kelu124/rp569/datasheet/README.md

# datasheet/

Each datasheet is kept as the original PDF plus a Markdown conversion (`markitdown <f>.pdf -o <f>.md`).
The Markdown is for grep/LLM reading. Tables can be garbled, so always confirm pin numbers in the PDF.

| File | Document | Source |
|---|---|---|
| `rp2350-datasheet` | RP2350 datasheet (RP-008373-DS-3) | datasheets.raspberrypi.com |
| `hardware-design-with-rp2350` | Hardware design with RP2350 (RP-008280-DS-2) | datasheets.raspberrypi.com |
| `CH569DS1` | CH569/CH565 datasheet V1.2 (pinout, HSPI, eMMC, USB3, registers) | copied from `project/phantomdrive/ref/` |
| `GSB343K33HR/` | Amphenol USB3 Micro-B receptacle (THT shell legs): drawing rev C, product spec PS-7428, STEP/IGES models (zipped) |
| `QingKeV3_Processor_Manual` | WCH QingKe V3 RISC-V core manual (CH569 core, debug) | copied from `project/phantomdrive/ref/` |
| `SD_Physical_Layer_Spec_v6.00` | SD Physical Layer Simplified Spec v6.00 | copied from `project/phantomdrive/ref/` |
