kelu124/rp569/firmware/rp2350/README.md

# RP2350B firmware

USB serial command line (also mirrored on the debug UART0, RP EXT header pins 2 TX / 3 RX, 115200 8N1).

```
rp569> version
rp569 RP2350B firmware 0.1.0 git 0727cb0 built Oct 24 2026 uid E6614103E7A1B22C
rp569> help
commands:
  help                     this list
  version                  firmware version, git hash and chip unique ID
  set <R|G|B> <0|1>        RGB LED colour on/off (also 'set rgb 101')
  led                      LED state
  btn                      user buttons
  adc                      VBUS3 and 3V3_CH voltages
  dfu                      reboot the RP2350 into its USB bootloader (BOOTSEL / UF2)
  reboot                   reboot the RP2350
  ch on                    CH569 power on (normal boot)
  ch off                   CH569 power off
  ch cycle                 CH569 power off, then normal boot
  ch boot                  power-cycle the CH569 into its USB bootloader (~10 s)
  ch reset                 pulse RST# (only with RESET_EN set in the CH569)
  ch status                CH569 power, fault flag, rails
  ch send <text>           send a line to the CH569 over the link UART (it echoes it back)
```

The commands are one table in `src/main.c` (`COMMANDS-BEGIN` / `COMMANDS-END`); `help` is generated from it. Every
entry needs a method in `python/rp569/rp2350.py` (pre-commit check, `tools/check_commands.py`).

**USB identity**: `2e8a:0009`, manufacturer "rp569", product "rp569 RP2350B", serial number = the chip unique ID
(the `uid` of `version`). The python library finds the port with these.

**Version**: `version.yaml` (major/minor by the user, patch bumped by the pre-commit hook), read by CMake into
`build/generated/fw_version.h` with the `git describe` hash.

Lines from the CH569 (link UART1, GPIO24 TX / GPIO25 RX, 115200) are printed as `CH> ...`.

## Build

```sh
./build.sh            # PICO_SDK_PATH defaults to ~/.pico-sdk/sdk/2.2.0 -> build/rp569_rp2350.uf2
```

Needs Pico SDK ≥ 2.0 (RP2350), `arm-none-eabi-gcc`, cmake, ninja. The board definition is
[`boards/rp569.h`](boards/rp569.h): RP2350B (`PICO_RP2350A 0`), 16 MB flash, UART0 on GPIO32/33, every rp569 pin
as `RP569_*`.

## CH569 control (specification.md D-004)

- The CH569 is **off** until GPIO29 (AP2171W EN, 100k pull-down) goes high; the firmware turns it on at start-up
  (`CH_POWER_ON_BOOT`).
- While it is off, the link UART pins and HSPI_D0 are inputs without pull-up (no back-powering).
- `ch boot`: GPIO8 (HSPI_D0 → CH569 PA5) driven low, power off, power on, released 200 ms later.
- Normal power-up: GPIO8 only gets the weak pull-up, so the CH BOOT jumper/button still force the bootloader.
- `ch reset` pulses GPIO28 (open-drain RST#); it only works once RESET_EN is set in the CH569 config bits.
- GPIO30 (FLG#) is polled: a power-switch fault is reported once.
