kelu124/rp569/docs/images/README.md

# Board images (v1.0)

Generated by `python3 hardware/gen/gen_renders.py` from `hardware/rp569-routed.kicad_pcb` (re-run after board changes).

| Top | Bottom |
|---|---|
| top | bottom |
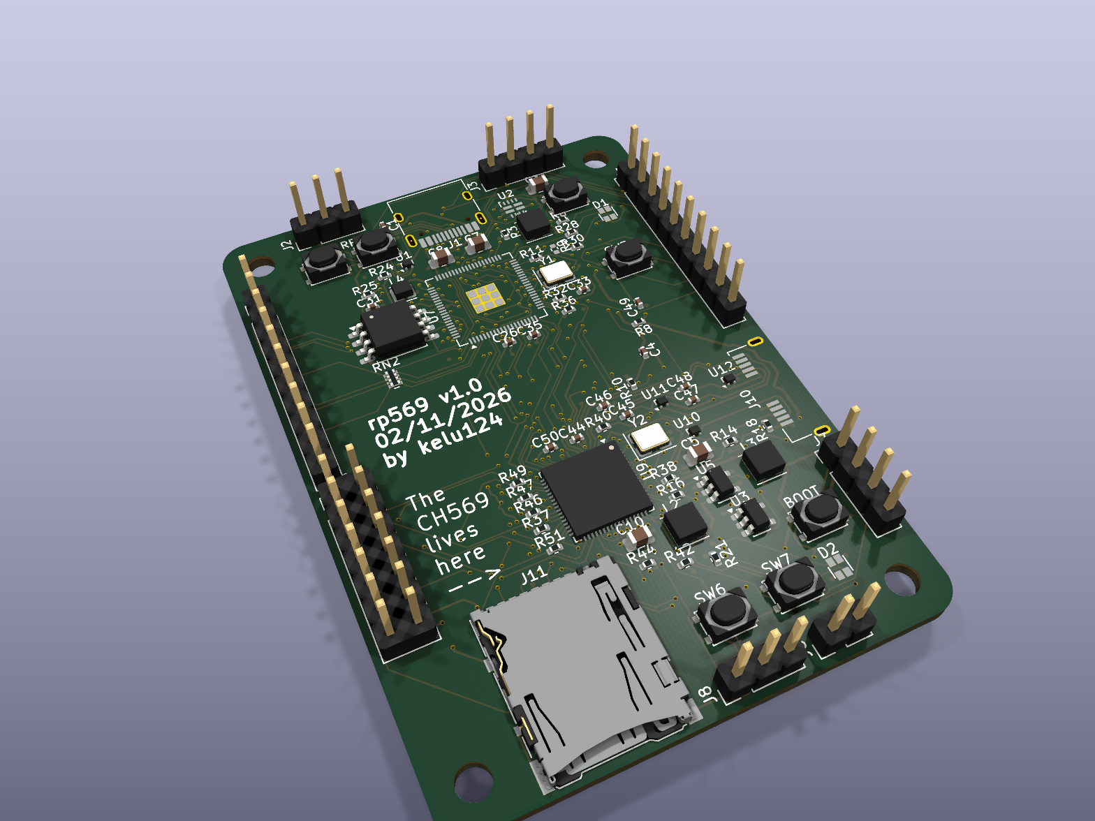
[picture p3: docs/images/rp569-v1.0-top-angled.png]
top angled
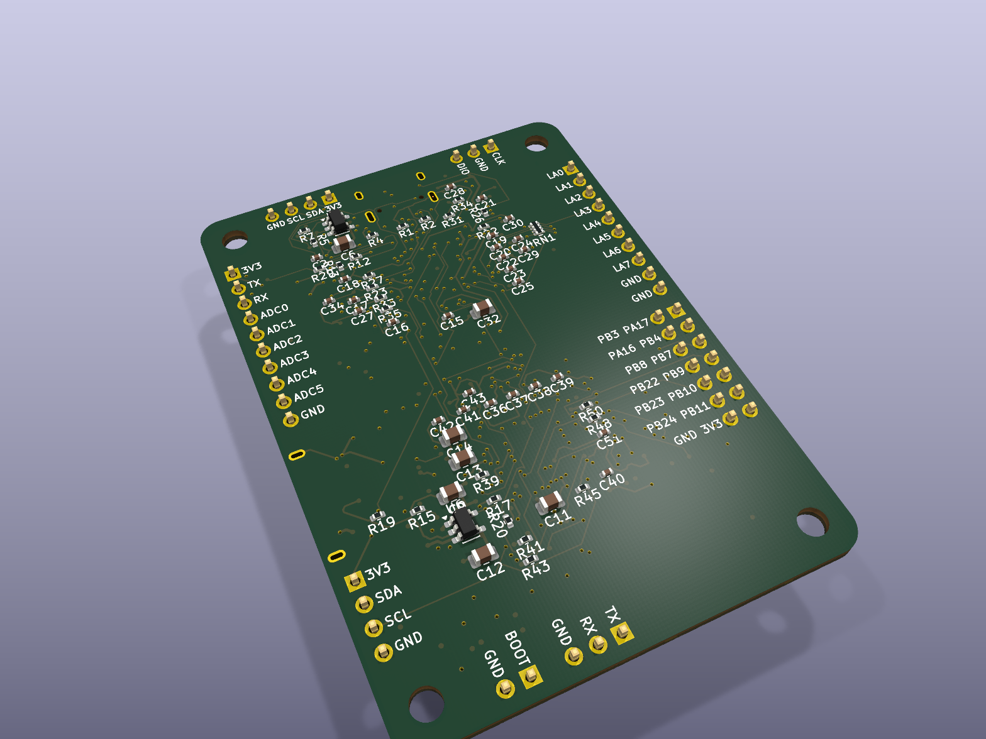
[picture p4: docs/images/rp569-v1.0-bottom-angled.png]
bottom angled
|  |  |

Layer plots (board area, bottom layers mirrored as seen from below), SVG + PNG:

| F.Cu | In1.Cu (GND plane) | In2.Cu | B.Cu |
|---|---|---|---|
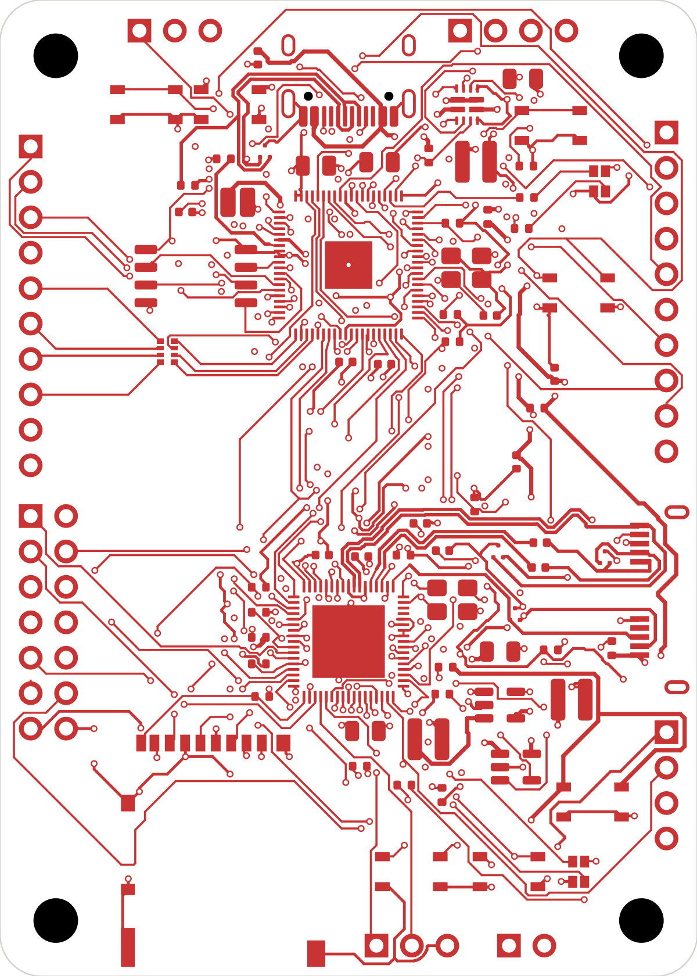
[picture p5: docs/images/rp569-v1.0-F_Cu.png]
F.Cu
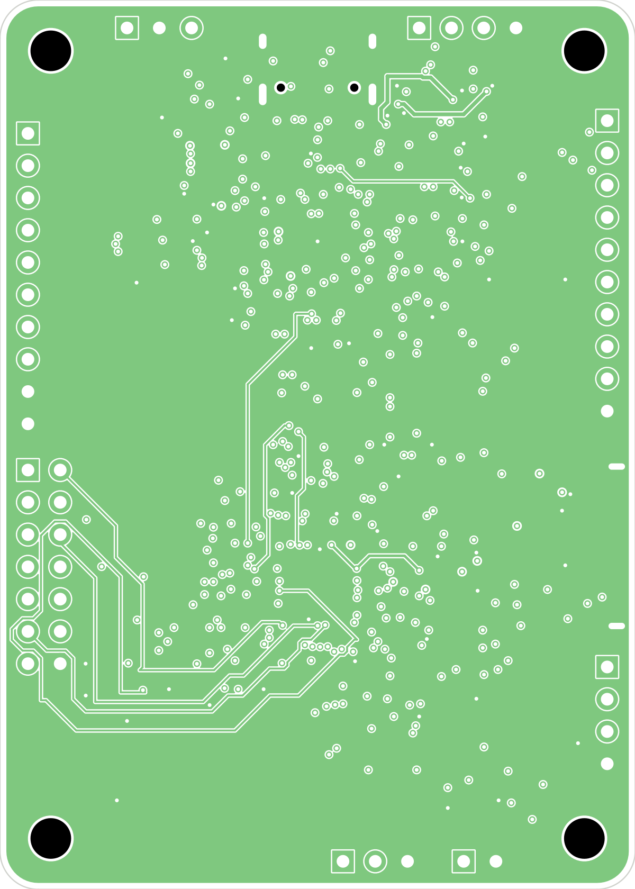
[picture p6: docs/images/rp569-v1.0-In1_Cu.png]
In1
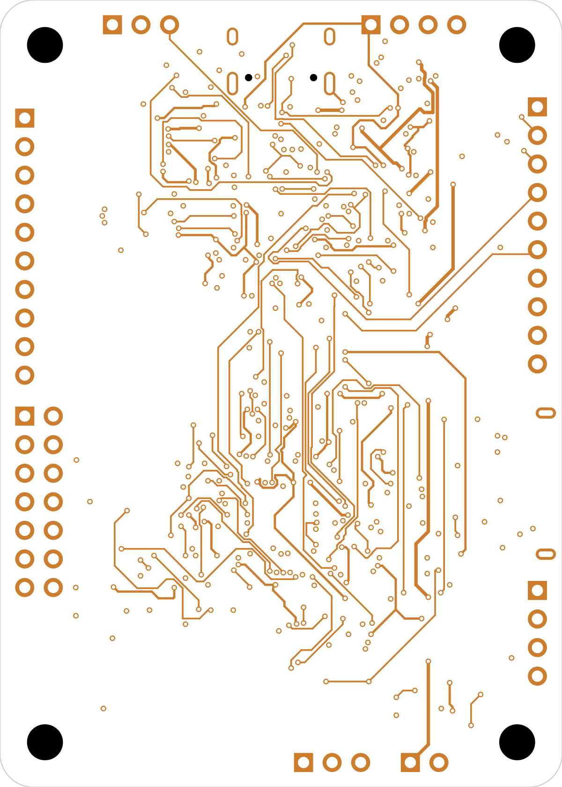
[picture p7: docs/images/rp569-v1.0-In2_Cu.png]
In2
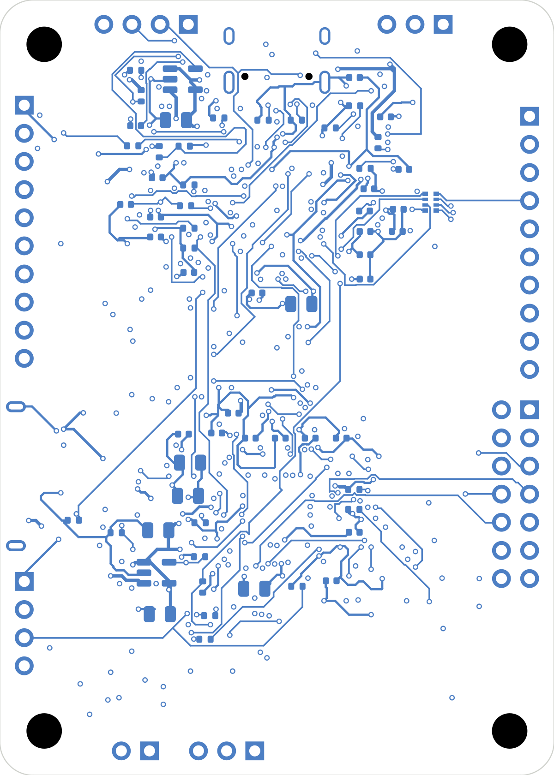
[picture p8: docs/images/rp569-v1.0-B_Cu.png]
B.Cu
|  |  |  |  |

Assembly views (silkscreen + fab): [top](rp569-v1.0-assembly-top.png), [bottom](rp569-v1.0-assembly-bottom.png).
