kelu124/rp569/datasheet/hardware-design-with-rp2350.md

Raspberry Pi

|  Hardware design with RP2350

Datasheet

Hardware design with
RP2350
Using RP2350 microcontrollers to
build boards and products

Raspberry Pi Ltd

Hardware design with RP2350

Colophon

©︎ 2022-2026 Raspberry Pi Ltd

This documentation is licensed under a Creative Commons Attribution-NoDerivatives 4.0 International (CC BY-ND).

Release

3

Build date

20/08/2026

Build version

06a7f75e58a1

Legal disclaimer notice

TECHNICAL AND RELIABILITY DATA FOR RASPBERRY PI PRODUCTS (INCLUDING DATASHEETS) AS MODIFIED FROM TIME TO

TIME (“RESOURCES”) ARE PROVIDED BY RASPBERRY PI LTD (“RPL”) “AS IS” AND ANY EXPRESS OR IMPLIED WARRANTIES,

INCLUDING,  BUT  NOT  LIMITED TO, THE  IMPLIED  WARRANTIES  OF  MERCHANTABILITY  AND  FITNESS  FOR  A  PARTICULAR

PURPOSE ARE DISCLAIMED. TO THE MAXIMUM EXTENT PERMITTED BY APPLICABLE LAW IN NO EVENT SHALL RPL BE LIABLE

FOR ANY DIRECT, INDIRECT, INCIDENTAL, SPECIAL, EXEMPLARY, OR CONSEQUENTIAL DAMAGES (INCLUDING, BUT NOT LIMITED

TO, PROCUREMENT OF SUBSTITUTE GOODS OR SERVICES; LOSS OF USE, DATA, OR PROFITS; OR BUSINESS INTERRUPTION)

HOWEVER CAUSED AND ON ANY THEORY OF LIABILITY, WHETHER IN CONTRACT, STRICT LIABILITY, OR TORT (INCLUDING

NEGLIGENCE OR OTHERWISE) ARISING IN ANY WAY OUT OF THE USE OF THE RESOURCES, EVEN IF ADVISED OF THE POSSIBILITY

OF SUCH DAMAGE.

RPL reserves the right to make any enhancements, improvements, corrections or any other modifications to the RESOURCES or

any products described in them at any time and without further notice.

The RESOURCES are intended for skilled users with suitable levels of design knowledge. Users are solely responsible for their

selection and use of the RESOURCES and any application of the products described in them. User agrees to indemnify and hold

RPL harmless against all liabilities, costs, damages or other losses arising out of their use of the RESOURCES.

RPL grants users permission to use the RESOURCES solely in conjunction with the Raspberry Pi products. All other use of the

RESOURCES is prohibited. No licence is granted to any other RPL or other third party intellectual property right.

HIGH RISK ACTIVITIES. Raspberry Pi products are not designed, manufactured or intended for use in hazardous environments

requiring fail safe performance, such as in the operation of nuclear facilities, aircraft navigation or communication systems, air

traffic control, weapons systems or safety-critical applications (including life support systems and other medical devices), in which

the failure of the products could lead directly to death, personal injury or severe physical or environmental damage (“High Risk

Activities”). RPL specifically disclaims any express or implied warranty of fitness for High Risk Activities and accepts no liability

for use or inclusions of Raspberry Pi products in High Risk Activities.

Raspberry Pi products are provided subject to RPL’s Standard Terms. RPL’s provision of the RESOURCES does not expand or

otherwise modify RPL’s Standard Terms including but not limited to the disclaimers and warranties expressed in them.

Colophon

1

Hardware design with RP2350

Table of Contents

1. Introduction . . . . . . . . . . . . . . . . . . . . . . . . . . . . . . . . . . . . . . . . . . . . . . . . . . . . . . . . . . . . . . . . . . . . . . . . . . . . . . . . . . . . . . . . . . . . . . . . . . . . . . . . . . . . . . . . . . . . . . 3

1.1. The Minimal Board . . . . . . . . . . . . . . . . . . . . . . . . . . . . . . . . . . . . . . . . . . . . . . . . . . . . . . . . . . . . . . . . . . . . . . . . . . . . . . . . . . . . . . . . . . . . . . . . . . . . . . . . 3

1.2. RP2040 vs RP235x series . . . . . . . . . . . . . . . . . . . . . . . . . . . . . . . . . . . . . . . . . . . . . . . . . . . . . . . . . . . . . . . . . . . . . . . . . . . . . . . . . . . . . . . . . . . . . . . . . 3

1.3. The Design . . . . . . . . . . . . . . . . . . . . . . . . . . . . . . . . . . . . . . . . . . . . . . . . . . . . . . . . . . . . . . . . . . . . . . . . . . . . . . . . . . . . . . . . . . . . . . . . . . . . . . . . . . . . . . . . 4

2. Power . . . . . . . . . . . . . . . . . . . . . . . . . . . . . . . . . . . . . . . . . . . . . . . . . . . . . . . . . . . . . . . . . . . . . . . . . . . . . . . . . . . . . . . . . . . . . . . . . . . . . . . . . . . . . . . . . . . . . . . . . . . . 5

2.1. New on-chip voltage regulator . . . . . . . . . . . . . . . . . . . . . . . . . . . . . . . . . . . . . . . . . . . . . . . . . . . . . . . . . . . . . . . . . . . . . . . . . . . . . . . . . . . . . . . . . . . . 5

2.2. Input supply . . . . . . . . . . . . . . . . . . . . . . . . . . . . . . . . . . . . . . . . . . . . . . . . . . . . . . . . . . . . . . . . . . . . . . . . . . . . . . . . . . . . . . . . . . . . . . . . . . . . . . . . . . . . . . . 7

2.2.1. Decoupling capacitors . . . . . . . . . . . . . . . . . . . . . . . . . . . . . . . . . . . . . . . . . . . . . . . . . . . . . . . . . . . . . . . . . . . . . . . . . . . . . . . . . . . . . . . . . . . . . 8

3. Flash Memory . . . . . . . . . . . . . . . . . . . . . . . . . . . . . . . . . . . . . . . . . . . . . . . . . . . . . . . . . . . . . . . . . . . . . . . . . . . . . . . . . . . . . . . . . . . . . . . . . . . . . . . . . . . . . . . . . . 10

3.1. Primary flash . . . . . . . . . . . . . . . . . . . . . . . . . . . . . . . . . . . . . . . . . . . . . . . . . . . . . . . . . . . . . . . . . . . . . . . . . . . . . . . . . . . . . . . . . . . . . . . . . . . . . . . . . . . . . 10

3.2. Secondary flash or PSRAM . . . . . . . . . . . . . . . . . . . . . . . . . . . . . . . . . . . . . . . . . . . . . . . . . . . . . . . . . . . . . . . . . . . . . . . . . . . . . . . . . . . . . . . . . . . . . . 11

3.3. Supported flash chips . . . . . . . . . . . . . . . . . . . . . . . . . . . . . . . . . . . . . . . . . . . . . . . . . . . . . . . . . . . . . . . . . . . . . . . . . . . . . . . . . . . . . . . . . . . . . . . . . . . . 11

4. Crystal Oscillator . . . . . . . . . . . . . . . . . . . . . . . . . . . . . . . . . . . . . . . . . . . . . . . . . . . . . . . . . . . . . . . . . . . . . . . . . . . . . . . . . . . . . . . . . . . . . . . . . . . . . . . . . . . . . . . 13

4.1. Recommended crystal . . . . . . . . . . . . . . . . . . . . . . . . . . . . . . . . . . . . . . . . . . . . . . . . . . . . . . . . . . . . . . . . . . . . . . . . . . . . . . . . . . . . . . . . . . . . . . . . . . . 14

5. IOs . . . . . . . . . . . . . . . . . . . . . . . . . . . . . . . . . . . . . . . . . . . . . . . . . . . . . . . . . . . . . . . . . . . . . . . . . . . . . . . . . . . . . . . . . . . . . . . . . . . . . . . . . . . . . . . . . . . . . . . . . . . . . . 15

5.1. USB . . . . . . . . . . . . . . . . . . . . . . . . . . . . . . . . . . . . . . . . . . . . . . . . . . . . . . . . . . . . . . . . . . . . . . . . . . . . . . . . . . . . . . . . . . . . . . . . . . . . . . . . . . . . . . . . . . . . . . 15

5.2. I/O headers . . . . . . . . . . . . . . . . . . . . . . . . . . . . . . . . . . . . . . . . . . . . . . . . . . . . . . . . . . . . . . . . . . . . . . . . . . . . . . . . . . . . . . . . . . . . . . . . . . . . . . . . . . . . . . 16

5.3. Debug connector . . . . . . . . . . . . . . . . . . . . . . . . . . . . . . . . . . . . . . . . . . . . . . . . . . . . . . . . . . . . . . . . . . . . . . . . . . . . . . . . . . . . . . . . . . . . . . . . . . . . . . . . . 17

5.4. Buttons . . . . . . . . . . . . . . . . . . . . . . . . . . . . . . . . . . . . . . . . . . . . . . . . . . . . . . . . . . . . . . . . . . . . . . . . . . . . . . . . . . . . . . . . . . . . . . . . . . . . . . . . . . . . . . . . . . . 18

Appendix A. Complete Schematic - RP2350A version . . . . . . . . . . . . . . . . . . . . . . . . . . . . . . . . . . . . . . . . . . . . . . . . . . . . . . . . . . . . . . . . . . . . . . . . . . . . 19

Appendix B. Complete Schematic - RP2350B version . . . . . . . . . . . . . . . . . . . . . . . . . . . . . . . . . . . . . . . . . . . . . . . . . . . . . . . . . . . . . . . . . . . . . . . . . . . . 21

Appendix C. Documentation Release History . . . . . . . . . . . . . . . . . . . . . . . . . . . . . . . . . . . . . . . . . . . . . . . . . . . . . . . . . . . . . . . . . . . . . . . . . . . . . . . . . . . . . 23

C.1. 24 August 2026 . . . . . . . . . . . . . . . . . . . . . . . . . . . . . . . . . . . . . . . . . . . . . . . . . . . . . . . . . . . . . . . . . . . . . . . . . . . . . . . . . . . . . . . . . . . . . . . . . . . . . . . . . . 23

C.2. 15 October 2024 . . . . . . . . . . . . . . . . . . . . . . . . . . . . . . . . . . . . . . . . . . . . . . . . . . . . . . . . . . . . . . . . . . . . . . . . . . . . . . . . . . . . . . . . . . . . . . . . . . . . . . . . . 23

C.3. 6 September 2024 . . . . . . . . . . . . . . . . . . . . . . . . . . . . . . . . . . . . . . . . . . . . . . . . . . . . . . . . . . . . . . . . . . . . . . . . . . . . . . . . . . . . . . . . . . . . . . . . . . . . . . . 23

C.4. 8 August 2024 . . . . . . . . . . . . . . . . . . . . . . . . . . . . . . . . . . . . . . . . . . . . . . . . . . . . . . . . . . . . . . . . . . . . . . . . . . . . . . . . . . . . . . . . . . . . . . . . . . . . . . . . . . . 23

Table of Contents

2

Hardware design with RP2350

1. Introduction

Figure 1.

KiCad 3D rendering of the RP2350A Minimal design example

When we first introduced the Raspberry Pi RP2040, we also released a ‘Minimal’ design example and accompanying guide Hardware

design with RP2040 which hopefully explained how the RP2040 could be used in a simple circuit board, and why the various

component choices were made. With the arrival of the RP235x series, it’s time to revisit the original RP2040 Minimal design, and

update it to account for the new features, and also for each of the package variants; the RP2350A with its QFN-60 package, and

the RP2350B which is a QFN-80. Again, these designs are in Kicad format, and are available to download ( RP2350A Minimal

KiCAD design (ZIP file) and RP2350B Minimal KiCAD design (ZIP file) ).

1.1. The Minimal Board

The original Minimal board was an attempt to provide a simple reference design, using the bare minimum of external components

required to run the RP2040 and still have all the IO exposed and accessible. This was essentially comprised of a power source (a

5 V to 3.3 V linear regulator), crystal oscillator, flash memory, and IO connections (a micro USB socket and GPIO headers).

The new RP235x series Minimal boards are largely the same, but with some changes necessary due to the new hardware. In

addition to this, and despite going somewhat against the minimal nature of the design, we added a couple of buttons for BOOTSEL

and run, together with a separate SWD header, which should mean a thoroughly less frustrating debug experience this time around.

Designs don’t strictly speaking need these buttons, the signals are still available on the headers, and they can be omitted if you

are particularly cost or space conscious.

1.2. RP2040 vs RP235x series

The most obvious change is in the packages.

Whereas the RP2040 is a 7x7 mm QFN-56, the RP235x series currently has four different members. There are two devices which

share the same QFN-60 package; the RP2350A which does not contain internal flash storage, and the RP2354A which does.

Similarly, the QFN-80 also comes in two flavours; the RP2354B with flash, and RP2350B without.

The QFN-60 devices and the original RP2040 share a common heritage. They each have 30 GPIOs, four of which are also connected

to the ADC, and are 7x7 mm in size. Despite this, the RP2350A is not a drop-in replacement for the RP2040, as the number of pins

on each is different.

By contrast, the QFN-80 chips now have 48 GPIOs, and eight of these are now ADC capable. Because of this, we now have two

Minimal boards; one for the 60 pin devices, and one for the 80.

Introduction

3

Hardware design with RP2350

These Minimal boards are primarily designed for the parts without internal flash (RP2350), however the designs can easily be

used with the internal flash devices (RP2354) by simply omitting the onboard flash memory, or even using it as a secondary flash

device (more on this later). There is little difference between the two boards, other than the fact the QFN-80 version has longer

rows of headers to accommodate the extra GPIO, and the board is therefore larger.

Aside from the package, the biggest board-level difference between the RP235x series and RP2040 are the power supplies. The

RP235x series has some new power pins, and a different internal regulator. The 100 mA linear regulator of the RP2040 has been

replaced with a 200mA switching regulator, and as such, it requires some very specific circuitry, and no little care taken with the

layout. It is highly recommended that you closely follow our layout and component selections; we’ve already gone through the

pain of having to make several iterations of the design, so hopefully you don’t have to.

Figure 2.

KiCad 3D rendering of the RP2350B Minimal design example

1.3. The Design

The intention of the Minimal design examples is to create a pair of simple boards using the RP235x series, which should be

cheaply and easily manufacturable, without using unnecessarily exotic PCB technologies.

The Minimal boards are therefore 2 layer designs, using components which should be commonly available, and all mounted on

the top side of the board.

While it would be nice to use large, easily hand-solderable components, the small pitch of the QFN chips (0.4 mm) means that

using some 0402 (1005 metric) passive components is unavoidable if all the GPIOs are to be used. While hand-soldering 0402

components isn’t too challenging with a decent soldering iron, it is very nearly impossible to solder the QFNs without specialist

equipment.

Over the next few sections, we explain what the additional circuitry is for, and hopefully how we came to make the choices we did.

We discuss two separate designs: one for each package size.

As far as is possible, all of the component references for the two boards are identical. References to U1, R1, and so on, are equally

relevant to both boards.

The obvious exception is when the component is only on one of the boards. In those cases, the component exists only be on the

QFN-80 design (for example, R13).

Introduction

4

Hardware design with RP2350

2. Power

The power supplies of the RP235x series and the RP2040 differ somewhat this time around, though in its simplest configuration,

it still requires two supplies, 3.3 V and 1.1 V.

The RP235x series are simultaneously more power hungry, as it’s higher performance, and also more frugal (when in a low power

state) than it’s predecessor, and so the linear regulator on the RP2040 has been upgraded with a switching regulator. This allows

us greater power efficiency at higher currents (up to 200 mA compared to the 100 mA previously).

2.1. New on-chip voltage regulator

Figure 3.

Schematic section showing the internal regulator circuit

The linear regulator of the RP2040 had two pins, a 3.3 V input, and a 1.1 V output to supply the DVDD on the chip. This time, the

regulator of the RP235x series has five pins, and requires some external componentry to make it work. While this seems a bit

of a backward step in terms of usability, the switching regulator has the advantage of being more power efficient at higher load

currents.

As the name suggests, the regulator rapidly switches on and off an internal transistor connecting the 3.3 V input voltage (VREG_VIN)

to the  VREG_LX pin, and with the help of an inductor (L1) and an output capacitor (C7), it can produce a DC output voltage which

has been stepped-down from the input. The VREG_FB pin monitors the output voltage, and adjusts the on/off ratio of the switching

cycle, to ensure that the required voltage is maintained. As large currents are switched from VREG_VIN to VREG_LX, a large capacitor

(C6) close to the input is required, so we don’t upset the 3.3 V supply too much. Speaking of these large switching currents, the

regulator also comes with its own ground return connection,  VREG_PGND. Similarly with  VREG_VIN and  VREG_LX, the layout of this

connection is critical, and while VREG_PGND must connect to the main GND, it must be done in such a way that all the large switching

currents return directly to the PGND pin, without disturbing the rest of the GND too much.

The last pin is VREG_AVDD, which supplies the analogue circuitry within the regulator, and this is very sensitive to noise.

Power

5

Hardware design with RP2350

Figure 4.

Schematic section showing the PCB layout of the regulator

The layout of the regulator on the minimal boards closely mirrors that of the Raspberry Pi Pico 2. A great deal of work has gone

into the design of this circuit, with many iterations of the PCB required in order to make it as good as we possibly can. You could

place these components in a variety of different ways and still get the regulator to ‘work’ (that is, produce an output voltage at

roughly the right level, well enough to execute code), but we’ve found that our regulator needs to be treated in exactly the right way

to keep it producing the correct output voltage under a range of load current conditions.

While performing our experiments on this, we were somewhat disappointed to be reminded that the inconvenient world of physics

cannot always be ignored. We, as engineers, largely try and do exactly this; simplifying components, ignoring (often) insignificant

physical properties, and instead focusing on the property that we’re interested in. For example, a simple resistor does not just

have a resistance, but also inductance, and so on.

In our case, we (re)discovered that inductors have a magnetic field associated with them, and importantly, radiates in a direction

depending on which way the coil is wound, and the direction of the flow of the current. We were also reminded that a ‘fully’ shielded

inductor doesn’t mean what you think it might. The magnetic field is attenuated to a large extent, but some does still escape. We

found that the regulator performance could be massively improved if the inductor is ‘the right way round’.

It turns out that the magnetic field emitting from a ‘wrong way round’ inductor interferes with the regulator output capacitor (C7),

which in turn upsets the control circuitry within RP2350. With the inductor in the proper orientation, and the precise layout and

component selections used here, then this problem goes away. There will undoubtedly be other layouts, components, and so on,

which could work with an inductor in any orientation, but they will most likely use a lot more PCB space in order to do so. We

Power

6

Hardware design with RP2350

have provided this recommended layout to save people the many engineering hours we have spent developing and refining this

compact and well-behaved solution. More to the point, we’re going so far as saying that if you choose not to use our example, then

you do so at your own risk. Much like we already do with RP2040 and the crystal circuit, where we insist (well, strongly suggest)

you use a particular part (we will do so again in the crystal section of this document).

The directionality of these small inductors is pretty much universally ignored, with the orientation of the coil winding impossible to

deduce, and also randomly distributed along a reel of components. Larger inductor case sizes can often be found to have polarity

markings on them, however we could find no suitable ones in the 0806 (2016 metric) case size we have chosen. To this end, we

have worked with Abracon to produce a 3.3 μH part with a dot to indicate polarity, and importantly, come on a reel with them

all aligned the same way. The AOTA-B201610S3R3-101-T are (or will very shortly) be made available to the general public from

distributors. As mentioned earlier, the VREG_AVDD supply is very sensitive to noise, and therefore needs to be filtered. We found that

as the  VREG_AVDD only draws around 200 μA, an RC filter of 33 Ω and 4.7 μF is adequate.

So, to recap, the components used will be:

• C6, C7, and C9 - 4.7μF (0402, 1005 metric)

• L1 - Abracon AOTA-B201610S3R3-101-T (0806, 2016 metric)

• R3 - 33Ω (0402, 1005 metric)

The  RP2350  datasheet  has  a  more  detailed  discussion  on  the  regulator  layout  recommendations,  please  see  the  External

Components and PCB layout requirements section in the RP2350 Datasheet .

2.2. Input supply

Figure 5.

Schematic section showing the power input

The input power connection for this design is via the 5 V VBUS pin of a Micro-USB connector (labelled J1 in Figure 5). This is a

common method of powering electronic devices, and it makes sense here, as RP2350 has USB functionality, which we will be

wiring to the data pins of this connector.

As we need only 3.3 V for this design (the 1.1 V supply comes from the internal), we need to lower the incoming 5 V USB supply,

in this case, using another, external voltage regulator, in this case a linear regulator (also known as the Low Drop Out regulator, or

LDO). Having previously extolled the virtues of using an efficient switching regulator, it could also be a wise choice to use one here

as well, but we opted for simplicity. Firstly, using an LDO is almost always easier. There’s no calculations required to figure out

what size inductor you should use, or how big are the output capacitors, and the layout is usually a lot more straightforward too.

Secondly, saving every last drop of power isn’t the aim here; if it was, we’d seriously consider using a switching regulator, and you

can find an example of doing so on the Raspberry Pi Pico 2. And thirdly, we can borrow the circuit previously used on the RP2040

version of the Minimal board. The NCP1117 (U2) chosen here has a fixed output of 3.3 V, is widely available, and can provide up

to 1 A of current, which will be plenty for most designs.

Power

7

Hardware design with RP2350

A look at the datasheet for the NCP1117 tells us that this device requires a 10 μF capacitor on the input, and another on the output

(C1 and C5).

2.2.1. Decoupling capacitors

Figure 6.

Schematic section showing the RP2350 power supply inputs, voltage regulator and decoupling capacitors

Another aspect of the power supply design are the decoupling capacitors required for RP2350. These provide two basic functions.

Firstly, they filter out power supply noise, and secondly, provide a local supply of charge that the circuits inside RP2350 can use at

short notice. This prevents the voltage level in the immediate vicinity from dropping too much when the current demand suddenly

increases.

Because, of this, it is important to place decoupling close to the power pins. Ordinarily, we recommend the use of a 100 nF

capacitor per power pin, however, we do deviate from this rule in a single instance.

Figure 7.

Section of layout showing RP2350 routing and decoupling

In order to be able to have enough space for all of the chip pins to be able to be routed out, away from the device, we have to

compromise with the amount of decoupling capacitors we can use. In this design, pins 53 and 54 of RP2350A (pins 68 and 69 of

RP2350B) share a single capacitor (C12 in Figure 7 and Figure 6), as there is not a lot of room on that side of the device, and the

components and layout of the regulator take precedence.

Power

8

Hardware design with RP2350

This lack of space could be somewhat overcome if we used more complex/expensive technology, such as smaller components, or

a four layer PCB with components on both the top and bottom sides. This is a design trade-off; we have decreased the complexity

and cost, at the expense of having less decoupling capacitance, and capacitors which are slightly further away from the chip than

is optimal (this increases the inductance). This could have the effect of limiting the maximum speed the design could operate at,

as the voltage supply could get too noisy and drop below the minimum allowed voltage; but for most applications, this trade-off

should be acceptable.

Power

9

Hardware design with RP2350

3. Flash Memory

3.1. Primary flash

Figure 8.

Schematic section showing the primary flash memory and USB_BOOT circuitry

In order to be able to store program code which RP2350 can boot and run from, we need to use a flash memory, specifically, a quad

SPI flash memory. The device chosen here is an W25Q128JVS device (U3 in the Figure 8), which is a 128 Mbit chip (16 MB). This

is the largest memory size that RP2350 can support. If your particular application doesn’t need as much storage, then a smaller,

cheaper memory could be used instead.

As this databus can be quite high frequency and is regularly in use, the QSPI pins of RP2350 should be wired directly to the flash,

using short connections to maintain the signal integrity, and to also reduce crosstalk in surrounding circuits. Crosstalk is where

signals on one circuit net can induce unwanted voltages on a neighbouring circuit, potentially causing errors to occur.

The  QSPI_SS signal is a special case. It is connected to the flash directly, but it also has two resistors (well, four, but I’ll come on

to that later) connected to it. The first (R1) is a pull-up to the 3.3 V supply. The flash memory requires the chip-select input to be

at the same voltage as its own 3.3 V supply pin as the device is powered up, otherwise, it might not function correctly. When the

RP2350 is powered up, its  QSPI_SS pin will automatically default to a pull-up, but there is a short period of time during switch-on

where the state of the  QSPI_SS pin cannot be guaranteed. The addition of a pull-up resistor ensures that this requirement will be

satisfied. R1 is marked as DNF (Do Not Fit) on the schematic, as we have found that with this particular flash device, the external

pull-up is unnecessary. However, if a different flash is used, it may become important to be able to insert a 10 kΩ resistor here,

so it has been included just in case. It is important to include resistor R6, as this allows the QSPI_SS pin to safely over-drive the

applied pull-down when the RP2350 starts booting.

The second resistor (R6) is a 1 kΩ resistor, connected to a push button (SW1) labelled ‘USB_BOOT’. This is because the  QSPI_SS

pin is used as a ‘boot strap’; RP2350 checks the value of this I/O during the boot sequence, and if it is found to be a logic 0, then

RP2350 reverts to the BOOTSEL mode, where RP2350 presents itself as a USB mass storage device, and code can be copied

Flash Memory

10

Hardware design with RP2350

directly to it. If we simply press the button, we pull QSPI_SS pin to ground, and if the device is then subsequently reset (for example,

by toggling the RUN pin), RP2350 will restart in BOOTSEL mode instead of attempting to run the contents of the flash. These

resistors, R1 and R6 (R9 and R10 also), should be placed close to the flash chip, so we avoid additional lengths of copper tracks

which could affect the signal.

All of the above specifically applies to the RP2350, which has no internal flash. Of course, the RP2354 devices have internal

2 MB flash memories, so the external U3 memory is not required, so U3 can safely be removed from the schematic, or simply left

unpopulated. In either of these cases, we would still want to keep the USB_BOOT switch connected to QSPI_SS, so that we can still

enter USB boot mode.

3.2. Secondary flash or PSRAM

The RP235x series now supports a second memory device using the same QSPI pins, with a GPIO providing the additional chip

select. So, if we are using an RP2354 (which has internal flash), then we could use U3 as a secondary flash, or even replace it with

a PSRAM device. In order to do this, we need to disconnect  QSPI_SS from U3, and instead connect it to a suitable GPIO instead.

The nearest GPIO capable of being a chip select (XIP_CS1n) is  GPIO0, so by removing the 0 Ω from R10, and fitting it to R9, we

can now access U3 in addition to the on-chip flash. In order to fully take advantage of this feature, where we have two external

memory devices so that the flash-less RP2350 parts can benefit, the larger of the two Minimal boards, for the RP2350B, includes

an optional footprint (U4) for an additional memory chip.

Figure 9.

Schematic section showing the optional secondary memory device

To be able to use this device, it will obviously have to be populated, as well as R11 (0 Ω), and R13 (10 KΩ). The addition of R11

connects  GPIO0 (the XIP_CS1n signal) to the chip select of the second memory. The pull-up on the chip select pin is definitely

needed this time, as the default state of  GPIO0 is to be pulled low at power-up, which would cause our flash device to fail. C22

would also be needed to provide local power supply decoupling for U4.

3.3. Supported flash chips

The initial flash probe sequence, used by the bootrom to extract the second stage from flash, uses an  03h serial read command,

with 24-bit addressing, and a serial clock of approximately 1 MHz. It repeatedly cycles through the four combinations of clock

polarity and clock phase, looking for a valid second stage CRC32 checksum.

As the second stage is then free to configure execute-in-place using the same  03h serial read command, RP2350 can perform

cached flash execute-in-place with any chip supporting  03h serial read with 24-bit addressing, which includes most 25-series

flash devices. The Pico SDK provides an example second stage for CPOL=0 CPHA=0, in https://github.com/raspberrypi/pico-sdk/

blob/master/src/rp2350/boot_stage2/boot2_generic_03h.S . To support flash programming using the routines in the bootrom,

the device must also respond to the following commands:

Flash Memory

11

Hardware design with RP2350

• 02h 256-byte page program

• 05h status register read

• 06h set write enable latch

• 20h 4 kB sector erase

RP2350 also supports a wide variety of dual-SPI and QSPI access modes. For example, https://github.com/raspberrypi/pico-sdk/

blob/master/src/rp2350/boot_stage2/boot2_w25q080.S configures a Winbond W25Q-series device for quad-IO continuous read

mode, where RP2350 sends quad-IO addresses (without a command prefix) and the flash responds with quad-IO data.

Some caution is needed with flash XIP modes where the flash device stops responding to standard serial commands, like the

Winbond continuous read mode mentioned above. This can cause issues when RP2350 is reset, but the flash device is not power-

cycled, because the flash will then not respond to the bootrom’s flash probe sequence. Before issuing the  03h serial read, the

bootrom always issues the following fixed sequence, which is a best-effort sequence for discontinuing XIP on a range of flash

devices:

• CSn=1,  IO[3:0]=4'b0000 (via pull downs to avoid contention), issue ×32 clocks

• CSn=0,  IO[3:0]=4'b1111 (via pull ups to avoid contention), issue ×32 clocks

• CSn=1

• CSn=0,  MOSI=1'b1 (driven low-Z, all other I/Os Hi-Z), issue ×16 clocks

If your chosen device does not respond to this sequence when in its continuous read mode, then it must be kept in a state where

each transfer is prefixed by a serial command, otherwise RP2350 will not be able to recover following an internal reset.

For more details on the QSPI , please see the QSPI Memory Interface (QMI) section in the RP2350 Datasheet .

Flash Memory

12

Hardware design with RP2350

4. Crystal Oscillator

Figure 10.

Schematic section showing the crystal oscillator and load capacitors

Strictly speaking, RP2350 does not actually require an external clock source, as it has its own internal oscillator. However, as

the frequency of this internal oscillator is not well defined or controlled, varying from chip to chip, as well as with different

supply voltages and temperatures, it is recommended to use a stable external frequency source. Applications which rely on exact

frequencies are not possible without an external frequency source, USB being a prime example.

Providing an external frequency source can be done in one of two ways: either by providing a clock source with a CMOS output

(square wave of IOVDD voltage) into the XIN pin, or by using a 12 MHz crystal connected between XIN and XOUT. Using a crystal

is the preferred option here, as they are both relatively cheap and very accurate.

The chosen crystal for this design is an ABM8-272-T3 (X1 in Figure 10). This is the same 12 MHz crystal used on the Raspberry Pi

Pico and Raspberry Pi Pico 2. We highly recommend using this crystal along with the accompanying circuitry to ensure that the

clock starts quickly under all conditions without damaging the crystal itself. The crystal has a 30 ppm frequency tolerance, which

should be good enough for most applications. Along with a frequency tolerance of +/-30 ppm, it has a maximum ESR of 50 Ω, and

a load capacitance of 10 pF, both of which had a bearing on the choice of accompanying components.

For a crystal to oscillate at the desired frequency, the manufacturer specifies the load capacitance that it needs for it to do so, and

in this case, it is 10 pF. This load capacitance is achieved by placing two capacitors of equal value, one on each side of the crystal

to ground (C3 and C4). From the crystal’s point of view, these capacitors are connected in series between its two terminals. Basic

circuit theory tells us that they combine to give a capacitance of (C3*C4)/(C3+C4), and as C3=C4, then it is simply C3/2. In this

example, we’ve used 15 pF capacitors, so the series combination is 7.5 pF. In addition to this intentional load capacitance, we

must also add a value for the unintentional extra capacitance, or parasitic capacitance, that we get from the PCB tracks and the

XIN and XOUT pins of RP2350. We’ll assume a value of 3 pF for this, and as this capacitance is in parallel to C3 and C4, we simply

add this to give us a total load capacitance of 10.5pF, which is close enough to the target of 10 pF. As you can see, the parasitic

capacitance of the PCB traces are a factor, and we therefore need to keep them small so we don’t upset the crystal and stop it

oscillating as intended. Try and keep the layout as short as possible.

The second consideration is the maximum ESR (equivalent series resistance) of the crystal. We’ve opted for a device with a

maximum of 50 Ω, as we’ve found that this, along with a 1 kΩ series resistor (R2), is a good value to prevent the crystal being over-

driven and being damaged when using an IOVDD level of 3.3 V. However, if IOVDD is less than 3.3 V, then the drive current of the

XIN/XOUT pins is reduced, and you will find that the amplitude of the crystal is lower, or may not even oscillate at all. In this case, a

smaller value of the series resistor will need to be used. Any deviation from the crystal circuit shown here, or with an IOVDD level

other than 3.3 V, will require extensive testing to ensure that the crystal oscillates under all conditions, and starts-up sufficiently

quickly as not to cause problems with your application.

Crystal Oscillator

13

Hardware design with RP2350

4.1. Recommended crystal

For original designs using RP2350 we recommend using the Abracon ABM8-272-T3. For example, in addition to the minimal design

example, see the Pico 2 board schematic in Appendix B of the Raspberry Pi Pico 2 Datasheet .

For the best performance and stability across typical operating temperature ranges, use the Abracon ABM8-272-T3. You can source

the ABM8-272-T3 directly from Abracon or from an authorised reseller. Pico 2 has been specifically tuned for the ABM8-272-T3,

which has the following specifications:

Even if you use a crystal with similar specifications, you will need to test the circuit over a range of temperatures to ensure stability.

The crystal oscillator is powered from the IOVDD voltage. As a result, the Abracon crystal and that particular damping resistor are

tuned for 3.3 V operation. If you use a different IO voltage, you will need to re-tune.

Any changes to crystal parameters risk instability across any components connected to the crystal circuit.

If you can’t source the recommended crystal directly from Abracon or a reseller, contact applications@raspberrypi.com.

Crystal Oscillator

14

Hardware design with RP2350

5. IOs

5.1. USB

Figure 11.

Schematic section showing the USB pins of RP2350 and series termination

The RP2350 provides two pins to be used for full speed (FS) or low speed (LS) USB, either as a host or device, depending on the

software used. As we’ve already discussed, RP2350 can also boot as a USB mass storage device, so wiring up these pins to the

USB connector (J1 in Figure 5) makes sense. The USB_DP and USB_DM pins on RP2350 do not require any additional pull-ups

or pull-downs (required to indicate speed, FS or LS, or whether it is a host or device), as these are built in to the I/Os. However,

these I/Os do require 27 Ω series termination resistors (R7 and R8 in Figure 11), placed close to the chip, in order to meet the

USB impedance specification.

Even though RP2350 is limited to full speed data rate (12 Mbps), we should try and makes sure that the characteristic impedance

of the transmission lines (the copper tracks connecting the chip to the connector) are close to the USB specification of 90 Ω

(measured differentially). On a 1 mm thick board such as this, if we use 0.8 mm wide tracks on USB_DP and USB_DM, with a gap

of 0.15 mm between them, we should get a differential characteristic impedance of around 90 Ω. This is to ensure that the signals

can travel along these transmission lines as cleanly as possible, minimising voltage reflections which can reduce the integrity of

the signal. In order for these transmission lines to work properly, we need to make sure that directly below these lines is a ground.

A solid, uninterrupted area of ground copper, stretching the entire length of the track. On this design, almost the entirety of the

bottom copper layer is devoted to ground, and particular care was taken to ensure that the USB tracks pass over nothing but

ground. If a PCB thicker than 1 mm is chosen for your build, then we have two options. We could re-engineer the USB transmission

lines to compensate for the greater distance between the track and ground underneath (which could be a physical impossibility),

or we could ignore it, and hope for the best. USB FS can be quite forgiving, but your mileage may vary. It is likely to work in many

applications, but it’s probably not going to be compliant to the USB standard.

IOs

15

Hardware design with RP2350

5.2. I/O headers

Figure 12.

Schematic section showing the 2.54 mm I/O headers of the QFN-60 version

In addition to the USB connector already mentioned, there are a pair of dual row 2.54 mm headers (J2 and J3 in Figure 12), one on

each side of the board, to which the rest of the I/O have been connected. There are 30 GPIO on the RP2350A, whereas there are

48 GPIO on the RP2350B, so the headers on this version of the Minimal board are larger to allow for the extra pins (see Figure 13).

As this is a general purpose design, with no particular application in mind, the I/O have been made available to be connected

as the user wishes. The inner row of pins on each header are the I/Os, and the outer row are all connected to ground. It is good

practice to include many grounds on I/O connectors. This helps to maintain a low impedance ground, and also to provide plenty

of potential return paths for currents travelling to and from the I/O connections. This is important to minimise electro-magnetic

interference which can be caused by the return currents of quickly switching signals taking long, looping paths to complete the

circuit.

Both headers are on the same 2.54 mm grid, which makes connecting this board to other things, such as breadboards, easier. You

might want to consider fitting only a single row header instead of the dual row header, dispensing with the outer row of ground

connections, to make it more convenient to fit to a breadboard.

IOs

16

Hardware design with RP2350

Figure 13.

Schematic section showing the 2.54 mm I/O headers of the QFN-80 version

5.3. Debug connector

Figure 14.

Schematic section showing the optional JST connector for SWD debug

For on-chip debugging, you may wish to connect to the SWD interface of the RP2350. The two pins,  SWD and  SWCLK, are available

on the 2.54 mm header, J3, to allow the debug probe of your choice to be easily connected. In addition to this, we included an

optional JST header (J4), which allows an easy connection to Raspberry Pi Debug Probe. You don’t need to use this, the 2.54 mm

IOs

17

Hardware design with RP2350

headers will suffice if you do intend to debug software, but we find it more convenient to do so. We chose a horizontal connector,

mostly because we like the look of it, even if it’s not on the edge of the board, but vertical ones are available, albeit with a slightly

different footprint.

5.4. Buttons

The RP2350 Minimal design contains two buttons; the RP2040 version had no buttons. One is for USB boot selection as we’ve

previously discussed, but the second is a ‘reset’ button, hooked up to the  RUN pin. Neither of these are strictly necessary (though

the BOOTSEL button would have to be replaced with a header or similar if USB boot mode was required), and can be removed if

space or cost is a concern, but they certainly make using the RP2350 a far more pleasant experience.

IOs

18

Hardware design with RP2350

Appendix A. Complete Schematic -

RP2350A version

Complete Schematic - RP2350A version

19

Hardware design with RP2350

Figure 15.

Full schematic of the Minimal Design for RP2350A

Complete Schematic - RP2350A version

20

1234567812345678ABCDEFABCDEF2026-07-03RP2350A QFN-60 Minimal Design ExampleTITLEDATEDRAWNREFSHEETwww.raspberrypi.com©︎ Raspberry Pi 2026Mike Stimson1/1REVA3S1SIZERPI-RP2350A-MINIMAL_R4L13.3u2.1AR61k63mW1%M1005C74.7uM10056.3VX5R20%GNDVCC1D-2D+3ID4GND5SH6SH7SH8SH9SH10SH11J110103594-0001LFRIGHT ANGLEP11P22P33SH14SH25J4SM03B-SRSS-TB(LF)(SN)C64.7uM10056.3VX5R20%+3V3GNDGND1OUT2IN3OUT4U2NCP1117ST33T3GGNDPCB/PWB REVISION:MANUFACTURER:MANUF. PN:CIRCUITS/PANEL:DESCRIPTION:<- PCB/PWB rev thisschematic is forR4XXXXXXXXXXXXR10063mW+50mRM1005GND+3V3C510uM201216VX5R10%VARIANTREF:DESCR:VARIANT1RPI-RP2350A-MINIMALRP2350A QFN-60 Minimal Design ExampleR41k63mW1%M1005R9063mW+50mRM1005+3V3GNDSCHEMATIC/BOM REVISION:BOM is autogenerated from schematic,therefore schematic rev. == BOM rev.Keep Titleblock rev. in sync with above.Reset to 1 when creating new R num.S1VBUSGND+1V1GNDC110uM201216VX5R10%GNDC11100nM100525VX7R10%C10100nM100525VX7R10%+3V3+3V3C2100nM100525VX7R10%GNDR110k63mW1%M1005R21k63mW1%M1005C8100nM100525VX7R10%1234SW2434133025816GND1234SW1434133025816+1V1+3V3+1V1~{CS}1DO_IO12~{WP}_IO23GND4DI_IO05CLK6~{HOLD}_IO37VCC8U3W25Q128JVSIQGNDC12100nM100525VX7R10%MH1NPTH FD2.75mm SM3.15mm KO6mm+3V3+3V3+1V1+3V3GNDC415pM100550VC0G5%GND1234X112MHzC315pM100550VC0G5%MH2NPTH FD2.75mm SM3.15mm KO6mmMH3NPTH FD2.75mm SM3.15mm KO6mmMH4NPTH FD2.75mm SM3.15mm KO6mmIOVDD1GPIO02GPIO13GPIO24GPIO35DVDD6GPIO47GPIO58GPIO69GPIO710IOVDD11GPIO812GPIO913GPIO1014GPIO1115GPIO1216GPIO1317GPIO1418GPIO1519IOVDD20XIN21XOUT22DVDD23SWCLK24SWDIO25RUN26GPIO1627GPIO1728GPIO1829IOVDD30GPIO1931GPIO2032GPIO2133GPIO2234GPIO2335GPIO2436GPIO2537IOVDD38DVDD39GPIO26_ADC040GPIO27_ADC141GPIO28_ADC242GPIO29_ADC343ADC_AVDD44IOVDD45VREG_AVDD46VREG_PGND47VREG_LX48VREG_VIN49VREG_FB50USB_DM51USB_DP52USB_OTP_VDD53QSPI_IOVDD54QSPI_SD355QSPI_SCLK56QSPI_SD057QSPI_SD258QSPI_SD159QSPI_~{SS}60GND61U1RP2350AGNDGNDC1910uM201216VX5R10%R82763mW1%M1005GND+3V3C94.7uM10056.3VX5R20%+3V3+3V3+1V1GND123456789101112131415161718192021222324252627282930313233343536J3TSW-118-07-L-DC16100nM100525VX7R10%C17100nM100525VX7R10%C18100nM100525VX7R10%GND+3V3GNDGNDGND123456789101112131415161718192021222324252627282930313233343536J2TSW-118-07-L-DC13100nM100525VX7R10%C15100nM100525VX7R10%C14100nM100525VX7R10%+3V3R33363mW1%M1005R72763mW1%M1005GPIO9GPIO11GPIO24GPIO12GPIO23GPIO13GPIO15VREG_AVDDXINGPIO14GPIO16GPIO12XOUTSWCLKSWDRUNGPIO18GPIO17XINGPIO3GPIO0USB_D+USB_D-FLASH_SSGPIO19VREG_LXGPIO7GPIO6QSPI_SD0QSPI_SCLKGPIO5GPIO8GPIO10GPIO9GPIO2GPIO1GPIO0GPIO4QSPI_SSQSPI_SD2QSPI_SD1GPIO0XOUTGPIO20GPIO26_ADC0GPIO3GPIO7GPIO6GPIO4GPIO13GPIO2GPIO14SWCLKSWDQSPI_SSGPIO27_ADC1GPIO17GPIO18GPIO16GPIO19GPIO1RUNSWCLKSWDQSPI_SD0QSPI_SD3QSPI_SCLKQSPI_SD1GPIO22GPIO23GPIO28_ADC2GPIO5GPIO29_ADC3GPIO21GPIO26_ADC0GPIO25GPIO24GPIO21GPIO20GPIO22QSPI_SD2GPIO25GPIO15~{USB_BOOT}GPIO29_ADC3GPIO28_ADC2QSPI_SD3GPIO11USB_D-GPIO8GPIO10USB_D+RUNGPIO27_ADC1PowerMake sure R7 and R8 are close to RP2350FlashBOOTSEL ButtonJST Debug ConnectorIf using RP2354 (internal flash), remove R10.R9 can be fit to use U3 as secondary memory.RUN ButtonIOs12MHz CrystalNote: S1 schematic revision indicates that this is the 1st revision of the schematic/BOM associated with the R4 PCB.R4-S1 therefore uniquely identifies the fully built PCB Assembly (PCBA).This is a change from the previous revision numbering to align with the internal Raspberry Pi product revisioning schemeGNDJ110103594-0001LFVCC1D-2D+3ID4GND5SH6SH7SH8SH9SH10SH11U2NCP1117ST33T3GGND1OUT2IN3OUT4GNDC110uM201216VX5R10%GNDR110k63mW1%M1005U3W25Q128JVSIQ~{CS}1DO_IO12~{WP}_IO23GND4DI_IO05CLK6~{HOLD}_IO37VCC8R61k63mW1%M1005R10063mW+50mRM1005C510uM201216VX5R10%C2100nM100525VX7R10%GNDGNDC415pM100550VC0G5%X112MHz1234C315pM100550VC0G5%GNDC1910uM201216VX5R10%GND+3V3C94.7uM10056.3VX5R20%+3V3+1V1GNDJ3TSW-118-07-L-D123456789101112131415161718192021222324252627282930313233343536GNDJ2TSW-118-07-L-D123456789101112131415161718192021222324252627282930313233343536
Hardware design with RP2350

Appendix B. Complete Schematic -

RP2350B version

Complete Schematic - RP2350B version

21

Hardware design with RP2350

Figure 16.

Full schematic of the Minimal Design for RP2350B

Complete Schematic - RP2350B version

22

1234567812345678ABCDEFABCDEF2026-07-03RP2350B QFN80 Minimal Design ExampleTITLEDATEDRAWNREFSHEETwww.raspberrypi.com©︎ Raspberry Pi 2026Mike Stimson1/1REVA3S1SIZERPI-2350B-MINIMAL_R4MH4NPTH FD2.75mm SM3.15mm KO6mmGND1OUT2IN3OUT4U2NCP1117ST33T3GGNDC110uM201216VX5R10%GND+3V3+3V3+3V3C510uM201216VX5R10%GND+1V1VCC1D-2D+3ID4GND5SH6SH7SH8SH9SH10SH11J110103594-0001LF+1V1C11100nM100525VX7R10%+1V1+3V3+3V3R110k63mW1%M1005C14100nM100525VX7R10%C74.7uM10056.3VX5R20%+3V3VBUSGND+3V3R1310k63mW1%M1005GND+3V3C17100nM100525VX7R10%C2100nM100525VX7R10%~{CS}1DO_IO12~{WP}_IO23GND4DI_IO05CLK6~{HOLD}_IO37VCC8U3W25Q128JVSIQGNDC21100nM100525VX7R10%C20100nM100525VX7R10%GND1234SW1434133025816C18100nM100525VX7R10%C10100nM100525VX7R10%C315pM100550VC0G5%+3V3GNDGNDC94.7uM10056.3VX5R20%1234X112MHzGNDL13.3u2.1AR11063mW+50mRM1005C22100nM100525VX7R10%GNDGND~{CS}1DO_IO12~{WP}_IO23GND4DI_IO05CLK6~{HOLD}_IO37VCC8U4W25Q128JVSIQR21k63mW1%M1005C415pM100550VC0G5%R72763mW1%M1005+3V3GNDGNDC8100nM100525VX7R10%C15100nM100525VX7R10%R82763mW1%M1005R9063mW+50mRM1005MH3NPTH FD2.75mm SM3.15mm KO6mmMH1NPTH FD2.75mm SM3.15mm KO6mmC16100nM100525VX7R10%R61k63mW1%M1005R10063mW+50mRM1005C1910uM201216VX5R10%+3V3GNDMH2NPTH FD2.75mm SM3.15mm KO6mmR33363mW1%M1005+3V3+1V1+3V3+3V3+3V3C12100nM100525VX7R10%C13100nM100525VX7R10%C64.7uM10056.3VX5R20%GNDGND+1V1+3V3GPIO41GPIO52GPIO63GPIO74IOVDD5GPIO86GPIO97GPIO108GPIO119DVDD10GPIO1211GPIO1312GPIO1413GPIO1514IOVDD15GPIO1616GPIO1717GPIO1818GPIO1919GPIO2020GPIO2121GPIO2222GPIO2323IOVDD24GPIO2425GPIO2526GPIO2627GPIO2728IOVDD29XIN30XOUT31DVDD32SWCLK33SWDIO34RUN35GPIO2836GPIO2937GPIO3038GPIO3139GPIO3240IOVDD41GPIO3342GPIO3443GPIO3544GPIO3645GPIO3746GPIO3847GPIO3948GPIO40_ADC049IOVDD50DVDD51GPIO41_ADC152GPIO42_ADC253GPIO43_ADC354GPIO44_ADC455GPIO45_ADC556GPIO46_ADC657GPIO47_ADC758ADC_AVDD59IOVDD60VREG_AVDD61VREG_PGND62VREG_LX63VREG_VIN64VREG_FB65USB_DM66USB_DP67USB_OTP_VDD68QSPI_IOVDD69QSPI_SD370QSPI_SCLK71QSPI_SD072QSPI_SD273QSPI_SD174QSPI_~{SS}75IOVDD76GPIO077GPIO178GPIO279GPIO380GND81U1RP2350B+3V312345678910111213141516171819202122232425262728293031323334353637383940414243444546474849505152J2TSW-126-07-L-DGNDSCHEMATIC/BOM REVISION:BOM is autogenerated from schematic,therefore schematic rev. == BOM rev.Keep Titleblock rev. in sync with above.Reset to 1 when creating new R num.S1R41k63mW1%M1005GND1234SW2434133025816VARIANTREF:DESCR:VARIANT1RPI-RP2350B-MINIMALRP2350B QFN-80 Minimal Design ExamplePCB/PWB REVISION:MANUFACTURER:MANUF. PN:CIRCUITS/PANEL:DESCRIPTION:<- PCB/PWB rev thisschematic is forR4XXXXXXXXXXXXGND12345678910111213141516171819202122232425262728293031323334353637383940414243444546474849505152J3TSW-126-07-L-DGNDRIGHT ANGLEP11P22P33SH14SH25J4SM03B-SRSS-TB(LF)(SN)GPIO7GPIO6GPIO4QSPI_SD1QSPI_SD3QSPI_SD2GPIO37QSPI_SD2GPIO0QSPI_SSUSB_D+USB_D-GPIO13GPIO16GPIO14GPIO15GPIO3GPIO2GPIO1QSPI_SD1QSPI_SD3XOUTQSPI_SD2GPIO0QSPI_SD1QSPI_SD0QSPI_SSXINQSPI_SCLKQSPI_SD3GPIO47_ADC7GPIO41_ADC1GPIO43_ADC3GPIO42_ADC2GPIO40_ADC0GPIO39GPIO33GPIO35GPIO34GPIO36GPIO38GPIO45_ADC5GPIO44_ADC4GPIO46_ADC6GPIO32GPIO31GPIO30XINGPIO47_ADC7GPIO27GPIO26RUNGPIO29GPIO28GPIO25GPIO24RUNGPIO8QSPI_SD0USB_D-USB_D+VREG_AVDDGPIO10GPIO9GPIO21GPIO23GPIO22SWCLKSWDXOUTGPIO11GPIO20FLASH2_SSGPIO8GPIO7GPIO6GPIO16GPIO23GPIO5QSPI_SCLKGPIO21GPIO20GPIO22GPIO3GPIO1GPIO0GPIO4GPIO2SWDRUNGPIO28GPIO37GPIO29GPIO30SWDGPIO0GPIO18GPIO17GPIO19VREG_LXGPIO12QSPI_SCLKQSPI_SD0GPIO33FLASH_SSGPIO39GPIO38GPIO40_ADC0GPIO44_ADC4GPIO43_ADC3GPIO46_ADC6GPIO45_ADC5GPIO42_ADC2GPIO41_ADC1GPIO35GPIO36GPIO34GPIO24SWCLK~{USB_BOOT}SWCLKGPIO25GPIO27GPIO26GPIO5GPIO11GPIO10GPIO9GPIO19GPIO18GPIO31GPIO32GPIO12GPIO13GPIO14GPIO15GPIO17BOOTSEL Button12MHz CrystalSecondary Flash/PSRAMPowerJST Debug ConnectorMake sure R7 and R8 are close to RP2350If using RP2354 (internal flash), remove R10.R9 can be fit to use U3 as secondary memory.IOsOptional Secondary flash or PSRAM (U4), using the second chip select (XIP_SS_N[1]) on GPIO0.N.B. Pull-up R13 will be required as GPIOs default to pull-downs at power-up.Primary FlashNote: S1 schematic revision indicates that this is the 1st revision of the schematic/BOM associated with the R4 PCB.R4-S1 therefore uniquely identifies the fully built PCB Assembly (PCBA).This is a change from the previous revision numbering to align with the internal Raspberry Pi product revisioning schemeRUN ButtonC1910uM201216VX5R10%+3V3GND+3V3+1V1GNDC94.7uM10056.3VX5R20%U2NCP1117ST33T3GGND1OUT2IN3OUT4C110uM201216VX5R10%C510uM201216VX5R10%GNDGNDC22100nM100525VX7R10%GNDGNDU4W25Q128JVSIQ~{CS}1DO_IO12~{WP}_IO23GND4DI_IO05CLK6~{HOLD}_IO37VCC8R61k63mW1%M1005R10063mW+50mRM1005U3W25Q128JVSIQ~{CS}1DO_IO12~{WP}_IO23GND4DI_IO05CLK6~{HOLD}_IO37VCC8GNDR110k63mW1%M1005R1310k63mW1%M1005GNDJ110103594-0001LFVCC1D-2D+3ID4GND5SH6SH7SH8SH9SH10SH11C2100nM100525VX7R10%GNDC415pM100550VC0G5%C315pM100550VC0G5%X112MHz1234J2TSW-126-07-L-D12345678910111213141516171819202122232425262728293031323334353637383940414243444546474849505152GNDJ3TSW-126-07-L-D12345678910111213141516171819202122232425262728293031323334353637383940414243444546474849505152GND
Hardware design with RP2350

Appendix C. Documentation Release

History

C.1. 24 August 2026

• Converted to the new PDF toolchain

• Updated diagrams to the R4-S1 versions of the minimal boards.

C.2. 15 October 2024

• General updates

• Added link to recommended inductor.

• Revised some language to better match the writing style guide.

• Fixed some minor typos.

C.3. 6 September 2024

• Updated the button discussion to refer to the correct number of buttons.

C.4. 8 August 2024

• Initial release.

Documentation Release History

23

Raspberry Pi

Raspberry Pi is a trademark of Raspberry Pi Ltd

Raspberry Pi Ltd
