kelu124/rp569/datasheet/GSB343K33HR/ps-7428.md

Amphenol®
| | | | Amphenol Taiwan Corporation | | | | | Sheet | 1 | of | 14  |
| --- | --- | --- | --- | --- | --- | --- | --- | --- | --- | --- | --- |
| | | | | | | | | PS-7428  | | Rev. E | |
PRODUCT  SPECIFICATION

| Title: | | USB3.0 Connector Product Specification | | | | | | | | | |
| --- | --- | --- | --- | --- | --- | --- | --- | --- | --- | --- | --- |
| Part Number:  | | GSB34 / GSB35 series | | | | | | | | | |

Micro Family, Receptacle, SMT, PCB mount
Description:

| | | | | Revisions Control | | | | | | | |
| ----- | --- | --- | --- | --- | --- | --- | --- | --- | --- | --- | --- |
| Rev.  | ECN Number  | | | Originator | | | Approval  | | | Issue Date | |
| A | | Initial Release  | | Sondra Sang | | | Hank Hsu  | | | 12. 02. 2009  | |
| B | | NE-10032 | | Sondra Sang | | | Hank Hsu  | | | 03. 08. 2010  | |
| C | | NE-10123 | | Sondra Sang | | | Hank Hsu  | | | 08. 06. 2010  | |
| D | | NE-11061 | | Sondra Sang | | | Hank Hsu  | | | 04. 22. 2011  | |
| E | | NE-11105 | | Sondra Sang | | | Hank Hsu  | | | 07. 25. 2011  | |
| | | | | | | | | | | | |

| | | Product Specification Origination | | | | | | | | | |
| --- | --- | --- | --- | --- | --- | --- | --- | --- | --- | --- | --- |

| Originator:  | | Date:  | Checked by:  | | | Date:  | | Approved by:  | | Date:  | |
| --- | --- | --- | --- | --- | --- | --- | --- | --- | --- | --- | --- |
| | | | | | | | | | | | |

This  document  is  the  property  of  Amphenol  Corporation  and  is  delivered  on  the  express  condition  that  it  is  not  to  be
disclosed,  reproduced  or  used,  in  whole  or  in  part,  for  manufacture  or  sale  by  anyone  other  than  Amphenol  Corporation
without  its  prior  consent,  and  that  no  right  is  granted  to  disclose  or  to  use  any  information  in  this  document.
©
 Amphenol Corporation 1992, 2011.  All international rights are reserved.
Amphenol®  is a trademark of Amphenol Corporation.

Amphenol®
| | | Amphenol Taiwan Corporation | | Sheet  | 2  of  | 14  |
| --- | --- | --- | --- | --- | --- | --- |
| | | | | PS-7428  | Rev. E | |
| PRODUCT  SPECIFICATION | | | | | | |

1.  Scope
  This document defines the detailed requirements for the Amphenol USB3.0 Series Micro
type connector to insure functionality and reliability.

| | | | | | | |
| --- | --- | --- | --- | --- | --- | --- |
2.  Applicable document
  2.1  EIA-364 Standard  Test methods for electrical connectors
  2.2  UL-STD-94  Tests for flammability of plastic materials for parts in devices
and appliances.
  2.3  USB3.0 Standard  Universal Serial Bus 3.0 Specification, Revision 1.0
| | | | | | | |
| --- | --- | --- | --- | --- | --- | --- |
3.  Requirement
| 3.1  | Design and construction  | | | | | |
| --- | --- | --- | --- | --- | --- | --- |
    Product shall be of the design, construction and physical dimensions specified
on the applicable product drawing.
| | | | | | | |
| --- | --- | --- | --- | --- | --- | --- |
| 3.2  | Material and finish  | | | | | |
| | 3.2.1 | Housing | | | | |
| | | •  High temperature thermoplastic, UL94V-0  | | | | |

| | | •  Color: Black | | | | |
| ----- | --- | --- | --- | --- | --- | --- |
| | 3.2.2  | Contact | | | | |
| | | •  Copper Alloy | | | | |
| ) | | •  Contact area: Selective Gold plating  | | | | |
| | | Solder area: Gold flash plating | | | | |
•

| | | •  Under-plating: Nickel overall  | | | | |
| --- | --- | --- | --- | --- | --- | --- |
| | 3.2.3  | Shell | | | | |
| | | •  Stainless steel | | | | |
      •  Solder area: Gold flash or Nickel under-plated overall
| | Rating  | | | | | |
| --- | --- | --- | --- | --- | --- | --- |
) 3.3
| | | •  Voltage rating: 30 VAC | | | | |
| ----- | --- | --- | --- | --- | --- | --- |
| ) | | Operating temperature: -40°C~ 85°C  | | | | |
•

| | | •  Storage temperature: -40°C~ 85°C | | | | |
| ----- | --- | --- | --- | --- | --- | --- |
| ) | | •  Ambient humidity: 85% R.H. maximum  | | | | |
| | | | | | | |

This  document  is  the  property  of  Amphenol  Corporation  and  is  delivered  on  the  express  condition  that  it  is  not  to  be  disclosed
reproduced  or  used,  in  whole  or  in  part,  for  manufacture  or  sale  by  anyone  other  than  Amphenol  Corporation  without  its  prior  consent,
and  that  no  right  is  granted  to  disclose  or  to  use  any  information  in  this  document.

Amphenol®
| | Amphenol Taiwan Corporation | | | | Sheet  3  | of | 14  |
| --- | --- | --- | --- | --- | --- | --- | --- |
| | | | | PS-7428 | | Rev. E | |
| PRODUCT  SPECIFICATION | | | | | | | |

4.  Performance and testing
| 4.1  Test requirements and procedures summary  | | | | | | | |
| --- | --- | --- | --- | --- | --- | --- | --- |
| Test | Test procedure  | | Condition of  | | Test criteria  | | |
test specimens
Visual &  EIA-364-18                                 Must meet the minimum
Dimensional  Visual, dimensional and  requirements specified
| inspection  | functional inspection.  | | | | by product drawing.  | | |
| --- | --- | --- | --- | --- | --- | --- | --- |
Electrical:
Low level contact  EIA-364-23b                               Mated   Initial:
resistance  Current: 100 mA maximum          30 Milliohm maximum  for
| | Voltage: 20 mV maximum  | | | | VBUS and GND  | | |
| --- | --- | --- | --- | --- | --- | --- | --- |
contacts(Pin 1 & Pin 5)
50 milliohms maximum
for all other contacts
After test: ∆R=10
milliohms maximum

Insulation  EIA-364-21                                   Mated   100 Megohm minimum
| resistance  | Apply a voltage between | | | | | | |
| --- | --- | --- | --- | --- | --- | --- | --- |
| | adjacent terminals. | | | | | | |
Voltage: 500 VDC
Dielectric  EIA-364-20                                   Mated   No breakdown
withstanding  Apply a voltage between  Current leakage < 0.5 mA
| voltage  | adjacent terminals. | | | | | | |
| --- | --- | --- | --- | --- | --- | --- | --- |
| | Voltage: 100 VAC | | | | | | |
Duration: 1 minute
| Contact | EIA-364-30 | | | | 2pF maximum per | | |
| --- | --- | --- | --- | --- | --- | --- | --- |
| capacitance  | Test between adjacent contact,  | | | | contact. | | |
| | unmated connector at 1KHz. | | | | D+/D- contacts only  | | |

| Propagation delay  | EIA-364-103 | | Mated  | | 200ps rise time. | | |
| --- | --- | --- | --- | --- | --- | --- | --- |
| | The purpose of the test is to | | | | D+/D- lines only.  | | |
| | verify the end-to-end | | | | | | |
| | propagation of the D+/D- lines  | | | | | | |
of the cable assembly
16ns maximum for cable
assembly attached with one or
two Micro connectors and 26ns
maximum for a cable assembly
attached with no Micro
connector.
Propagation delay  EIA-364-103  Mated  Test condition: 200ps rise
| intra-pair skew  | The test ensures that the signal  | | | | time. | | |
| --- | --- | --- | --- | --- | --- | --- | --- |
| | on both the D+ and D- lines of | | | | D+/D- lines:.100ps  | | |
| | cable assembly arrive at the | | | | maximum. | | |
receiver at the same time.

This  document  is  the  property  of  Amphenol  Corporation  and  is  delivered  on  the  express  condition  that  it  is  not  to  be  disclosed
reproduced  or  used,  in  whole  or  in  part,  for  manufacture  or  sale  by  anyone  other  than  Amphenol  Corporation  without  its  prior  consent,
and  that  no  right  is  granted  to  disclose  or  to  use  any  information  in  this  document.

Amphenol®
| | Amphenol Taiwan Corporation | | | Sheet | 4  of  | 14  |
| --- | --- | --- | --- | --- | --- | --- |
| | | | | PS-7428 | Rev. E | |
| PRODUCT  SPECIFICATION | | | | | | |

| D+/D- pair  | EIA-634-101  | | Mated  | -0.67dB max. @12 MHz  | | |
| --- | --- | --- | --- | --- | --- | --- |
attenuation  This test ensure the D+/D- pair  -0.95dB max. @24 MHz
| | of a cable assembly can | | | -1.35dB max. @48 MHz  | | |
| --- | --- | --- | --- | --- | --- | --- |
| | provide adequate signal | | | -1.90dB max. @96 MHz  | | |
| | strength to the receiver in order  | | | -3.20dB max. @200MHz  | | |
| | to maintain a low error rate. | | | -5.80dB max. @400MHz  | | |
Contact current  EIA-364-70                              Mated   ∆T=30℃ maximum
| rating  | Measure the temperature rise  | | | | | |
| --- | --- | --- | --- | --- | --- | --- |
at the rated current.
Ambient temperature: 25℃
1.8A for VBUS & GND(Pin 1 &
Pin 5)
0.25A for all other contacts
Super Speed Electrical Requirements:
Mated connection  It should be measured with a  Mated   90Ω±15Ω  (85Ω~~105Ω)
| impedance  | TDR in a differential mold  | | | | | |
| --- | --- | --- | --- | --- | --- | --- |
| | using a 50ps(20-80%)rise | | | | | |
time.
Differential  EIA-364-101  Mated  The differential insertion
insertion  The measured differential   loss, SDD12, measures
loss of SS pairs  insertion loss of a mated cable the differential signal
| | assembly must not exceed the | | | energy transmitted | | |
| --- | --- | --- | --- | --- | --- | --- |
| | differential insertion loss limit.  | | | through the mated cable  | | |
assembly Figure 5.1.1
show the differential
insertion loss limit. which
is normalized with
90-Ωdifferential
impedance and defined
by the following vertices:
(100MHz,-1.5dB),
(1.25GHz,-5.0dB),
(2.5GHz-7.5dB),and
(7.5GHz,-25dB).
| Differential  | EIA-364-90  | | Mated  | The differential crosstalk  | | |
| --- | --- | --- | --- | --- | --- | --- |
near-end crosstalk  The differential crosstalk  measure the unwanted
| between Super  | measures the unwanted  | | | coupling between | | |
| --- | --- | --- | --- | --- | --- | --- |
Speed Pairs  coupling between differential  differential pairs. Since
pairs. Since the Tx pair is right  the Tx pair is right next to
| | next to the Rx pair for super  | | | the Rx pair for Super  | | |
| --- | --- | --- | --- | --- | --- | --- |
| | speed. | | | Speed, only the | | |
differential near-end
crosstalk (DDNEXT) is
specified, as shown in
Figure 5.1.2
referencing to a 90-Ω
differential impedance,
The mated cable

This  document  is  the  property  of  Amphenol  Corporation  and  is  delivered  on  the  express  condition  that  it  is  not  to  be  disclosed
reproduced  or  used,  in  whole  or  in  part,  for  manufacture  or  sale  by  anyone  other  than  Amphenol  Corporation  without  its  prior  consent,
and  that  no  right  is  granted  to  disclose  or  to  use  any  information  in  this  document.

Amphenol®
Amphenol Taiwan Corporation
Sheet 5 of 14
PRODUCT SPECIFICATION
PS-7428 Rev. E
assembly meets the
DDNEXT requirement if
its DDENXT does not
exceed the limit
shown in Figure 5.1.2;
the vertices that defines
the DDNEXT limits are:
(100MHz,-32dB),
(2.5GHz,-32dB),
(3GHz;-23dB) and
(7.5GHz.-23dB)
Differential EIA-364-90 Mated The differential near-end
crosstalk between The differential near-end and far-end crosstalk
D+/D- (USB2.0) and far-end crosstalk between the USB2.0
and Super Speed between the D+/D- pairs pairs (D+/D-) and the
Pairs (USB3.0) and the SuperSpeed pairs. USB3.0 pairs (SSTX+/
SSTX-or SSRX+/ SSRX-)
shall be
managed not exceed the
limits shown in Figure
5.1.3; the vertices
that defines the DNETX
and DDFEXT limits are:
(100MHz,-12dB),(2.5GH
z,-21dB),(3.0GHz,-15dB)
and (7.5GHz,-15dB). The
reference differential
impedance shall de 90Ω
Differential-to- This is a differential mode to Mated Since the common mode
common-mode common mode conversion current is directly
conversion requirement for SS signal pairs responsible for EMI,
limiting the differential -to-
common- mode
conversion. SCD12. will
limit EMI generation within
the connector and cable
assembly. Figure 5.1.4
illustrates the SCD12
requirement; a mated
cable assembly passes
the
SCD12 requirement if its
SCD12 is less than or
equal to -20dB across the
frequency range shown in
Figure 5.1.4
-20dB max Up to 7.5GHz
Mechanical:
This document is the property of Amphenol Corporation and is delivered on the express condition that it is not to be disclosed
reproduced or used, in whole or in part, for manufacture or sale by anyone other than Amphenol Corporation without its prior consent,
and that no right is granted to disclose or to use any information in this document.

Amphenol®
| | Amphenol Taiwan Corporation | | | Sheet  6  | of  14 |
| --- | --- | --- | --- | --- | --- |
| | | | PS-7428 | | Rev. E |
| PRODUCT  SPECIFICATION | | | | | |

Insertion force  EIA-364-13                                       35 N maximum
| | Rate: 12.5 mm/minute  | | | | |
| --- | --- | --- | --- | --- | --- |

Extraction force  EIA-364-13                                       Initial: 10N min.~25N
| | Rate: 12.5 mm/minute  | | | max.  | |
| --- | --- | --- | --- | ----- | --- |
After test: 8N min.~ 25N
max.

Durability  EIA-364-09                                     No evidence of physical
(preconditioning)  (perform 5 unplug/plug cycles if  damage
the application requires up to
25 over the life of the connector
or socket; 20 cycles if the
application requires 26-200; or,
50 cycles if the application
requires 201 or greater)
Reseating  Manually unplug/plug the      No evidence of physical
| | connector or socket.  Perform 3  | | | damage | |
| --- | --- | --- | --- | --- | --- |
such cycles.
Durability  EIA-364-09                                       No evidence of physical
| | Cycle rate: 500 maximum per  | | | damage | |
| --- | --- | --- | --- | --- | --- |
| | hour | | | - Insertion force (35N  | |
| | Number of cycles: 10,000 | | | max.) | |
| | minimum | | | - Extraction force (8N  | |
min.)

Peel strength  Pulled up from the PCB in the  Mated  No visible physical
| | vertical direction.  | | | damage shall be noticed | |
| --- | --- | --- | --- | --- | --- |
| | load: 150 N minimum  | | | to a soldered receptacle. | |
4-Axes continuity  Plug shall be supplied in a  Mated  No discontinuities > 1
| test  | cable assembly with a | | | microsecond duration in  | |
| ----- | --- | --- | --- | --- | --- |
| | representative overmold. | | | any of the four | |
| | Receptacle shall be mounted | | | orientations | |
| | on a 2-layer PCB between 0.8 | | | | |
| | and 1.0 mm thickness, | | | | |
| | The PCB shall be clamped on | | | | |
| | either side of the receptacle no  | | | | |
further than 5 mm away from
the solder tails.
load: pull of 8 N perpendicular
to connection at 0, 90, 180 and
270 degrees
Duration: 10 seconds at each
axis

This  document  is  the  property  of  Amphenol  Corporation  and  is  delivered  on  the  express  condition  that  it  is  not  to  be  disclosed
reproduced  or  used,  in  whole  or  in  part,  for  manufacture  or  sale  by  anyone  other  than  Amphenol  Corporation  without  its  prior  consent,
and  that  no  right  is  granted  to  disclose  or  to  use  any  information  in  this  document.

Amphenol®
| | Amphenol Taiwan Corporation | | | Sheet  7  | of  14 |
| --- | --- | --- | --- | --- | --- |
| | | | PS-7428 | | Rev. E |
| PRODUCT  SPECIFICATION | | | | | |

Wrenching strength  The test shall be performed  Mated  No plug or receptacle
| | using virgin parts. | | | damage shall occur when  | |
| --- | --- | --- | --- | --- | --- |
| | Perpendicular forces are | | | a force of 0-25 N is | |
| | applied to a plug when inserted | | | applied. | |
| | at a distance of 15 mm from the | | | The plug may be | |
| | edge of the receptacle. These | | | damaged, but only in | |
| | forces shall be applied in all | | | suck a way that the | |
| | four directions (left, right, up,  | | | receptacle does not | |
| | down). | | | sustain damage when a | |
| | | | | force of 25-50 N is | |
applied.

Mechanical Shock  EIA-364-28, Test condition H       Mated   No evidence of physical
| | 3 shocks in each direction shall  | | | damage | |
| --- | --- | --- | --- | --- | --- |
| | be applied along the 3 mutually | | | No discontinuities > 1  | |
| | perpendicular axes of the test | | | microsecond | |
specimen(18 shocks).
Shock pulse: Half-sine
Peak acceleration: 294m/s2,
30g's
Normal duration: 11ms
Electrical load: 100 milliamp
maximum
Environmental:
Temperature life  EIA-364-17, Test condition 4,  Mated   No evidence of physical
| (preconditioning)  | Method A | | | damage | |
| --- | --- | --- | --- | --- | --- |
Temperature: 105℃
Duration: 72 hours
Temperature life  EIA-364-17, Test condition 4,  Mated   No evidence of physical
| | Method A | | | damage | |
| --- | --- | --- | --- | --- | --- |
| | Temperature: 105℃ | | | | |
| | Duration: 120 hours | | | | |
Vibration  EIA-364-28, Test condition VII,  Mated   No evidence of physical
| | Test  letter D | | | damage | |
| --- | --- | --- | --- | --- | --- |
| | 15 minutes in each of 3 | | | No discontinuities > 1  | |
| | mutually perpendicular | | | microsecond | |
| | directions. | | | | |
| | Overall rms: 5.35 g | | | | |
Electrical load: 100 milliamp
maximum
Cyclic temp and  EIA-364-31, Test condition A,  Mated   No evidence of physical
humidity  Method III                                   damage
| | Number of cycles: 24 cycles  | | | | |
| --- | --- | --- | --- | --- | --- |
| | Duration: 168 hours | | | | |

This  document  is  the  property  of  Amphenol  Corporation  and  is  delivered  on  the  express  condition  that  it  is  not  to  be  disclosed
reproduced  or  used,  in  whole  or  in  part,  for  manufacture  or  sale  by  anyone  other  than  Amphenol  Corporation  without  its  prior  consent,
and  that  no  right  is  granted  to  disclose  or  to  use  any  information  in  this  document.

Amphenol®
| | Amphenol Taiwan Corporation | | | Sheet  8  | of  14 |
| --- | --- | --- | --- | --- | --- |
| | | | PS-7428 | | Rev. E |
| PRODUCT  SPECIFICATION | | | | | |

Thermal shock  EIA-364-32, test condition I         Mated   No evidence of physical
| | Number of cycles: 10 | | | damage | |
| --- | --- | --- | --- | --- | --- |
| | <1 cycle> | | | | |

Step1: -55 +0/-3 ℃ 30 minutes
Step2: +25 +10/-5℃ 5 minutes
maximum
Step3: +85 +3/-0℃ 30 minutes
Step4: +25 +10/-5℃ 5 minutes
maximum
Thermal cycling  EIA-364-110                                 Mated   No evidence of physical
| | Cycle the connector or socket  | | | damage | |
| --- | --- | --- | --- | --- | --- |
between 15 °C ± 3°C. and 85
°C ± 3 °C, as measured on the
part. Ramps should be a
minimum of 2 °C per minute,
and dwell times should insure
that the contacts reach the
temperature extremes (a
minimum of 5 minutes).
Humidity is not controlled.
Number of cycles: 500 cycles
Thermal  EIA-364-32                                   Mated   No evidence of physical
| disturbance  | Cycle the connector or socket  | | | damage | |
| --- | --- | --- | --- | --- | --- |
between 15 °C ± 3 °C and 85
°C ± 3 °C, as measured on the
part. Ramps should be a
minimum of 2 °C per minute,
and dwell times should insure
that the contacts reach the
temperature extremes (a
minimum of 5 minutes).
Humidity is not controlled.
Number of cycles: 10 cycles
Mixed flowing gas  EIA-364-65, class IIA                       No evidence of physical
| (MFG)  | RH: 70±2% | | | damage | |
| --- | --- | --- | --- | --- | --- |
| | Temperature: 30±1℃ | | | | |

Cl 2  : 10±3 ppb
NO : 200±50 ppb
2
H S : 10±5 ppb
2
SO2 : 100±20 ppb
Duration: 7 days
Solderability  EIA-364-52                                   Unmated  95% of immersed area
| | The surfaces to be tested shall  | | | must show no volids or  | |
| --- | --- | --- | --- | --- | --- |
| | be immersed in the flux for a | | | pin holes. | |
| | minimum of 5 to 10 seconds. | | | | |
| | Any droplets of flux that may | | | | |
form shall be removed by

This  document  is  the  property  of  Amphenol  Corporation  and  is  delivered  on  the  express  condition  that  it  is  not  to  be  disclosed
reproduced  or  used,  in  whole  or  in  part,  for  manufacture  or  sale  by  anyone  other  than  Amphenol  Corporation  without  its  prior  consent,
and  that  no  right  is  granted  to  disclose  or  to  use  any  information  in  this  document.

Amphenol®
Amphenol Taiwan Corporation
Sheet 9 of 14
PRODUCT SPECIFICATION
PS-7428 Rev. E
blotting, taking care not to
remove the flux coating from
the surfaces to be tested. The
test samples being tested shall
be allowed to dry in ambient air
for 5 to 20 seconds prior to
solder immersion.
The test sample termination
shall be immersed to a depth
equal to a length from its tip to a
location normally not less than
0.5 mm below the connector
seating plane.
Temperature: 255±5℃
Duration: 5 seconds
Resistance to EIA-364-29 Unmated No evidence of physical
soldering heat Average ramp rate: 1~4℃ per damage
(Infrared reflow) second
Temperature(board surface):
250 +10℃/-0℃
Duration:30~35 seconds
This document is the property of Amphenol Corporation and is delivered on the express condition that it is not to be disclosed
reproduced or used, in whole or in part, for manufacture or sale by anyone other than Amphenol Corporation without its prior consent,
and that no right is granted to disclose or to use any information in this document.

Amphenol®
Amphenol Taiwan Corporation
Sheet 10 of 14
PRODUCT SPECIFICATION
PS-7428 Rev. E
4.2 Typical contact resistance measurement
This document is the property of Amphenol Corporation and is delivered on the express condition that it is not to be disclosed
reproduced or used, in whole or in part, for manufacture or sale by anyone other than Amphenol Corporation without its prior consent,
and that no right is granted to disclose or to use any information in this document.

Amphenol®
Amphenol Taiwan Corporation
Sheet 11 of 14
PRODUCT SPECIFICATION
PS-7428 Rev. E
4.3 4-Axes continuity test
This document is the property of Amphenol Corporation and is delivered on the express condition that it is not to be disclosed
reproduced or used, in whole or in part, for manufacture or sale by anyone other than Amphenol Corporation without its prior consent,
and that no right is granted to disclose or to use any information in this document.

Amphenol®
Amphenol Taiwan Corporation
Sheet 12 of 14
PRODUCT SPECIFICATION
PS-7428 Rev. E
4.4 Recommended IR reflow profile(Lead-free)
This document is the property of Amphenol Corporation and is delivered on the express condition that it is not to be disclosed
reproduced or used, in whole or in part, for manufacture or sale by anyone other than Amphenol Corporation without its prior consent,
and that no right is granted to disclose or to use any information in this document.

Amphenol®
| | | Amphenol Taiwan Corporation | | | | Sheet | 13  of  | 14  |
| --- | --- | --- | --- | --- | --- | --- | --- | --- |
| | | | | | | PS-7428 | Rev. E  | |
| PRODUCT  SPECIFICATION | | | | | | | | |

5.0  Test sequence

Test  or  Test groups
examination  A-1  A-2  A-3 A-4 A-5 A-7 B-1 B-2 B-3  B-4  B-5  B-6 B-7
Low level contact  1,4,6 1,4,6 1,4,7 1,4,6 1,4,6 2,8
| resistance | | ,8  | ,8,10 | ,8 | | | | |
| --- | --- | --- | ----- | ----- | --- | ---- | --- | --- |
| Insulation resistance | | | | | | 2 | | |
| Dielectric withstanding  | | | | 1,9 | | | | |
voltage
| Contact current rating  | | | | | | | | |
| --- | --- | --- | --- | --- | --- | ---- | ---- | --- |
| Contact Capacitance | | | | | | 1 | | |
| D+/D- pair attenuation  | | | | | | | 1 | |
| Propagation delay | | | | | | | 2 | |
| Propagation delay | | | | | | | 3 | |
intra-pair skew
| Mated connection  | | | | | | | 4 | |
| --- | --- | --- | --- | --- | --- | --- | ---- | --- |
impedance
| Differential insertion  | | | | | | | 5 | |
| --- | --- | --- | --- | --- | --- | --- | ---- | --- |
loss of SS pairs
| Differential-to-  | | | | | | | 6 | |
| --- | --- | --- | --- | --- | --- | --- | ---- | --- |
common-mode
conversion
| Differential near-end  | | | | | | | 7 | |
| --- | --- | --- | --- | --- | --- | --- | ---- | --- |
crosstalk
between Super Speed
Pairs
| Differential crosstalk  | | | | | | | 8 | |
| --- | --- | --- | --- | --- | --- | --- | ---- | --- |
between
D+/D- (USB2.0)
and Super Speed
Pairs (USB3.0)
| Insertion force | | | | 3,6 | | | | |
| --- | --- | --- | ----- | ----- | --- | --- | --- | --- |
| Extraction force  | | | | 4,7 | | | | |
| Durability | 2 | 2 | 2  2  | 2 | | | | |
(preconditioning)
| Reseating | 5 | 7 | 9  | 7 | | | | |
| --- | --- | --- | ---- | ---- | --- | --- | --- | ---- |
| Durability | | | | 5  | | | | |
| Peel strength | | | | | | | | 1  |
| 4-Axes continuity test  | | | | | 1 | | | |
| Wrenching strength | | | | | | | 1  | |
| Vibration | | | 5 | | | | | |
| Mechanical Shock | | | 6 | | | | | |

This  document  is  the  property  of  Amphenol  Corporation  and  is  delivered  on  the  express  condition  that  it  is  not  to  be  disclosed
reproduced  or  used,  in  whole  or  in  part,  for  manufacture  or  sale  by  anyone  other  than  Amphenol  Corporation  without  its  prior  consent,
and  that  no  right  is  granted  to  disclose  or  to  use  any  information  in  this  document.

Amphenol®
| | Amphenol Taiwan Corporation | | | | Sheet  14  | of | 14  |
| --- | --- | --- | --- | --- | --- | --- | --- |
| | | | | PS-7428 | | Rev. E | |
| PRODUCT  SPECIFICATION | | | | | | | |

| Test  or  | | | Test groups | | | | |
| --- | --- | --- | --- | --- | --- | --- | --- |
examination  A-1  A-2  A-3 A-4 A-5 A-7 B-1 B-2 B-3  B-4  B-5  B-6 B-7
| Temperature life  | | 3  3  | 3 | | | | |
| --- | --- | ----- | ---- | --- | --- | --- | --- |
(preconditioning)
| Temperature life  | 3 | | | | | | |
| --- | ---- | --- | --- | --- | --- | --- | --- |
| Cyclic temp and | 5  | | | | | | |
humidity
| Thermal shock | 3  | | | | | | |
| --- | ---- | ---- | ---- | --- | --- | --- | --- |
| Thermal cycling | | | 5 | | | | |
| Thermal disturbance  | | 7  | | | | | |
| Mixed flowing gas | | 5  | | | | | |
(MFG)
| Solderability | | | | | 1 | | |
| --- | --- | --- | --- | --- | ---- | --- | --- |
| Resistance to soldering  | | | | | | | |
heat   (Infrared reflow)
| General examination  | 7  9  | 8  11 | 9  10 | 2  3  | 2 | 2  | 2 |
| --- | ----- | ----- | ----- | ----- | ---- | ---- | --- |
| Critical dimensions  | | | | | | 1 | |
| Plating thickness | | | | | | 2 | |

Note:
1.  Test specimen:
  Test group A1~A7: 10 pcs/group
  All other groups: B-1: 5 pcs; B-2: 3 pcs; B-3: 5 pcs; B-4: 3 pcs; B-5: 3 pcs; B-6: 5 pcs.;
B-7: 3 pcs;
2.  Test specimen shall be sure to meet the drawing before the testing.

This  document  is  the  property  of  Amphenol  Corporation  and  is  delivered  on  the  express  condition  that  it  is  not  to  be  disclosed
reproduced  or  used,  in  whole  or  in  part,  for  manufacture  or  sale  by  anyone  other  than  Amphenol  Corporation  without  its  prior  consent,
and  that  no  right  is  granted  to  disclose  or  to  use  any  information  in  this  document.
