kelu124/rp569/datasheet/SD_Physical_Layer_Spec_v6.00.md

SD Specifications
Part 1
Physical Layer
Simplified Specification
Version 6.00
April 10, 2017
Technical Committee
SD Card Association

©Copyright 2001-2017 SD Card Association
Physical Layer Simplified Specification Version 6.00
Draft Only Page
Draft Revision History for Simplified Version 6.00
Date Draft Changes compared to previous issue
Version
March 21, 2017 Draft 0.50 Apply Ver.5.00 blank area to Ver.6.00
Modified Simplified DS Bus Timing (6.6.6)
Modified Simplified HS Bus Timing (6.6.7)
Blanked Chapter 8
Blanked Appendix A.1
Added mechanical drawings to Appendix H
April 3, 2017 Draft 1.00 Draft for TC Check
April 10, 2017 Draft 1.01 Fixed Figures 4-46, 4-55 to 4-63 of VSC (4.13)
Fxied Figures 4-53 location (4.13.2.8)
i

©Copyright 2001-2017 SD Card Association
Physical Layer Simplified Specification Version 6.00
Revision History
Date Version Changes compared to previous issue
Physical Layer Simplified Specification Version 1.10 initial release.
April 3, 2006 1.10
(Supplementary Notes Ver1.00 is applied.)
Physical Layer Simplified Specification Version 2.00
September 25, 2006 2.00
(1) High Capacity Memory Card (SDHC)
(2) Speed Class 2/4/6
May 18, 2010 3.01 Physical Layer Simplified Specification Version 3.01
(1) Extended Capacity Memory Card (SDXC)
(2) Ultra High Speed I (UHS-I)
(3) Speed Class 10
(4) UHS Speed Grade 1
(5) Current Limit
January 22, 2013 4.10 Physical Layer Simplified Specification Version 4.10
(1) UHS-II Interface
(2) UHS Speed Grade 3
(3) Power Limit
(4) Function Extension Specification
August 10, 2016 5.00 Physical Layer Simplified Specification Version 5.00
(1) Video Speed Class VSC4/6/10/30/60/90
April 10, 2017 6.00 Physical Layer Simplified Specification Version 6.00
(1) Discard and FULE to Erase
(2) Card Ownership Protection (COP) for Card Lock/Unlock
(3) Application Performance Class for A1/A2
(4) Cache
(5) Self-Maintenance
(6) Command Queuing
(7) Simplifed Mechanical Drawings
(8) Simplifed Bus Timings
To the extent this proposed specification, which is being submitted for review under the IP
Policy, implements, incorporates by reference or refers to any portion of versions 1.0 or 1.01 of
the SD Specifications (including Parts 1 through 4), adoption of the proposed specification shall
require Members utilizing the adopted specification to obtain the appropriate licenses from the
SD-3C, LLC, as required for the utilization of those portion(s) of versions 1.0 or 1.01 of the SD
Specifications.
For example, implementation of the SD Specifications in a host device under versions 1.0 or
1.01 and under the adopted specification requires the execution of a SD Host Ancillary License
Agreement with the SD-3C, LLC; and implementation of the SD Specifications under versions
1.0 or 1.01 and under the proposed specification in a SD Card containing any memory storage
capability (other than for storage of executable code for a controller or microprocessor within
the SD Card) requires the execution of a SD Memory Card License Agreement with the SD-3C,
LLC.
ii

©Copyright 2001-2017 SD Card Association
Physical Layer Simplified Specification Version 6.00
Release of SD Simplified Specification/Addendum
The following conditions apply to the release of the SD Simplified Specification/Addendum by the SD
Card Association. The Simplified Specification/Addendum is a subset of the complete version of SD
Specification/Addendum that is owned by the SD Card Association.
Conditions for publication
Publisher and Copyright Holder:
SD Card Association
2400 Camino Ramon, Suite 375
San Ramon, CA 94583 USA
Telephone: +1 (925) 275-6615,
Fax: +1 (925) 886-4870
E-mail: office@sdcard.org
Notes:
This Simplified Specification/Addendum is provided on a non-confidential basis subject to the disclaimers
below. Any implementation of the Simplified Specification/Addendum may require a license from the SD
Card Association or other third parties.
Disclaimers:
The information contained in the Simplified Specification/Addendum is presented only as a standard
Specification/Addendum for SD Cards and SD Host/Ancillary products and is provided "AS-IS" without
any representations or warranties of any kind. No responsibility is assumed by the SD Card Association
for any damages, any infringements of patents or other right of the SD Card Association or any third
parties, which may result from its use. No license is granted by implication, estoppel or otherwise under
any patent or other rights of the SD Card Association or any third party. Nothing herein shall be construed
as an obligation by the SD Card Association to disclose or distribute any technical information, know-how
or other confidential information to any third party.
iii

©Copyright 2001-2017 SD Card Association
Physical Layer Simplified Specification Version 6.00
Conventions Used in This Document
Naming Conventions
 Some terms are capitalized to distinguish their definition from their common English meaning. Words
not capitalized have their common English meaning.
Numbers and Number Bases
 Hexadecimal numbers are written with a lower case "h" suffix, e.g., FFFFh and 80h.
 Binary numbers are written with a lower case "b" suffix (e.g., 10b).
 Binary numbers larger than four digits are written with a space dividing each group of four digits, as in
1000 0101 0010b.
 All other numbers are decimal.
Key Words
 May: Indicates flexibility of choice with no implied recommendation or requirement.
 Shall: Indicates a mandatory requirement. Designers shall implement such mandatory requirements
to ensure interchangeability and to claim conformance with the specification.
 Should: Indicates a strong recommendation but not a mandatory requirement. Designers should give
strong consideration to such recommendations, but there is still a choice in implementation.
 Reserved: Indicates a bit, byte, field, and value that are set aside for future standardization or other
usage. A reserved bit, byte, or field shall be set to zero unless specified differently in this
specification, or in accordance with a future extension to this or other standards. Hosts and
Cards are not required to check reserved bits, bytes, or fields for zero values. Values that are
reserved for future standardization shall not be specified by hosts and cards.
Application Notes
Some sections of this document provide guidance to the host implementers as follows:
Application Note:
This is an example of an application note.
iv

©Copyright 2001-2017 SD Card Association
Physical Layer Simplified Specification Version 6.00
Table of Contents
1. General Description ............................................................................................................ 1
2. System Features ................................................................................................................. 3
3. SD Memory Card System Concept .................................................................................... 5
3.1 Read-Write Property ................................................................................................................... 5
3.2 Supply Voltage ............................................................................................................................ 5
3.3 Card Capacity ............................................................................................................................. 5
3.3.1 User Area and Protected Area .............................................................................................. 5
3.3.2 Card Capacity Classification ................................................................................................. 5
3.4 Speed Class ............................................................................................................................... 5
3.5 Bus Topology .............................................................................................................................. 6
3.6 Bus Protocol ............................................................................................................................... 7
3.6.1 SD Bus Protocol ................................................................................................................... 7
3.6.2 SPI Bus Protocol ................................................................................................................ 10
3.6.3 UHS-II Bus Protocol ........................................................................................................... 10
3.7 SD Memory Card–Pins and Registers ....................................................................................... 11
3.7.1 SD Bus Pin Assignment ....................................................................................................... 11
3.7.2 UHS-II Pin Assignment ....................................................................................................... 13
3.8 ROM Card ................................................................................................................................ 14
3.8.1 Register Setting Requirements ........................................................................................... 14
3.8.2 Unsupported Commands .................................................................................................... 14
3.8.3 Optional Commands ........................................................................................................... 14
3.8.4 WP Switch .......................................................................................................................... 14
3.9 Ultra High Speed Phase I (UHS-I) Card .................................................................................... 15
3.9.1 UHS-I Card Operation Modes ............................................................................................. 15
3.9.2 UHS-I Card Types .............................................................................................................. 15
3.9.3 UHS-I Host and Card Combination ..................................................................................... 16
3.9.4 UHS-I Bus Speed Modes Selection Sequence ................................................................... 17
3.9.5 UHS-I System Block Diagram ............................................................................................. 18
3.9.6 Summary of Bus Speed Mode for UHS-I Card ................................................................... 18
3.10 Ultra High Speed Phase II (UHS-II) Card ................................................................................ 19
3.10.1 UHS-II Card Operation Modes .......................................................................................... 19
3.10.2 UHS-II Card Type ............................................................................................................. 19
3.10.3 UHS-II Host and Card Combination .................................................................................. 20
3.10.4 UHS-II Interface Selection Sequence ............................................................................... 20
3.10.5 Summary of Bus Speed Mode for UHS-II Card ................................................................. 22
3.11 Application Performance Class ............................................................................................... 23
3.12 Cache ..................................................................................................................................... 24
3.13 Self Maintenance .................................................................................................................... 24
3.14 Command Queue ................................................................................................................... 24
3.15 LV Interface ............................................................................................................................ 25
3.16 Higher Bus Speed of UHS-II (UHS-III) .................................................................................... 25
4. SD Memory Card Functional Description ....................................................................... 26
4.1 General ....................................................................................................................... .............. 26
4.2 Card Identification Mode ........................................................................................................... 27
4.2.1 Card Reset ......................................................................................................................... 27
v

©Copyright 2001-2017 SD Card Association
Physical Layer Simplified Specification Version 6.00
4.2.2 Operating Condition Validation ........................................................................................... 27
4.2.3 Card Initialization and Identification Process ...................................................................... 29
4.2.3.1 Initialization Command (ACMD41) .......................................................................................... 31
4.2.4 Bus Signal Voltage Switch Sequence ................................................................................. 32
4.2.4.1 Initialization Sequence for UHS-I ............................................................................................ 32
4.2.4.2 Timing to Switch Signal Voltage .............................................................................................. 33
4.2.4.3 Timing of Voltage Switch Error Detection ............................................................................... 33
4.2.4.4 Voltage Switch Command ....................................................................................................... 33
4.2.4.5 Tuning Command .................................................................................................................... 33
4.2.4.6 An Example of UHS-I System Block Diagram ........................................................................ 34
4.3 Data Transfer Mode .................................................................................................................. 35
4.3.1 Wide Bus Selection/Deselection ......................................................................................... 37
4.3.2 2 GByte Card ..................................................................................................................... 37
4.3.3 Data Read .......................................................................................................................... 37
4.3.4 Data Write .......................................................................................................................... 38
4.3.5 Erase/Discard/FULE ........................................................................................................... 40
4.3.5.1 Erase ....................................................................................................................................... 40
4.3.5.2 Discard .................................................................................................................................... 40
4.3.5.3 Full User Area Logical Erase (FULE) ...................................................................................... 41
4.3.6 Write Protect Management ................................................................................................. 42
4.3.7 Card Lock/Unlock Operation............................................................................................... 44
4.3.7.1 General .................................................................................................................................... 44
4.3.7.2 Parameter and the Result of CMD42 ...................................................................................... 53
4.3.7.3 Forcing Erase .......................................................................................................................... 57
4.3.7.4 Relation Between ACMD6 and Lock/Unlock State ................................................................. 58
4.3.7.5 Commands Accepted for Locked Card ................................................................................... 59
4.3.7.6 Three Types of Lock/Unlock Card ........................................................................................... 59
4.3.8 Content Protection .............................................................................................................. 60
4.3.9 Application-Specific Commands ......................................................................................... 61
4.3.9.1 Application-Specific Command – APP_CMD (CMD55) .......................................................... 61
4.3.9.2 General Command - GEN_CMD (CMD56) ............................................................................. 61
4.3.10 Switch Function Command ............................................................................................... 62
4.3.10.1 General .................................................................................................................................. 62
4.3.10.2 Mode 0 Operation - Check Function ..................................................................................... 64
4.3.10.3 Mode 1 Operation - Set Function .......................................................................................... 64
4.3.10.4 Switch Function Status .......................................................................................................... 68
4.3.10.5 Relationship between CMD6 Data and Other Commands ................................................... 72
4.3.10.6 Switch Function Flow Example ............................................................................................. 72
4.3.10.7 Example of Checking ............................................................................................................ 72
4.3.10.8 Example of Switching ............................................................................................................ 72
4.3.11 High-Speed Mode (25 MB/sec interface speed) ................................................................ 73
4.3.12 Command System ............................................................................................................ 73
4.3.13 Send Interface Condition Command (CMD8) ................................................................... 74
4.3.14 Command Functional Difference in Card Capacity Types ................................................. 75
4.4 Clock Control ............................................................................................................................ 76
4.5 Cyclic Redundancy Code (CRC) ............................................................................................... 77
4.6 Error Conditions ........................................................................................................................ 79
4.6.1 CRC and Illegal Command ................................................................................................. 79
4.6.2 Read, Write and Erase Timeout Conditions ........................................................................ 79
4.6.2.1 Read ........................................................................................................................................ 79
4.6.2.2 Write ........................................................................................................................................ 79
4.6.2.3 Erase ....................................................................................................................................... 80
vi

©Copyright 2001-2017 SD Card Association
Physical Layer Simplified Specification Version 6.00
4.7 Commands ............................................................................................................................... 81
4.7.1 Command Types ................................................................................................................ 81
4.7.2 Command Format .............................................................................................................. 81
4.7.3 Command Classes ............................................................................................................. 81
4.7.4 Detailed Command Description .......................................................................................... 86
4.7.5 Difference of SD Commands Definition in UHS-II ............................................................... 95
4.8 Card State Transition Table ....................................................................................................... 96
4.9 Responses ............................................................................................................................... 98
4.9.1 R1 (normal response command): ....................................................................................... 98
4.9.2 R1b .................................................................................................................................... 98
4.9.3 R2 (CID, CSD register) ....................................................................................................... 98
4.9.4 R3 (OCR register) .............................................................................................................. 99
4.9.5 R6 (Published RCA response) ............................................................................................ 99
4.9.6 R7 (Card interface condition) ............................................................................................ 100
4.10 Three Status Information of SD Memory Card ...................................................................... 101
4.10.1 Card Status .................................................................................................................... 101
4.10.2 SD Status ....................................................................................................................... 105
4.10.2.1 SIZE_OF_PROTECTED_AREA ......................................................................................... 106
4.10.2.2 SPEED_CLASS .................................................................................................................. 106
4.10.2.3 PERFORMANCE_MOVE .................................................................................................... 107
4.10.2.4 AU_SIZE .............................................................................................................................. 107
4.10.2.5 ERASE_SIZE ...................................................................................................................... 108
4.10.2.6 ERASE_TIMEOUT .............................................................................................................. 108
4.10.2.7 ERASE_OFFSET ................................................................................................................ 108
4.10.2.8 UHS_SPEED_GRADE ........................................................................................................ 109
4.10.2.9 UHS_AU_SIZE .................................................................................................................... 109
4.10.2.10 VIDEO_SPEED_CLASS ................................................................................................... 109
4.10.2.11 VSC_AU_SIZE .................................................................................................................. 110
4.10.2.12 SUS_ADDR ........................................................................................................................ 111
4.10.2.13 APP_PERF_CLASS ........................................................................................................... 111
4.10.2.1 PERFORMANCE_ENHANCE ............................................................................................ 112
4.10.3 Task Status ...................................................................................................................... 112
4.11 Memory Array Partitioning ...................................................................................................... 113
4.12 Timings .................................................................................................................................. 113
4.13 peed Class Specification........................................................................................................ 114
4.13.1 Speed Class Specification for SDSC and SDHC ............................................................. 114
4.13.1.1 Allocation Unit (AU) ............................................................................................................. 114
4.13.1.2 Recording Unit (RU) ............................................................................................................ 115
4.13.1.3 Write Performance .............................................................................................................. 115
4.13.1.4 Read Performance .............................................................................................................. 116
4.13.1.5 Performance Curve Definition ............................................................................................. 117
4.13.1.6 Speed Class Definition ........................................................................................................ 117
4.13.1.7 Consideration for Inserting FAT Update during Recording ................................................. 118
4.13.1.8 Measurement Conditions and Requirements of the Speed Class ...................................... 119
4.13.1.9 CMD20 Support ................................................................................................................... 120
4.13.2 Speed Class Specification for SDXC .............................................................................. 121
4.13.2.1 Speed Class Parameters .................................................................................................... 121
4.13.2.2 Write Performance .............................................................................................................. 121
4.13.2.3 Read Performance .............................................................................................................. 122
4.13.2.4 FAT Update .......................................................................................................................... 122
4.13.2.5 CI (Continuous Information) Update ................................................................................... 122
4.13.2.6 Distinction of Data Type ...................................................................................................... 123
vii

©Copyright 2001-2017 SD Card Association
Physical Layer Simplified Specification Version 6.00
4.13.2.7 Measurement Conditions and Requirements of the Speed Class for SDXC ..................... 123
4.13.2.8 Speed Class Control Command (CMD20) .......................................................................... 124
4.13.2.9 Example of Speed Class Recording Sequence .................................................................. 125
4.13.3 Speed Grade Specification for UHS-I and UHS-II ........................................................... 127
4.13.3.1 Speed Grade Parameters ................................................................................................... 127
4.13.3.2 Support of Speed Class Control Command (CMD20) ........................................................ 127
4.13.3.3 Speed Grade Measurement Conditions ............................................................................. 128
4.13.3.4 Notes for Preparation Time of UHS-I and UHS-II Card ...................................................... 128
4.13.3.5 Host Operating Frequency .................................................................................................. 128
4.13.4 Video Speed Class Specification .................................................................................... 129
4.13.4.1 AU Use in Video Speed Class............................................................................................. 129
4.13.4.2 Video Speed Class Parameters .......................................................................................... 133
4.13.4.3 Video Speed Class Timing .................................................................................................. 134
4.13.4.4 SD Interface Mode Requirements for Video Speed Classes.............................................. 136
4.13.4.5 Requirements of SD File System for Video Speed Class ................................................... 137
4.13.4.6 FAT Updates in Video Speed Class .................................................................................... 137
4.13.4.7 CMD20 in Video Speed Class ............................................................................................. 139
4.13.4.8 Video Speed Class Measurement Conditions .................................................................... 145
4.13.4.9 Host Operating Frequency .................................................................................................. 146
4.14 Erase Timeout Calculation .................................................................................................... 147
4.14.1 Erase Unit ...................................................................................................................... 147
4.14.2 Case Analysis of Erase Time Characteristics .................................................................. 147
4.14.3 Method for Erase Large Areas ........................................................................................ 148
4.14.4 Calculation of Erase Timeout Value Using the Parameter Registers ............................... 148
4.15 Set Block Count Command ................................................................................................... 149
4.16 Application Performance Specification .................................................................................. 150
4.16.1 Application Performance Classes ................................................................................... 150
4.16.1.1 Application Performance Class 1 ........................................................................................ 150
4.16.1.2 Application Performance Class 2 ........................................................................................ 150
4.16.2 Application Performance Class Measurement Conditions ............................................... 150
4.16.2.1 Clock Condition ................................................................................................................... 150
4.16.2.2 Power Limit .......................................................................................................................... 151
4.16.2.3 Host Operating Frequency .................................................................................................. 151
4.16.2.4 Application Performance Measurement Conditions Overview ........................................... 151
4.16.2.5 Sustained Sequential Write Performance Measurement Conditions Overview ................. 152
4.16.3 Application Performance Class Parameters .................................................................... 152
4.16.3.1 Performance of Random Write, (PRw) ............................................................................... 152
4.16.3.2 Performance of Random Read, (PRr)................................................................................. 152
4.16.3.3 Performance of Sustained Sequential Write, (PSSw) ........................................................ 152
4.17 Cache ................................................................................................................................... 153
4.18 Self Maintenance .................................................................................................................. 153
4.18.1 Card Initiated Maintenance ............................................................................................. 153
4.18.2 Host Initiated Maintenance ............................................................................................. 154
4.19 Command Queue ................................................................................................................. 155
4.19.1 Command Queue Mode ................................................................................................. 155
4.19.1.1 Voluntary CQ Mode ............................................................................................................. 156
4.19.1.2 Sequential CQ Mode ........................................................................................................... 156
4.19.2 Command Support in CQ Mode ..................................................................................... 156
4.19.3 CURRENT_STATE for CQ mode .................................................................................... 157
4.19.4 Card State Machine in CQ mode .................................................................................... 157
4.19.5 Task Submission ............................................................................................................ 157
4.19.6 Queued Task Status Check ............................................................................................ 158
viii

©Copyright 2001-2017 SD Card Association
Physical Layer Simplified Specification Version 6.00
4.19.7 Execution of Task ........................................................................................................... 159
4.19.8 Task Management .......................................................................................................... 159
5. Card Registers ................................................................................................................ 160
5.1 OCR register........................................................................................................................... 160
5.2 CID register ............................................................................................................................ 162
5.3 CSD Register .......................................................................................................................... 163
5.3.1 CSD_STRUCTURE .......................................................................................................... 163
5.3.2 CSD Register (CSD Version 1.0) ...................................................................................... 164
5.3.3 CSD Register (CSD Version 2.0) ...................................................................................... 171
5.4 RCA register ........................................................................................................................... 174
5.5 DSR register (Optional) .......................................................................................................... 174
5.6 SCR register ........................................................................................................................... 174
5.7 Function Extension Specification ............................................................................................ 179
5.7.1 Extension Register Space ................................................................................................ 179
5.7.2 Extension Register Commands ........................................................................................ 180
5.7.2.1 Extension Register Read Command (Single Block) ............................................................. 180
5.7.2.2 Extension Register Write Command (Single Block) ............................................................. 182
5.7.2.3 Multiple Block Data Transfer ................................................................................................. 184
5.7.2.4 Extension Register Read Command (Multi-Block) ............................................................... 185
5.7.2.5 Extension Register Write Command (Multi-Block) ................................................................ 186
5.7.2.6 Error Status Indication ........................................................................................................... 187
5.7.3 General Information .......................................................................................................... 188
5.7.3.1 Common Header Fields ........................................................................................................ 189
5.7.3.2 Function Fields per Function ................................................................................................. 189
5.7.4 Revision Management ...................................................................................................... 191
5.7.5 Event Indication Method ................................................................................................... 191
5.7.5.1 FX_EVENT (Bit06 of Card Status) ........................................................................................ 191
5.7.5.2 Function Extension Event (FXE) Register Set ...................................................................... 191
5.7.5.3 Event Status Register ........................................................................................................... 192
5.7.5.4 FX_EVENT Enable ................................................................................................................ 192
5.8 Application Specification on Function Extension ..................................................................... 193
5.8.1 Power Management Function ........................................................................................... 193
5.8.1.1 Abstract of Power Management Function ............................................................................. 193
5.8.1.2 Extension Register Set for Power Management ................................................................... 193
5.8.1.3 Power Off Notification............................................................................................................ 195
5.8.1.4 Power Sustenance ................................................................................................................ 196
5.8.1.5 Power Down Mode ................................................................................................................ 197
5.8.1.6 General Information of Power Management Function .......................................................... 198
5.8.2 Performance Enhancement Function ............................................................................... 199
5.8.2.1 Abstract of Performance Enhancement Function ................................................................. 199
5.8.2.2 Extension Register Set for Performance Enhancement Function ........................................ 199
5.8.2.3 General Information of Performance Enhancement Function .............................................. 200
6. SD Memory Card Hardware Interface ............................................................................ 202
6.1 Hot Insertion and Removal ..................................................................................................... 202
6.2 Card Detection (Insertion/Removal) ........................................................................................ 202
6.3 Power Protection (Insertion/Removal)..................................................................................... 202
6.4 Power Scheme ....................................................................................................................... 203
6.4.1 Power Up Sequence for SD Bus Interface ........................................................................ 203
6.4.1.1 Power Up Time of Card ......................................................................................................... 203
6.4.1.2 Power Up Time of Host ......................................................................................................... 204
ix

©Copyright 2001-2017 SD Card Association
Physical Layer Simplified Specification Version 6.00
6.4.1.3 Power On or Power Cycle ..................................................................................................... 204
6.4.1.4 Power Supply Ramp Up ........................................................................................................ 204
6.4.1.5 Power Down and Power Cycle ............................................................................................. 204
6.4.2 Power Up Sequence for UHS-II Interface ......................................................................... 205
6.4.2.1 Power Up Sequence of UHS-II Card .................................................................................... 205
6.4.2.2 Power Up Sequence of UHS-II Host ..................................................................................... 205
6.5 Programmable Card Output Driver (3.3V Single End) (Optional) ............................................ 206
6.6 Bus Operating Conditions for 3.3V Signaling .......................................................................... 206
6.6.1 Threshold Level for High Voltage Range .......................................................................... 206
6.6.2 Peak Voltage and Leakage Current .................................................................................. 206
6.6.3 Power Consumption ......................................................................................................... 206
6.6.4 Bus signal line load .......................................................................................................... 206
6.6.5 Bus Signal Levels ............................................................................................................. 206
6.6.6 Bus Timing (Default) ......................................................................................................... 207
6.6.7 Bus Timing (High-Speed Mode) ........................................................................................ 208
6.7 Driver Strength and Bus Timing for 1.8V Signaling ................................................................. 208
6.8 Electrical Static Discharge (ESD) Requirement ...................................................................... 208
7. SPI Mode .......................................................................................................................... 209
7.1 Introduction ............................................................................................................................. 209
7.2 SPI Bus Protocol .................................................................................................................... 209
7.2.1 Mode Selection and Initialization ...................................................................................... 210
7.2.2 Bus Transfer Protection .................................................................................................... 212
7.2.3 Data Read ........................................................................................................................ 212
7.2.4 Data Write ........................................................................................................................ 213
7.2.5 Erase & Write Protect Management ................................................................................. 214
7.2.6 Read CID/CSD Registers ................................................................................................. 215
7.2.7 Reset Sequence ............................................................................................................... 215
7.2.8 Error Conditions ............................................................................................................... 215
7.2.9 Memory Array Partitioning ................................................................................................ 215
7.2.10 Card Lock/Unlock ........................................................................................................... 215
7.2.11 Application Specific Commands ...................................................................................... 215
7.2.12 Content Protection Command ........................................................................................ 216
7.2.13 Switch Function Command ............................................................................................. 216
7.2.14 High Speed Mode ........................................................................................................... 216
7.2.15 Speed Class Specification .............................................................................................. 216
7.3 SPI Mode Transaction Packets ............................................................................................... 217
7.3.1 Command Tokens ............................................................................................................ 217
7.3.1.1 Command Format ................................................................................................................. 217
7.3.1.2 Command Classes ................................................................................................................ 217
7.3.1.3 Detailed Command Description ............................................................................................ 219
7.3.1.4 Card Operation for CMD8 in SPI mode ................................................................................ 224
7.3.2 Responses ....................................................................................................................... 225
7.3.2.1 Format R1.............................................................................................................................. 225
7.3.2.2 Format R1b ........................................................................................................................... 225
7.3.2.3 Format R2.............................................................................................................................. 226
7.3.2.4 Format R3.............................................................................................................................. 227
7.3.2.5 Formats R4 & R5 ................................................................................................................... 227
7.3.2.6 Format R7.............................................................................................................................. 227
7.3.3 Control Tokens ..................................................................................................... ............ 228
7.3.3.1 Data Response Token ........................................................................................................... 228
7.3.3.2 Start Block Tokens and Stop Tran Token .............................................................................. 228
x

©Copyright 2001-2017 SD Card Association
Physical Layer Simplified Specification Version 6.00
7.3.3.3 Data Error Token ................................................................................................................... 229
7.3.4 Clearing Status Bits .......................................................................................................... 229
7.4 Card Registers ........................................................................................................................ 230
7.5 SPI Bus Timing Diagrams ....................................................................................................... 231
7.6 SPI Electrical Interface ........................................................................................................... 231
7.7 SPI Bus Operating Conditions ................................................................................................ 231
7.8 Bus Timing .............................................................................................................................. 231
8. Sections Effective to SD I/F Mode and UHS-II Mode .................................................... 232
Appendix A (Normative) : Reference ................................................................................. 233
A.1 Related Documentation .......................................................................................................... 233
Appendix B (Normative) : Special Terms .......................................................................... 234
B.1 Terminology ............................................................................................................................ 234
B.2 Abbreviations .......................................................................................................................... 235
Appendix C (Informative) : Examples for Fixed Delay UHS-I Host Design .................... 237
Appendix D : UHS-I Tuning Procedure .............................................................................. 238
Appendix E : Host Power Delivery Network (PDN) Design Guide .................................. 239
Appendix F : Application Notes of Extension Function ................................................. 240
F.1 Identification of Function Driver ............................................................................................... 240
F.2 Concept of Event Detection Method ........................................................................................ 241
F.2.1 Role of Driver Modules......................................................................................................... 241
F.2.2 Host Implementation to use Event Detection Method ........................................................... 242
Appendix G (Informative) : Application Notes for Hosts supporting Application
Performance Class ............................................................................................................. 243
G.1 Check for Application Performance Class support.................................................................. 243
Appendix H : Simplified Mechanical Drawings ................................................................ 244
H.1 Standard Size SD Card Simplified Dimensions ...................................................................... 244
H.2 microSD Card Simplified Dimensions ..................................................................................... 245
xi

©Copyright 2001-2017 SD Card Association
Physical Layer Simplified Specification Version 6.00
Table of Figures
Figure 1-1 : SD Specifications Documentation Structure ................................................................................ 1
Figure 3-1 : SD Memory Card System Bus Topology ...................................................................................... 6
Figure 3-2 : SD Memory Card System (SPI Mode) Bus Topology ................................................................... 6
Figure 3-3 : UHS-II Bus Topologies .................................................................................................................. 6
Figure 3-4 : "no response" and "no data" Operations ...................................................................................... 7
Figure 3-5 : (Multiple) Block Read Operation................................................................................................... 7
Figure 3-6 : (Multiple) Block Write Operation ................................................................................................... 8
Figure 3-7 : Command Token Format .............................................................................................................. 8
Figure 3-8 : Response Token Format............................................................................................................... 8
Figure 3-9 : Data Packet Format - Usual Data ................................................................................................ 9
Figure 3-10 : Data Packet Format - Wide Width Data ................................................................................... 10
Figure 3-11 : SD Memory Card Shape and Interface (Top View) .................................................................. 11
Figure 3-12 : SD Memory Card Architecture .................................................................................................. 12
Figure 3-13 : UHS-II Card Shape and Interface (Top View) .......................................................................... 13
Figure 3-14 : UHS-I Card Type Modes of Operation versus Frequency Range ............................................ 15
Figure 3-15 : UHS-I Card Type Modes of Operation versus Throughput ...................................................... 16
Figure 3-16 : Command Sequence to Use UHS-I ......................................................................................... 17
Figure 3-17 : Host and Card Block Diagram .................................................................................................. 18
Figure 3-18 : Interface Speed of UHS-II Card (UHS156 and UHS624) ........................................................ 19
Figure 3-19 : UHS-II Interface Detection ........................................................................................................ 20
Figure 3-20 : UHS-II Interface Initialization .................................................................................................... 21
Figure 3-21 : UHS-II Interface Deactivation ................................................................................................... 22
Figure 4-1 : SD Memory Card State Diagram (card identification mode) ...................................................... 28
Figure 4-2 : Card Initialization and Identification Flow (SD mode) ................................................................ 30
Figure 4-3 : Argument of ACMD41 ................................................................................................................. 31
Figure 4-4 : Response of ACMD41 ................................................................................................................ 31
Figure 4-5 : ACMD41 Timing Followed by Voltage Switch Sequence ........................................................... 32
Figure 4-6 : UHS-I Host Initialization Flow Chart ........................................................................................... 32
Figure 4-7 : Signal Voltage Switch Sequence ................................................................................................ 33
Figure 4-8 : Error Indication Timing ................................................................................................................ 33
Figure 4-9 : Voltage Switch Command .......................................................................................................... 33
Figure 4-10 : Send Tuning Block Command .................................................................................................. 34
Figure 4-11 : Tuning Block on DAT[3:0] ......................................................................................................... 34
Figure 4-12 : An Example of UHS-I System Block Diagram ......................................................................... 34
Figure 4-13 : SD Memory Card State Diagram (data transfer mode) ............................................................ 35
Figure 4.3.5-1 : Flowchart of Card Behavior for Erase Command Sequence ............................................... 42
Figure 4.3.7-1 : Simplified Non-COP Card State Diagram ............................................................................ 46
Figure 4.3.7-2 : Simplified COP Card State Diagram .................................................................................... 47
Figure 4.3.7-3 : COP Card Protection Setup (left) and FEP Force Erase (right) Sequences ....................... 52
Figure 4.3.7-4 : COP Card Unlock/Lock Sequence ....................................................................................... 53
Figure 4-14 : Use of Switch Command .......................................................................................................... 63
Figure 4-15 : Busy Status of 'Command System' .......................................................................................... 70
Figure 4-16 : CMD12 during CMD6; Case 1 .................................................................................................. 72
Figure 4-17 : CMD12 during CMD6; Case 2 .................................................................................................. 72
Figure 4-18 : Example of Switch Function flow .............................................................................................. 72
Figure 4-19 : Switching Function Flow ........................................................................................................... 72
Figure 4-20 : CRC7 Generator/Checker ........................................................................................................ 77
Figure 4-21 : CRC16 Generator/Checker ...................................................................................................... 78
Figure 4-22 : Write Protection Hierarchy ........................................................................................ .............. 113
Figure 4-23 : Identification Timing (Card Identification Mode) ..................................................................... 113
Figure 4-24 : SEND_RELATIVE_ADDR Timing ........................................................................................... 113
xii

©Copyright 2001-2017 SD Card Association
Physical Layer Simplified Specification Version 6.00
Figure 4-25 : Command Response Timing (Data Transfer Mode) .............................................................. 113
Figure 4-26 : Timing of Response End to Next CMD Start (Data Transfer Mode) ...................................... 113
Figure 4-27 : Timing of Command Sequences (All Modes) ......................................................................... 113
Figure 4-28 : Timing of Single Block Read Command ................................................................................. 113
Figure 4-29 : Timing of Multiple Block Read Command .............................................................................. 113
Figure 4-30 : Timing of Stop Command (CMD12, Data Transfer Mode) ..................................................... 113
Figure 4-31 : Timing of Single Block Write Command ................................................................................. 113
Figure 4-32 : Timing of Multiple Block Write Command ............................................................................... 113
Figure 4-33 : Stop Transmission Received during Data Transfer from the Host ......................................... 113
Figure 4-34 : Stop Transmission Received during CRC Status ................................................................... 113
Figure 4-35 : Stop Transmission Received during Busy of the Last Data Block ......................................... 113
Figure 4-36 : Stop Transmission Received while DAT is Tri-state ............................................................... 113
Figure 4-37 : Timing of Single Block Write Command ................................................................................. 113
Figure 4-38 : Clock Stop Timing at Block Gap in Read Operation .............................................................. 113
Figure 4-39 : Border Timing of CMD12 in Write Operation .......................................................................... 113
Figure 4-40 : Border Timing of CMD12 in Read Operation ......................................................................... 113
Figure 4-41 : Data Packet Format in DDR50 mode – Usual Data ............................................................... 113
Figure 4-42 : Data Packet Format in DDR50 mode – Wide Width Data ..................................................... 113
Figure 4-43 : CRC Status Token in DDR50 Mode ....................................................................................... 113
Figure 4-44 : CRC16 in DDR50 Mode ......................................................................................................... 113
Figure 4-45 : Timing of Single Block Read Command in DDR50 Mode ...................................................... 113
Figure 4-46 : Overview of Speed Class Specification.................................................................................. 114
Figure 4-47 : Definition of Allocation Unit (AU) ............................................................................................ 115
Figure 4-48 : Example of Writing Fragmented AU ....................................................................................... 115
Figure 4-49 : Card Performances between 16 RUs ..................................................................................... 117
Figure 4-50 : Three Performance Curves .................................................................................................... 118
Figure 4-51 : Typical Sequence of FAT Update ........................................................................................... 119
Figure 4-52 : Measurement of Pw (AU size is larger than 4MB) ................................................................. 122
Figure 4-53 : Definition of CMD20................................................................................................................ 124
Figure 4-54 : Example of Speed Class Recording Sequence ..................................................................... 126
Figure 4-55 : Example of Interleaved Multiple File Write in One AU ........................................................... 132
Figure 4-56 : Example of Concatenated File Write in One AU .................................................................... 132
Figure 4-57 : Access Rules for Multiple Files Recording ............................................................................. 133
Figure 4-58 : Time Components for Video Speed Class Performance Write Measurement ....................... 134
Figure 4-59 : Measurement of Pw ................................................................................................................ 135
Figure 4-60 : Read Performance Period for Pr and T (4KB) ..................................................................... 136
FR
Figure 4-61 : Example Sequence of FAT Cycle ........................................................................................... 138
Figure 4-62 : Definition of CMD20 (Video Speed Class) ............................................................................. 139
Figure 4-63 : Example of the Relationship between Assigned AUs and the Active AU ............................... 143
Figure 4-64 : Example Erase Characteristics (Case 1 TOFFSET=0) .......................................................... 147
Figure 4-65 : Example Erase Characteristics (Case 2 TOFFSET=2) .......................................................... 148
Figure 4-66 : Set Block Count Command .................................................................................................... 149
Figure 4-67 : Flowchart for Checking Cache ............................................................................................... 153
Figure 4-68 : Flowchart for Card Initiated Maintenance............................................................................... 154
Figure 4-69 : Flowchart for Checking Host Initiated Maintenance ............................................................... 155
Figure 4-70 : State Diagram in CQ Mode .................................................................................................... 157
Figure 4-71 : Illustration of Task Submission ............................................................................................... 158
Figure 4-72 : Illustration of Reading Task Ready Status .............................................................................. 158
Figure 4-73 : Illustration of Executing Read Task ........................................................................................ 159
Figure 4-74 : Illustration of Executing Write Task ......................................................................................... 159
Figure 5-1 : ERASE_BLK_EN = 0 Example ................................................................................................ 168
Figure 5-2 : ERASE_BLK_EN = 1 Example ................................................................................................ 168
Figure 5-3 : Extension Register Space ........................................................................................................ 179
xiii

©Copyright 2001-2017 SD Card Association
Physical Layer Simplified Specification Version 6.00
Figure 5-4 : Read Extension Register Single Block Command (CMD48) ................................................... 180
Figure 5-5 : Extension Register Read Operation by CMD48 ....................................................................... 181
Figure 5-6 : Data Port Read Operation by CMD48 ...................................................................................... 181
Figure 5-7 : Write Extension Register Single Block Command (CMD49) ................................................... 182
Figure 5-8 : Extension Register Write Operation by CMD49 ....................................................................... 183
Figure 5-9 : Data Port Write Operation by CMD49 ...................................................................................... 184
Figure 5-10 : Read Extension Register Multi-Block Command (CMD58) ................................................... 185
Figure 5-11 : Extension Register and Data Port Read Operation by CMD58 ............................................. 185
Figure 5-12 : Write Extension Register Multi-Block Command (CMD59) .................................................... 186
Figure 5-13 : Extension Register and Data Port Write Operation by CMD59 ............................................. 186
Figure 5-14 : General Information for Memory ............................................................................................ 188
Figure 5-15 : Data Structure of General Information ................................................................................... 189
Figure 5-16 : Power Management Revision Register .................................................................................. 194
Figure 5-17 : Power Management Status Register ...................................................................................... 194
Figure 5-18 : Power Management Setting Register ..................................................................................... 195
Figure 5-19 : Power Off Notification Flow .................................................................................................... 195
Figure 5-20 : Power Sustenance Enabling / Disabling Sequence Flow ...................................................... 196
Figure 5-21 : Power Down Mode Entering / Exiting Sequence Flow ........................................................... 198
Figure 6-1 : Bus Circuitry Diagram ............................................................................................................... 202
Figure 6-2 : Improper Power Supply ............................................................................................................ 202
Figure 6-3 : Short Circuit Protection ............................................................................................................. 202
Figure 6-4 : Power-up Diagram of Card ....................................................................................................... 203
Figure 6-5 : Power Up Diagram of Host ....................................................................................................... 204
Figure 6-6 : Power Up Sequence of UHS-II Device ..................................................................................... 205
Figure 6-7 : Power Up Sequence of UHS-II Host ........................................................................................ 205
Figure 6-8 : SD Memory Card Bus Driver .................................................................................................... 206
Figure 6-9 : Bus Signal Levels ..................................................................................................................... 206
Figure 6-10 : Card Input Timing (Default Speed Card) ................................................................................ 207
Figure 6-11 : Card Output Timing (Default Speed Mode) ............................................................................ 207
Figure 6-12 : Card Input Timing (High Speed Card) .................................................................................... 208
Figure 6-13 : Card Output Timing (High Speed Mode) ................................................................................ 208
Figure 7-1 : SD Memory Card State Diagram (SPI mode) .......................................................................... 210
Figure 7-2 : SPI Mode Initialization Flow ..................................................................................................... 211
Figure 7-3 : Single Block Read Operation ................................................................................................... 212
Figure 7-4 : Read Operation - Data Error .................................................................................................... 213
Figure 7-5 : Multiple Block Read Operation ................................................................................................. 213
Figure 7-6 : Single Block Write Operation .................................................................................................... 213
Figure 7-7 : Multiple Block Write Operation ................................................................................................. 214
Figure 7-8 : 'No data' Operations ................................................................................................................. 214
Figure 7-9 : R1 Response Format ................................................................................................................ 225
Figure 7-10 : R2 Response Format.............................................................................................................. 226
Figure 7-11 : R3 Response Format .............................................................................................................. 227
Figure 7-12 : R7 Response Format.............................................................................................................. 227
Figure 7-13 : Data Error Token ..................................................................................................................... 229
Figure F - 1 : Hardware and Driver Layer of Host and Card ....................................................................... 241
Figure H - 1 : Standard Size SD Card Simplified Dimensions .................................................................... 244
Figure H - 2 : microSD Card Simplified Dimensions ................................................................................... 245
xiv

©Copyright 2001-2017 SD Card Association
Physical Layer Simplified Specification Version 6.00
Table of Tables
Table 3-1 : SD Memory Card Pad Assignment .............................................................................................. 11
Table 3-2 : SD Memory Card Registers ......................................................................................................... 12
Table 3-3 : UHS-II Interface Pad Assignment ................................................................................................ 13
Table 3-4 : Register Setting Requirements for ROM Card ............................................................................ 14
Table 3-5 : UHS-I Host and Card Combinations ............................................................................................ 16
Table 3-6 : Bus Speed Modes of UHS-I Card ................................................................................................ 18
Table 3-7 : Bus Speed Mode Option / Mandatory .......................................................................................... 18
Table 3-8 : UHS-II Host and Card Combinations ........................................................................................... 20
Table 3-9 : Bus Speed Modes of UHS-II Card ............................................................................................... 22
Table 3-10 : Bus Speed Mode Option / Mandatory ........................................................................................ 23
Table 3-11 : LV Interface Bus Speed Mode Option / Mandatory .................................................................... 25
Table 4-1: Overview of Card States vs. Operation Modes ............................................................................. 26
Table 4-2 : S18R and S18A Combinations ..................................................................................................... 33
Table 4-3 : Tuning Block Pattern .................................................................................................................... 34
Table 4-4 : Read Command Blocklen ............................................................................................................ 38
Table 4-5 : Write Command Blocklen ............................................................................................................. 38
Table 4-6 : Lock Card Data Structure ............................................................................................................. 48
Table 4-7 : CMD42 Ver.1.0 Mode (Non-COP Card) Lock Unlock Function ................................................... 54
Table 4.3.7-1 : PWD Related Lock Unlock Function for COP Card ............................................................... 55
Table 4.3.7-2 : COP Specific Function for COP Card .................................................................................... 56
Table 4-8 : Force Erase Function to the Locked Card (Relation to the Write Protects) ................................ 58
Table 4-9 : Relation between ACMD6 and the Lock/Unlock State ................................................................ 58
Table 4-10 : Version Difference of Lock/Unlock Functions ............................................................................ 59
Table 4.3.7-3 : Type 3 Lock/Unlock Functions Difference .............................................................................. 60
Table 4-11 : Available Functions of CMD6 ..................................................................................................... 65
Table 4-12 : Power Limit and Current Limit of VDD1 and VDD2 ................................................................... 66
Table 4-13 : Status Data Structure ................................................................................................................. 70
Table 4-14 : Data Structure Version ............................................................................................................... 70
Table 4-15 : Status Code of Mode 0 to Supported Function Group .............................................................. 71
Table 4-16 : Status Code of Mode 1 to Supported Function Group .............................................................. 71
Table 4-17 : Status Code of Mode 0 and 1 to Unsupported Function Group ................................................ 71
Table 4-18 : Format of CMD8 ......................................................................................................................... 74
Table 4-19 : Card Operation for CMD8 in SD Mode ...................................................................................... 74
Table 4-20 : Command Format ...................................................................................................................... 81
Table 4-21 : Card Command Classes (CCCs) in SD Mode ........................................................................... 83
Table 4-22 : Command Support Requirements ............................................................................................. 85
Table 4-23 : Basic Commands (class 0) ........................................................................................................ 87
Table 4-24 : Block-Oriented Read Commands (class 2) ............................................................................... 88
Table 4-25 : Block-Oriented Write Commands (class 4) ................................................................................ 89
Table 4-26 : Block Oriented Write Protection Commands (class 6)............................................................... 89
Table 4-27 : Erase Commands (class 5) ........................................................................................................ 89
Table 4-28 : Lock Card (class 7) .................................................................................................................... 90
Table 4-29 : Application-Specific Commands (class 8).................................................................................. 90
Table 4-30 : I/O Mode Commands (class 9) .................................................................................................. 90
Table 4-31 : Application Specific Commands used/reserved by SD Memory Card ....................................... 92
Table 4-32 : Switch Function Commands (class 10) ...................................................................................... 93
Table 4-33 : Function Extension Commands (class 11) ................................................................................. 93
Table 4.7.4-1 : Command Queue Function Commands (class 1).................................................................. 94
Table 4-34 : Difference of SD Commands Definition in UHS-II ..................................................... ................ 95
Table 4-35 : Card State Transition Table ........................................................................................................ 97
Table 4-36 : Response R1 .............................................................................................................................. 98
xv

©Copyright 2001-2017 SD Card Association
Physical Layer Simplified Specification Version 6.00
Table 4-37 : Response R2 .............................................................................................................................. 98
Table 4-38 : Response R3 .............................................................................................................................. 99
Table 4-39 : Response R6 .............................................................................................................................. 99
Table 4-40 : Response R7 ............................................................................................................................ 100
Table 4-41 : Voltage Accepted in R7 ............................................................................................................ 100
Table 4-42 : Card Status............................................................................................................................... 103
Table 4-43 : Card Status Field/Command - Cross Reference ..................................................................... 104
Table 4-44 : SD Status ................................................................................................................................ 106
Table 4-45 : Speed Class Code Field .......................................................................................................... 106
Table 4-46 : Performance Move Field .......................................................................................................... 107
Table 4-47 : AU_SIZE Field .......................................................................................................................... 107
Table 4-48 : Maximum AU size ..................................................................................................................... 107
Table 4-49 : Erase Size Field ....................................................................................................................... 108
Table 4-50 : Erase Timeout Field ................................................................................................................. 108
Table 4-51 : Erase Offset Field ..................................................................................................................... 108
Table 4-52 : UHS_SPEED_GRADE Field .................................................................................................... 109
Table 4-53 : UHS_AU_SIZE Field ................................................................................................................ 109
Table 4-54 : VIDEO_SPEED_CLASS Field ................................................................................................. 109
Table 4-55 : VSC_AU_SIZE Field ................................................................................................................ 110
Table 4-56 : Valid AU Size and SU Size ........................................................................................................ 111
Table 4-57 : SUS_ADDR Field ...................................................................................................................... 111
Table 4.10.2-1 : APP_PERF_CLASS Field ................................................................................................... 111
Table 4.10.2-2 : PERFORMANCE_ENHANCE Field .................................................................................. 112
Table 4.10.2-3 : Command Queue Support Field ........................................................................................ 112
Table 4.10.3-1 : Task Status ......................................................................................................................... 112
Table 4-58 : Timing Diagram Symbols ......................................................................................................... 113
Table 4-59 : Timing Values (Except SDR50, DDR50 and SDR104) ............................................................ 113
Table 4-60 : Timing Values for SDR50, DDR50 and SDR104 Modes ......................................................... 113
Table 4-61 : Measurement Condition of Speed Class (SDSC and SDHC) ................................................. 119
Table 4-62 : Performance Requirements for Each Class (SDSC and SDHC) ............................................ 120
Table 4-63 : Measurement Conditions of Speed Class (SDXC) .................................................................. 123
Table 4-64 : Performance Requirements for Each Class (SDXC) ............................................................... 124
Table 4-65 : Speed Grade Measurement Conditions for UHS-I and UHS-II ............................................... 128
Table 4-66 : Video Speed Class Violating Conditions .................................................................................. 130
Table 4-67 : Busy Time for CMD20 Operations ........................................................................................... 136
Table 4-68 : SD Interface Mode Requirements for Video Speed Classes ................................................... 137
Table 4-69 : Video Speed Class Measurement Conditions ......................................................................... 145
Table 4-70 : Clock Condition for Video Speed Class ................................................................................... 145
Table 4-71 : Power Limit per Interface for Video Speed Class .................................................................... 145
Table 4-72: Clock Condition for Application Performance Class ................................................................. 150
Table 4-73: Power Limit per Interface for Application Performance Class ................................................. 151
Table 4-74 : Command Support list in CQ Mode ......................................................................................... 156
Table 4-75 : CURRENT_STATE for CQ Mode ............................................................................................. 157
Table 5-1 : OCR Register Definition ............................................................................................................. 161
Table 5-2 : The CID Fields ............................................................................................................................ 162
Table 5-3 : CSD Register Structure .............................................................................................................. 163
Table 5-4 : The CSD Register Fields (CSD Version 1.0) ............................................................................. 164
Table 5-5 : TAAC Access Time Definition ..................................................................................................... 165
Table 5-6 : Maximum Data Transfer Rate Definition .................................................................................... 165
Table 5-7 : Supported Card Command Classes .......................................................................................... 166
Table 5-8 : Data Block Length ...................................................................................................................... 166
Table 5-9 : DSR Implementation Code Table ............................................................................................... 167
Table 5-10 : VDD Min. Current Consumption............................................................................................... 167
xvi

©Copyright 2001-2017 SD Card Association
Physical Layer Simplified Specification Version 6.00
Table 5-11 : VDD Max. Current Consumption .............................................................................................. 167
Table 5-12 : Multiply Factor for the Device Size .......................................................................................... 168
Table 5-13 : R2W_FACTOR ......................................................................................................................... 169
Table 5-14 : Data Block Length .................................................................................................................... 169
Table 5-15 : File Formats.............................................................................................................................. 170
Table 5-16 : The CSD Register Fields (CSD Version 2.0) ........................................................................... 171
Table 5-17 : The SCR Fields ........................................................................................................................ 174
Table 5-18 : SCR Register Structure Version............................................................................................... 174
Table 5-19 : Physical Layer Specification Version ....................................................................................... 175
Table 5-20 : CPRM Security Version ............................................................................................................ 177
Table 5-21 : SD Memory Card Supported Bus Widths ................................................................................ 177
Table 5-22 : Extended Security .................................................................................................................... 178
Table 5-23 : Command Support Bits ............................................................................................................ 178
Table 5-24 : Field Definition of Extension Register Set Address ................................................................. 191
Table 5-25 : Function Extension Event Register .......................................................................................... 191
Table 5-26 : Setting Combination of FXE Register Set ................................................................................ 192
Table 5-27 : Standard Function Code Assignment Table ............................................................................. 193
Table 5-28 : Power Management Register Set ............................................................................................ 193
Table 5-29 : General Information of Power Management Function ............................................................. 198
Table 5-30 : Performance Enhancement Register Set ................................................................................ 200
Table 5-31 : General Information of Performance Enhancement Function ................................................. 201
Table 6-1: DSR Register Contents ............................................................................................................... 206
Table 6-2 : Threshold Level for High Voltage ............................................................................................... 206
Table 6-3 : Peak Voltage and Leakage Current ........................................................................................... 206
Table 6-4 : Bus Operating Conditions - Signal Line's Load ......................................................................... 206
Table 7-1 : Command Format ...................................................................................................................... 217
Table 7-2 : Command Classes in SPI Mode ................................................................................................ 218
Table 7-3 : Commands and Arguments ........................................................................................................ 222
Table 7-4 : Application Specific Commands used/reserved by SD Memory Card - SPI Mode ................... 223
Table 7-5 : Card Operation for CMD8 in SPI Mode ..................................................................................... 224
Table 7-6 : SPI Mode Status Bits ................................................................................................................. 230
Table F - 1 : Combination of Codes to Identify a Function Driver ................................................................ 240
xvii

©Copyright 2001-2017 SD Card Association
Physical Layer Simplified Specification Version 6.00
1. General Description
SD Memory Card is a memory card that is specifically designed to meet the security, capacity,
performance, and environment requirements inherent in newly emerging audio and video consumer
electronic devices. The SD Memory Card will include a content protection mechanism that complies with
the security of the SDMI standard and will be faster and capable of higher Memory capacity. The SD
Memory Card security system uses mutual authentication and a "new cipher algorithm" to protect against
illegal usage of the card content. A Non-secure access to the user's own content is also available.
SD memory cards may also support a second security system based on commonly used standards, such
as ISO-7816, which can be used to interface the SD memory card into public networks and other systems
supporting mobile e-commerce and digital signature applications.
In addition to the SD Memory Card, there is the SD I/O (SDIO) Card. The SDIO Card specification is
defined in a separate specification named: "SDIO Card Specification" that can be obtained from the SD
Association. The SDIO Specification defines an SD card that may contain interfaces between various I/O
units and an SD Host. The SDIO card may contain memory storage capability as well as its I/O
functionality. The Memory portion of SDIO card shall be fully compatible to the given Physical Layer
Specification. The SDIO card is based on and compatible with the SD Memory card. This compatibility
includes mechanical, electrical, power, signalling, and software. The intent of the SD I/O card is to provide
high-speed data I/O with low power consumption for mobile electronic devices. A primary goal is that an
I/O card inserted into a non-SDIO aware host will cause no physical damage or disruption of that device
or its software. In this case, the I/O card should simply be ignored. Once inserted into an SDIO aware
host, the detection of the card will be via the normal means described in the given Physical Layer
Specification with some extensions that are described in the SDIO Specification.
The SD Memory Card communication is based on an advanced 9-pin interface (Clock, Command, 4xData
and 3xPower lines) designed to operate in at maximum operating frequency of 208 MHz and low voltage
range. The communication protocol is defined as a part of this specification.
The SD Specifications are divided into several documents. The SD Specifications documentation
structure is given in Figure 1-1.
Application Specifications
Part 4 Audio Part 8 Video Other Applications
Part 2 File System
Part 1 Physical Layer Part A1 Part E1 SDIO
Part 3 Security
UHS-II Addendum Advanced
Mechanical Addenda Security SD
eSD Addendum (Embedded) Extension
Figure 1-1 : SD Specifications Documentation Structure
• Audio Specification:
This specification, along with other application specifications, describes the specification of a specific
application (in this case - Audio Application) and the requirements to implement it.
• File System Specification:
The specification describes the specification of the file format structure of the data saved in the SD
Memory Card (in User Area and Protected Area).
• Security Specification:
1

©Copyright 2001-2017 SD Card Association
Physical Layer Simplified Specification Version 6.00
The specification describes the content protection mechanism and the application-specific commands
that support it.
• Physical Layer Specification (this document):
The specification describes the physical interface and the command protocol used by the SD Memory
Card. The purpose of the Physical Layer specification is to define the SD Memory Card, its environment,
and handling.
The document is divided into several portions. Chapter 3 gives a general overview of the system
concepts. The common SD Memory Card characteristics are described in Chapter 4. As this description
defines an overall set of card properties, we recommend using the product documentation in parallel. The
card registers are described in Chapter 5.
Chapter 6 defines the electrical parameters of the SD Memory Card's hardware interface.
Mechanical Specification described in Chapter 8 in Version 2.00 is moved to the Standard Size
Mechanical Addendum.
There are three mechanical addenda depend on form factors.
(1) Standard Size Mechanical Addendum
(2) miniSD Mechanical Addendum
(3) microSD Mechanical Addendum
UHS-II Interface Specification is defined by the UHS-II Addendum.
Un-removable memory device for embedded application is defined by the eSD Addendum.
As used in this document, "shall" or "will" denote a mandatory provision of the standard. "Should" denotes
a provision that is recommended but is not mandatory. "May" denotes a feature, which may or may not
be present–at the option of the implementer–and whose presence does not preclude compliance.
• Mc-EX Interface Specification: (This section was added in version 1.10)
Part A1 of the SD memory card specification (Refer to Figure 1-1) serves as an extension to the SD card
Physical Layer Specification and provides all of the definitions required to transfer the Mobile Commerce
Extension (Mc-EX) command packets from the Mc-EX host to the Mc-EX enabled SD memory card, and
vice versa.
• SDIO Specification
SDIO card and embedded SDIO are specified based on the Physical Layer Specification and
modifications and extensions are described in the Part E1 SDIO Specification.
2

©Copyright 2001-2017 SD Card Association
Physical Layer Simplified Specification Version 6.00
2. System Features
 Targeted for portable and stationary applications
 Capacity of Memory
(1) Standard Capacity SD Memory Card (SDSC): Up to and including 2 GB
(2) High Capacity SD Memory Card (SDHC): More than 2GB and up to and including 32GB
(3) Extended Capacity SD Memory Card (SDXC): More than 32GB and up to and including 2TB
 Voltage range:
High Voltage SD Memory Card – Operating voltage range: 2.7-3.6 V
UHS-II SD Memory Card – Operating voltage range VDD1: 2.7-3.6 V, VDD2: 1.70-1.95V
 Designed for read-only and read/write cards.
 Bus Speed Mode (using 4 parallel data lines)
(1) Default Speed mode: 3.3V signaling, Frequency up to 25 MHz, up to 12.5 MB/sec
(2) High Speed mode: 3.3V signaling, Frequency up to 50 MHz, up to 25 MB/sec
(3) SDR12: UHS-I 1.8V signaling, Frequency up to 25 MHz, up to 12.5MB/sec
(4) SDR25: UHS-I 1.8V signaling, Frequency up to 50 MHz, up to 25MB/sec
(5) SDR50: UHS-I 1.8V signaling, Frequency up to 100 MHz, up to 50MB/sec
(6) SDR104: UHS-I 1.8V signaling, Frequency up to 208 MHz, up to 104MB/sec
(7) DDR50: UHS-I 1.8V signaling, Frequency up to 50 MHz, sampled on both clock edges, up to
50MB/sec
(8) UHS156: UHS-II RCLK Frequency Range 26MHz - 52MHz, up to 1.56Gbps per lane.
(9) UHS624: UHS-II RCLK Frequency Range 26MHz- 52MHz, up to 6.24Gbps per lane.
 Switch function command supports Bus Speed Mode, Command System, Drive Strength, and future
functions
 Correction of memory field errors
 Card removal during read operation will never harm the content
 Content Protection Mechanism - Complies with highest security of SDMI standard.
 Password Protection of cards (CMD42 - LOCK_UNLOCK)
 Write Protect feature using mechanical switch
 Built-in write protection features (permanent and temporary)
 Card Detection (Insertion/Removal)
 Application specific commands
 Comfortable erase mechanism
3

©Copyright 2001-2017 SD Card Association
Physical Layer Simplified Specification Version 6.00
 Protocol attributes of the communication channel:
SD Memory Card Communication Channel
Six-wire communication channel
(clock, command, 4 data lines)
Error-protected data transfer
Single or Multiple block oriented data transfer
 SD Memory Card Form-factor
There are three Part 1 mechanical addenda as follows:
Standard Size SD Memory Card: Specified in "Part 1 Standard Size SD Card Addendum"
miniSD Memory Card: Specified in "Part 1 miniSD Card Addendum"
microSD Memory Card: Specified in "Part 1 microSD Card Addendum"
 Standard Size SD Memory Card thickness is defined as both 2.1 mm (normal) and 1.4 mm (Thin
SD Memory Card).
4

©Copyright 2001-2017 SD Card Association
Physical Layer Simplified Specification Version 6.00
3. SD Memory Card System Concept
Description here is a blank in the Simplified Specification.
3.1 Read-Write Property
In terms of read-write property, two types of SD Memory Cards are defined:
 Read/Write (RW) cards (Flash, One Time Programmable - OTP, Multiple Time Programmable - MTP).
These cards are typically sold as blank (empty) media and are used for mass data storage, end user
video, audio or digital image recording
 Read Only Memory (ROM) cards. These cards are manufactured with fixed data content. They are
typically used as a distribution media for software, audio, video etc.
3.2 Supply Voltage
In terms of operating supply voltage, two types of SD Memory Cards are defined:
 High Voltage SD Memory Cards that can operate the voltage range of 2.7-3.6 V.
 UHS-II SD Memory Card that can operate the voltage ranges VDD1: 2.7-3.6 V, VDD2: 1.70-1.95V
 Low Voltage Signaling (LVS) Cards that can operate the supply voltage range of 2.7-3.6V, but signaling
voltage range is 1.70-1.95V.
3.3 Card Capacity
3.3.1 User Area and Protected Area
SD Memory Card has two accessible independent areas: User Area and Protected Area. User Area is
main memory area and Protected Area can be accessed by the authentication defined by the Part 3
Security Specification. Card Capacity means the sum of User Area Capacity and Protected Area Capacity.
3.3.2 Card Capacity Classification
In terms of card capacity, three types of SD Memory Cards are defined:
 Standard Capacity SD Memory Card (SDSC) supports capacity up to and including 2 G bytes (231
bytes). All versions of the Physical Layer Specifications define the Standard Capacity SD Memory Card.
 High Capacity SD Memory Card (SDHC) supports capacity more than 2 G bytes (231 bytes) up to 32
G bytes and is defined from the Physical Layer Specification Version 2.00.
 Extended Capacity SD Memory Card (SDXC) supports more than 32 G bytes (235 bytes) up to 2TB.
Note:
1. The Part 1 Physical Layer Specification Version 3.00 or later and Part 2 File System Specification
Version 3.00 or later allow Standard Capacity SD Memory Cards to have capacity up to and including 2
GB, High Capacity SD Memory Cards to have capacity up to and including 32 GB and Extended
Capacity SD Memory Card to have capacity up to 2 TB.
2. Hosts that can access (read and/or write) SD Memory Cards with a capacity greater than 2 GB and up
to and including 32 GB, shall also be able to access SD Memory Cards with a capacity of 2 GB or less.
3. Hosts that can access (read and/or write) SD Memory Cards with a capacity greater than 32 GB and up
to 2 TB, shall also be able to access SD Memory Cards with a capacity of 32 GB or less.
3.4 Speed Class
Five Speed Classes are defined and indicate minimum performance of the cards
 Class 0 - These class cards do not specify performance. It includes all the legacy card s prior to the
Physical Layer Specification Version 2.00, regardless of its performance
 Class 2 is more than or equal to 2 MB/sec performance (Default Speed Mode)
5

©Copyright 2001-2017 SD Card Association
Physical Layer Simplified Specification Version 6.00
 Class 4 is more than or equal to 4 MB/sec performance (Default Speed Mode)
 Class 6 is more than or equal to 6 MB/sec performance (Default Speed Mode)
 Class 10 is more than or equal to 10 MB/sec performance (High Speed Mode)
Note that the unit of performance [MB/sec] indicates 1000x1000 [Byte/sec] while the unit of data size
[MB] indicates 1024x1024 [Byte]. This is because the maximum SD Bus speed is specified by the
maximum SD clock frequency (25 [MB/sec] = 25000000 [Byte/sec] at 50 MHz) and data size is based on
memory boundary (power of 2).
3.5 Bus Topology
This section is a blank in the Simplified Specification
Figure 3-1 : SD Memory Card System Bus Topology
Figure 3-2 : SD Memory Card System (SPI Mode) Bus Topology
Figure 3-3 : UHS-II Bus Topologies
6

©Copyright 2001-2017 SD Card Association
  Physical Layer Simplified Specification Version 6.00
3.6 Bus Protocol

3.6.1 SD Bus Protocol
Communication over the SD bus is based on command and data bit streams that are initiated by a start
bit and terminated by a stop bit.
  Command: a command is a token that starts an operation. A command is sent from the host either
to a single card (addressed command) or to all connected cards (broadcast command). A command
is transferred serially on the CMD line.
  Response: a response is a token that is sent from an addressed card, or (synchronously) from all
connected cards, to the host as an answer to a previously received command. A response is
transferred serially on the CMD line.
  Data: data can be transferred from the card to the host or vice versa. Data is transferred via the data
lines.
| | from  | | from  | | from  | | |
| --- | ----- | --- | ----- | --- | ----- | --- | --- |
host
| | | | host | | card | | |
| --- | --- | --- | --- | --- | --- | --- | --- |
| | to card(s) | | to card | | to host | | |
| CMD | command | | command | response | | | |
DAT
| | operation (no response) | | operation (no data) | | | | |
| --- | --- | --- | --- | --- | --- | --- | --- |

Figure 3-4 : "no response" and "no data" Operations

Card addressing is implemented using a session address, assigned to the card during the initialization
phase. The structure of commands, responses and data blocks is described in Chapter 4. The basic
transaction on the SD bus is the command/response transaction (refer to Figure 3-4). This type of bus
transaction transfers their information directly within the command or response structure. In addition,
some operations have a data token.
Data transfers to/from the SD Memory Card are done in blocks. Data blocks are always succeeded by
CRC bits. Single and multiple block operations are defined. Note that the Multiple Block operation mode
is better for faster write operation. A multiple block transmission is terminated when a stop command
follows on the CMD line. Data transfer can be configured by the host to use single or multiple data lines.
| | from  | from  | data from card  | | | stop command  | |
| --- | ----- | ----- | --- | --- | --- | --- | --- |
stops data transfer
| | host | card |  to host | | | | |
| --- | --- | --- | --- | --- | --- | --- | --- |
| | to card | to host | | | | | |
| CMD | | | | | command | | response |
| | command response | | | | | | |
| DAT | | data block | crc data block | crc | data block | crc | |
block read operation  data stop operation
multiple block read operation

Figure 3-5 : (Multiple) Block Read Operation

The block write operation uses a simple busy signaling of the write operation duration on the DAT0 data
line (see Figure 3-6) regardless of the number of data lines used for transferring the data.

7

©Copyright 2001-2017 SD Card Association
  Physical Layer Simplified Specification Version 6.00
crc ok
response
| from | | from | | data from  | and busy  | | | stop command  |
| --- | --- | --- | --- | --- | --- | --- | --- | --- |
| | | | | | from | | stops data trans- | |
| host | | card | | host | | | | |
| to card | | to host | |  to card | card | | | fer |
 to host
| | | | | | | | command | response |
| --- | --- | --- | --- | --- | --- | --- | --- | --- |
| CMD command | response | | | | | | | |
| | | | data block | crc busy | data block | | crc | busy |
DAT
| block write operation  | | | | | | | data stop operation | |
| --- | --- | --- | --- | --- | --- | --- | --- | --- |
multiple block write operation

Figure 3-6 : (Multiple) Block Write Operation

Command tokens have the following coding scheme:
transmitter bit:
'1'= host command
Command content: command and address information
or parameter, protected by 7 bit CRC checksum
| start bit: | | | | | | | | end bit: |
| --- | --- | --- | --- | --- | --- | --- | --- | --- |
always '1'
always'0'
| | 0 | 1 | CONTENT | | CRC | | 1 | |
| --- | --- | --- | --- | --- | --- | --- | --- | --- |
total length=48 bits

Figure 3-7 : Command Token Format

Each command token is preceded by a start bit (0) and succeeded by an end bit (1). The total length is
48 bits. Each token is protected by CRC bits so that transmission errors can be detected and the operation
may be repeated.
Response tokens have one of four coding schemes, depending on their content. The token length is
either 48 or 136 bits. The detailed commands and response definition is given in Section 4.7. The CRC
protection algorithm for block data is a 16-bit CCITT polynomial. All allowed CRC types are described in
Section 4.5.
transmitter bit:
| '0'=card response | | | Response content: mirrored command and status infor- | | | | | |
| --- | --- | --- | --- | --- | --- | --- | --- | --- |
mation (R1 response), OCR register (R3 response) or
RCA (R6), protected by a 7bit CRC checksum
end bit:
start bit: always '1'
always'0'
| | 0 | 0 | | CONTENT | | 1 | | |
| --- | --- | --- | --- | --- | --- | --- | --- | --- |
R1, R3,R6
| | | | total length=48 bits | | | | | end bit: |
| --- | --- | --- | --- | --- | --- | --- | --- | --- |
always '1'
R2
| | 0 | 0 | CONTENT=CID or CSD | | | | CRC | 1 |
| --- | --- | --- | --- | --- | --- | --- | --- | --- |
total length=136 bits

Figure 3-8 : Response Token Format

In the CMD line the Most Significant Bit (MSB) is transmitted first, the Least Significant Bit (LSB) is the
last.
When the wide bus option is used, the data is transferred 4 bits at a time (refer to Figure 3-10). Start and
end bits, as well as the CRC bits, are transmitted for every one of the DAT lines. CRC bits are calculated
and checked for every DAT line individually. The CRC status response and Busy indication will be sent
by the card to the host on DAT0 only (DAT1-DAT3 during that period are don't care).

| | | | | | | | | |
| --- | --- | --- | --- | --- | --- | --- | --- | --- |

8

©Copyright 2001-2017 SD Card Association
  Physical Layer Simplified Specification Version 6.00
There are two types of Data packet format for the SD card.
(1) Usual data (8-bit width): The usual data (8-bit width) are sent in LSB (Least Significant Byte) first,
MSB (Most Significant Byte) last sequence. But in the individual byte, it is MSB (Most Significant Bit)
first, LSB (Least Significant Bit) last.
(2) Wide width data (SD Memory Register): The wide width data is shifted from the MSB bit.

1. Data Packet Format for Usual Data (8-bit width)
| b7 b0 | | | | | | | | End  |
| ----- | --- | --- | --- | --- | --- | --- | --- | ---- |
Start bit
bit
1st Byte
2nd Byte
| | | 00  | 1s t  B y te | 2n d  B | yte 3r d  B | yte ... | n t h  B yte CRC | 11  |
| --- | ---- | --- | --- | --- | --- | --- | --- | --- |
| 3rd  Byte | DAT0 | | | | | | | |
| . | | | D a t a | D a | ta D a | ta | D a ta | |
.
| | | b7  | b6 b5 | b4 b3 b2 | b1 b0 | b7 b6 b5 | b4 b3 b2 b1 | b0  |
| --- | --- | --- | ----- | --- | ----- | --- | --- | --- |
.
n th Byte Data Packet Format for Standard Bus (only DAT0 used)
8bit width Data
| | | | 1st Byte | | 3rd Byte | n th Byte | End  | |
| --- | --- | --- | --- | --- | --- | --- | ---- | --- |
| | Start bit | | | 2nd Byte | | | | |
| | | | Data | Data | Data | Data | bit  | |
Ex
.
| [SDIO] | | | | | ... | | | |
| --- | ---- | --- | ----- | ----- | ----- | --- | --- | --- |
| CMD53  | DAT3 | 00  | b7 b3 | b7 b3 | b7 b3 | b7 b3 CRC | 11  | |
[SD memory]
| CMD17, CMD18,  | | | | | ... | | | |
| --- | ---- | --- | ----- | ----- | ----- | --- | --- | --- |
| CMD24, CMD25,  | DAT2 | 00  | b6 b2 | b6 b2 | b6 b2 | b6 b2 CRC | 11  | |
ACMD18, ACMD25,
...
etc
| | DAT1 | 00  | b5 b1 | b5 b1 | b5 b1 | b5 b1 CRC | 11  | |
| --- | ---- | --- | ----- | ----- | ----- | --- | --- | --- |
...
| | DAT0 | 00  | b4 b0 | b4 b0 | b4 b0 | b4 b0 CRC | 11  | |
| --- | ---- | --- | ----- | ----- | ----- | --- | --- | --- |
Data Packet Format for Wide Bus (all four lines used)

Figure 3-9 : Data Packet Format - Usual Data

9

©Copyright 2001-2017 SD Card Association
Physical Layer Simplified Specification Version 6.00
2. Data Packet Format for Wide Width Data (Ex. ACMD13)
b511 b0
Ex. SD Status
Start bit End bit
Wide Width
Data ...
DAT0 0 b511 b510 b509 b508 b1 b0 CRC 1
Ex.
[SD memory]
Data Packet Format for Standard Bus (only DAT0 used)
ACMD13(SD Status),
ACMD51(SCR),
etc
End bit
Start bit
...
DAT3 0 b511 b507 b503 b499 b7 b3 CRC 1
...
DAT2 0 b510 b506 b502 b498 b6 b2 CRC 1
...
DAT1 0 b509 b505 b501 b497 b5 b1 CRC 1
...
DAT0 0 b508 b504 b500 b496 b4 b0 CRC 1
Data Packet Format for Wide Bus (all four lines used)
Figure 3-10 : Data Packet Format - Wide Width Data
3.6.2 SPI Bus Protocol
Details of the SPI Bus protocol are described in Chapter 7.
3.6.3 UHS-II Bus Protocol
UHS-II Bus protocol is defined in the UHS-II Addendum.
10

©Copyright 2001-2017 SD Card Association
Physical Layer Simplified Specification Version 6.00
3.7 SD Memory Card–Pins and Registers
3.7.1 SD Bus Pin Assignment
The SD Memory Card has the form factor 24 mm x 32 mm x 2.1 mm or 24 mm x 32 mm x 1.4 mm.
12345678
9
wp
SD Memory
Card
Figure 3-11 : SD Memory Card Shape and Interface (Top View)
Figure 3-11 shows the general shape of Standard Size and interface contacts of the SD Memory Card.
The detailed physical dimensions and mechanical description are given in Part 1 Mechanical Addenda.
Table 3-1 defines the card contacts:
Pin # SD Mode SPI Mode
Name Type1 Description Name Type1 Description
1 CD/DAT32 I/O/PP3 Card Detect/ CS I3 Chip Select (neg true)
Data Line [Bit 3]
2 CMD I/O/PP Command/Response DI I Data In
3 VSS1 S Supply voltage ground VSS S Supply voltage ground
4 VDD S Supply voltage VDD S Supply voltage
5 CLK I Clock SCLK I Clock
6 VSS2 S Supply voltage ground VSS2 S Supply voltage ground
7 DAT0 I/O/PP Data Line [Bit 0] DO O/PP Data Out
8 DAT14 I/O/PP Data Line [Bit 1] RSV
9 DAT25 I/O/PP Data Line [Bit 2] RSV
1) S: power supply; I: input; O: output using push-pull drivers; PP: I/O using push-pull drivers;
2) The extended DAT lines (DAT1-DAT3) are input on power up. They start to operate as DAT lines after SET_BUS_WIDTH
command. The Host shall keep its own DAT1-DAT3 lines in input mode, as well, while they are not used.
3) At power up this line has a 50KOhm pull up enabled in the card. This resistor serves two functions Card detection and
Mode Selection. For Mode Selection, the host can drive the line high or let it be pulled high to select SD mode. If the host
wants to select SPI mode it should drive the line low. For Card detection, the host detects that the line is pulled high. This
pull-up should be disconnected by the user, during regular data transfer, with SET_CLR_CARD_DETECT (ACMD42)
command
4) DAT1 line may be used as Interrupt Output (from the Card) in SDIO mode during all the times that it is not in use for
data transfer operations (refer to "SDIO Card Specification" for further details).
5) DAT2 line may be used as Read Wait signal in SDIO mode (refer to "SDIO Card Specification" for further details).
Table 3-1 : SD Memory Card Pad Assignment
11

©Copyright 2001-2017 SD Card Association
Physical Layer Simplified Specification Version 6.00
Each card has a set of information registers (see also Chapter 5 in the Physical Layer Specification):
Name Width Description
CID 128 Card identification number; card individual number for identification (See 5.2).
Mandatory.
RCA1 16 Relative card address; local system address of a card, dynamically suggested by the
card and approved by the host during initialization (See 5.4). Mandatory.
DSR 16 Driver Stage Register; to configure the card's output drivers (See 5.5). Optional.
CSD 128 Card Specific Data; information about the card operation conditions (See 5.3).
Mandatory
SCR 64 SD Configuration Register; information about the SD Memory Card's Special Fea-
tures capabilities (See 5.6). Mandatory
OCR 32 Operation conditions register (See 5.1). Mandatory.
SSR 512 SD Status; information about the card proprietary features (See 4.10.2).
Mandatory
CSR 32 Card Status; information about the card status (See 4.10.1). Mandatory
(1) RCA register is not used (available) in SPI mode
Table 3-2 : SD Memory Card Registers
The host may reset the cards by switching the power supply off and on again. Each card shall have its
own power-on detection circuitry that puts the card into a defined state after the power-on. No explicit
reset signal is necessary. The cards can also be reset by sending the GO_IDLE (CMD0) command.
CMD CLK DAT0
CID[127:0]
RCA[15:0] Card
interface
DSR[15:0] controller
CSD[127:0]
Memory core interface
Memory core
12
noitceted
no
rewoP
V
DD
DAT2
CD/DAT3 Interface driver DAT1
OCR[31:0]
reset
SCR[63:0]
SSR[511:0]
CSR[31:0]
reset
Figure 3-12 : SD Memory Card Architecture

©Copyright 2001-2017 SD Card Association
Physical Layer Simplified Specification Version 6.00
3.7.2 UHS-II Pin Assignment
UHS-II Card shape is the same as SD Cards and UHS-II Interface is assigned to pads on the second
row.
11 22 33 44 55 66 77 88
99
1100 11111122 1133 1144 11551166 1177
SSDD MMeemmoorryy CCaarrdd
Figure 3-13 : UHS-II Card Shape and Interface (Top View)
Figure 3-13 shows the shape of Standard Size and interface contacts of the UHS-II SD Memory Card.
The detailed physical dimensions and mechanical description are given in Part 1 Mechanical Addenda.
Table 3-3 defines the contacts for UHS-II. SD bus contacts 7 and 8 Pins are used for RCLK. The first row
contacts in non UHS-II mode are equivalent to Table 3-1. Regarding PHY I/O Type, refer to the UHS-II
Addendum for more details.
Pin # Name Type Description
4 VDD1 Supply voltage 2.7V to 3.6V
7 RCLK+ Differential Signaling: Input Clock Input
8 RCLK- Differential Signaling: Input Clock Input
10 VSS3 Ground
11 D0+ Differential Signaling: Input (FD) / Bidirectional (HD) Input in default
12 D0- Differential Signaling: Input (FD) / Bidirectional (HD) Input in default
13 VSS4 Ground
14 VDD2 Supply Voltage 2 1.70V to 1.95V
15 D1- Differential Signaling: Output (FD) / Bidirectional (HD) Output in default
16 D1+ Differential Signaling: Output (FD) / Bidirectional (HD) Output in default
17 VSS5 Ground
Table 3-3 : UHS-II Interface Pad Assignment
UHS-II Card shall not drive unused lines of SD I/F in UHS-II mode. (CLK, CMD and DAT[3:2]. DAT[2]
may be used as interrupt line in case of UHS-II SDIO Card. In this case, card controls DAT[2] level.)
Host shall not leave these unused lines floating, but keep them at a defined high or low level. How to
keep line level is dependent on host implementation. For example, use pull-up resistor or host drives the
lines to low level without providing pull-up voltage. As DAT[1:0] are used for providing RCLK, individual
line control is required to use pull-up method for CMD and DAT[3:2]. CLK (without pull-up resistor) should
be driven to low.
In case of entering hibernate mode, unused lines shall be set to low before turning off VDD1.
13

©Copyright 2001-2017 SD Card Association
Physical Layer Simplified Specification Version 6.00
3.8 ROM Card
ROM Card is defined as read only memory which meets following requirements. A permanent or
temporary write protected writable SD memory card does not belong to this category.
3.8.1 Register Setting Requirements
Table 3-4 shows register setting requirements for ROM Card.
Register Field Value Comment
SD Status SD_CARD_TYPE 0001h SD ROM Card
CCC bit 4 0 Class4 block write
CSD CCC bit 5 0 Class5 erase
CCC bit 6 0 Class6 write protection
CCC bit 7 0 or 1 Class7 lock card
PERM_WRITE_PROT 1 Permanent Write Protect
SCR SD_SECURITY 0 or 2 or 3 or 4 Security is optional.
Table 3-4 : Register Setting Requirements for ROM Card
3.8.2 Unsupported Commands
The ROM Card shall treat following commands as unsupported and illegal command.
CMD24, CMD25, CMD27, CMD28, CMD29, CMD30, CMD32, CMD33, CMD38
3.8.3 Optional Commands
The ROM Card can support following commands as optional command.
CMD42, security commands
 If CMD42 is not supported, bit 7 of CCC shall be set to 0. CMD42 is treated as illegal command.
 When ROM card supports CMD42, "Unlocking the card" and "Locking the card" functions shall be
supported by presetting the password. LOCK_UNLOCK_FAILED is indicated when receiving the
other unsupported functions of CMD42.
 If security is not supported, SD_SECURITY shall be set to 0. The security commands are treated as
illegal command.
 ROM card does not support write and erase to the protected area. Refer to the Part 3 Security
Specification about security command support of ROM card.
3.8.4 WP Switch
A full-size ROM card does not have WP Switch.
14

©Copyright 2001-2017 SD Card Association
Physical Layer Simplified Specification Version 6.00
3.9 Ultra High Speed Phase I (UHS-I) Card
UHS-I provides up to 104MB/sec performance on 4-bit SD bus with the single end driver interface. Card
form factor is the same and existing connector can be used.
3.9.1 UHS-I Card Operation Modes
 DS - Default Speed up to 25MHz 3.3V signaling
 HS - High Speed up to 50MHz 3.3V signaling
 SDR12 - SDR up to 25MHz 1.8V signaling
 SDR25 - SDR up to 50MHz 1.8V signaling
 SDR50 - SDR up to 100MHz 1.8V signaling
 SDR104 - SDR up to 208MHz 1.8V signaling
 DDR50 - DDR up to 50MHz 1.8V signaling
Note: 1.8V signal timings are different from those of 3.3V.
3.9.2 UHS-I Card Types
UHS-I supports two card Types:
 UHS50
 UHS104
UHS-I is not applied to SDSC card but can be applied to SDHC and SDXC card.
Figure 3-14 and Figure 3-15 show UHS-I supported modes.
DDR50 is mandatory for microSD form factor and optional for Standard size SD form factor
DS DS: Default Speed Mode
HS HS: High Speed Mode
UHS50Card SDR12
SDR25 Signal Voltage
SDR50 3.3V 1.8V
DDR50
DS
HS
SDR12
UHS104 Card SDR25
SDR50
SDR104
DDR50
Frequency
25MHz 50MHz 100MHz 208MHz
Figure 3-14 : UHS-I Card Type Modes of Operation versus Frequency Range
15

©Copyright 2001-2017 SD Card Association
  Physical Layer Simplified Specification Version 6.00

| | DS  | | DS: Default Speed Mode | | |
| --- | --- | --- | --- | --- | --- |

HS: High Speed Mode
HS

| UHS50Card | SDR12 | | | | |
| --- | ----- | --- | --- | --- | --- |

| | SDR25 | | | Signal Voltage | |
| --- | ----- | --- | --- | --- | --- |

| | | SDR50 | | 3.3V | 1.8V |
| --- | --- | ----- | --- | ---- | ---- |
| | | DDR50 | | | |

| | DS | | | | |
| --- | ----- | --- | --- | --- | --- |
| | HS | | | | |
| | SDR12 | | | | |
  UHS104 Card
SDR25
| | | SDR50 | | | |
| --- | --- | ----- | --- | --- | --- |

SDR104
| | | DDR50 | | | |
| --- | --- | ----- | --- | --- | --- |

  Throughput
| | 12MB/s | 25MB/s | 50MB/s | | 104MB/s |
| --- | --- | --- | --- | --- | --- |

Figure 3-15 : UHS-I Card Type Modes of Operation versus Throughput

3.9.3 UHS-I Host and Card Combination
Host may use SDR50, DDR50 and SDR104 modes with either UHS50 Card or UHS104 Card.
Table 3-5 shows usable UHS performance depends on the combination of host and card. UHS-I for
removable card is presumed that one card is connected to a SD bus. Maximum performance of up to
104MB/s is possible only if host supports SDR104 mode and card is UHS104 Card (supports SDR104
mode). If card is a UHS50 Card or if host doesn't support SDR104 mode, performance is limited to 50MB/s
(SDR104 mode cannot be used).
Host may use DDR50 mode with UHS50 Card and UHS104 Card in microSD form factors.

Host types:
SDR-FD – SDR signaling, fixed-delay (can't use tuning)
SDR-VD – SDR signaling, variable-delay (can use tuning)
DDR – DDR signaling

Host type
| | HOST-SDR-FD  | | HOST-SDR-VD  | | HOST-DDR  |
| --- | --- | --- | --- | --- | --- |

| | (SDR, fixed-delay)  | | (SDR, variable-delay)  | | (DDR)  |
| --- | --- | --- | --- | --- | --- |
Card type
UHS50 card
| | SDR50 ≤ 100MHz  | | SDR50 ≤ 100MHz + tuning  | | DDR50 ≤ 50MHz  |
| --- | --- | --- | --- | --- | --- |
microSD
UHS104 card  SDR104 ≤ 208MHz +
| | SDR50 ≤ 100MHz  | | | | DDR50 ≤ 50MHz  |
| --- | --- | --- | --- | --- | --- |
microSD  tuning
UHS50 card
| | SDR50 ≤ 100MHz  | | SDR50 ≤ 100MHz + tuning  | | Optional  |
| --- | --- | --- | --- | --- | --- |
Full-size SD
UHS104 card  SDR104 ≤ 208MHz +
| | SDR50 ≤ 100MHz  | | | | Optional  |
| --- | --- | --- | --- | --- | --- |
Full-size SD  tuning
Table 3-5 : UHS-I Host and Card Combinations

16

©Copyright 2001-2017 SD Card Association
Physical Layer Simplified Specification Version 6.00
3.9.4 UHS-I Bus Speed Modes Selection Sequence
Power on
Once signal voltage is switched to 1.8V, the card continues 1.8V signaling
regardless of CMD0. Power cycle resets the signal voltage to 3.3V.
CMD0 After Switching 1.8V singling, the card cannot be changed to SPI mode.
CMD8
Host requests card to change 1.8V signal voltage by ACMD41.
A status is indicated in the response whether voltage switch is accepted.
ACMD41
If voltage switch is accepted by ACMD41, CMD11 invokes voltage switching
sequence. If it is completed, the card enters SDR12 (default).
CMD11
CMD2
CMD3
CMD7
If the CARD_IS_LOCKED status is set to 1 in the response of CMD7,
CMD42 is required before ACMD6 to unlock the card.
CMD42
UHS-I supports only 4-bit mode. Host shall select 4-bit mode by ACMD6.
ACMD6
Driver Strength is selected by CMD6 Function Group 3.
Bus Speed Mode is selected by CMD6 Function Group 1.
CMD6 Current Limit is selected by CMD6 Function Group 4.
CMD19 sends a tuning block to the host to determine sampling point.
CMD19 UHS50 and UHS104 cards support CMD19 in 1.8V signaling. Sampling clock
tuning is required for UHS104 host and optional for UHS50 host.
Figure 3-16 : Command Sequence to Use UHS-I
Figure 3-16 shows command sequence to use a UHS-I. After power cycle, card is in 3.3V signaling mode.
The first CMD0 selects the bus mode; SD mode or SPI mode. 1.8V signaling mode can be entered only
in SD mode. Once the card enters 1.8V signaling mode, the card cannot be switched to SPI mode or
3.3V signaling without power cycle. If the card receives CMD0, card returns to Idle state but still work with
SDR12 timing. UHS-I is provided in SD mode but not in SPI mode.
As higher bus speed requires low level signaling, UHS-I adopts 1.8V signaling level for SDR50, DDR50
and SDR104 modes. Still card is supplied with 3.3V by the host and 1.8V signaling level for SDCLK, CMD
and DAT[3:0] lines is converted from 3.3V power line. To avoid voltage mismatch between host and card,
signaling level is changed by voltage switch sequence at the initialization. The host and card
communicate using ACMD41 whether host and card support 1.8V signaling mode. Support of 1.8V
signaling both host and card means UHS-I can be used. CMD11 invokes the voltage switch sequence.
The card enters UHS-I mode and card input and output timings are changed (SDR12 in default) when
the voltage switch sequence is completed successfully. (Refer to Section 4.2.4 for more detail.)
Only 4-bit bus mode is supported in UHS-I except CMD42. If the card is locked, host needs to unlock the
card by CMD42 in 1-bit mode and then needs to issue ACMD6 to change 4-bit bus mode. Operating in
1-bit mode is not assured.
Host can choose suitable output driver strength by CMD6 Function Group 3.
Host can choose one of UHS-I modes by CMD6 Function Group 1. Each UHS-I mode is specified by the
maximum frequency, sampling edges (rising-only or both) and maximum Power consumption for
compatibility with existing cards. Host can choose one of UHS-I mode depending on capability of
generating SDCLK frequency and capacity of power supply host supported.
CMD19 can be executed in transfer state of 1.8V signaling mode while the card is unlocked. The other
case, CMD19 is treated as illegal command.
17

©Copyright 2001-2017 SD Card Association
  Physical Layer Simplified Specification Version 6.00
3.9.5 UHS-I System Block Diagram
This section is a blank in the Simplified Specification.
Figure 3-17 : Host and Card Block Diagram
3.9.6 Summary of Bus Speed Mode for UHS-I Card
Table 3-6 shows the card requirements regarding Bus Speed modes selected by CMD6 function group
1. The maximum frequency and the maximum power are determined by CMD6.
| | Bus Speed  | Max. Bus  | | Max. Clock  | Signal | | Max. Power*2  | | |
| --- | --- | --- | --- | --- | --- | --- | --- | ---- | --- |
| | Mode*1 | Speed | | Frequency | Voltage  | | | [W]  | |
| | | [MB/s] | | [MHz] | [V] | SDSC*3  | SDHC*4 | | SDXC*5 |
| | SDR104 | 104 | | 208 | 1.8 | - | 2.88*6 | | 2.88*6 |
| | SDR50 | 50 | | 100 | 1.8 | - | 1.44 | | 1.44 |
| | DDR50 | 50 | | 50 | 1.8 | - | 1.44 | | 1.44 |
| | SDR25 | 25 | | 50 | 1.8 | - | 0.72 | | 0.72 |
| | SDR12 | 12.5 | | 25 | 1.8 | - | 0.36 | | 0.36/0.54*7  |
High Speed
| | | 25  | | 50  | 3.3  | 0.72  | 0.72  | | 0.72  |
| --- | --- | --- | --- | --- | ---- | ----- | ----- | --- | ----- |
Default Speed
| | | 12.5  | | 25  | 3.3  | 0.36  | 0.36  | | 0.36/0.54*7  |
| --- | --- | ----- | --- | --- | ---- | ----- | ----- | --- | --- |
*1:  The card supports a UHS-I mode shall support all lower UHS-I modes.
*2:  Host may control power by the Power Limit function in CMD6 (Refer to Section 4.3.10.3).
*3:  SDSC stands for SD Standard Capacity Memory Card and
*4:  SDHC stands for SD High Capacity Memory Card.
*5:  SDXC stands for SD Extended Capacity Memory Card.
*6: The actual maximum current may vary from the limit described in this table. It is limited by the Mechanical
Addenda in the sections that define the thermal profile of the device and the connector profile.
*7:  Host  may  select  either  maximum  power  by  XPC  in  ACMD41  (Refer  to  Section  4.2.3.1).
In SPI mode, XPC is not supported and the power shall be up to 0.36W (100mA at 3.6V on VDD1).
Table 3-6 : Bus Speed Modes of UHS-I Card

DS  - Default Speed up to 25MHz 3.3V signaling
HS  - High Speed up to 50MHz 3.3V signaling
SDR12  - SDR up to 25MHz 1.8V signaling
SDR25  - SDR up to 50MHz 1.8V signaling
SDR50  - SDR up to 100MHz 1.8V signaling
SDR104  - SDR up to 208MHz 1.8V signaling
DDR50  - DDR up to 50MHz 1.8V signaling

Table 3-7 clarifies option / mandatory of bus speed mode for each card capacity type.
| | Card Classification  | | | DS  HS  | SDR50  | SDR104  | | DDR50 | |
| --- | --- | --- | --- | --- | --- | --- | --- | --- | ---- |
| | SDSC | | | M  O | N/A | N/A | | | N/A  |
| | | Non UHS-I  | | M  O | N/A | N/A | | | N/A  |
| | | UHS50 | | M  M | M | N/A | O (Standard SD)  | | |
| | SDHC | | | | | | | M (microSD)  | |
| | | UHS104 | | M  M | M | M | O (Standard SD)  | | |

M (microSD)
| | | Non UHS-I  | | M  O  | N/A  | N/A  | | | N/A  |
| --- | ----- | --- | --- | ----- | ---- | ---- | --- | --- | ---- |
| | | UHS50 | | M  M  | M | N/A  | O (Standard SD)  | | |
| | SDXC  | | | | | | | M (microSD)  | |
| | | UHS104 | | M  M  | M | M | O (Standard SD)  | | |

M (microSD)
| | M: Mandatory, | | O: Optional, | | N/A: Not Available  | | | | |
| --- | --- | --- | --- | --- | --- | --- | --- | --- | --- |
Table 3-7 : Bus Speed Mode Option / Mandatory

18

©Copyright 2001-2017 SD Card Association
Physical Layer Simplified Specification Version 6.00
3.10 Ultra High Speed Phase II (UHS-II) Card
3.10.1 UHS-II Card Operation Modes
SD Bus Interface Modes
 DS - Default Speed up to 25MHz 3.3V signaling
 HS - High Speed up to 50MHz 3.3V signaling
 SDR12 - SDR up to 25MHz 1.8V signaling
 SDR25 - SDR up to 50MHz 1.8V signaling
 SDR50 - SDR up to 100MHz 1.8V signaling
 SDR104 - SDR up to 208MHz 1.8V signaling (Optional)
 DDR50 - DDR up to 50MHz 1.8V signaling (Optional for Standard Size Card)
UHS-II Interface Modes
 FD156 - Full Duplex mode up to 156MB/s at 52MHz in Range B
 HD312 - Half Duplex with 2 Lanes mode up to 312MB/s at 52MHz in Range B (Optional)
 FD312 - Full Duplex mode up to 312MB/s at 52MHz in Range C
 FD624 - Full Duplex mode up to 624MB/s at 52MHz in Range D
3.10.2 UHS-II Card Type
UHS-II supports two card Type
The performance of UHS-II card is indicated based on in Full Duplex mode because HD312 is optional.
 UHS156: UHS-II Card with data rate up to 1.56Gbps in FD156 mode and up to 312Gbps in HD312
mode (Optional).
 UHS624: UHS-II Card with data rate up to 6.24Gbps in FD624 mode
Figure 3-18 : Interface Speed of UHS-II Card (UHS156 and UHS624)
19

©Copyright 2001-2017 SD Card Association
  Physical Layer Simplified Specification Version 6.00
3.10.3 UHS-II Host and Card Combination

Host type  UHS-II
| | | UHS-II | UHS-II | UHS-II |
| --- | --- | --- | --- | --- |
  HD312 and FD624
| | | FD156 only  | HD312 supported  | FD624 only  |
| --- | --- | --- | --- | --- |
Card type  supported
UHS156
up to 1.56Gbps  up to 1.56Gbps  up to 1.56Gbps  up to 1.56Gbps
(HD312 not supported)
UHS156
up to 1.56Gbps  up to 3.12Gbps  up to 1.56Gbps  up to 3.12Gbps
(HD312 supported)
UHS624
up to 1.56Gbps  up to 1.56Gbps  up to 6.24Gbps  up to 6.24Gbps
(HD312 not supported)
UHS624
up to 1.56Gbps  up to 3.12Gbps  up to 6.24Gbps  up to 6.24Gbps
(HD312 supported)
Note: HD312 cannot be used in Ring Topology
Table 3-8 : UHS-II Host and Card Combinations

3.10.4 UHS-II Interface Selection Sequence
UHS-II supported host shall support Legacy SD Bus Interface (I/F) and UHS-II I/F. Removable UHS-II
card slot shall be connected to both I/Fs. Then UHS-II card may be initialized not only in UHS-II mode
but also in SD Bus I/F mode.
Figure 3-19 shows how to select UHS-II mode. After power up, SD bus I/F and UHS-II I/F of UHS-II card
are enabled. UHS-II supported host provides RCLK and STB.L to D0 lane. Host waits D1 lane to change
EIDL to STB.L. If STB.L is detected on D1 lane, host starts UHS-II initialization. If D1 lane is not changed
to STB.L by 200us timeout, host should initialize the card in SD Bus I/F mode. As 200us for STB.L
detection is defined as per card, host needs to determine total timeout value that depends on UHS-II bus
topology of a system.

V
| | UHS-II  | DD1  | UHS-II | |
| --- | --- | ---- | --- | --- |
| | Host | | C a r d | |
| | | V | | P o w e r U p |
| | | DD2  | (D e v ic e) | Supp ly  V D D 1,  VDD2 |
| | | RCLK | | |

| | | D0 = STB.L | | Host supplies RCLK and |
| --- | --- | --- | --- | --- |

set STB.L on D0
D1

200us Timeout
| | EIDL to STB.L | | | Host waits D1=STB.L |
| --- | --- | --- | --- | --- |

D1=STB.L

| | | SD I/F Initialization | | UHS-II Initialization |
| --- | --- | --- | --- | --- |

  Legacy SD Card SSDD  II//FF  iiss  sseelleecctteedd UUHHSS--IIII  II//FF  iiss  sseelleecctteedd

| | | SD | UUUHHHSSS---IIIIII SSSDDD | UUUHHHSSS---IIIIII SSSDDD |
| --- | --- | --- | --- | --- |
| | | I/F | III///FFF III///FFF | III///FFF III///FFF |
| | | | SSSEEELLL | SSSEEELLL |
| | | | | BBBEEE |
| | | BE | BBBEEE | |
| | | Card Controller | CCCaaarrrddd CCCooonnntttrrrooolllllleeerrr | CCCaaarrrddd CCCooonnntttrrrooolllllleeerrr |

Figure 3-19 : UHS-II Interface Detection

Figure 3-20 shows abstract of UHS-II Initialization sequence. The first step is PHY initializ ation. PLL is
activated and synchronized. Before completing PHY Initialization period, SD Bus I/F is disabled. The second
step is Device Initialization. Backend functions of devices are initialized. The third step is Enumeration. 4-bit

20

©Copyright 2001-2017 SD Card Association
Physical Layer Simplified Specification Version 6.00
unique Device ID is assigned to each device to be able to select one of devices by a Device ID. The fourth
step is Configuration. UHS-II register is set to be able to use UHS-II devices in optimized bus sequence. The
fifth step is SD-TRAN Initialization. UHS-II emulates SD Commands by the SD-TRAN. SD-TRAN Initialization
is equivalent to SD Bus Initialization but host issues SD Commands in UHS-II packets. UHS-II card accepts
most SD commands except some specific commands. Refer to Section 4.7.5 about the difference of SD
command definition in UHS-II. If CMD0 is received, the UHS-II card re-starts from SD-TRAN initialization.
Figure 3-21 shows SD Bus I/F Initialization sequence for UHS-II Card. UHS-II card shall disable UHS-II
Interface before execution of ACMD41 is completed. If VDD2 is provided during SD Interface initialization of
UHS-II Card, host shall continue to provide VDD2. VDD2 may be off by power cycle with VDD1 before starting
SD Interface initialization. On detecting non UHS-II card, host may turn off VDD2 anytime.
UHS-II Initialization
UUHHSS--IIII II//FF iiss sseelleecctteedd
PHY Initialization
CM-TRAN
•PLL Activation Initialization
UUUHHHSSS---IIIIII SSSDDD •PLL Synchronization
III///FFF III///FFF •Disabling SD I/F
SSSEEELLL
BBBEEE Device Initialization
CCCaaarrrddd CCCooonnntttrrrooolllllleeerrr
Enumeration
•Set Device ID
Configuration
•Set Parameters
CMD0
(SD-TRAN)
Initialization for SD-TRAN SD-TRAN
card identification mode
CMD8
ACMD41
CMD2
CMD3
SD-TRAN data transfer mode
Figure 3-20 : UHS-II Interface Initialization
21

©Copyright 2001-2017 SD Card Association
Physical Layer Simplified Specification Version 6.00
SD I/F Initialization
SSDD II//FF iiss sseelleecctteedd Stop supplying RCLK
Start supplying SDCLK
UUUHHHSSS---IIIIII SSSDDD CMD0 UHS-II is disabled
III///FFF III///FFF before ACMD41 is
CMD0
SSSEEELLL completed.
CMD8
BBBEEE
CCCaaarrrddd CCCooonnntttrrrooolllllleeerrr
ACMD41
UHS-II I/F Deactivation
Disabling UHS-II I/F
CMD2
CMD3
Figure 3-21 : UHS-II Interface Deactivation
3.10.5 Summary of Bus Speed Mode for UHS-II Card
*1: The card supports a UHS-I mode shall support all lower UHS-I modes.
*2: Host may control card power by the Power Limit Function of CMD6
*3: SDSC stands for SD Standard Capacity Memory Card.
*4: SDHC stands for SD High Capacity Memory Card.
*5: SDXC stands for SD Extended Capacity Memory Card.
*6: The max. power of removable card is 1.80W and that of embedded device is 2.88W
*7: Host may select either card power by XPC in ACMD41.
In SPI mode, XPC is not supported and the power shall be up to 0.36W (3.6V 100mA).
*8: Minimum power requirement of host in UHS-II mode is 0.72W and it is applied from PHY
Initialization.
Table 3-9 : Bus Speed Modes of UHS-II Card
22

©Copyright 2001-2017 SD Card Association
  Physical Layer Simplified Specification Version 6.00
Table 3-10 shows Card Types and Supported Bus Speed Modes.
It is recommended that UHS-II hosts implement the UHS-I mode (at least SDR50) to provide backward
compatibility with UHS-I cards.

Bus Modes
| | | | Non UHS  | UHS-I  | | UHS-II  | |
| --- | --- | --- | --- | --- | --- | --- | --- |
Range B  Range C Range D
Card Types
| | | | DS  HS  | SDR50 SDR104  | DDR50 FD156  | HD312  FD312  | FD624  |
| ----- | --- | --- | --- | --- | --- | --- | --- |
| SDSC  | | | M  O | N/A  N/A | N/A  N/A | N/A  N/A | N/A |
| | Non UHS  | | M  O | N/A  N/A | N/A  N/A | N/A  N/A | N/A |
| | | UHS50  | M  M | M  N/A | (1)  N/A | N/A  N/A | N/A |
UHS-I
| SDHC  | | UHS104  | M  M  | M  M  | (1)  N/A  | N/A  N/A  | N/A  |
| ----- | --- | --- | ----- | ----- | --- | --- | ---- |
| | | UHS156  | M  M  | M  O  | (1)  M | O  N/A | N/A  |
UHS-II
| | UHS-III  | UHS624  | M  M  | M  O | (1)  M | O  M | M |
| --- | --- | --- | ----- | --- | --- | --- | ---- |
| | Non UHS  | | M  O  | N/A  N/A  | N/A  N/A  | N/A  N/A  | N/A  |
| | | UHS50 | M  M  | M  N/A | (1)  N/A  | N/A  N/A  | N/A  |
UHS-I
| SDXC  | | UHS104  | M  M  | M  M  | (1)  N/A  | N/A  N/A  | N/A  |
| ----- | --- | --- | ----- | ----- | --- | --- | ---- |
| | UHS-II | UHS156  | M  M  | M  O  | (1)  M | O  N/A | N/A  |
| | UHS-III  | UHS624  | M  M  | M  O  | (1)  M | O  M | M |
Note: Abbreviation: M: Mandatory, Optional, N/A: Not available, (1): O (Standard SD) and M (microSD)
Table 3-10 : Bus Speed Mode Option / Mandatory

3.11 Application Performance Class
The  specification  defines Application Performance  Class  that  indicates  the  minimum  random  and
sequential performance of the card under specified pre-conditions (refer to section 4.16).

  Application Performance Class 1 means:
o  Minimum Card Random performance is Write : 500 IOPS and Read : 1500 IOPS
o  Minimum sustained sequential write performance is 10MB/s
  Application Performance Class 2 means:
o  Minimum Card Random performance is Write : 2000 IOPS and Read : 4000 IOPS using
Command Queue and Cache Feature
o  Minimum sustained sequential write performance is 10MB/s using Command Queue and
Cache Feature

Note that unit of random performance [IOPS] indicate number of 4KB sized I/O Operations completed in
one second, wherein each transaction was targeted to a random address generated for 256MB address
range.

23

©Copyright 2001-2017 SD Card Association
Physical Layer Simplified Specification Version 6.00
3.12 Cache
Cache feature enables card to improve performance by directing host data into faster memory that may
be volatile, which is up to card implementation. Hosts that enable Cache shall be aware that data loss
may occur, if the contents in the Cache are not flushed before power off. Refer to section 4.17 for details
of Cache.
3.13 Self Maintenance
Self Maintenance scheme allows the card to performance internal background data management, while
the host is aware those operations may be performed by the card and supports them accordingly. Self
Maintenance may improve card performance, if enabled. Refer to section 4.18 for details of Self
Maintenance.
3.14 Command Queue
Command Queue (CQ) scheme allows the host to submit commands [tasks] even during data transfer.
Voluntary CQ Mode allows card to re-order the tasks and execution of ready task is triggered by host
based on the task ready status provided by the card. In Sequential CQ Mode, tasks are executed in order.
Refer to section 4.19 for details of Command Queue scheme.
24

©Copyright 2001-2017 SD Card Association
Physical Layer Simplified Specification Version 6.00
3.15 LV Interface
Low voltage Interface is to enable card initialization in 1.8V IO mode rather than legacy 3.3V IO mode.
Refer to Low Voltage Interface Addendum for additional details. Table 3-11 shows the Card Types and
Supported Bus Speed Modes for LV interface.
Table 3-11 : LV Interface Bus Speed Mode Option / Mandatory
3.16 Higher Bus Speed of UHS-II (UHS-III)
From the Physical Specification Version 6.00, enhanced bus speed mode of UHS-II, i.e. FD624 is newly
introduced. Maximum bus speed of FD624 is 624MB/s. Refer to UHS-II Addendum Version 2.00 for more
details. "UHS-II" and "UHS-III" denotes card types which are specified by required functions in the UHS-II
Addendum. UHS-II Card supports Range A and Range B. UHS-III Card supports Range A to Range D.
For simplicity, use of the term "UHS-II" in common to define extend functions of all card types by the UHS-
II Addendum and Versions.
25

©Copyright 2001-2017 SD Card Association
Physical Layer Simplified Specification Version 6.00
4. SD Memory Card Functional Description
4.1 General
All communication between host and cards is controlled by the host (master). The host sends commands
of two types: broadcast and addressed (point-to-point) commands.
 Broadcast commands
Broadcast commands are intended for all cards. Some of these commands require a response.
 Addressed (point-to-point) commands
The addressed commands are sent to the addressed card and cause a response from this card.
A general overview of the command flow is shown in Figure 4-1 for card identification mode and in
Figure 4-13 for data transfer mode. The commands are listed in the command tables (Table 4-23 to
Table 4-33). The dependencies between current state, received command, and following state are
listed in Table 4-35. In the following sections, the various card operation modes will be described
first. Afterwards, the restrictions for controlling the clock signal are defined. All SD Memory Card
commands, along with the corresponding responses, state transitions, error conditions and timings
are presented in the succeeding sections.
Two operation modes are defined for the SD Memory Card system (host and cards):
 Card identification mode
The host will be in card identification mode after reset and while it is looking for new cards on the
bus. Cards will be in this mode after reset until the SEND_RCA command (CMD3) is received.
 Data transfer mode
Cards will enter data transfer mode after their RCA is first published. The host will enter data transfer
mode after identifying all the cards on the bus.
Table 4-1 shows the dependencies between operation modes and card states. Each state in the SD
Memory Card state diagram (see Figure 4-1) is associated with one operation mode:
Card state Operation mode
Inactive State inactive
Idle State
card identification mode
Ready State
Identification State
Stand-by State
Transfer State
Sending-data State
data transfer mode
Receive-data State
Programming State
Disconnect State
Table 4-1: Overview of Card States vs. Operation Modes
26

©Copyright 2001-2017 SD Card Association
Physical Layer Simplified Specification Version 6.00
4.2 Card Identification Mode
While in card identification mode the host resets all the cards that are in card identification mode, validates
operation voltage range, identifies cards and asks them to publish Relative Card Address (RCA). This
operation is done to each card separately on its own CMD line. All data communication in the Card
Identification Mode uses the command line (CMD) only.
During the card identification process, the card shall operate in the SD clock frequency of the identification
clock rate f .
OD
4.2.1 Card Reset
In SD Mode, the command GO_IDLE_STATE (CMD0) is the software reset command and sets each card
into Idle State regardless of the current card state. Cards in Inactive State are not affected by this com-
mand.
After power-on by the host, all cards are in Idle State, including the cards that have been in Inactive State
before.
After power-on or CMD0, all cards' CMD lines are in input mode, waiting for start bit of the next com-
mand. The cards are initialized with a default relative card address (RCA=0x0000) and with a default
driver strength with 400KHz clock frequency. In case of 3.3V signaling, default driver strength is
specified by the Driver Stage Register (DSR) if supported and selected highest driving current capability.
In case of 1.8V signaling, default driver strength is specified by type B driver.
In UHS-II Mode, RCA is not cleared to 0x0000 by CMD0 and kept its Device ID, which is determined by
Enumeration.
4.2.2 Operating Condition Validation
At the start of communication between the host and the card, the host may not know the card supported
voltage and the card may not know whether it supports the current supplied voltage. The host issues a
reset command (CMD0) with a specified voltage while assuming it may be supported by the card. To
verify the voltage, a following new command (CMD8) is defined in the Physical Layer Specification
Version 2.00.
SEND_IF_COND (CMD8) is used to verify SD Memory Card interface operating condition. The card
checks the validity of operating condition by analyzing the argument of CMD8 and the host checks the
validity by analyzing the response of CMD8 (See Section 4.3.13). The supplied voltage is indicated by
VHS field in the argument. The card assumes the voltage specified in VHS as the current supplied
voltage. Only 1-bit of VHS shall be set to 1 at any given time. Both CRC and check pattern are used for
the host to check validity of communication between the host and the card.
If the card can operate on the supplied voltage, the response echoes back the supply voltage and the
check pattern that were set in the command argument.
If the card cannot operate on the supplied voltage, it returns no response and stays in idle state. It is
mandatory to issue CMD8 prior to first ACMD41 to initialize SDHC or SDXC Card (See Figure 4-1).
Receipt of CMD8 makes the cards realize that the host supports the Physical Layer Version 2.00 or later
and the card can enable new functions.
SD_SEND_OP_COND (ACMD41) is designed to provide SD Memory Card hosts with a mechanism to
identify and reject cards which do not match the V range desired by the host. This is accomplished by
DD
the host sending the required V voltage window as the operand of this command (See Section 5.1).
DD
Cards which cannot perform data transfer in the specified range shall discard themselves from further
bus operations and go into Inactive State. The levels in the OCR register shall be defined accordingly
(See Section 5.1). Note that ACMD41 is application specific command; therefore APP_CMD (CMD55)
shall always precede ACMD41. The RCA to be used for CMD55 in idle_state shall be the card's default
RCA = 0x0000.
After the host issues a reset command (CMD0) to reset the card, the host shall issue CMD8 prior to
ACMD41 to re-initialize the SD Memory card.
27

©Copyright 2001-2017 SD Card Association
  Physical Layer Simplified Specification Version 6.00

Figure 4-1 shows State Diagram of card Identification mode for SD I/F. In case of UHS-II mode, refer to
SD-TRAN Section of the UHS-II Addendum.

Power on

| | | C M D 0 + | | | |
| --- | --- | --- | --- | ---- | --- |
| S P I  O | peration | | Idl e  S ta te | CMD0 | |
| | | CS  A s s e r ted | ( id le ) | | from all states except (ina) |
  M o d e
("0")

If card cannot operate under supplied voltage,
card doesn't respond and return to 'Idle State'

| | | | | CMD8 | It is mandatory for the host compliant |
| --- | --- | --- | --- | ---- | --- |

to Physical Spec Version 2.00
| | | | | | to send CMD8 before ACMD41 |
| --- | --- | --- | --- | --- | --- |
| | | | | Inactive | |
ACMD41
| | card returns busy ( *  1 ) or | | | State(ina) | |
| --- | --- | --- | --- | --- | --- |

host omitted voltage range

Ready State

(ready)
No Response

(Non valid command)
| | Must be a | | | cards with non compatible | |
| --- | --- | --- | --- | --- | --- |
CMD11
| | MultiMediaCard | | | voltage range | |
| --- | --- | --- | --- | --- | --- |

| | Start MultiMediaCard | | | card executes Voltage  | |
| --- | --- | --- | ---- | --- | --- |
| | initialization process | | CMD2 | Switch Sequence. | |

| | starting at CMD1 | | | Whether it can be executed | |
| --- | --- | --- | --- | --- | --- |

is determined in ACMD41.

Identification
State(ident)

Card responds with
| card-identification-mode | | | CMD3 | | |
| --- | --- | --- | ---- | --- | --- |
| | | new RCA | | | |

data-transfer-mode
Stand-by State
| | | | | | CMD15 |
| --- | --- | --- | --- | ---- | ----- |
| | | | (stby) | CMD3 | |

Card responds with
from all states in
| | | | | new RCA | data-transfer-mode |
| --- | --- | --- | --- | --- | --- |

| | (*1) Note : Card returns busy when | | | | |
| --- | --- | --- | --- | --- | --- |
| | | - Card executes internal initialization process | | | |
  -   Card is High or Extended capacity SD Memory Card and host doesn't support
     High or Extended capacity

  This means that CMD8 is mandatory to initialize High capacity SD Memory Card.

Figure 4-1 : SD Memory Card State Diagram (card identification mode)

By setting the OCR to zero in the argument of ACMD41, the host can query each card and determine the
common voltage range before sending out-of-range cards into the Inactive State (query mode). This query
should be used if the host is able to select a common voltage range or if a notification to the application
of non-usable cards in the stack is desired. The card does not start initialization and ignores HCS in the
argument (refer to Section 4.2.3) if ACMD41 is issued as a query. Afterwards, the host may choose a
voltage for operation and reissue ACMD41 with this condition, sending incompatible cards into the
Inactive State.
During the initialization procedure, the host is not allowed to change the operating voltage range. Refer

to the power up sequence as described in Section 6.4.

28

©Copyright 2001-2017 SD Card Association
Physical Layer Simplified Specification Version 6.00
4.2.3 Card Initialization and Identification Process
After the bus is activated the host starts card initialization and identification process (See Figure 4-2). The
initialization process starts with SD_SEND_OP_COND (ACMD41) by setting its operational conditions
and the HCS bit in the OCR. The HCS (Host Capacity Support) bit set to 1 indicates that the host supports
SDHC or SDXC Card. The HCS (Host Capacity Support) bit set to 0 indicates that the host supports
neither SDHC nor SDXC Card.
Receiving of CMD8 expands the ACMD41 function; HCS in the argument and CCS (Card Capacity
Status) in the response. HCS is ignored by cards, which didn't respond to CMD8. However the host
should set HCS to 0 if the card returns no response to CMD8. Standard Capacity SD Memory Card
ignores HCS. If HCS is set to 0, SDHC and SDXC Cards never return ready status (keep busy bit to 0).
The busy bit in the OCR is used by the card to inform the host whether initialization of ACMD41 is
completed. Setting the busy bit to 0 indicates that the card is still initializing. Setting the busy bit to 1
indicates completion of initialization. Card initialization shall be completed within 1 second from the first
ACMD41. The host repeatedly issues ACMD41 for at least 1 second or until the busy bit are set to 1.
The card checks the operational conditions and the HCS bit in the OCR only at the first ACMD41 with
setting voltage window in the argument. While repeating ACMD41, the host shall not issue another
command except CMD0.
If the card responds to CMD8, the response of ACMD41 includes the CCS field information. CCS is
valid when the card returns ready (the busy bit is set to 1). CCS=0 means that the card is SDSC. CCS=1
means that the card is SDHC or SDXC.
The host performs the same initialization sequence to all of the new cards in the system. Incompatible
cards are sent into Inactive State. The host then issues the command ALL_SEND_CID (CMD2), to each
card to get its unique card identification (CID) number. Card that is unidentified (i.e. which is in Ready
State) sends its CID number as the response (on the CMD line). After the CID was sent by the card it
goes into Identification State. Thereafter, the host issues CMD3 (SEND_RELATIVE_ADDR) asks the card
to publish a new relative card address (RCA), which is shorter than CID and which is used to address the
card in the future data transfer mode. Once the RCA is received the card state changes to the Stand-by
State. At this point, if the host wants to assign another RCA number, it can ask the card to publish a new
number by sending another CMD3 command to the card. The last published RCA is the actual RCA
number of the card.
The host repeats the identification process, i.e. the cycles with CMD2 and CMD3 for each card in the
system.
Initialization of SDXC is identical to SDHC. User area capacity of SDXC card is specified by C_SIZE and
it shall be more than or equal to 32GB.
Figure 4-2 shows Card Initialization and Identification for SD I/F. In case of UHS-II mode, refer to SD-
TRAN Section of the UHS-II Addendum.
Application Notes:
The host shall set ACMD41 timeout more than 1 second to abort repeat of issuing ACMD41 when
the card does not indicate ready. The timeout count starts from the first ACMD41 which is set voltage
window in the argument.
29

©Copyright 2001-2017 SD Card Association
  Physical Layer Simplified Specification Version 6.00

Power-on

| | | | | CMD0 | | |
| --- | --- | --- | --- | ---- | --- | --- |

| | | | | CMD8 | | |
| --- | --- | --- | --- | ---- | --- | --- |
No response Card returns response

| | Ver2.00 or later SD Memory Card(voltage mismatch) | | | Ver2.00 or later | | |
| --- | --- | --- | --- | --- | --- | --- |
  or Ver1.X SD Memory Card SD Memory Card Non-compatible voltage range
| | | | or not SD Memory Card | | or check pattern is not correct | |
| --- | --- | --- | --- | --- | --- | --- |
| | | | | Valid | | Unusable |
| | | | ACMD41 | Response? | | Card |
with HCS=0
| No response | | | | | | |
| --- | --- | --- | --- | --- | --- | --- |
Compatible voltage range
Card returns and check pattern is correct
| | | | busy | Card with compatible | | |
| --- | --- | --- | --- | --- | --- | --- |
| | Unusable | | Card is | Voltage range | | |
| | Card | | ready?  | | If host supports high capacity, HCS is set to 1 | |
| cards with non compatible | | | | | | |
ACMD41
| voltage range (card goes to | | | | | | |
| --- | --- | --- | --- | --- | --- | --- |
with HCS=0or1
| 'ina' state) or time-out | | | | | | |
| --- | --- | --- | --- | --- | --- | --- |
Card returns cards with non compatible voltage range
(no response or busy) occurs or time-out (no response or busy) occurs
| | | | busy | | | |
| --- | --- | --- | ---- | --- | --- | --- |
| | | | | Card is | | Unusable |
| | | Card returns | | | | |
| | | ready | | ready?  | | Card |
  Not SD Memory Card
Card returns ready

CCS in
CCS=1
| | | | | Response? | | |
| --- | --- | --- | --- | --- | --- | --- |
| | | | | CCS=0 | | |
| | | | | | | Ver2.00 or later |
| | | | Ver1.X | Ver2.00 or later | | |
High Capacity or
| | | | Standard Capacity | Standard Capacity | | |
| --- | --- | --- | --- | --- | --- | --- |
Extended Capacity
| | | | SD Memory Card | SD Memory Card | | SD Memory Card |
| --- | --- | --- | --- | --- | --- | --- |

| | | | | | | S18R and S18A are negotiated in ACMD41. |
| --- | --- | --- | --- | --- | --- | --- |
  S18R and S18A ? S18A is valid only when card returns ready.
| | | | S18R=1&S18A=1 | | | |
| --- | --- | --- | --- | ----- | --- | --- |
| | | | | CMD11 | S18R=0 or S18A=0 | |

CMD2

| | | | | CMD3 | | |
| --- | --- | --- | --- | ---- | --- | --- |

Figure 4-2 : Card Initialization and Identification Flow (SD mode)

30

©Copyright 2001-2017 SD Card Association
Physical Layer Simplified Specification Version 6.00
4.2.3.1 Initialization Command (ACMD41)
Followings are general rules of the argument of ACMD41:
(1) If the voltage window field (bit 23-0) in the argument is set to zero, it is called "inquiry CMD41" that
does not start initialization and is use for getting OCR. The inquiry ACMD41 shall ignore the other
field (bit 31-24) in the argument.
(2) If the voltage window field (bit 23-0) in the argument is set to non-zero at the first time, it is called "first
ACMD41" that starts initialization. The other field (bit 31-24) in the argument is effective.
(3) The argument of following ACMD41 shall be the same as that of the first ACMD41.
Figure 4-3 shows argument format and Figure 4-4 shows response format. Two new fields are added to
the argument of ACMD41.
If a SDXC Card is initialized with XPC=0, the card is operating at up to 0.36W (100mA at 3.6V on VDD1)
in Default Speed or SDR12, and if the card does not support Speed Class, Class 0 is indicated in SD
Status. If a SDXC Card is initialized with XPC=1, the card is operating at up to 0.54W (150mA at 3.6V on
VDD1) in Default Speed or SDR12, and the card supports Speed Class. Re-initialization is required to
change XPC selection.
UHS-I supported host sets S18R=1 in the argument of ACMD41 to request the card to switch 1.8V
signaling level. UHS-I card respond with S18A=1 in the response of ACMD41 (if in 3.3V signaling mode)
and then host can issue voltage switch command. Once voltage switch is performed, UHS-I card indicates
S18A=0 to keep current signal voltage. In UHS-II mode, the card always indicates S18A=0.
(1) Argument of ACMD41
4477 4466 4455--4400 3399 3388 3377 3366 3355--3333 3322 3311--1166 1155--0088 0077--0011 0000
SS DD IInnddeexx BBuussyy HHCCSS ((FFBB)) XXPPCC RReesseerrvveedd SS1188RR OOCCRR RReesseerrvveedd CCRRCC77 EE
3311 3300 2299 2288 2277--2255 2244 2233--0088 0077--0000
00 11 110011000011 00 xx 00 xx 000000 xx xxxxxxxxhh 00000000000000 xxxxxxxxxxxxxx 11
11 11 66 11 11 11 11 33 11 1166 88 77 11
Host Capacity Support SDXC PowerControl S18R : Switching to 1.8V Request
0b: SDSCOnly Host 0b: Power Saving 0b: Use current signal voltage
1b: SDHC or SDXCSupported 1b: Maximum Performance 1b: Switch to 1.8V signal voltage
Note: Fast Boot (Bit 29) is reserved for eSD.
Figure 4-3 : Argument of ACMD41
(2) Response of ACMD41 (R3)
4477 4466 4455--4400 3399 3388 3377 3366--3333 3322 3311--1166 1155--0088 0077--0011 0000
SS DD IInnddeexx BBuussyy CCCCSS UUHHSS--IIII RReesseerrvveedd SS1188AA OOCCRR RReesseerrvveedd CCRRCC77 EE
3311 3300 2299 2288--2255 2244 2233--0088 0077--0000
00 00 111111111111 xx xx xx 00000000 xx xxxxxxxxhh 00000000000000 11111111111111 11
11 11 66 11 11 11 44 11 1166 88 77 11
Busy Status Card Capacity Status UHS-II Card Status S18A : Switching to 1.8V Accepted
0b: On Initialization 0b: SDSC 0b: Non UHS-II Card 0b: Continues current voltage signaling
1b: Initialization Complete 1b: SDHC or SDXC 1b: UHS-II Card 1b: Ready for switching signal voltage
Figure 4-4 : Response of ACMD41
CCS (Bit 30), UHS-II (Bit 29) and S18A (Bit 24) are valid when Busy (Bit 31) is set to 1.
31

©Copyright 2001-2017 SD Card Association
  Physical Layer Simplified Specification Version 6.00
4.2.4 Bus Signal Voltage Switch Sequence

Refer to Low Voltage Interface Addendum for LV interface Card initialization.
4.2.4.1 Initialization Sequence for UHS-I
Figure 4-5 shows sequence of commands to perform voltage switch and Figure 4-6 shows initialization flow
chart for UHS-I hosts. Red and yellow boxes are new procedure to initialize UHS-I card.

| | Repeat ACMD41 | | | |
| --- | --- | --- | --- | --- |
| | | | The Last ACMD41 | |
  CMD55 R1 CMD41 R3 CMD55 R1 CMD41 R3 CMD11 R1 Voltage Switch CMD2 R2

| | Bit 30: HCS=1  | Bit 31: Busy | Bit 31: Ready  | |
| --- | --- | --- | --- | --- |
| | Bit 24: S18R=1 | Bit 30: CCS Invalid  | Bit 30: CCS=1  | |
| | | Bit 24: S18A Invalid | Bit 24: S18A=1 | |
Figure 4-5 : ACMD41 Timing Followed by Voltage Switch Sequence

| | | CMD0 | | CMD2 |
| --- | --- | ---- | --- | ---- |

CMD3
| | | CMD8 | | |
| --- | --- | ---- | --- | --- |

CMD7

ACMD41 HCS=1, S18R=1
| | | | | CMD42 |
| --- | --- | --- | --- | ----- |
| | | | D31=0 (busy) | |
No Response
Check busy
| | | | | ACMD6 |
| --- | --- | --- | --- | ----- |
D31=1(Completed)
  4-bit mode
CCS=0 (SDSC)
| | | Check CCS | | No |
| --- | --- | --- | --- | --- |
| | | | | UHS-I Card? |
| | | CCS=1 (SDHC/SDXC) | | Yes |
| | | Check S18A | S18A=0 (No Switch) | |
CMD6
| | | S18A=1 (Switch) | | Function Group 3 |
| --- | --- | --- | --- | --- |

| | | CMD11 | | Driver Strength |
| --- | --- | ----- | --- | --- |

CMD6
| | No Response | | | |
| --- | --- | --- | --- | --- |
| | | Check Resp. | | Function Group 1, 4 |
| | | | | UHS-I Mode Power Limit |
GetResponse

| | | Voltage SwitchSequence | | |
| --- | --- | --- | --- | ----- |
| | | Switch to SDR12 timing | | CMD19 |

Tuning
| | | | | No  |
| --- | --- | --- | --- | --- |
Switch Error
| | | Error? | | Complete? |
| --- | --- | --- | --- | --- |
| | | Yes | | |
| | | No | | Yes |
| | | | 1.8V Signal UHS-I Mode | |
Power Cycle

Figure 4-6 : UHS-I Host Initialization Flow Chart

When signaling level is 3.3V, host repeats to issue ACMD41 with HCS=1 and S18R=1 until the response
indicates ready. The argument (HCS and S18R) of the first ACMD41 is effective but the all following
ACMD41 should be issued with the same argument. If Bit 31 indicates ready, host needs to check CCS
and S18A. The card indicates S18A=0, which means that voltage switch is not allowed and the host needs
to use current signaling level. S18A=1 means that voltage switch is allowed and host issues CMD11 to
invoke voltage switch sequence. By receiving CMD11, the card returns R1 response and  start voltage
switch sequence. No response of CMD11 means that S18A was 0 and therefore host should not have sent

32

©Copyright 2001-2017 SD Card Association
Physical Layer Simplified Specification Version 6.00
CMD11. Completion of voltage switch sequence is checked by high level of DAT[3:0]. Any bit of DAT[3:0]
can be checked depends on ability of the host.
When entering tran state, CARD_IS_LOCKED status in the R1 response should be checked (it is indicated
in the response of CMD7). If the card is locked, CMD42 is required to unlock the card. If the card is
unlocked, CMD42 can be skipped.
In case of UHS-I card, appropriate driver strength is selected by CMD6 Function Group 3 and one of UHS-
I modes is selected by CMD6 Function Group 1.
In SDR50 and SDR104 modes, if tuning of sampling point is required, CMD19 is repeatedly issued until
tuning is completed.
4.2.4.2 Timing to Switch Signal Voltage
This section is a blank in the Simplified Specification.
Table 4-2 : S18R and S18A Combinations
Figure 4-7 : Signal Voltage Switch Sequence
4.2.4.3 Timing of Voltage Switch Error Detection
This section is a blank in the Simplified Specification.
Figure 4-8 : Error Indication Timing
4.2.4.4 Voltage Switch Command
Figure 4-9 shows Voltage Switch Command (CMD11) definition. CMD11 can be executed in ready state
and doesn't change the state. Even if the card is locked, CMD11 can be executed. Returning R1 type
response means the card starts voltage switch sequence. If the host detects no response, power cycle
should be executed.
There are four cases that the card indicates no response to CMD11.
(1) The card does not support voltage switch.
(2) The card supports voltage switch but ACMD41 is received with S18R=0.
(3) The card receives CMD11 not in ready state.
(4) Signaling level is already switched to 1.8V.
For all above cases, CMD11 is treated as an illegal command.
Voltage SwitchCommand
SS TT IInnddeexx RReesseerrvveedd CCRRCC77 EE
00 11 000011001111 aallll 00 00111111001111 11
CMD CMD11 R1
DAT[3:0]
Figure 4-9 : Voltage Switch Command
4.2.4.5 Tuning Command
A known data block ("Tuning block") can be used to tune sampling point for tuning required hosts. The
tuning capability of sampling point is mandatory for HOST-SDR-VD and optional for HOST-SDR-FD. This
procedure gives the system optimal timing for each specific host and card combination and compensates
for static delays in the timing budget including process, voltage and different PCB loads and skews.
CMD19 is defined for Send Tuning Block Command. R1 type response is defined. CMD19 can be
executed in transfer state of 1.8V signaling mode while the card is unlocked. The other case, CMD19 is
33

©Copyright 2001-2017 SD Card Association
Physical Layer Simplified Specification Version 6.00
treated as illegal command. Data block, carried by DAT[3:0], contains a pattern for tuning sampling
position to receive data on the CMD and DAT[3:0] line. The block length of CMD19 is fixed and CMD16
is not required.
The tuning command (CMD19) follows the timing of the single block read command as described in
Figure 4-10.
Send Tuning BlockCommand
SS TT IInnddeexx RReesseerrvveedd CCRRCC77 EE
00 11 001100001111 aallll 00 11000000111100 11
CMD CMD19 R1
DAT[3:0]
Data Block
146ck
SS 112288--bbiitt TTuunniinngg BBlloocckkppeerr LLiinnee CCRRCC1166 EE
00 TTuunniinngg BBlloocckk PPaatttteerrnn xxxxxxxx 11
Figure 4-10 : Send Tuning Block Command
This sequence is defined as multiple, consecutive executions of CMD19 that are sent from the host and
responded by the card, without any other command mixed between them.
The card shall complete a sequence of 40 times CMD19 executions in no more than 150ms. The tuning
process is normally shorter than 40 executions of CMD19, and therefore should be shorter than 150ms.
The sequence period definition does not include any host processing time. If host needs time to process
CMD19 between executions, the sequence may be longer by this amount of time.
FF0FFF00 FFCCC3CC C33CCCFF FEFFFEEF
FFDFFFDD FFFBFFFB BFFF7FFF 77F7BDEF
FFF0FFF0 0FFCCC3C CC33CCCF FFEFFFEE
FFFDFFFD DFFFBFFF BBFFF7FF F77F7BDE
Table 4-3 : Tuning Block Pattern
Following of this section is a blank in the Simplified Specification.
Figure 4-11 : Tuning Block on DAT[3:0]
4.2.4.6 An Example of UHS-I System Block Diagram
This section is a blank in the Simplified Specification.
Figure 4-12 : An Example of UHS-I System Block Diagram
34

©Copyright 2001-2017 SD Card Association
Physical Layer Simplified Specification Version 6.00
4.3 Data Transfer Mode
Until the end of Card Identification Mode the host shall remain at f frequency because some cards may
OD
have operating frequency restrictions during the card identification mode. In Data Transfer Mode the host
may operate the card in f frequency range. The host issues SEND_CSD (CMD9) to obtain the Card
PP
Specific Data (CSD register), e.g. block length, card storage capacity, etc.
The broadcast command SET_DSR (CMD4) configures the driver stages of all identified cards. It
programs their DSR registers corresponding to the application bus layout (length) and the number of
cards on the bus and the data transfer frequency. The clock rate is also switched from f to f at that
OD PP
point. SET_DSR command is an option for the card and the host.
CMD7 is used to select one card and put it into the Transfer State. Only one card can be in the Transfer
State at a given time. If a previously selected card is in the Transfer State its connection with the host is
released and it will move back to the Stand-by State. When CMD7 is issued with the reserved relative
card address "0x0000", all cards are put back to Stand-by State (Note that it is the responsibility of the
Host to reserve the RCA=0 for card de-selection - refer to Table 4-23, CMD7.
SD Memory Card State Diagram in UHS-II is defined by the UHS-II Addendum.
CMD3 CMD15 CMD0
card identification
mode
data transfer from all states in
mode data-transfer-mode
Sending-data
State (data)
CMD13, CMD55
no state transition
in data-transfer-mode
CMD12, or CMD6,17,18,19,30,48,56(r),58
"operation ACMD13,22,51
complete"
CMD7
Stand-by State Transfer CMD16,23,32,33
CMD7
(stby) State (tran) ACMD6,42
ACMD23
CMD4,9,10,3
"operation CMD24,25,26,27,42,49,56(w),59
complete"
CMD20, 28,29,38
"operation
complete" Receive-data
State (rcv)
CMD7
Disconnect Programming CMD12 or
State (dis) State (prg) "transfer end"
CMD7
Figure 4-13 : SD Memory Card State Diagram (data transfer mode)
This may be used before identifying new cards without resetting other already registered cards. Cards
which already have an RCA do not respond to identification commands (ACMD41, CMD2, see Section
4.2.3) in this state. CMD48, CMD49, CMD58 and CMD59 are also available in UHS-II mode .
35

©Copyright 2001-2017 SD Card Association
Physical Layer Simplified Specification Version 6.00
Important Note: The card de-selection is done if certain card gets CMD7 with un-matched RCA. That
happens automatically if selection is done to another card and the CMD lines are common. So, in SD
Memory Card system it will be the responsibility of the host either to work with common CMD line (after
initialization is done) - in that case the card de-selection will be done automatically or if the CMD lines are
separate then the host shall be aware to the necessity to de-select cards.
All data communication in the Data Transfer Mode is point-to point between the host and the selected
card (using addressed commands). All addressed commands get acknowledged by a response on the
CMD line.
The relationship between the various data transfer modes is summarized below.
 All data read commands can be aborted any time by the stop command (CMD12). The data transfer
will terminate and the card will return to the Transfer State. The read commands are such as block
read (CMD17), multiple block read (CMD18), send write protect (CMD30), send SCR (ACMD51) and
general command in read mode (CMD56). (Refer to Figure 4-13 for more details.)
 All data write commands can be aborted any time by the stop command (CMD12). The write
commands shall be stopped prior to deselecting the card by CMD7. The write commands are such
as block write (CMD24 and CMD25), program CSD (CMD27), lock/unlock command (CMD42) and
general command in write mode (CMD56). (Refer to Figure 4-13 for more details.)
 As soon as the data transfer is completed, the card will exit the data write state and move either to
the Programming State (transfer is successful) or Transfer State (transfer failed).
 If a block write operation is stopped and the block length and CRC of the last block are valid, the data
will be programmed.
 The card may provide buffering for block write. This means that the next block can be sent to the
card while the previous is being programmed.
If all write buffers are full, and as long as the card is in Programming State (see SD Memory Card
state diagram Figure 4-13 ), the DAT0 line will be kept low (BUSY).
 There is no buffering option for write CSD, write protection and erase. This means that while the card
is busy servicing any one of these commands, no other data transfer commands will be accepted.
DAT0 line will be kept low as long as the card is busy and in the Programming State. Actually if the
CMD and DAT0 lines of the cards are kept separated and the host keep the busy DAT0 line
disconnected from the other DAT0 lines (of the other cards) the host may access the other cards
while the card is in busy.
 Parameter set commands are not allowed while card is programming.
Parameter set commands are: set block length (CMD16), erase block start (CMD32) and erase
block end (CMD33).
 Read commands are not allowed while card is programming.
 Moving another card from Stand-by to Transfer State (using CMD7) will not terminate erase and
programming operations. The card will switch to the Disconnect State and will release the DAT line.
 A card can be reselected while in the Disconnect State, using CMD7. In this case the card will move
to the Programming State and reactivate the busy indication.
 Resetting a card (using CMD0 or CMD15) will terminate any pending or active programming
operation. This may destroy the data contents on the card. It is the host's responsibility to prevent
this.
 CMD34-37, CMD50 and CMD57 are reserved for SD command system expansion. State transitions
for these commands are defined in each command system specification.
36

©Copyright 2001-2017 SD Card Association
Physical Layer Simplified Specification Version 6.00
4.3.1 Wide Bus Selection/Deselection
Wide Bus (4 bit bus width) operation mode may be selected/deselected using ACMD6. The default bus
width after power up or GO_IDLE (CMD0) is 1 bit bus width.
In order to change the bus width two conditions shall be met:
a) The card is in 'tran state'.
b) The card is not locked
A locked card will responds to ACMD6 as illegal command.
4.3.2 2 GByte Card
To make 2GByte card, the Maximum Block Length (READ_BL_LEN=WRITE_BL_LEN) shall be set to
1024 bytes. However, the Block Length, set by CMD16, shall be up to 512 bytes to keep consistency with
512 bytes Maximum Block Length cards (Less than or equal 2GByte cards).
4.3.3 Data Read
The DAT bus line level is high by the pull-up when no data is transmitted. A transmitted data block consists
of start bits (1 or 4 bits LOW), followed by a continuous data stream. The data stream contains the payload
data (and error correction bits if an off-card ECC is used). The data stream ends with end bits (1 or 4 bits
HIGH). The data transmission is synchronous to the clock signal. The payload for block oriented data
transfer is protected by 1 or 4 bits CRC check sum (See Section 4.5).
The Read operation from SD Memory Card may be interrupted by turning the power off. The SD Memory
Card ensures that data is not destroyed during all the conditions except write or erase operations issued
by the host even in the event of sudden shut down or removal.
Read command is rejected if BLOCK_LEN_ERROR or ADDRESS_ERROR occurred and no data
transfer is performed.
• Block Read
Block read is block oriented data transfer. The basic unit of data transfer is a block whose maximum size
is always 512 bytes. Smaller blocks whose starting and ending address are entirely contained within 512
bytes boundary may be transmitted.
Block Length set by CMD16 can be set up to 512 bytes regardless of READ_BL_LEN.
A CRC is appended to the end of each block ensuring data transfer integrity. CMD17
(READ_SINGLE_BLOCK) initiates a block read and after completing the transfer, the card returns to the
Transfer State. CMD18 (READ_MULTIPLE_BLOCK) starts a transfer of several consecutive blocks.
Blocks will be continuously transferred until a STOP_TRANSMISSION command (CMD12) is issued. The
stop command has an execution delay due to the serial command transmission. The data transfer stops
after the end bit of the stop command.
When the last block of user area is read using CMD18, the host should ignore OUT_OF_RANGE error
that may occur even the sequence is correct.
If the host uses partial blocks whose accumulated length is not block aligned and block misalignment is
not allowed, the card shall detect a block misalignment at the beginning of the first misaligned block, set
the ADDRESS_ERROR error bit in the status register, abort transmission and wait in the Data State for
a stop command.
37

©Copyright 2001-2017 SD Card Association
  Physical Layer Simplified Specification Version 6.00
Table 4-4 defines the card behavior when a partial block accesses is enabled.
If the misaligned block is the first data block of the command (i.e. ADDRESS_ERROR was reported in
the actual response to the command), then no data is transferred and the card remains in the TRAN
state.

CSD value
| | | | Current  | | Read CMD  | |
| --- | --- | --- | --- | --- | --- | --- |
Max block size
| | Misalign  | Partial  | | *1  | Start Address  | |
| --- | --- | --- | --- | --- | --- | --- |
| | | | Blocklen | | | |
READ_BL_LEN
| 512Bytes  | 0 (Disable)  | 1 (Enable)  | 1- 512 bytes  | | | *2  |
| --- | --- | --- | --- | --- | --- | --- |
| | | | | Any address is accepted. | | |
| 1kBytes | 0 (Disable)  | 1 (Enable)  | 1- 512 bytes  | | | *2  |
| | | | | Any address is accepted. | | |
*2
2kBytes  0 (Disable)  1 (Enable)  1- 512 bytes  Any address is accepted.
*1: "Current Blocklen" size is set or changed by CMD16. If value is less than or equal 512 bytes
  (There are no relations with Misalign and Partial option), it is set with no error.
*2: When the Blocklen size data range crosses 512 bytes block boundary, card outputs the data until the 512
bytes block boundary" and then the data becomes invalid and CRC error also may occur. The card will send
"ADDRESS_ERROR" on the next command response. Host should issue CMD12 to recover.
Table 4-4 : Read Command Blocklen

4.3.4 Data Write
The data transfer format is similar to the data read format. For block oriented write data transfer, the CRC
check bits are added to each data block. The card performs 1 or 4 bits CRC parity check (See Section
4.5) for each received data block prior to the write operation. By this mechanism, writing of erroneously
transferred data can be prevented.
Write command is rejected if BLOCK_LEN_ERROR or ADDRESS_ERROR occurred and no data
transfer is performed.

•  Block Write
During block write (CMD24 - 27, 42, 56(w)) one or more blocks of data are transferred from the host to
the card with 1 or 4 bits CRC appended to the end of each block by the host. A card supporting block
write shall be required that Block Length set by CMD16 shall be 512 bytes regardless of WRITE_BL_LEN
is set to 1k or 2k bytes.
Table 4-5 defines the card behavior when partial block accesses is disabled (WRITE_BL_PARTIAL = 0).

CSD value
| | | | Current  | | Write CMD  | |
| --- | --- | --- | --- | --- | --- | --- |
Max block size
| | Misalign  | Partial  | | *1  | Start Address  | |
| --- | --- | --- | --- | --- | --- | --- |
| | | | Blocklen  | | | |
WRITE_BL_LEN
| 512Bytes  | 0 (Disable)  | 0 (Disable)  | | *2 | *3 | |
| --- | --- | --- | --- | --- | --- | --- |
| | | | 512 bytes | n * 512 bytes | (n: Integer)  | |
| 1kBytes | 0 (Disable)  | 0 (Disable)  | | *2 | *3 | |
| | | | 512 bytes | n * 512 bytes | (n: Integer)  | |
*2 *3
2kBytes  0 (Disable)  0 (Disable)  512 bytes   n * 512 bytes (n: Integer)
*1: "Current Blocklen" size is set or changed by CMD16. If value is less than 512 bytes (there are no relations
with Misalign and Partial option), it is set with no error. And then "Current Blocklen" size is tested when write
command execution.
 *2: If the current Blocklen is other than this value, the card indicates "BLOCK_LEN_ERROR" on the Write
command response.
 *3: If start address is other than this value, the card will send "ADDRESS_ERROR" on the Write command
response.
Table 4-5 : Write Command Blocklen

If WRITE_BL_PARTIAL is allowed (=1) then smaller blocks, up to resolution of one byte, can be used as
well. If the CRC fails, the card shall indicate the failure on the DAT line (see below); the tran sferred data
will be discarded and not be written, and all further transmitted blocks (in multiple block write mode) will

38

©Copyright 2001-2017 SD Card Association
Physical Layer Simplified Specification Version 6.00
be ignored.
Multiple block write command shall be used rather than continuous single write command to make faster
write operation.
If the host uses partial blocks whose accumulated length is not block aligned and block misalignment is
not allowed (CSD parameter WRITE_BLK_MISALIGN is not set), the card shall detect the block
misalignment error and abort programming before the beginning of the first misaligned block. The card
shall set the ADDRESS_ERROR error bit in the status register, and while ignoring all further data transfer,
wait in the Receive-data-State for a stop command.
Note that the first data block is misaligned for write command (i.e. ADDRESS_ERROR is reported in the
actual response of the write command), the card remains in tran state and no data is programmed.
The write operation shall also be aborted if the host tries to write over a write protected area. In this case,
however, the card shall set the WP_VIOLATION bit.
Programming of the CSD register does not require a previous block length setting. The transferred data
is also CRC protected. If a part of the CSD register is stored in ROM, then this unchangeable part shall
match the corresponding part of the receive buffer. If this match fails, then the card will report an error
and not change any register contents.
Some cards may require long and unpredictable times to write a block of data. After receiving a block of
data and completing the CRC check, the card will begin writing and hold the DAT0 line low if its write
buffer is full and unable to accept new data from a new WRITE_BLOCK command. The host may poll the
status of the card with a SEND_STATUS command (CMD13) at any time, and the card will respond with
its status. The status bit READY_FOR_DATA indicates whether the card can accept new data or whether
the write process is still in progress). The host may deselect the card by issuing CMD7 (to select a
different card) which will displace the card into the Disconnect State and release the DAT line without
interrupting the write operation. When reselecting the card, it will reactivate busy indication by pulling DAT
to low if programming is still in progress and the write buffer is unavailable. Actually, the host may perform
simultaneous write operation to several cards with inter-leaving process. The interleaving process can be
done by accessing each card separately while other cards are in busy. This process can be done by
proper CMD and DAT0-3 line manipulations (disconnection of busy cards).
• Pre-erased Setting prior to a Multiple Block Write Operation
Setting a number of write blocks to be pre-erased (ACMD23) will make a following Multiple Block Write
operation faster compared to the same operation without preceding ACMD23. The host will use this
command to define how many number of write blocks are going to be send in the next write operation. If
the host will terminate the write operation (Using stop transmission) before all the data blocks sent to the
card the content of the remaining write blocks is undefined(can be either erased or still have the old data).
If the host will send more number of write blocks than defined in ACMD23 the card will erase block one
by one(as new data is received). This number will be reset to the default (=1) value after Multiple Blocks
Write operation.
It is recommended using this command preceding CMD25, some of the cards will be faster for Multiple
Write Blocks operation. Note that the host should send ACMD23 just before WRITE command if the host
wants to use the pre-erased feature. If not, pre-erase-count might be cleared automatically when another
commands (ex: Security Application Commands) are executed.
• Send Number of Written Blocks
Systems that use Pipeline mechanism for data buffers management are, in some cases, unable to
determine which block was the last to be well written to the flash if an error occurs in the middle of a
Multiple Blocks Write operation. The card will respond to ACMD22 with the number of well written blocks.
39

©Copyright 2001-2017 SD Card Association
Physical Layer Simplified Specification Version 6.00
4.3.5 Erase/Discard/FULE
4.3.5.1 Erase
It is desirable to erase many write blocks simultaneously in order to enhance the data throughput.
Identification of these write blocks is accomplished with the ERASE_WR_BLK_START (CMD32),
ERASE_WR_BLK_END (CMD33) commands.
The host should adhere to the following command sequence: ERASE_WR_BLK_START,
ERASE_WR_BLK_END and ERASE (CMD38). If 00000001h or 000000002h is set in argument of
CMD38, ERASE may not be executed if card supports DISCARD or FULE.
If an erase (CMD38) or address setting (CMD32, 33) command is received out of sequence, the card
shall set the ERASE_SEQ_ERROR bit in the status register and reset the whole sequence.
If an out of sequence command (except SEND_STATUS) is received, the card shall set the
ERASE_RESET status bit in the status register, reset the erase sequence and execute the last command.
If the erase range includes write protected sectors, they shall be left intact and only the non-protected
sectors shall be erased. The WP_ERASE_SKIP status bit in the status register shall be set.
The address field in the address setting commands is a write block address in byte units. The card will
ignore all LSB's below the WRITE_BL_LEN (see CSD) size.
As described above for block write, the card will indicate that an erase is in progress by holding DAT0
low. The actual erase time may be quite long, and the host may issue CMD7 to deselect the card or
perform card disconnection, as described in the Block Write section, above.
The data at the card after an erase operation is either '0' or '1', depends on the card vendor.
The SCR register bit DATA_STAT_AFTER_ERASE (bit 55) defines whether it is '0' or '1'.
4.3.5.2 Discard
The DISCARD operation is similar to the default ERASE operation. Card may de-allocate the discarded
blocks partially or completely. The contents of a region where the discard function has been applied shall
be treated as ‘don’t care’ by host. After discard operation the previously written data may be partially or
fully read by the host, depending on the card implementation.
It is desirable to discard many write blocks simultaneously in order to enhance the data throughput.
Identification of these write blocks is accomplished with the ERASE_WR_BLK_START (CMD32),
ERASE_WR_BLK_END (CMD33) commands. The host should adhere to the following command
sequence: ERASE_WR_BLK_START, ERASE_WR_BLK_END and DISCARD (CMD38) and CMD38
arguments shall be set as 00000001h. The host which supports DISCARD shall check for
DISCARD_SUPPORT bit (b313) in SD_STATUS register. If the card does not support DISCARD, the host
shall not issue DISCARD command. If the card does not support DISCARD, card shall execute ERASE.
If DISCARD (CMD38) or address setting (CMD32, 33) command is received out of sequence, the card
shall set the ERASE_SEQ_ERROR bit in the status register and reset the whole sequence.
If an out of sequence command (except SEND_STATUS) is received, the card shall set the
ERASE_RESET status bit in the status register, reset the DISCARD sequence and execute the last
command.
If the host provides an out of range address as an argument to CMD32 or CMD33, the card shall indicate
OUT_OF_RANGE error in R1 (ERX) for CMD38 or in R1 of next command and reset the whole DISCARD
sequence. Host shall check for any errors after DISCARD command.
The DISCARD is supported for SDHC and SDXC cards only and not supported through SPI interface.
As described above for block write, the card shall indicate that DISCARD is in progress by holding DAT0
low. The busy timeout is 250ms per DISCARD command.
The host may issue CMD7 to deselect the card or perform card disconnection, as described in the Block
Write section.
40

©Copyright 2001-2017 SD Card Association
Physical Layer Simplified Specification Version 6.00
On executing power cycle, card forgets pending Discard. Figure 4.3.5-1 shows the flowchart of card
behavior for erase command sequence, including DISCARD and FULE operations
Application Note: Host is recommended not to issue DISCARD command to the file system area,
since the content of the discarded area shall be ‘don’t care’
4.3.5.3 Full User Area Logical Erase (FULE)
The FULE operation is similar to the default ERASE operation, except the card shall logically erase the
entire user area completely.
It is desirable to logically erase the complete user area. Identification of the full user area is accomplished
with the ERASE_WR_BLK_START (CMD32), argument equal to 0, and ERASE_WR_BLK_END
(CMD33), argument equal to end of user area, commands.
The host should adhere to the following command sequence: ERASE_WR_BLK_START,
ERASE_WR_BLK_END and FULE (CMD38) and CMD38 arguments shall be set as 00000002h
The host that supports FULE shall check for FULE_SUPPORT bit (b312) in SD_STATUS register. If the
card does not support FULE, host shall not issue FULE command. If the card does not support FULE,
card shall execute ERASE.
If FULE (CMD38) or address setting (CMD32, 33) command is received out of sequence, the card shall
set the ERASE_SEQ_ERROR bit in the status register and reset the whole sequence.
If an out of sequence command (except SEND_STATUS) is received, the card shall set the
ERASE_RESET status bit in the status register, reset the FULE sequence and execute the last command.
If the host does not provide the full user area using CMD32 and CMD33, then card shall execute ERASE
operation with the busy timeout as specified in section 4.10.2.5 and section 4.10.2.6. The FULE is
supported for SDHC and SDXC cards only and not supported through SPI interface.
As described above for block write, the card shall indicate that FULE is in progress by holding DAT0 low.
The busy timeout is 1 second per FULE command.
The host may issue CMD7 to deselect the card or perform card disconnection, as described in the Block
Write section.
41

©Copyright 2001-2017 SD Card Association
Physical Layer Simplified Specification Version 6.00
Figure 4.3.5-1 shows the flowchart of card behavior for erase command sequence, including DISCARD
and FULE operations.
Ready
Card receives erase sequence
CMD32 = Start LBA
CMD33 = End LBA
CMD38
Is Card indicates
No
command sequence ‘ERASE_SEQ_ERROR’ in
in order? R1 (ER)
Yes
Is CMD38 Yes Is Yes Card executes
argument Start LBA ≤ End LBA ≤ Max. DISCARD with 250ms
00000001h? LBA? max busy timeout
No
No
Card indicates
‘OUT_OF_RANGE’ in
R1 (ERX)
No
Is
Is CMD38 Yes Is Yes Start LBA=LBA 0 Yes Card executes FULE
argument Start LBA ≤ End LBA ≤ Max. with 1s max busy
and
00000002h? LBA? timeout
End LBA=Max LBA ?
No
No
Card executes ERASE with max busy as per
‘ERASE_SIZE’ and ‘ERASE_TIMEOUT’
calculation.
End
Figure 4.3.5-1 : Flowchart of Card Behavior for Erase Command Sequence
Application Note: If the card does not support DISCARD or FULE,
 The host may proceed with ERASE operation
 The host may proceed to overwrite data
4.3.6 Write Protect Management
Three write protect methods are supported in the SD Memory Card as follows:
- Mechanical write protect switch (Host responsibility only)
- Card internal write protect (Card's responsibility)
- Password protection card lock operation.
42

©Copyright 2001-2017 SD Card Association
Physical Layer Simplified Specification Version 6.00
• Mechanical Write Protect Switch
A mechanical sliding tablet on the side of the card (refer to the Part 1 Standard Size SD Card Mechanical
Addendum) will be used by the user to indicate that a given card is write protected or not. If the sliding
tablet is positioned in such a way that the window is open it means that the card is write protected. If the
window is close the card is not write-protected.
A proper, matched, switch on the socket side will indicate to the host that the card is write-protected or
not. It is the responsibility of the host to protect the card. The position of the write protect switch is un-
known to the internal circuitry of the card.
• Card's Internal Write Protection (Optional)
This section is a blank in the Simplified Specification.
43

©Copyright 2001-2017 SD Card Association
Physical Layer Simplified Specification Version 6.00
4.3.7 Card Lock/Unlock Operation
4.3.7.1 General
The password protection feature enables the host to lock a card while providing a password, which later
will be used for unlocking the card. The password and its size are kept in a 128-bit PWD and 8-bit
PWD_LEN registers, respectively. Optionally, Force Erase Password can be stored in additional 128-bit
FEP and 8-bit FEP_LEN registers shall be present in case Card Ownership Protection (COP) is supported
by the card. These registers are non-volatile so that a power cycle will not erase them.
Locked cards respond to (and execute) all commands in the "basic" command class (class 0), ACMD41,
CMD16 and "lock card" command class. Thus, the host is allowed to reset, initialize, select, query for
status, etc., but not to access data on the card. If the password was previously set (the value of PWD_LEN
is not 0), the card will be locked automatically after power on.
Similar to the existing CSD register write commands, the lock/unlock command is available in "transfer
state" only. This means that it does not include an address argument and the card shall be selected before
using it.
The card lock/unlock command has the structure and bus transaction type of a regular single block write
command. The transferred data block includes all the required information of the command (password
setting mode, PWD itself, card lock/unlock etc.).
Content protection is managed by PWD. Physical Card Ownership is managed with COP feature.
44

©Copyright 2001-2017 SD Card Association
Physical Layer Simplified Specification Version 6.00
4.3.7.1.1 Card Ownership Protection
Card Ownership Protection (COP) prevents re-use of COP Card without knowing the protection password
PWD. Once Force Erase Password (FEP) is set, it disables “Force Erase” operation, and “Clear PWD”
operations. Alternatively, “FEP Force Erase” can be used. As this behavior is different from the Physical
Specification Version 5.00 or earlier, COP Unlock is required to operate the card after power up when
FEP=set, to ensure only the hosts familiar with COP operations can use such a card.
Application Note:
Card Ownership Protection is addressing specific user needs and applications. It is not recommended
for support on host devices that are not designed for specific applications that know how to make use
of this feature. It is recommended to support this feature only in cards specially designed to work with
those designated hosts.
4.3.7.1.2 Special Terms for Lock/Unlock
The following terms and notations are introduced in this section:
 COP: Card Ownership Protection
– COP feature: set of additional functions to support Card Ownership Protection
– COP bit: bit4 of CMD42 argument that indicates COP-specific functions vs. PWD functions
 COP Card / Non-COP Card
– COP Card is a card that supports COP features
– Non-COP Card is another expression of Type 1, 2 Cards that does not support COP feature
 PWD: Card Lock Password
– PWD indicates a register to hold a password to lock the card
– "PWD=0" indicates that PWD is not set and PWD_LEN is set to 0
– "PWD=set" indicates that a password is set to PWD and the password length is set to PWD_LEN
 FEP: Force Erase Password
– "FEP" indicates a register to hold a password to protect Force Erase
– "FEP=0" indicates that FEP is not set and FEP_LEN is set to 0
– "FEP=set" indicates that a password is set to FEP and the password length is set to FEP_LEN
 Force Erase: is the function of CMD42[08h] (with no password) to erase PWD, PWD_LEN and all
memory area. This function is disabled when FEP=set
 FEP Force Erase: is the function of CMD42[18h] (with FEP) to erase PWD, PWD_LEN and all
memory area. This function is disabled when FEP=0
 COP Unlock
– command CMD42 with argument 1Fh (notated as CMD42[1Fh]) that is required to access COP
feature functions. Also, if FEP=set, after power on reset or reset COP Unlock is required to enable
any other CMD42 functions.
 COP Locked state
– state of the card after power on reset or reset, when any other argument to CMD42 is not
accessible till COP Unlock is performed. Also, the card shall behave as locked card to any other
commands.
 Clean COP Card - COP Card with no FEP/PWD set
 Locked COP Card – COP Card with PWD set
 PWD functions - COP Card CMD42 functions defined by Table 4.3.7-1
 COP functions - COP Card CMD42 functions defined by Table 4.3.7-2
45

©Copyright 2001-2017 SD Card Association
Physical Layer Simplified Specification Version 6.00
4.3.7.1.3 Card Behavior
Figure 4.3.7-1 shows simplified behavior of Non-COP Card. After power on, card is "PWD Locked" if
PWD=set or "PWD Unlocked" if PWD=0. Force Erase allows to reset the PWD, while erasing all the User
area data.
CMD42[1Fh] is not defined and Non-COP Card returns LOCK_UNLOCK_FAILED error in R1.
Figure 4.3.7-1 : Simplified Non-COP Card State Diagram
Figure 4.3.7-2 shows simplified behavior of a COP Card. After power on reset or reset, COP Card
starts in CMD42 Ver.1.0 Compatible mode:
 If FEP=0, CMD42 functions are compatible with CMD42 Ver.1.0, except the support of
additional argument 1Fh (COP Unlock).
 If FEP=1, COP Card is in COP Locked state to prevent access by Non-COP Hosts. COP
Card does not execute any CMD42 function and indicates CARD_IS_LOCKED status and
LOCK_UNLOCK_FAILED error except CMD42[1Fh]. On receiving CMD42[1Fh] COP Card
moves to CMD42 Ver.2.0 mode.
In CMD42 Ver.2.0 mode, "FEP Locked" is disabled and CMD42 functions are extended with
functions accessible with COP bit set to ‘1’. There are three additional features to Ver.1.0:
(1) FEP Management
FEP is managed by Reset FEP, Set FEP and Replace FEP functions.
(2) Force Erase
There are 2 types of Force Erase operation supported based on FEP state:
"Force Erase" (CMD42[08h] with no password) to erase PWD, PWD_LEN and all memory
area can be executed as long as FEP=0. It is disabled if FEP=set.
"FEP Force Erase" (CMD42[18h] with password) to erase PWD, PWD_LEN and all
memory area which if executed if the password matches FEP. It is enabled if FEP=set and
disabled if FEP=0.
(3) Reset PWD inhibit
Once PWD is set, PWD can be replaced, but PWD cannot be reset during FEP=set.
46

©Copyright 2001-2017 SD Card Association
Physical Layer Simplified Specification Version 6.00
Figure 4.3.7-2 : Simplified COP Card State Diagram
47

©Copyright 2001-2017 SD Card Association
Physical Layer Simplified Specification Version 6.00
4.3.7.1.4 Lock Card Data Structure
Table 4-6 describes the structure of the command data block. Note that the host compliant to the Physical
Specification Version 5.10 or later shall set reserved bits (Bit7-5) to 0 when issuing CMD42.
Byte # Bit 7 Bit 6 Bit 5 Bit 4 Bit 3 Bit 2 Bit 1 Bit 0
0 Reserved COP ERASE LOCK_ CLR_ SET_
(shall be set to 0) UNLOCK PWD PWD
1 PWDS_LEN
2
Password data
...
PWDS_LEN + 1
Table 4-6 : Lock Card Data Structure
 COP: When set to 1, indicates Card Ownership Protection feature operations
 ERASE: 1 Defines Force Erase Operation. In byte 0, bit 3 will be set to 1 (all other bits shall be
0). All other bytes of this command will be ignored by the card.
 LOCK/UNLOCK: 1 = Locks the card. 0 = Unlock the card (note that it is valid to set this bit together
with SET_PWD but it is not allowed to set it together with CLR_PWD).
 CLR_PWD: 1 = Clears PWD.
 SET_PWD: 1 = Set new password to PWD
 PWDS_LEN: Defines the following password(s) length (in bytes). In case of a password change,
this field includes the total password lengths of old and new passwords.
The password length is up to 16 bytes. In case of a password change, the total length of the old
password and the new password can be up to 32 bytes.
 Password data: In case of setting a new password, it contains the new password. In case of a
password change, it contains the old password followed by the new password.
The data block size shall be defined by the host before it sends the card lock/unlock command. The block
length shall be set to greater than or equal to the required data structure of the lock/unlock command. In
the following explanation, changing block size by CMD16 is not a mandatory requirement for the
lock/unlock command. If preset block length is larger than length of required data structure, dummy data
shall be sent by the host for unused data area of the block.
Since block length shall always be even in DDR50 mode, the block length for CMD42 shall always be
rounded up to an even size. If CMD16 is used prior to CMD42 to set the block length, it shall always
specify an even length.
4.3.7.1.5 Command Sequences Common to COP/Non-COP Cards
The following paragraphs define the various lock/unlock command sequences common to COP/Non-
COP Cards (items relevant to COP Cards only are marked by square brackets []):
• Setting PWD
 Select a card (CMD7), if not previously selected.
 Define the block length (CMD16), given by the 8-bit card lock/unlock mode, the 8-bits password
size (in bytes), and the number of bytes of the new password. In the case that a password
replacement is done, then the block size shall consider that both passwords-the old and the new
one-are sent with the command.
 Send the Card Lock/Unlock command with the appropriate data block size on the data line
48

©Copyright 2001-2017 SD Card Association
Physical Layer Simplified Specification Version 6.00
including the 16-bit CRC. The data block shall indicate the mode (SET_PWD), the length
(PWDS_LEN) and the password itself. In the case that a password replacement is done, then the
length value (PWDS_LEN) shall include both passwords (the old and the new one) and the
password data field shall include the old password (currently used) followed by the new password.
Note that the card shall handle the calculation of the new password length internally by subtracting
the old password length from PWDS_LEN field.
 [In CMD42 ver.2.0 mode, COP Card can execute this command when COP bit=0.]
 In the case that the sent old password is not correct (not equal in size and content), then the
LOCK_UNLOCK_FAILED error bit will be set in the status register and the old password does not
change. In the case that the sent old password is correct (equal in size and content), then the
given new password and its size will be saved in the PWD and PWD_LEN registers, respectively.
Note that the password length register (PWD_LEN) indicates if a password is currently set. When it equals
0, there is no password set. If the value of PWD_LEN is not equal to zero, the card will lock itself after
power up. COP Card shall also lock itself after CMD0. Non-COP Card lock status after CMD0 is up to
implementation. It is possible to lock the card immediately in the current power session by setting the
LOCK/UNLOCK bit (while setting the password) or sending an additional command for card lock.
• Reseting PWD:
 Select a card (CMD7), if not previously selected.
 Define the block length (CMD16), given by the 8-bit card lock/unlock mode, the 8-bit password
size (in bytes), and the number of bytes of the currently used password.
 Send the card lock/unlock command with the appropriate data block size on the data line including
the 16-bit CRC. The data block shall indicate the mode CLR_PWD, the length (PWDS_LEN), and
the password itself. If the PWD and PWD_LEN content match the sent password and its size,
then the content of the PWD register is cleared and PWD_LEN is set to 0. If the password is not
correct, then the LOCK_UNLOCK_FAILED error bit will be set in the status register.
 [In CMD42 ver.2.0 mode, COP Card can execute this command when COP bit=0.]
 [If FEP is set, PWD and PWD_LEN registers shall not be affected, and the
LOCK_UNLOCK_FAILED error bit shall be set in the status register.]
 [Resetting PWD shall not affect FEP and FEP_LEN registers.]
• Locking PWD Unlocked Card:
 Select a card (CMD7), if not previously selected.
 Define the block length (CMD16), given by the 8-bit card lock/unlock mode, the 8-bit password
size (in bytes), and the number of bytes of the currently used password.
 Send the card lock/unlock command with the appropriate data block size on the data line including
the 16-bit CRC. The data block shall indicate the mode LOCK, the length (PWDS_LEN) and the
password itself.
 [In CMD42 ver.2.0 mode, COP Card can execute this command when COP bit=0.]
In PWD Unlocked state, if the PWD content is equal to the sent password, then the card will be PWD
locked and the card-locked status bit will be set in the status register. If the password is not correct,
then the LOCK_UNLOCK_FAILED error bit will be set in the status register.
Note that it is possible to set the password and to lock the card in the same sequence. In such a case,
the host shall perform all the required steps for setting the password (as described above) including the
bit LOCK set while the new password command is sent. If the password was previously set (PWD_LEN
is not 0), then the card will be PWD locked automatically after power on reset.
An attempt to lock a locked card or to lock a card that does not have a password will fail and the
LOCK_UNLOCK_FAILED error bit will be set in the status register, unless it was done during a password
definition or change operations.
49

©Copyright 2001-2017 SD Card Association
Physical Layer Simplified Specification Version 6.00
• Unlocking PWD Locked Card:
 Select a card (CMD7), if not previously selected.
 [If FEP=set, after power on reset or reset with CMD0, COP Unlock is required ( refer to Unlocking
COP locked state sequence in Section 4.3.7.1.6)]
 Define the block length (CMD16), given by the 8-bit card lock/unlock mode, the 8-bit password
size (in bytes), and the number of bytes of the currently used password PWD.
 Send the card lock/unlock command with the appropriate data block size on the data line including
the 16-bit CRC. The data block shall indicate the mode UNLOCK, the length (PWDS_LEN) and
the password itself.
 [In CMD42 ver.2.0 mode, COP Card can execute this command when COP bit=0.]
If the PWD content is equal to the sent password, then the card will be unlocked and the card-locked
status bit will be cleared in the status register. If the password is not correct, then the
LOCK_UNLOCK_FAILED error bit will be set in the status register.
Note that unlocking is done only for the current power session. As long as the PWD [or FEP] is not
cleared, the card will be locked automatically on the next power up. Only if PWD=0 [and FEP=0], the card
shall be unlocked after power on and CMD0.
An attempt to unlock an unlocked card will fail and LOCK_UNLOCK_FAILED error bit will be set in the
status register, unless it was done during PWD definition or change operation.
4.3.7.1.6 COP specific Command Sequences
The following paragraphs define the various lock/unlock command sequences applicable to COP Cards
only:
 Enabling Card Ownership Protection (COP) Function Set
If FEP=0, after power on reset or reset COP Card shall not execute any COP function of CMD42 other
than COP Unlock and shall interpret it as PWD function as defined by Table 4.3.7-1, unless it was done
after COP functions are unlocked after the power on reset or reset by the sequence below:
 Select a card (CMD7), if not previously selected.
 Define the block length (CMD16) to 1 byte (8-bit card lock/unlock command). Send the card
lock/unlock command with the appropriate data block of one byte on the data line including the 16
bit CRC. The data block shall have COP, ERASE, LOCK_UNLOCK, CLR_PWD, SET_PWD bits
set to 1.
If COP Unlock was accepted, then the card shall go to CMD42 ver.2.0 mode. While FEP=0, the only COP
function supported is set FEP. “Set PWD” command shall require COP bit to be set to 0, as described in
the Section 4.3.7.2.
Before receiving COP Unlock, COP Card is CMD42 Ver.1.0 Compatible mode and CMD42 with COP
bit=1 is ignored (except COP Unlock).
Note: For the card not supporting COP, the LOCK_UNLOCK_FAILED error bit shall be set in the status
register and the COP enabling request is rejected.
 Setting Force Erase Password (FEP):
 Unlock COP function set.
 Define the block length (CMD16), given by the 8-bit card lock/unlock mode, the 8-bits password
size (in bytes), and the number of bytes of the new password. In the case that a password
replacement is done, then the block size shall consider that both passwords-the old and the new
one-are sent with the command.
 Send the Card Lock/Unlock command with the appropriate data block size on the data line
including the 16-bit CRC. The data block shall indicate the mode (SET_PWD and COP), the length
(PWDS_LEN) and the password itself. In the case that a password replacement is done, then the
50

©Copyright 2001-2017 SD Card Association
Physical Layer Simplified Specification Version 6.00
length value (PWDS_LEN) shall include both passwords (the old and the new one) and the
password data field shall include the old password (currently used FEP) followed by the new
password. Note that the card shall handle the calculation of the new password length internally by
subtracting the old password length from PWDS_LEN field.
 In the case that the sent old password is incorrect (not equal in size and content), then the
LOCK_UNLOCK_FAILED error bit shall be set in the status register and the old password does
not change. In the case that the sent old password is correct (equal in size and content), then the
given new password and its size shall be saved in the FEP and FEP_LEN registers, respectively.
 Setting FEP automatically disables “Force Erase” and “Reset PWD” (CLR_PWD) operations. No
power cycle is required.
Note that the password length register (FEP_LEN) indicates if a FEP is currently set. When it equals 0,
there is no password set. Setting FEP is not affecting current card LOCK/UNLOCK state.
 Unlocking COP Locked State
If FEP=1, after power on reset or reset with CMD0, COP Card shall be in locked state (see Section 4.3.7.5)
and shall fail any other CMD42 parameter and LOCK_UNLOCK_FAILED error bit shall be set in the status
register, unless it was done after COP function set is unlocked after the power on reset or reset by the
sequence below:
 Select a card (CMD7), if not previously selected.
 Define the block length (CMD16) to 1 byte (8-bit card lock/unlock command). Send the card
lock/unlock command with the appropriate data block of one byte on the data line including the 16
bit CRC. The data block shall have COP, ERASE, LOCK_UNLOCK, CLR_PWD, SET_PWD bits
set to 1. This command does not require any password to be included in data block.
If COP Unlock was accepted, then COP Card shall go to CMD42 ver.2.0 mode and processing of other
CMD42 operations shall be enabled by the card. PWD commands shall require COP bit to be set to 0, as
described in the Section 4.3.7.2.
Note: For the card not supporting COP, the LOCK_UNLOCK_FAILED error bit shall be set in the status
register and the COP enabling request is rejected.
 Resetting FEP:
 Unlock COP function set, if not unlocked already.
 Define the block length (CMD16), given by the 8-bit card lock/unlock mode, the 8-bit password
size (in bytes), and the number of bytes of the currently used password.
 Send the card lock/unlock command with the appropriate data block size on the data line including
the 16-bit CRC. The data block shall indicate the mode (CLR_PWD and COP), the length
(PWDS_LEN), and the password itself. If the FEP and FEP_LEN content match the sent password
and its size, then the content of the FEP register is cleared and FEP_LEN is set to 0. If the
password is not correct, then the LOCK_UNLOCK_FAILED error bit shall be set in the status
register.
 If resetting FEP fails, FEP and FEP_LEN registers are maintained, and the
LOCK_UNLOCK_FAILED error bit shall be set in the status register.
 Resetting FEP shall not affect current card LOCK/UNLOCK state.
 Resetting FEP shall not affect PWD and PWD_LEN registers.
 Clearing FEP enables “Force Erase” and “Reset PWD” operations.
 Clearing FEP disables “FEP Force Erase” and other COP operations.
51

©Copyright 2001-2017 SD Card Association
Physical Layer Simplified Specification Version 6.00
4.3.7.1.7 Card Ownership Protection Flowcharts
Figure 4.3.7-3 presents COP protection setup sequence (left) and FEP Force Erase sequence (right).
Figure 4.3.7-4 presents Lock/Unlock operations sequence on COP Card with FEP set.
Figure 4.3.7-3 : COP Card Protection Setup (left) and FEP Force Erase (right) Sequences
52

©Copyright 2001-2017 SD Card Association
Physical Layer Simplified Specification Version 6.00
Figure 4.3.7-4 : COP Card Unlock/Lock Sequence
4.3.7.2 Parameter and the Result of CMD42
The block length shall be greater than or equal to the required data structure of CMD42; otherwise, the
result of CMD42 is undefined and the card may be in the unexpected locked state. Table 4-7 clarifies the
behavior of CMD42 for Non-COP Cards. Table 4.3.7-1 clarifies the behavior of PWD commands for COP
Card. Table 4.3.7-2 clarifies the behavior of COP specific functions for COP Card. The reserved bits in
the parameter (bit7-5 for COP Card and bit 7-4 for Non-COP Card) of CMD42 shall be don't care. In the
case that CMD42 requires the password, it is assumed that the old password and the new password are
set correctly; otherwise the card indicates an error regardless of Table 4-7 , Table 4.3.7-1 and Table
4.3.7-2. If the password length is 0 or greater than 128 bits, the card indicates an error. If errors occur
during execution of CMD42, the LOCK_UNLOCK_FAILED (Bit24 of Card Status) shall be set to 1
regardless of Table 4-7, Table 4.3.7-1 and Table 4.3.7-2. The CARD_IS_LOCKED (Bit25 of Card Status)
in the response of CMD42 shall be the same as Current Card State in Table 4-7, Table 4.3.7-1 and Table
4.3.7-2. In the field of Card Status, 0 to 1 means the card changes to Locked and 1 to 0 means the card
changes to Unlocked after execution of CMD42. It can be seen in the response of CMD13 after the
CMD42. The LOCK_UNLOCK_FAILED (Bit24 of Card Status) as the result of CMD42 can be seen in the
response of either CMD42 or the following CMD13.
53

©Copyright 2001-2017 SD Card Association
  Physical Layer Simplified Specification Version 6.00

| CMD42 Parameter in the data  | | | | | |
| --- | --- | --- | --- | --- | --- |
Bit3: ERASE      Related bits in the Card Status

| | Bit2: LOCK_UNLOCK  | | Bit25:  | CARD_IS_LOCKED  | |
| --- | --- | --- | --- | --- | --- |

| | Bit1: CLR_PWD | | Bit24:  | LOCK_UNLOCK_FAILED  | |
| --- | --- | --- | --- | --- | --- |
| | Bit0: SET_PWD | | | | |

CMD42 Parameter  Current  PWD_LEN  Result of the Function  Card Status
| | Card State | and PWD  | | | |
| --- | --- | --- | --- | --- | --- |
| Bit3  Bit2  Bit1  | Bit0 | | | | Bit25  Bit24  |
| After Power On | | Exist | The card is locked | | 1  0 |
| | | Cleared  | The card is unlocked  | | 0  0 |
| 1  0  0 | 0  Locked | Exist | Force Erase | | Table 4-8 |
| 1  0  0 | 0  Unlocked  | Exist | Error | | 0  1 |
| 1  0  0 | 0  Unlocked  | Cleared  | Error | | 0  1 |
| 0  1  0 | 0  Locked | Exist | Error | | 1  1 |
| 0  1  0 | 0  Unlocked  | Exist | Lock the card | | 0 to 1  0 |
| 0  1  0 | 0  Unlocked  | Cleared  | Error | | 0  1 |
0  1  0  1  Locked  Exist  Replace password and the card is still locked  1  0
0  1  0  1  Unlocked  Exist  Replace password and the card is locked  0 to 1  0
0  1  0  1  Unlocked  Cleared  Set Password and lock the card  0 to 1  0
0  0  1  0  Locked  Exist  Clear PWD_LEN and PWD and the card is unlocked 1 to 0  0
| 0  0  1  | 0  Unlocked  | Exist  | Clear PWD_LEN and PWD  | | 0  0  |
| --- | --- | --- | --- | --- | ----- |
0  0  1  0  Unlocked  Cleared  Error (Note *4  Refer to Table 4-10)  0  1
0  0  0  1  Locked  Exist  Replace password and the card is unlocked  1 to 0  0
0  0  0  1  Unlocked  Exist  Replace password and the card is unlocked  0  0
0  0  0  1  Unlocked  Cleared  Set password and the card is still unlocked  0  0
| 0  0  0  | 0  Locked | Exist | Unlock the card  | | 1 to 0  0  |
| --- | --- | --- | --- | --- | --- |
| 0  0  0  | 0  Unlocked  | Exist | Error | | 0  1 |
| 0  0  0  | 0  Unlocked  | Cleared  | Error | | 0  1 |
Other combinations  Don't care  Don't care  Error (Note *1  Refer to Table 4-10)  0 or 1  1
Table 4-7 : CMD42 Ver.1.0 Mode (Non-COP Card) Lock Unlock Function
| | | | | | |
| --- | --- | --- | --- | --- | --- |

54

©Copyright 2001-2017 SD Card Association
  Physical Layer Simplified Specification Version 6.00

CMD42 Parameter in the data
| | | Bit4: COP | | | Related bits in the Card Status  | |
| --- | --- | --- | --- | --- | --- | --- |
| | | Bit3: ERASE | | | Bit25:  CARD_IS_LOCKED | |
| | | Bit2: LOCK_UNLOCK  | | | Bit24:  LOCK_UNLOCK_FAILED | |

| | | Bit1: CLR_PWD | | | | |
| --- | --- | --- | --- | --- | --- | --- |
Bit0: SET_PWD

| CMD42 Parameter  | | | | | | Card Status  |
| --- | --- | --- | --- | --- | --- | --- |
Current
| | | Card  | | Result of the Function  | | |
| --- | --- | ----- | --- | --- | --- | --- |
Bit4 Bit3 Bit2 Bit1 Bit0
| | | State  |  PWD | | | Bit25 Bit24  |
| --- | --- | --- | --- | --- | --- | --- |
| | | | Exist  | The card is locked  | | 1  0 |
After Power On or Reset  Cleared  The card is unlocked  0  0
| | | | Don’t care The card is locked (If FEP is set (4)) | | | 1  0 |
| --- | ----- | --- | --- | --- | --- | --- |
| X(2) 1  | 0  0  | 0  Locked | Exist | Force Erase  (1)  | | Table 4-8  |
| X(2) 1  | 0  0  | 0  Unlocked  | Exist | Error | | 0  1 |
| X(2) 1  | 0  0  | 0  Unlocked  | Cleared | Error | | 0  1 |
X(2) 0
| | 1  0  | 0  Locked  | Exist  | Error  | | 1  1  |
| --- | ----- | --- | --- | --- | --- | ----- |
X(2)
| | 0  1  0  | 0  Unlocked  | Exist | Lock the card  | | 0 to 1 0  |
| --- | --- | --- | --- | --- | --- | --- |
| X(2) 0  | 1  0 | 0  Unlocked  | Cleared  | Error | | 0  1 |
X(2)
0  1  0  1  Locked  Exist  Replace PWD and the card is still locked  1  0
X(2) 0  1  0  1  Unlocked  Exist  Replace PWD and the card is locked  0 to 1 0
X(2)
0  1  0  1  Unlocked  Cleared  Set PWD and lock the card  0 to 1 0
X(2) 0  0  1  0  Locked  Exist  Clear PWD_LEN and PWD and the card is unlocked (1)  1 to 0 0
X(2) 0
| | 0  1  | 0  Unlocked  | Exist  | Clear PWD_LEN and PWD (1)  | | 0  0  |
| --- | ----- | --- | --- | --- | --- | ----- |
X(2)
| | 0  0  1  | 0  Unlocked  | Cleared  | Error  | | 0  1  |
| --- | --- | --- | --- | --- | --- | ----- |
X(3) 0  0  0  1  Locked  Exist  Replace PWD and the card is unlocked  1 to 0 0
X(3)
0  0  0  1  Unlocked  Exist  Replace PWD and the card is unlocked  0  0
X(3)
0  0  0  1  Unlocked  Cleared  Set PWD and the card is still unlocked  0  0
| X(2) 0  | 0  0  | 0  Locked  | Exist  | Unlock the card  | | 1 to 0 0  |
| --- | ----- | --- | --- | --- | --- | --- |
X(2)
| | 0  0  0  | 0  Unlocked  | Exist  | Error  | | 0  1  |
| --- | --- | --- | --- | --- | --- | ----- |
X(2) 0
| | 0  0  | 0  Unlocked  | Cleared  | Error  | | 0  1  |
| --- | ----- | --- | --- | --- | --- | ----- |
Table 4.3.7-1 : PWD Related Lock Unlock Function for COP Card
Notes:(1) – Disabled as long as FEP=set
           (2) - Bit4 can be set to either 0 or 1 as long as FEP=0. Bit4 shall be set to 0 as long as FEP=set.
 Functions that shall be accepted with Bit4=1 are defined by Table 4.3.7-2.
           (3) - Bit4 shall be set to 0 after CMD42[1Fh].
           (4) – If FEP=set, all CMD42 functions are blocked before receiving CMD42[1Fh].
            5  - COP Unlock (CMD42[1Fh]) enables CMD42 COP function set. No FEP is required
            6 -  CMD42[1Fh] followed by CMD42[11h]+FEP sequence is used to set FEP
| | | | | | | |
| --- | --- | --- | --- | --- | --- | --- |
Application Note:
To replace password, the host should consider following cases. When PWD_LEN and password data exist,

the card assumes old and new passwords are set in the data structure. When PWD_LEN and PWD are
cleared, the card assumes only new password is set in the data structure. In this case, the host shall not
set old password in the data structure; otherwise, unexpected password is set.

55

©Copyright 2001-2017 SD Card Association
  Physical Layer Simplified Specification Version 6.00
| CMD42 Parameter  | | | | Card Status  |
| --- | --- | --- | --- | --- |

Current
| | | PWD  FEP  | Result of the Function  | |
| --- | --- | --- | --- | --- |
Card State
| Bit4 Bit3 Bit2 Bit1 Bit0  | | | | Bit25  Bit24  |
| --- | --- | --- | --- | --- |
1  1  0  0  0  Locked  Exist  Exist  Protected Force Erase (with proper FEP)(5)   1 to 0  0
| 1  1  | 0  0  0  Locked | Cleared  Exist | Error  | 1  1  |
| ----- | --- | --- | --- | ----- |
| 1  1  | 0  0  0  Unlocked  | Don’t care Exist  | Error  | 0  1  |
1  0  0  1  0  Locked  Exist  Exist  Clear FEP and the card is still locked(5)  1  0
1  0  0  1  0  Unlocked  Don’t care Exist  Clear FEP and the card is still unlocked(5)  0  0
0
1  0  0  0  1  Locked  Exist  Don’t care Set/Replace FEP and card is still locked  1
0
1  0  0  0  1  Unlocked  Don’t care Don’t care Set/Replace FEP and the card is still unlocked 0
1  1  1  1  1  Unlocked  Don’t care Cleared  Enable Ver.2.0 function set   0  0
| 1  1  | 1  1  1  | | | 1  0  |
| ----- | --- | --- | --- | ----- |
| | Locked | Exist  Cleared  | Enable Ver.2.0 function set  | |
(COP unlock)Enable other CMD42 functions
| 1  1  | 1  1  1  Locked(1)  | Cleared  Exist  | | 1 to 0  0  |
| ----- | --- | --- | --- | --- |
card is unlocked (1)(3)
(COP unlock)Enable other CMD42 functions
| 1  1  | 1  1  1  Locked(1)  | Exist  Exist  | | 1  0  |
| ----- | --- | --- | --- | ----- |
card is PWD locked (1)(3)(4)
1  1  1  1  1  Locked(2)  Exist  Exist  Card is still locked    (2)(4)  1  1
| 1  1  | 1  1  1 | | | 0  1  |
| ----- | --- | --- | --- | ----- |
| | Unlocked  | Don’t care Exist  | Card is still unlocked  | |
 Table 4.3.7-2 : COP Specific Function for COP Card
Notes:
(1) – 1st time after Power On Reset or Reset
(2) – 2nd time or more after Power On Reset or Reset
(3) – “COP Unlock” – CMD42[1Fh] with no FEP is required to access any other CMD42 commands after power
on reset or reset, when FEP=set
(4) – If PWD is set, Unlock with PWD - CMD42[00h] is required to unlock the card after “Unlock COP”
(5) – Disabled as long as FEP=0
 6 – Commands not covered by Table 4.3.7-1 and Table 4.3.7-2 shall return LOCK_UNLOCK_ERROR
with no change to card state.

Application Note:
  To replace password, the host should consider following cases. When FEP_LEN and password data exist,
  the card assumes old and new passwords are set in the data structure. When FEP_LEN and FEP are
  cleared, the card assumes only new password is set in the data structure.

| | | | | |
| --- | --- | --- | --- | --- |

56

©Copyright 2001-2017 SD Card Association
Physical Layer Simplified Specification Version 6.00
4.3.7.3 Forcing Erase
4.3.7.3.1 Force Erase
In the case that the user forgot the password (the PWD content) it is possible to erase all the card data
content along with the PWD content. This operation is called Force Erase.
 Select a card (CMD7), if not previously selected already.
 Define the block length (CMD16) to 1 byte (8-bit card lock/unlock command). Send the card
lock/unlock command with the appropriate data block of one byte on the data line including the 16
bit CRC. The data block shall indicate the mode ERASE (the ERASE bit shall be the only bit set).
 If the ERASE bit is not the only bit set in the data field, the LOCK_UNLOCK_FAILED error bit will
be set in the status register and the erase request is rejected. If the command was accepted, then
ALL THE CARD CONTENT WILL BE ERASED including the PWD and PWD_LEN register content
and the locked card will be unlocked.
 An attempt to force erase on an unlocked card will fail and LOCK_UNLOCK_FAILED error bit will be set
in the status register.
 [If FEP=set, execution of this function is prevented, PWD and PWD_LEN registers are not cleared,
and the LOCK_UNLOCK_FAILED error bit shall be set in the status register.]
4.3.7.3.2 FEP Force Erase
In the case that FEP is set, it is possible to erase all the card data content along with the PWD content
only if FEP in known. This operation is called FEP Force Erase.
 Unlock COP function set, if not unlocked already.
 Define the block length (CMD16), given by the 8-bit card lock/unlock mode, the 8-bit password
size (in bytes), and the number of bytes of the currently used password FEP.
 Send the card lock/unlock command with the appropriate data block size on the data line including
the 16-bit CRC. The data block shall indicate the mode ERASE together with COP, the length
(PWDS_LEN) and the FEP itself. The rest of the bits shall be set to zero.
 If the ERASE and COP bits are not the only bits set in the data field, the LOCK_UNLOCK_FAILED
error bit shall be set in the status register and the erase request is rejected.
 FEP force erase is performed only if password provided matches FEP register. If password is not
provided, or incorrect, LOCK_UNLOCK_FAILED error bit shall be set in the status register and
the erase request is rejected.
 An attempt to FEP force erase on an unlocked card shall fail and LOCK_UNLOCK_FAILED error
bit shall be set in the status register.
 If the command was accepted, then ALL THE CARD CONTENT SHALL BE ERASED including
the PWD and PWD_LEN register content and the locked card shall be unlocked.
 Even FEP force erase is executed, FEP and FEP_LEN register content shall remain unchanged.
57

©Copyright 2001-2017 SD Card Association
Physical Layer Simplified Specification Version 6.00
4.3.7.3.3 Force Erase Function to the Locked Card
Table 4-8 clarifies the relation between force erase and Write Protection. The force erase does not erase
the secure area. The card shall keep its locked state during the erase execution and change to the
unlocked state after the erase of all user area is completed. Similarly, the card shall keep Temporary and
Group Write Protection during the erase execution and clear Write Protection after the erase of all user
area is completed. In the case of an erase error occurs, the card can continue force erase if the data of
error sectors are destroyed.
Write Protections
PWP: Permanent Write Protect (CSD Bit13)
TWP: Temporary Write Protect (CSD Bit12)
GWP: Group Write Protect (CMD28, CMD29, CMD30)
CMD42 Parameter PWP TWP Result of the Function Card Status
Bit3 Bit2 Bit1 Bit0 GWP Bit25 Bit24
1 0 0 0 Yes don't care Error (Note *2 Refer to Table 4-10) 1 1
1 0 0 0 No Yes Execute force erase and clear Temporary Write 1 to 0 0
Protect and Group Write Protect. (Note *3 Refer to
Table 4-10)
1 0 0 0 No No Execute force erase. 1 to 0 0
Table 4-8 : Force Erase Function to the Locked Card (Relation to the Write Protects)
4.3.7.4 Relation Between ACMD6 and Lock/Unlock State
ACMD6 is rejected when the card is locked and bus width can be changed only when the card is unlocked.
Table 4-9 shows the relation between ACMD6 and the Lock/Unlock state.
Card State Bus Mode Result of the Function
Unlocked 1-bit mode ACMD6 is accepted
Locked 1-bit mode ACMD6 is rejected and still in 1-bit mode
Unlocked 4-bit mode ACMD6 is accepted
Locked 4-bit mode ACMD6 is rejected and still in 4-bit mode. CMD0 change to 1-bit mode
Table 4-9 : Relation between ACMD6 and the Lock/Unlock State
Application Note:
After power on or reset (in 1-bit mode), if the card is locked, the SD mode host shall issue CMD42
in 1-bit mode. If the card is locked in 4-bit mode, the SD mode host shall issue CMD42 in 4-bit mode.
58

©Copyright 2001-2017 SD Card Association
Physical Layer Simplified Specification Version 6.00
4.3.7.5 Commands Accepted for Locked Card
The locked card shall accept commands listed below and return response with setting
CARD_IS_LOCKED.
1) Basic class (0)
2) Lock card class (7)
3) CMD16
4) ACMD41
5) ACMD42
All other commands including security commands are treated as illegal commands.
Note: CMD11 (Class 0) and CMD40 (Class 7) are new commands accepted in the locked card state.
CMD40 is reserved for Security Specification.
Application Note:
After power on or reset, the host can recognize the card lock/unlock state by the CARD_IS_LOCKED
in the response of CMD7 or CMD13.
4.3.7.6 Three Types of Lock/Unlock Card
There are three types of lock/unlock function-supported cards. The Type 1 is the earlier version of SD
Memory Card and the Type 2 is defined in the Physical Layer Specification Version 1.10 and higher. The
Type 3 (COP Card) is defined in Physical Layer Specification Version 5.10 and higher. Table 4-10 shows
the difference between these types of cards. The SD memory cards that support Lock/Unlock and comply
with Version 1.01, can take either Type 1 or Type 2. The SD Memory Cards that support Lock/Unlock and
comply with Version 1.10 and higher, shall take Type 2. The SD Memory Cards that support Lock/Unlock
and comply with Version 5.10 and higher, shall take Type 2 or Type 3.
Notes Type 1 Card (Earlier Version) Type 2,3 Card (New Version)
*1 in Table 4-7, Treat CMD42 Parameter=0011b as 0001b. All results are Error
Table 4.3.7-1 Treat CMD42 Parameter=0111b as 0101b.
and Table Treat CMD42 Parameter=0110b as 0010b.
4.3.7-2 Results of other combinations are Error.
*2 in Table 4-8 Execute force erase and set Permanent The result is Error
Write Protect. If force erase is completed, A priority is given to Permanent Write
the CARD_IS_LOCKED is changed from 1 Protect from force erase.
to 0. A priority is given to force erase from
Permanent Write Protect.
*3 in Table 4-8 Execute force erase but Temporary Write Execute force erase and clear
Protect and Group Write Protect are not Temporary Write Protect and Group
cleared. It should be cleared by the host. Write Protect.
*4 in Table 4-7, CMD42 Parameter=0010 and CMD42 The result is Error. Card status Bit24
Table 4.3.7-1 Parameter=0110 The result is no error. Card will be 1
and Table status Bit24 will be 0
4.3.7-2
Table 4-10 : Version Difference of Lock/Unlock Functions
59

©Copyright 2001-2017 SD Card Association
Physical Layer Simplified Specification Version 6.00
Function Non-COP Card COP Card
COP Unlock The result is Error. Card status CMD42 ver.2.0 mode is enabled according
Bit24 is 1 to Table 4.3.7-2
Set FEP PWD is set FEP is set
Clear FEP PWD_LEN and PWD is cleared FEP_LEN and FEP is cleared
PWD clear if PWD_LEN and PWD is cleared The result is Error. Card status Bit24 is 1
FEP=set
Force Erase if PWD_LEN and PWD is cleared. The result is Error. Card status Bit24 is 1
FEP=set Card content is erased
Table 4.3.7-3 : Type 3 Lock/Unlock Functions Difference
Application Note:
The host can use both types of cards without checking the difference by taking account of the following
points.
(1) The host should not set the parameters of CMD42 that return an error listed in Table 4.3.7-1 and Table
4.3.7-2. (For *1)
(2) The host should not issue a force erase command if the Permanent Write Protect is set to 1, otherwise
the Type 1 card can no longer be used even if the user remembers the password. (For *2)
(3) After the force erase, if the Temporary Write Protect is not cleared, the host should clear it. (For *3)
(4) The host should not set FEP on COP Card locked with unknown PWD.
4.3.8 Content Protection
This section is a blank in the Simplified Specification.
60

©Copyright 2001-2017 SD Card Association
Physical Layer Simplified Specification Version 6.00
4.3.9 Application-Specific Commands
4.3.9.1 Application-Specific Command – APP_CMD (CMD55)
This command, when received by the card, causes the card to interpret the following command as an
application-specific command, ACMD. The ACMD provides command extension, has the same structure
as that of regular commands and it may have the same CMD number. The card recognizes it as ACMD
by the fact that it appears after APP_CMD.
When an ACMD is not defined, the card treats it as regular command. If, as an example, a card has a
definition for ACMD13 but not for ACMD7, then, command 13 after APP_CMD is interpreted as the non-
regular CMD13 but command 7 after APP_CMD is interpreted as the regular CMD7. In order to use one
of the ACMD's, the host should be:
(1) When sending APP_CMD, the response has the APP_CMD bit set signaling to the host that ACMD
is now expected.
(2) ACMD55 does not exist. If multiple CMD55 are issued continuously, APP_CMD bit in each response
is set to 1. The command issued immediately after the last CMD55 shall be interpreted as ACMD.
When more than one command (except CMD55) is issued directly after CMD55, the first command
is interpreted as ACMD and the following commands are interpreted as regular commands
(3) If a defined ACMD is send and it is legal, the response has the APP_CMD bit set, indicating that
the accepted command is interpreted as ACMD.
(4) If an undefined ACMD is sent and it is legal, the response has the APP_CMD bit cleared, indicating
that the accepted command is interpreted as normal CMD.
(5) If a defined or undefined ACMD is sent and it is illegal, then it is handled as an illegal command.
Illegal Command Error is indicated in the next R1/R6 response and host should ignore APP_CMD
status in the response. Next command is handled as normal command.
Host shall not use undefined ACMDs as regular commands even if the specification defines it.
The following ACMD numbers are reserved for the SD Memory Card proprietary applications and shall
not be used by any SD Memory Card manufacturer:
ACMD6, ACMD13, ACMD17-26, ACMD38-49, ACMD51.
In above explanation, commands defined in the detailed command description section are "defined"
commands but not defined in the section are "Undefined" commands (Section 4.7.4 or Section 7.3.1.3
depends on bus mode). "Legal" means that a defined or undefined command is accepted at the current
state and "Illegal" means that a defined or undefined command is not accepted at the current state.
Exception in ACMD41
 The response of ACMD41 does not have APP_CMD status. Sending the response of CMD41 in idle
state means the card is accepted as legal ACMD41.
 As APP_CMD status is defined as "clear by read", APP_CMD status, which is set by ACMD41, may
be indicated in the response of next CMD11 or CMD3. However, as ACMD11 and ACMD3 are not
defined, it is not necessary to set APP_CMD status.
 Host should ignore APP_CMD status in the response of CMD11 and CMD3.
4.3.9.2 General Command - GEN_CMD (CMD56)
This section is a blank in the Simplified Specification.
61

©Copyright 2001-2017 SD Card Association
Physical Layer Simplified Specification Version 6.00
4.3.10 Switch Function Command
4.3.10.1 General
Switch function command (CMD6) is used to switch or expand memory card functions. Currently four
function groups are defined:
(1) Access Mode:
Selection of SD bus interface speed modes.
(2) Command System:
A specific function can be extended and controlled by a set of shared commands.
(3) Driver Strength
Selection of suitable output driver strength in UHS-I modes depends on host environment.
(4) Power Limit
Selection to limit the maximum power depends on host power supply capability and heat release
capability. Current Limit is re-defined as Power Limit to account for the two power supply
voltages on UHS II cards.
This was introduced in the Physical Layer Specification Version 1.10. Therefore, cards that are compatible
with earlier versions of the spec do not support it. The host should check the "SD_SPEC" field in the SCR
register to identify what version of the spec the card complies with before using CMD6. It is also possible
to check support of CMD6 by bit10 of CCC in CSD. It is mandatory for an SD memory card of Version
1.10 and higher to support CMD6.
CMD6 is valid under the "Transfer State". Once selected, via the switch command, all functions only
return to the default function after a power cycle, CMD6 (Mode 1 operation with Function 0 in each
function group) or CMD0. Executing a power cycle or issuing CMD0 will cause the card to reset to the
"idle" state and all the functions to switch back to the default function.
As a response to CMD6, the SD Memory Card will send R1 response on the CMD line and 512 bits of
status on the DAT lines. From the SD bus transaction point of view, this is a standard single block read
transaction and the time out value of this command is 100 ms, the same as in read command. If CRC
error occurs on the status data, the host should issue a power cycle.
CMD6 function switching period is within 8 clocks after the end bit of status data. When CMD6 changes
the bus behavior (i.e. access mode), the host is allowed to use the new functions (increase/decrease
CLK frequency beyond the current max CLK frequency), at least 8 clocks after at the end of the switch
command transaction (see Figure 4-14).
In response to CMD0, the switching period is within 8 clocks after the end bit of CMD0. When CMD6 has
changed the bus behavior (i.e. access mode) the host is allowed to start the initialization process, at least
8 clocks after at the CMD0.
62

©Copyright 2001-2017 SD Card Association
Physical Layer Simplified Specification Version 6.00
Check function
(Mode=0)
CMD CMD6 Res
DAT Card internal Status Data
execution
Function change timing: within 8
Switch function (Mode=1) clocks
CMD CMD6 Res
DAT Card internal Status Data
execution
Current function Switched function
Figure 4-14 : Use of Switch Command
CMD6 supports six function groups, and each function group supports sixteen branches (functions). Only
one function can be chosen and active in a given function group. Function 0 in each function group is the
default function (compatible with Spec. 1.01).
CMD6 can be used in two modes:
 Mode 0 (Check function) is used to query if the card supports a specific function or functions.
 Mode 1 (set function) is used to switch the functionality of the card.
63

©Copyright 2001-2017 SD Card Association
Physical Layer Simplified Specification Version 6.00
4.3.10.2 Mode 0 Operation - Check Function
CMD6 mode 0 is used to query which functions the card supports, and to identify the maximum
current/power consumption of the card under the selected functions.
Refer to Table 4-32: Switch function commands (class 10) for the argument definition of CMD6.
A query is done by setting the argument field of the command, as follows:
 Set the Mode bit to 0
 Select only one function in each function group. Selection of default function is done by setting
the function to 0x0. Select a specific function by using appropriate values from Table 4-11.
Selecting 0xF will keep the current function that has been selected for the function group.
 When the function in query is ready, the card returns the inquired function number, if busy, the
card returns the current function number (See Table 4-15).
In response to a query, the switch function will return the following 3 statuses (see Table 4-13):
 The functions that are supported by each of the function groups
 The function that the card will switch to in each of the function groups. This value is identical to
the provided argument if the host made a valid selection or 0xF if the selected function was invalid.
 Maximum current/power consumption under the selected functions. If one of the selected
functions was wrong, the return value will be 0.
4.3.10.3 Mode 1 Operation - Set Function
CMD6 mode 1 is used to switch the functionality of the card.
Switching to a new functionality is done by:
 Setting the Mode bit to 1
 Selecting only one function in each function group. Selection of default function is done by setting
the function to 0x0. It is recommended to specify 0xF (no influence) for all selected functions,
except for functions that need to be changed. Selecting 0xF will keep the current function for the
function group.
 When a function cannot be switched because it is busy, the card returns the current function
number (not returns 0xF), the other functions in the other groups may still be switched.
In response to a set function, the switch function will return the following 3 statuses:
 The functions that are supported by each of the function groups
 The function that is the result of the switch command. In case of invalid selection of one function
or more, all set values are ignored and no change will be done (identical to the case where the
host selects 0xF for all functions groups). The response to an invalid selection of function will be
0xF.
 Maximum current/power consumption under the selected functions. If one of the selected
functions was wrong, the return value will be 0.
64

©Copyright 2001-2017 SD Card Association
  Physical Layer Simplified Specification Version 6.00
| Arg. Slice | [23:20] | [19:16] | [15:12] | [11:8] | [7:4] | [3:0] |
| --- | --- | --- | --- | --- | --- | --- |
| Group No. | 6 | 5 | 4 | 3 | 2 | 1 |
| | | | Power | Driver | Command | Access |
| Function name  | reserved | reserved  | | | | |
| | | | Limit*3 | Strength | system | mode*1 |
| 0x0 | Default*2  | | Default*2  | Default*2  | Default*2  | Default*2 |
| | | | 0.72W | Type B | | / SDR12 |
| 0x1 | Reserved | Reserved  | 1.44W | Type A | For eC | High-Speed  |
/ SDR25
| 0x2  | Reserved  | Reserved  | 2.16W | Type C | Reserved  | SDR50 |
| ---- | --- | --- | --- | --- | --- | --- |
| 0x3  | Reserved  | Reserved  | 2.88W | Type D | OTP | SDR104  |
| 0x4  | Reserved  | Reserved  | 1.80W | Reserved  | ASSD | DDR50 |

0x5  Reserved  Reserved  Reserved  Reserved  Reserved  Reserved
0x6  Reserved  Reserved  Reserved  Reserved  Reserved  Reserved
0x7  Reserved  Reserved  Reserved  Reserved  Reserved  Reserved
0x8  Reserved  Reserved  Reserved  Reserved  Reserved  Reserved
0x9  Reserved  Reserved  Reserved  Reserved  Reserved  Reserved
0xA  Reserved  Reserved  Reserved  Reserved  Reserved  Reserved
0xB  Reserved  Reserved  Reserved  Reserved  Reserved  Reserved
0xC  Reserved  Reserved  Reserved  Reserved  (eSD)  Reserved
0xD  Reserved  Reserved  Reserved  Reserved  Reserved  Reserved
0xE  Reserved  Reserved  Reserved  Reserved  Vendor  Reserved
specific
| 0xF  | | | No influence  | | | |
| ---- | --- | --- | --- | --- | --- | --- |
Note1: Bus Speed Mode is alias of Access Mode.
Note2: "Default" of Function 0 means that a function of just after the card initialized.
Note3: Notes for Power Limit
(1) Function 2 and 3 may be used only for embedded devices.
(2) Allowed power consumption for removable cards shall be up to 1.80W, even though the Power
Limit is set to 2.16W or 2.88W.
Table 4-11 : Available Functions of CMD6

Function Group 1 is defined as Bus Speed Mode switch. If the card is initialized in 3.3V signal level,
Default Speed and High Speed are assigned to function 0 and 1. Then support bits of function 2 to 4
(SDR50, SDR104 and DDR50) are set to 0. If the card is initialized in 1.8V signal level, SDR and DDR
modes are assigned from function 0 to function 4.

Function Group 2 is defined for Command System extension. CMD34-37, CMD50 and CMD57 are
reserved for SD command system. OTP and ASSD are added. Refer to Part A1 Advanced Security
Extension (McEX), Part 1 OTP Addendum and Part A3 ASSD Core Specification for more detail.

Function Group 3 is defined as driver strength selection for UHS-I modes. This switch is effective in 1.8V
signaling mode.

Function Group 4 is defined as Power Limit switch for total card power consumable. This field is set

according to host power supply capability.
For SDIO Combo Cards, refer to SDIO specification to set the total card power consumable.

65

©Copyright 2001-2017 SD Card Association
Physical Layer Simplified Specification Version 6.00
The Power Limit is defined in accordance with the Mechanical Addenda that define thermal requirements
as a function of total card power consumption.
This Function Group is used for any bus mode including UHS-I and UHS-II modes. The default value
of the Power Limit is 0.72W (minimum setting). In Legacy SD and UHS-I cards that have only VDD1
and not VDD2, this translates to 200mA at 3.6V.
In UHS-I mode, after selecting one of SDR50, SDR104 or DDR50 mode by Function Group 1, host
needs to change the Power Limit to enable the card to operate in higher performance. In UHS-II
mode, the host needs to change the Power Limit after finishing initialization to enable the card to
operate in higher performance. Total card power is the sum of VDD1 and VDD2 power consumption.
In the other cases which may consume power by some function operations, such functions should
have a function enable method (it will be defined in each Function Specification). After setting Power
Limit, functions should be enabled by the function initialization. In case a function is not provided with
enough power, it will fail initialization and the function is disabled by the card. If a function does not
have a function enable method, the function shall work in 0.72W.
Power restriction described in Table 3-6, Table 3-9.
Function 0-F F0 F1 F2 F3 F4 F5-FE FF
Non UHS Mode 1 X X X X 0 ..... 0 1
UHS Mode 1 1 1 1 1 0 ..... 0 1
Note 1: Same values are assigned to all X's: either 0 or 1.
Note 2: For Card compliant to Ver3.0x, all X are equal to 0 in Non UHS Mode and
the support bit for F4 is set to 0 in UHS Mode.
For example, in UHS-I card, when the maximum power of a card is 1.08W (300mA at 3.6V on VDD1),
the card operates at up to 0.72W (200mA at 3.6V on VDD1) when the Current Limit is set to 0.72W and
up to 1.08W when Power Limit is set to 1.44W, 1.80W (and when Function 3 is selected).
Function Group 4 Max. Allowed Power Max. Current of Max. Current of
Power Limit (VDD1 and VDD2) VDD1 VDD2
Function 0 0.72W 200mA 200mA
Function 1 1.44W 400mA 200mA
Function 2 2.16W 600mA Note 6
Function 3 2.88W 800mA Note 6
Function 4 1.80W 400mA 200mA
Note 1: Max. Allowed Power is defined as total of VDD1 and VDD2 power per card at the maximum
voltage: 3.6V for VDD1 and 1.95V for VDD2.
Note 2: UHS-I Card is up to 1.44W even if one of Function 2, 3 or 4 is selected. 1.80W is defined for
UHS-II mode.
Note 3: Function 2 and 3 cannot be used in UHS-II mode.
Note 4: UHS Host should support power supply capability of 400mA for VDD1 and 200mA for VDD2.
VDD1 only Host should set to Function 0 or 1.
Note 5: Host needs to support VDD2 to use UHS-II or NFC supported cards.
Note 6: Max. Current of VDD2 for embedded device will be provided by device vendor.
Table 4-12 : Power Limit and Current Limit of VDD1 and VDD2
66

©Copyright 2001-2017 SD Card Association
Physical Layer Simplified Specification Version 6.00
Application Notes:
Default setting is 0.72W. In this mode, UHS-I and UHS-II card may not provide the maximum
performance. The Speed Grade performance is defined at 1.44W mode. The maximum
performance of the card is available when setting of this field covers the maximum current (power)
of the card that can be read by CMD6 mode 0.
Host determines setting of this field by the host power supply capability to the card, heat release
capability of host and the maximum current of a connector. Refer to the Mechanical Addenda for
more details.
The followings are requirements in UHS-II mode,
(1) Function Group 1 and 3 are not used.
(2) Support of Function Group 2 is optional.
(3) Support of Function Group 4 is mandatory.
67

©Copyright 2001-2017 SD Card Association
  Physical Layer Simplified Specification Version 6.00
4.3.10.4 Switch Function Status
The switch function status is the returned data block that contains function and current consumption
information. The block length is predefined to 512 bits and the use of SET_BLK_LEN command is not
necessary. Table 4-13 describes the status data structure.

The  status  bits  of  the  response  contain  the  information  of  the  function  group.  Maximum  current
consumption  will  be  used  only  for  the  new  function  added  through  this command.  In  this  case,
VDD_R_CURR_MIN, VDD_W_CURR_MIN, VDD_R_CURR_MAX and VDD_W_CURR_MAX values in
the CSD register provides the current consumption when all card functions are set to the default state
and can be used by spec 1.01 compatible hosts.

| Bits  | | | Description  | Width  |
| ----- | --- | --- | --- | --- |
511:496  Maximum Current/Power Consumption
This field indicates total current/power consumption of the card including
enabled functions selected by the Function Selection ([399:376] bits) dependent
on selected Bus Speed Mode.
The host should check the maximum current consumption by mode 0 operation
and verify that it can supply the necessary current/power before executing
mode 1 operation.
Especially in UHS-I or UHS-II mode, this field is related to Current Limit / Power
Limit setting. CMD6 mode 0 indicates the maximum current/power of a selected
bus speed mode regardless of the setting of Current Limit / Power Limit. CMD6
mode 1 indicates the maximum current/power of a selected bus speed mode
depending on the setting of Current Limit.

Definition for SD I/F Mode
| | Value | Maximum Current(Power) Consumption at 3.6V  | | |
| --- | --- | --- | --- | --- |
| | 0 | Error | | |
| | 1 | 1mA (3.6mW) | | |
| | 2 | 2mA (7.2mW) | | |
| | 3 | 3mA (10.8mW) | | |
| | ......  | ...... | | 16  |
| | 65,535  | 65,535mA  (235926mW) | | |

The voltage to calculate current consumption is defined at 3.6V.
Maximum current consumption is average over 1second.

Definition for UHS-II Mode
For UHS-II Card, this field is defined as Maximum Power Consumption. Total
maximum power consumption of V  and V  is indicated. The definition of
DD1 DD2
Power Consumption in this field is equivalent to Current Consumption at 3.6V.
Refer to Current Limit / Power Limit in Section 4.3.10.3 about the relation
between power and current of VDD1 and VDD2.

| | Value | Maximum Power Consumption  | | |
| --- | --- | --- | --- | --- |
| | 0 | Error | | |
| | 1 | 3.6mW (= 1mA x 3.6V) | | |
| | 2 | 7.2mW (= 2mA x 3.6V) | | |
| | 3 | 10.8mW (= 3mA x 3.6V) | | |
| | ......  | ...... | | |

| | 65,535  | 235926mW  | | |
| --- | --- | --- | --- | --- |

68

©Copyright 2001-2017 SD Card Association
Physical Layer Simplified Specification Version 6.00
Bits Description Width
495:480 Support Bits of Functions in Function Group 6
Each bit corresponds to a function. Function 15 and 0 are always enabled. 16
If a bit 480+i is set, function i is supported (i = Function 15 to 0)
479:464 Support Bits of Functions in Function Group 5
Each bit corresponds to a function. Function 15 and 0 are always enabled. 16
If a bit 464+i is set, function i is supported (i = Function 15 to 0)
463:448 Support Bits of Functions in Function Group 4
Each bit corresponds to a function. Function 15 and 0 are always enabled. 16
If a bit 448+i is set, function i is supported (i = Function 15 to 0)
447:432 Support Bits of Functions in Function Group 3
Each bit corresponds to a function. Function 15 and 0 are always enabled. 16
If a bit 432+i is set, function i is supported (i = Function 15 to 0)
431:416 Support Bits of Functions in Function Group 2
Each bit corresponds to a function. Function 15 and 0 are always enabled. 16
If a bit 416+i is set, function i is supported (i = Function 15 to 0)
415:400 Support Bits of Functions in Function Group 1
Each bit corresponds to a function. Function 15 and 0 are always enabled. 16
If a bit 400+i is set, function i is supported (i = Function 15 to 0)
399:396 Function Selection of Function Group 6
mode 0 - The function which can be switched in function group 6.
4
mode 1 - The function which is result of the switch command, in function group 6.
0xF shows function set error with the argument.
395:392 Function Selection of Function Group 5
mode 0 - The function which can be switched in function group 5.
4
mode 1 - The function which is result of the switch command, in function group 5.
0xF shows function set error with the argument.
391:388 Function Selection of Function Group 4
mode 0 - The function which can be switched in function group 4.
4
mode 1 - The function which is result of the switch command, in function group 4.
0xF shows function set error with the argument.
387:384 Function Selection of Function Group 3
mode 0 - The function which can be switched in function group 3.
4
mode 1 - The function which is result of the switch command, in function group 3.
0xF shows function set error with the argument.
383:380 Function Selection of Function Group 2
mode 0 - The function which can be switched in function group 2.
4
mode 1 - The function which is result of the switch command, in function group 2.
0xF shows function set error with the argument.
379:376 Function Selection of Function Group 1
mode 0 - The function which can be switched in function group 1.
4
mode 1 - The function which is result of the switch command, in function group 1.
0xF shows function set error with the argument.
375:368 Data Structure Version
00h – bits 511:376 are defined
8
01h – bits 511:272 are defined
02h-FFh – reserved
367:352 Reserved for Busy Status of functions in group 6
16
If bit [i] is set, function [i] is busy. This field can be read in mode 0 and mode 1
351:336 Reserved for Busy Status of functions in group 5
16
If bit [i] is set, function [i] is busy. This field can be read in mode 0 and mode 1
69

©Copyright 2001-2017 SD Card Association
  Physical Layer Simplified Specification Version 6.00
| Bits | | | Description  | | | | Width  |
| --- | --- | --- | --- | --- | --- | --- | --- |
| 335:320  | Reserved for Busy Status of functions in group 4  | | | | | | |
16
If bit [i] is set, function [i] is busy. This field can be read in mode 0 and mode 1
| 319:304  | Reserved for Busy Status of functions in group 3  | | | | | | |
| --- | --- | --- | --- | --- | --- | --- | --- |
16
If bit [i] is set, function [i] is busy. This field can be read in mode 0 and mode 1
| 303:288  | Busy Status of functions in group 2  | | | | | | |
| --- | --- | --- | --- | --- | --- | --- | --- |
16
If bit [i] is set, function [i] is busy. This field can be read in mode 0 and mode 1
| 287:272  | Reserved for Busy Status of functions in group 1  | | | | | | |
| --- | --- | --- | --- | --- | --- | --- | --- |
16
If bit [i] is set, function [i] is busy. This field can be read in mode 0 and mode 1
| 271:0  | Reserved (All '0')  | | | | | | 272  |
| --- | --- | --- | --- | --- | --- | --- | ---- |

Table 4-13 : Status Data Structure

4.3.10.4.1 Busy Status Indication for Functions
Each bit [367-272] shows the busy status of corresponding functions; 0 indicates ready and 1 indicates
busy. While the status is busy, the host should not change the corresponding function. Switch command
mode 1 can be applied only to ready functions.
If the function failed to be switched in mode 1 operation and returns the current function number in the
response, the function is considered busy. The mode 1 operation may affect the behavior of a function.
The mode 0 operations should be used to check the busy status of a function because it does not affect
its behavior, especially, for function group 2 as defined below.

Function Group 2
303  302  301  300  299  298  297  296  295  294  293  292  291  290  289  288
| 0  VS  | 0  0  | 0  0  | 0  0  | 0  0  | 0  ASSD  | 0  0  | eC  0  |
| --- | ----- | ----- | ----- | ----- | --- | ----- | --- |
Note: 0: Ready 1: Busy
Figure 4-15 : Busy Status of 'Command System'

4.3.10.4.2 Data Structure Version
Data Structure Version indicates effective bit fields of the Switch Function Status. The cards can set either
00h or 01h. When this field is set to 01, busy status indication is effective.

| | Data Structure Version  | | | Fields of Status Data Structure  | | | |
| --- | --- | --- | --- | --- | --- | --- | --- |
| | 00h | | | 511:376 are defined | | | |
| | 01h | | | 511:272 are defined | | | |
| | 02h-FFh | | | Reserved | | | |
Table 4-14 : Data Structure Version

4.3.10.4.3 Function Table of Switch Command
Table 4-15, Table 4-16 and Table 4-17 shows possible combinations of the function switch.
"Argument" indicates 4-bit code specified in the argument of switch command (bits 23-0). "Busy Status"
indicates the function is busy as defined below.
"Status Code" indicates 4-bit code in the Status Data Structure, bits 399-376.

| | | | | | | | |
| --- | --- | --- | --- | --- | --- | --- | --- |

70

©Copyright 2001-2017 SD Card Association
  Physical Layer Simplified Specification Version 6.00

| | Argument  | Busy Status  | Status Code  | | Comment  | | |
| --- | --- | --- | --- | --- | --- | --- | --- |
Status indicates a default function, which is
| | 0 | Don't Care  | 0 | | | | |
| --- | --- | --- | --- | --- | --- | --- | --- |
always supported.
Status indicates that the function specified in
| | | Ready  | =Arg.  | the  argument  | is  supported  | and  can  | be  |
| --- | --- | --- | --- | --- | --- | --- | --- |
switched.
Supported function
Status indicates that the function specified in
Current
| | | Busy  | | the  argument  | is  supported  | but  cannot  | be  |
| --- | --- | ----- | --- | --- | --- | --- | --- |
Selected
switched because the function is busy.
Status indicates that the function specified in
| Not Supported function  | | Don't Care  | Fh  | | | | |
| --- | --- | --- | --- | --- | --- | --- | --- |
the argument is not supported.
Current
| | Fh  | Don't Care  | | Status indicates current selected function  | | | |
| --- | --- | --- | --- | --- | --- | --- | --- |
Selected
Table 4-15 : Status Code of Mode 0 to Supported Function Group

| | Argument  | Busy Status  | Status Code  | | Comment  | | |
| --- | --- | --- | --- | --- | --- | --- | --- |
| | 0 | Don't Care | 0 | Default function can always be switched.  | | | |
Status indicates the same function number as
| | | Ready  | =Arg. | specified | in  the  argument,  | which  | means  |
| --- | --- | --- | --- | --- | --- | --- | --- |
| Supported function  | | | | successful function change. | | | |
| | | | Current  | Switch function is canceled and status indicates  | | | |
Busy
| | | | Selected  | current selected function.  | | | |
| --- | --- | --- | --- | --- | --- | --- | --- |
If one of the function groups indicates an error
Not Supported  code (Fh), switch requests to all switch functions
| | | Don't Care  | Fh  | | | | |
| --- | --- | --- | --- | --- | --- | --- | --- |
function  are canceled and the rest of the data in the Status
Data Structure should be ignored.
Current
| | Fh  | Don't Care  | | Status indicates current selected function  | | | |
| --- | --- | --- | --- | --- | --- | --- | --- |
Selected
Table 4-16 : Status Code of Mode 1 to Supported Function Group

| | Argument  | Busy Status  | Status Code  | | Comment  | | |
| --- | --- | --- | --- | --- | --- | --- | --- |
| | 0 | Don't Care | 0 | Status always indicates 0. | | | |
| | Eh-1h | Don't Care | Fh | Status always indicates Fh.  | | | |
| | Fh | Don't Care | 0 | Status always indicates 0. | | | |
Table 4-17 : Status Code of Mode 0 and 1 to Unsupported Function Group

71

©Copyright 2001-2017 SD Card Association
Physical Layer Simplified Specification Version 6.00
4.3.10.5 Relationship between CMD6 Data and Other Commands
This section is a blank in the Simplified Specification.
Figure 4-16 : CMD12 during CMD6; Case 1
Figure 4-17 : CMD12 during CMD6; Case 2
4.3.10.6 Switch Function Flow Example
This section is a blank in the Simplified Specification.
Figure 4-18 : Example of Switch Function flow
Figure 4-19 : Switching Function Flow
4.3.10.7 Example of Checking
This section is a blank in the Simplified Specification.
4.3.10.8 Example of Switching
This section is a blank in the Simplified Specification.
72

©Copyright 2001-2017 SD Card Association
Physical Layer Simplified Specification Version 6.00
4.3.11 High-Speed Mode (25 MB/sec interface speed)
Although the Rev 1.01 SD memory card supports up to 12.5 MB/sec interface speed, the speed of 25
MB/sec is necessary to support increasing performance needs of the host and because memory size
continues to grow.
To achieve the 25 MB/sec interface speed, the clock rate is increased to 50 MHz and CLK/CMD/DAT
signal timing and circuit conditions are reconsidered and changed from the Physical Layer Specification
Version 1.01.
After power up, the SD memory card is in the default speed mode, and by using Switch Function
command (CMD6), the Version 1.10 and higher SD memory card can be placed in High-Speed mode.
The High-Speed function is a function in the access mode group (see Table 4-11). Supporting High-Speed
mode is optional.
Because it is not possible to control two cards or more in the case that each of them has a different timing
mode (Default and High-Speed mode) and in order to satisfy severe timing, the host shall drive only one
card. CLK/CMD/DAT signal shall be connected in 1-to-1 between the host and the card.
4.3.12 Command System
SD commands CMD34-37, CMD50, and CMD57 are reserved for SD command system expansion via
the switch command. Switching between the various functions of the command system function group,
will change the interpretation and associated bus transaction (i.e. command without data transfer, single
block read, multiple block write, etc.) of these commands. Supporting Command system is optional
 When the "standard command set" (default function 0x0) is selected, these commands will not be
recognized by the card and will be considered as illegal commands (as defined in the Physical
Layer Specification Version 1.01)
 When the "vendor specific" (function 0xE) is selected, the behaviors of these commands are ven-
dor specific. They are not defined by this standard and may change for different card vendors.
 When the "mobile e-commerce" (function 0x1) is selected, the behavior of these commands is
governed by the SD Specifications Part A1: Mobile Commerce Extension Specification.
When either of these extensions is used, special care should be given to proper selection of the command
set function; otherwise, the host command may be interpreted incorrectly.
All other commands of the SD memory card (not reserved for the switch commands) are always available
and will be executed as defined in this document regardless of the currently selected commands set.
73

©Copyright 2001-2017 SD Card Association
  Physical Layer Simplified Specification Version 6.00
4.3.13 Send Interface Condition Command (CMD8)
CMD8 (Send Interface Condition Command) is defined to initialize SD Memory Cards compliant to the
Physical Layer Specification Version 2.00 or later. CMD8 is valid when the card is in Idle state. This
command has two functions.

  Voltage check:
Checks whether the card can operate on the host supply voltage.
  Enabling expansion of existing command and response:
Reviving CMD8 enables to expand new functionality to some existing commands by redefining
previously reserved bits. ACMD41 was expanded to support initialization of SDHC Card and the
expansion is also applied to SDXC Card.

Table 4-18 shows the format of CMD8.

Bit position  47  46  [45:40]  [39:20]  [19:16]  [15:8]  [7:1]  0
| Width (bits)  | 1 | 1 | 6 | 20 | 4 | 8 | 7  1 |
| --- | ---- | ---- | --- | --- | --- | --- | --- |
| Value | '0'  | '1'  | '001000'  | '00000h'  | x | x | x  '1'  |
Voltage
| | Start  Transmission  | | Command  | Reserved  | | Check | |
| --- | --- | ---- | --- | --- | --- | --- | --- |
| Description  | | | | | supplied  | | CRC7  End bit  |
| | bit | bit  | index | bits | | pattern  | |
(VHS)

| | | | Voltage Supplied  | | Value Definition | | |
| --- | --- | --- | --- | --- | --- | --- | --- |
| | | | 0000b | | Not Defined | | |
| | | | 0001b | | | 2.7-3.6V  | |
| | | | 0010b | | Reserved for Low Voltage Range  | | |
| | | | 0100b | | | Reserved  | |
| | | | 1000b | | | Reserved  | |
| | | | Others | | Not Defined | | |
Table 4-18 : Format of CMD8

When the card is in Idle state, the host shall issue CMD8 before ACMD41. In the argument, 'voltage
supplied' is set to the host supply voltage and 'check pattern' is set to any 8-bit pattern.
The card checks whether it can operate on the host's supply voltage. The card that accepted the supplied
voltage returns R7 response. In the response, the card echoes back both the voltage range and check
pattern set in the argument. If the card does not support the host supply voltage, it shall not return
response and stays in Idle state.

Refer to Low Voltage Interface Addendum for VHS Value Definition during LV initialization.

A part of this section is not described.
Table 4-19 : Card Operation for CMD8 in SD Mode

| | | | | | | | |
| --- | --- | --- | --- | --- | --- | --- | --- |

74

©Copyright 2001-2017 SD Card Association
Physical Layer Simplified Specification Version 6.00
4.3.14 Command Functional Difference in Card Capacity Types
CCS in the response of ACMD41 determines card capacity types: CCS=0 is SDSC and CCS=1 is SDHC
or SDXC.
Memory access commands include block read commands (CMD17, CMD18), block write commands
(CMD24, CMD25), and block erase commands (CMD32, CMD33).
Following are the functional differences of memory access commands between SDSC and SDHC, SDXC:
 Command Argument
SDHC and SDXC use the 32-bit argument of memory access commands as block address
format. Block length is fixed to 512 bytes regardless CMD16,
SDSC uses the 32-bit argument of memory access commands as byte address format. Block
length is determined by CMD16,
i.e.:
(a) Argument 0001h is byte address 0001h in the SDSC and 0001h block in SDHC and SDXC
(b) Argument 0200h is byte address 0200h in the SDSC and 0200h block in SDHC and SDXC
 Partial Access and Misalign Access
SDHC and SDXC disable Partial access and Misalign access (crossing physical block boundary)
as the block address is used. Access is only granted based on block addressing.
 Set Block Length
SDHC and SDXC use 512-byte fixed block length for memory access commands regardless of
the block length set by CMD16. The setting of the block length does not affect the memory
access commands. CMD42 is not classified as a memory access command. The data block size
shall be specified by CMD16 and the block length can be set up to 512 bytes. Setting block
length larger than 512 bytes sets the BLOCK_LEN_ERROR error bit regardless of the card
capacity.
 Write Protected Group
SDHC and SDXC do not support write-protected groups. Issuing CMD28, CMD29 and CMD30
generates the ILLEGAL_COMMAND error.
75

©Copyright 2001-2017 SD Card Association
Physical Layer Simplified Specification Version 6.00
4.4 Clock Control
The SD Memory Card bus clock signal can be used by the host to change the cards to energy saving
mode or to control the data flow (to avoid under-run or over-run conditions) on the bus. The host is allowed
to lower the clock frequency or shut it down. For example, in the case that a host with 512 Bytes of data
buffer would like to transfer data to a card with 1 KByte write blocks. So, to preserve a continuous data
transfer, from the card's point of view, the clock to the card shall be stopped after the first 512 Bytes. Then
the host will fill its internal buffer with another 512 Bytes. After the second half of the write block is ready
in the host, it will continue the data transfer to the card by re-starting the clock supply. In such a way, the
card does not recognize any interruptions in the data transfer.
There are a few restrictions the host shall consider:
 The bus frequency can be changed at any time (under the restrictions of maximum data transfer
frequency and the identification frequency defined by the specification document).
 An exemption to the above is ACMD41 (SD_APP_OP_COND). After issuing the command
ACMD41, the following 1) or 2) procedures shall be done by the host until the card becomes ready.
1) Issue continuous clock in the frequency range of 100 KHz-400 KHz.
If the host wants to stop the clock, poll busy bit by ACMD41 command at less than 50 ms intervals.
100KHz-400KHz clocks
CLK
1)
1st 2nd 3rd
CMD
(ACMD41 )
Polling less than 50ms interval
CLK
2) < 50ms < 50ms
1st 2nd 3rd
CMD
(ACMD41 )
 It is an obvious requirement that the clock shall be running for the card to output data or response
tokens. After the last SD Memory Card bus transaction, the host is required, to provide 8 (eight)
clock cycles for the card to complete the operation before shutting down the clock. Following is a
list of the various bus transactions:
•A command with no response. 8 clocks after the host command end bit.
•A command with response. 8 clocks after the card response end bit.
•A read data transaction. 8 clocks after the end bit of the last data block.
•A write data transaction. 8 clocks after the CRC status token.
 The host is allowed to shut down the clock of a "busy" card. The card will complete the program-
ming operation regardless of the host clock. However, the host shall provide a clock edge for the
card to turn off its busy signal. Without a clock edge, the card (unless previously disconnected by
a deselect command -CMD7) will force the DAT line down forever.
76

©Copyright 2001-2017 SD Card Association
Physical Layer Simplified Specification Version 6.00
4.5 Cyclic Redundancy Code (CRC)
The CRC is intended to protect SD Memory Card commands, responses, and data transfer against
transmission errors on the SD Memory Card bus. One CRC is generated for every command and checked
for every response on the CMD line. For data blocks, one CRC per transferred block is generated. The
CRC is generated and checked as described in the following.
• CRC7
The CRC7 check is used for all commands, for all responses except type R3, and for the CSD and CID
registers. The CRC7 is a 7-bit value and is computed as follows:
Generator polynomial: G(x) = x7 + x3 + 1.
M(x) = (first bit) * xn + (second bit) * xn-1 +...+ (last bit) * x0
CRC[6...0] = Remainder [(M(x) * x7)/G(x)]
The first bit is the most left bit of the corresponding bit string (of the command, response, CID or CSD).
The degree n of the polynomial is the number of CRC protected bits decreased by one. The number of
bits to be protected is 40 for commands and responses (n = 39), and 120 for the CSD and CID (n = 119).
data out
data in
Figure 4-20 : CRC7 Generator/Checker
• CRC7 Examples
The CRC section of the command/response is bolded.
CMD0 (Argument=0) --> 01 000000 00000000000000000000000000000000 "1001010" 1
CMD17 (Argument=0) --> 01 010001 00000000000000000000000000000000 "0101010" 1
Response of CMD17 --> 00 010001 00000000000000000000100100000000 "0110011" 1
77

©Copyright 2001-2017 SD Card Association
Physical Layer Simplified Specification Version 6.00
• CRC16
In the case of one DAT line usage, the CRC16 is used for payload protection in block transfer mode. The
CRC check sum is a 16-bit value and is computed as follows:
Generator polynomial G(x) = x16 +x12 +x5 +1
M(x) = (first bit) * xn + (second bit)* xn-1 +...+ (last bit) * x0
CRC[15...0] = Remainder [(M(x) * x16)/G(x)]
The first bit is the first data bit of the corresponding block. The degree n of the polynomial denotes the
number of bits of the data block decreased by one (e.g. n = 4095 for a block length of 512 bytes). The
generator polynomial G(x) is a standard CCITT polynomial. The code has a minimal distance d=4 and is
used for a payload length of up to 2048 Bytes (n <= 16383).
The same CRC16 method shall be used in single DAT line mode and in wide bus mode.
In wide bus mode, the CRC16 is done on each line separately.
data out
data in
Figure 4-21 : CRC16 Generator/Checker
• CRC16 Example
512 bytes with 0xFF data --> CRC16 = 0x7FA1
78

©Copyright 2001-2017 SD Card Association
Physical Layer Simplified Specification Version 6.00
4.6 Error Conditions
4.6.1 CRC and Illegal Command
All commands are protected by CRC (cyclic redundancy check) bits. If the addressed card's CRC check
fails, the card does not respond and the command is not executed. The card does not change its state,
and COM_CRC_ERROR bit is set in the status register.
Similarly, if an illegal command has been received, a card shall not change its state, shall not response
and shall set the ILLEGAL_COMMAND error bit in the status register. Only the non-erroneous state
branches are shown in the state diagrams (see Figure 4-1 and Figure 4-13).
Table 4-35 contains a complete state transition description.
There are different kinds of illegal commands:
 Commands that belong to classes not supported by the card (e.g. write commands in read only
cards).
 Commands not allowed in the current state (e.g. CMD2 in Transfer State).
 Commands that are not defined (e.g. CMD5).
4.6.2 Read, Write and Erase Timeout Conditions
A card shall complete the command within the time period defined as follows or give up and return an
error message. If the host does not get any response with the given timeout it should assume that the
card is not going to respond and try to recover (e.g. reset the card, power cycle, reject, etc.).
4.6.2.1 Read
For a Standard Capacity SD Memory Card, the times after which a timeout condition for read operations
occurs are (card independent) either 100 times longer than the typical access times for these operations
given below or 100 ms (the lower of the two). The read access time is defined as the sum of the two
times given by the CSD parameters TAAC and NSAC (see Section 5.3). In the case of a single read
operation, these card parameters define the typical delay between the end bit of the read command and
the start bit of the data block. In the case of a multiple-read operation, they also define the typical delay
between the end bit of a data block and the start bit of next data block.
A High Capacity SD Memory Card and Extended Capacity SD Memory Card indicate TAAC and NSAC
as fixed values. The host should use 100 ms timeout (minimum) for single and multiple read operations
rather than using TAAC and NSAC.
4.6.2.2 Write
For a Standard Capacity SD Memory Card, the times after which a timeout condition for write operations
occurs are (card independent) either 100 times longer than the typical program times for these
operations given below or 250 ms (the lower of the two). The R2W_FACTOR field in the CSD is used
to calculate the typical block program time obtained by multiplying the read access time by this factor. It
applies to all write commands (e.g. SET(CLR)_WRITE_PROTECT, PROGRAM_CSD and the block write
commands). High Capacity SD Memory Card and Extended Capacity SD Memory Card indicate
R2W_FACTOR as a fixed value.
In case of High Capacity SD Memory Card, maximum length of busy is defined as 250ms for all write
operation.
While the card should try to maintain that busy indication of write operation does not exceed 250ms in
the case of SDXC card, if the card is not possible to maintain operations with 250ms busy, the card can
indicate write busy up to 500ms including single and multiple block write in the following scenarios:
a) The last busy in any write operation up to 500ms including single and multiple block write.
b) When multiple block write is stopped by CMD12, the busy from the response of CMD12 is up to
500ms.
c) When multiple block write is stopped by CMD23, the busy after the last data block is up to 500ms.
79

©Copyright 2001-2017 SD Card Association
Physical Layer Simplified Specification Version 6.00
d) Busy indication at block gap in multiple block write is up to 250ms except a following case. When
the card executes consecutive two blocks write (2*512Bytes) and it spans across the physical block
boundary, the busy after the each block can be indicated up to 500ms.
Especially regardless of the above definition, a speed class writing mode specified by CMD20 shall keep
write busy up to 250ms in any case until the end of speed class write is indicated.
There are two types of busies in a multiple block write operation.
(1) Write busy at block gap (without CMD12) is maximum 250ms
(2) Write busy after CMD12 is maximum 250ms (500ms for SDXC)
If CMD12 is issued during a multiple block write operation's busy period, the host timeout counter is reset
and the 250ms (500ms for SDXC) timeout period is measured from the response of CMD12.
In UHS-II mode, data is transferred by the unit of Data Burst. Data Burst consists of one or multiple data
blocks and is determined depends on capability of host and card. Busy is not indicated after every block
but indicated after every Data Burst. The maximum busy length after Data Burst is defined as 1 second.
Refer to UHS-II Addendum about Data Burst for more details.
Application Notes:
The host should use a fixed timeout for write operations rather than using a timeout calculated from
the R2W_FACTOR parameter.
It is strongly recommended for hosts to implement more than 500ms timeout value even if the card
indicates the 250ms maximum busy length.
Even if the card supports Speed Class, any multiple block write operation may indicate a busy period
of up to a maximum of 250ms. The sum of the busy periods over an AU is limited by Speed Class.
In UHS-II mode, refer to the UHS-II Addendum about host timeout setting.
4.6.2.3 Erase
If the card supports parameters for erase timeout calculation in the SD Status, the host should use them
to determine erase timeout (see Section 4.10.2). If the card does not support these parameters, erase
timeout can be estimated by block write delay.
The duration of an erase command can be estimated by the number of write blocks (WRITE_BL) to be
erased multiplied by 250 ms.
80

©Copyright 2001-2017 SD Card Association
Physical Layer Simplified Specification Version 6.00
4.7 Commands
SD Commands applicable to UHS-II are defined in the UHS-II Addendum.
4.7.1 Command Types
There are four kinds of commands defined to control the SD Memory Card:
 Broadcast commands (bc), no response - The broadcast feature is only if all the CMD lines are
connected together in the host. If they are separated, then each card will accept it separately in
its turn.
 Broadcast commands with response (bcr)
response from all cards simultaneously - Since there is no Open Drain mode in SD Memory
Card, this type of command shall be used only if all the CMD lines are separated - the command
will be accepted and responded by every card separately.
 Addressed (point-to-point) commands (ac)
no data transfer on DAT
 Addressed (point-to-point) data transfer commands (adtc)
data transfer on DAT
All commands and responses are sent over the CMD line of the SD Memory Card. The command
transmission always starts with the left bit of the bit string corresponding to the command codeword.
4.7.2 Command Format
All commands have a fixed code length of 48 bits.
Bit position 47 46 [45:40] [39:8] [7:1] 0
Width (bits) 1 1 6 32 7 1
Value '0' '1' x x x '1'
Description Start bit Transmission bit Command index Argument CRC7 End bit
Table 4-20 : Command Format
A command always starts with a start bit (always 0), followed by the bit indicating the direction of
transmission (host = 1). The next 6 bits indicate the index of the command, this value being interpreted
as a binary coded number (between 0 and 63). Some commands need an argument (e.g. an address),
which is coded by 32 bits. A value denoted by 'x' in the table above indicates this variable is dependent
on the command. All commands are protected by a CRC (see Section 4.5 for the definition of CRC7).
Every command codeword is terminated by the end bit (always 1). All commands and their arguments
are listed in Table 4-23 to Table 4-33.
4.7.3 Command Classes
The command set of the SD Memory Card system is divided into several classes (See Table 4-21). Each
class supports a set of card functionalities.
Table 4-21 determines the setting of CCC from the card supported commands. A CCC bit, which
corresponds to a supported command number, is set to 1. A class in CCC includes mandatory commands
is always set to 1. Cards with specific functions may need to support some optional commands. For
example, Combo Card shall support CMD5.
Class 0, 2, 4, 5 and 8 are mandatory and shall be supported by all SD Memory Cards. Class 7 except
CMD40 is mandatory for SDHC and SDXC. The other classes are optional. The supported Card
Command Classes (CCC) are coded as a parameter in the card specific data (CSD) register of each
card, providing the host with information on how to access the card.
If different types of commands are assigned to a Command Class (Class 7, Class 8 and Class 11), which
command supported can be determined by referring command support information in SCR register.
81

©Copyright 2001-2017 SD Card Association
  Physical Layer Simplified Specification Version 6.00
| | 0  1  | 2  3  | 4 | 5  6  | 7 | 8  9  | 10  11  |
| --- | ----- | ----- | --- | ----- | --- | ----- | --- |
Card
| Command  | | | | | | applic | |
| --- | --- | --- | --- | --- | ----- | --- | --- |
| | Comm | | | write | | | |
| Class | | block  reserv | block  | erase | lock  | ation  I/O | extens  |
| | basic and  | | | protec- | | | switch  |
| (CCC) | | read  ed | write  | | card  | specifi mode  | ion |
| | Queue | | | tion | | | |
c
| CMD0 | + | | | | | | |
| --- | ---- | ---- | --- | ---- | --- | ---- | ---- |
| CMD2 | + | | | | | | |
| CMD3 | + | | | | | | |
| CMD4 | + | | | | | | |
| CMD5 | | | | | | +  | |
| CMD6 | | | | | | | + |
| CMD7 | + | | | | | | |
| CMD8 | + | | | | | | |
| CMD9 | + | | | | | | |
| CMD10 | + | | | | | | |
| CMD11 | + | | | | | | |
| CMD12 | + | | | | | | |
| CMD13 | + | | | | | | |
| CMD15 | + | | | | | | |
| CMD16 | | + | + | | + | | |
| CMD17 | | + | | | | | |
| CMD18 | | + | | | | | |
| CMD19 | | + | | | | | |
| CMD20 | | + | + | | | | |
| CMD21 | | | | | | | +  |
| CMD23 | | + | + | | | | |
| CMD24 | | | + | | | | |
| CMD25 | | | + | | | | |
| CMD27 | | | + | | | | |
| CMD28 | | | | +  | | | |
| CMD29 | | | | +  | | | |
| CMD30 | | | | +  | | | |
| CMD32 | | | | + | | | |
| CMD33 | | | | + | | | |
| CMD34-37  | | | | | | | + |
| CMD38 | | | | + | | | |
| CMD40 | | | | | + | | |
| CMD42 | | | | | + | | |
| CMD43-47  | +  | | | | | | |
| CMD48 | | | | | | | +  |
| CMD49 | | | | | | | +  |
| CMD50 | | | | | | | + |

| CMD52  | | | | | | +  | |
| --- | --- | --- | --- | --- | --- | ---- | --- |
| CMD53  | | | | | | +  | |

82

©Copyright 2001-2017 SD Card Association
  Physical Layer Simplified Specification Version 6.00
| | 0  1  | 2  3  | 4 | 5  6  | 7 | 8  9  | 10  11  |
| --- | ----- | ----- | --- | ----- | --- | ----- | --- |
Card
| Command  | | | | | | applic | |
| --- | --- | --- | --- | --- | ----- | --- | --- |
| | Comm | | | write | | | |
| Class | | block  reserv | block  | erase | lock  | ation  I/O | extens  |
| | basic and  | | | protec- | | | switch  |
| (CCC) | | read  ed | write  | | card  | specifi mode  | ion |
| | Queue | | | tion | | | |
c
| CMD55 | | | | | | + | |
| --- | --- | --- | --- | --- | --- | ---- | ---- |
| CMD56 | | | | | | + | |
| CMD57 | | | | | | | + |
| CMD58 | | | | | | | +  |
| CMD59 | | | | | | | +  |
| ACMD6 | | | | | | + | |
| ACMD13  | | | | | | + | |
| ACMD14  | | | | | | + | |
| ACMD15  | | | | | | + | |
| ACMD16  | | | | | | + | |
| ACMD22  | | | | | | + | |
| ACMD23  | | | | | | + | |
| ACMD28  | | | | | | + | |
| ACMD41  | | | | | | + | |
| ACMD42  | | | | | | + | |
| ACMD51  | | | | | | + | |
Table 4-21 : Card Command Classes (CCCs) in SD Mode

| | Commands  Support requirements  | | | | | | |
| --- | --- | --- | --- | --- | --- | --- | --- |
| | CMD0  Mandatory | | | | | | |
| | CMD2  Mandatory | | | | | | |
| | CMD3  Mandatory | | | | | | |
| | CMD4  Mandatory | | | | | | |
| | CMD5  Optional | | | | | | |
CMD6
Mandatory for cards version 1.10 and after
| | CMD7  Mandatory | | | | | | |
| --- | --- | --- | --- | --- | --- | --- | --- |
| | CMD8  Mandatory for cards version 2.00 and after  | | | | | | |
| | CMD9  Mandatory | | | | | | |
| | CMD10  Mandatory | | | | | | |
| | CMD11  Mandatory for cards supporting UHS-I. | | | | | | |
Optional for cards that do not support UHS-I.
| | CMD12  Mandatory  | | | | | | |
| --- | --- | --- | --- | --- | --- | --- | --- |
| | CMD13  Mandatory  | | | | | | |
| | CMD15  Mandatory  | | | | | | |
| | CMD16  Mandatory  | | | | | | |
| | CMD17  Mandatory  | | | | | | |
| | CMD18  Mandatory  | | | | | | |

| | CMD19  Mandatory for cards supporting UHS-I.  | | | | | | |
| --- | --- | --- | --- | --- | --- | --- | --- |
Optional for cards that do not support UHS-I.

83

©Copyright 2001-2017 SD Card Association
  Physical Layer Simplified Specification Version 6.00
| Commands  | Support requirements | |
| --- | --- | --- |
| CMD20 | Not supported for SDSC cards.  | |
Mandatory for SDHC and SDXC cards that support Video Speed Class.
Optional for SDHC cards that support:
a)  Speed Class; or
b)  UHS Speed Grade,
and do not support Video Speed Class.
Mandatory for SDXC cards that support Speed Class or UHS Speed Grade.
| CMD21  | Optional | |
| --- | --- | --- |
| CMD23  | Not supported for SDSC cards.  | |
Mandatory for SDHC and SDXC cards that support UHS104.
Optional for SDHC and SDXC cards that do not support UHS104.
| CMD24 | Mandatory for writable types of cards | |
| --- | --- | --- |
| CMD25 | Mandatory for writable types of cards | |
| CMD27 | Mandatory for writable types of cards | |
| CMD28 | Optional | |
| CMD29 | Optional | |
| CMD30 | Optional | |
| CMD32 | Mandatory for writable types of cards | |
| CMD33 | Mandatory for writable types of cards | |
| CMD34-37  | Optional for cards version 1.10 and after  | |
| CMD38 | Mandatory for writable types of cards | |
Discard and FULE support is optional
| CMD40  | Optional | |
| --- | --- | --- |
| CMD42  | Optional for cards version 1.01 and 1.10.  | |
Mandatory for cards version 2.00 and after.
COP support is optional for CMD42
| CMD43-47  | Mandatory for cards supporting Command Queue  | |
| --- | --- | --- |
| CMD48 | Optional | |
Mandatory for cards supporting Performance Enhancement functions (refer
to 5.8.2)
| CMD49  | Optional  | |
| --- | --- | --- |
Mandatory for cards supporting Performance Enhancement functions (refer
to 5.8.2)
| CMD50 | Optional for cards version 1.10 and after  | |
| --- | --- | --- |
| CMD52 | Optional | |
| CMD53 | Optional | |
| CMD55 | Mandatory | |
| CMD56 | Mandatory | |
| CMD57 | Optional for cards version 1.10 and after  | |
| CMD58 | Optional | |
| CMD59 | Optional | |
| ACMD6 | Mandatory | |
| ACMD13  | Mandatory | |
| ACMD14  | Optional | |
| ACMD15  | Optional | |

84

©Copyright 2001-2017 SD Card Association
Physical Layer Simplified Specification Version 6.00
Commands Support requirements
ACMD16 Optional
ACMD22 Mandatory for writable types of cards
ACMD23 Mandatory for writable types of cards
ACMD28 Optional
ACMD41 Mandatory
ACMD42 Mandatory
ACMD51 Mandatory
Table 4-22 : Command Support Requirements
85

©Copyright 2001-2017 SD Card Association
  Physical Layer Simplified Specification Version 6.00
4.7.4 Detailed Command Description
The following tables describe in detail all SD Memory Card bus commands. The responses R1-R3, R6
are defined in Section 4.9. The registers CID, CSD and DSR are described in Chapter 5. The card shall
ignore stuff bits and reserved bits in an argument.

CMD
| type  argument  | resp  | abbreviation  | command description  | | |
| --- | ----- | --- | --- | --- | --- |
INDEX
CMD0  bc  [31:0] stuff bits  -  GO_IDLE_STATE   Resets all cards to idle state
CMD1  reserved
CMD2  bcr  [31:0] stuff bits  R2  ALL_SEND_CID  Asks any card to send the CID num-
bers on the CMD line (any card that is
connected to the host will respond)
CMD3  bcr  [31:0] stuff bits  R6  SEND_RELATIVE_  Ask the card to publish a new relative
| | | ADDR  | address (RCA)  | | |
| --- | --- | ----- | --- | --- | --- |
CMD4  bc  [31:16] DSR  -  SET_DSR  Programs the DSR of all cards
[15:0] stuff bits
CMD5  reserved for I/O cards (refer to the "SDIO Card Specification")
CMD7  ac  [31:16] RCA  R1b  SELECT/DESELECT_ Command toggles a card between the
[15:0] stuff bits  (only  CARD  stand-by and transfer states or
| | from | | between the programming and | | |
| --- | --- | --- | --- | --- | --- |
| | the | | disconnect states. In both cases, the  | | |
| | selecte  | | card is selected by its own relative | | |
| | d card)  | | address and gets deselected by any | | |
other address; address 0 deselects all.
In the case that the RCA equals 0, then
the host may do one of the following:
| | | | - Use other  | RCA  number to perform | |
| --- | --- | --- | --- | --- | --- |
card de-selection.
| | | | - Re-send CMD3 to change its  | | RCA  |
| --- | --- | --- | --- | --- | ---- |
number to other than 0 and then use
| | | | CMD7  with  | RCA=0  for  | card  de-  |
| --- | --- | --- | --- | --- | --- |
selection.
CMD8  bcr  [31:12]reserved  R7  SEND_IF_COND  Sends SD Memory Card interface
| bits | | | condition, which includes host supply  | | |
| --- | --- | --- | --- | --- | --- |
| [11:8]supply  | | | voltage information and asks the card  | | |
| voltage(VHS)  | | | whether card supports voltage. | | |
| [7:0]check | | | Reserved bits shall be set to '0'. | | |
pattern
CMD9  ac  [31:16] RCA  R2  SEND_CSD  Addressed card sends its card-specific
| [15:0] stuff bits  | | | data (CSD) on the CMD line.  | | |
| --- | --- | --- | --- | --- | --- |
CMD10  ac  [31:16] RCA  R2  SEND_CID  Addressed card sends its card identi-
| [15:0] stuff bits  | | | fication (CID) on CMD the line.  | | |
| --- | --- | --- | --- | --- | --- |
CMD11  ac  [31:0] reserved  R1  VOLTAGE_SWITCH  Switch to 1.8V bus signaling level.
bits (all 0)
CMD12  ac  [31:0] stuff bits  R1b  STOP_  Forces the card to stop transmission
TRANSMISSION

86

©Copyright 2001-2017 SD Card Association
Physical Layer Simplified Specification Version 6.00
CMD
type argument resp abbreviation command description
INDEX
CMD13 ac [31:16] RCA R1 SEND_STATUS/SEN CQ not enabled:
[15] Send Task D_TASK_STATUS [15] = ‘0’ or ‘1’, Addressed card sends
Status Register its status register
CQ enabled:
[14:0] stuff bits [15]=’0’, Addressed card sends its
status register.
[15]=’1’, Addressed card sends task
status register.
CMD14 Reserved
CMD15 ac [31:16] RCA - GO_INACTIVE_ Sends an addressed card into the
[15:0] reserved STATE Inactive State. This command is used
bits when the host explicitly wants to
deactivate a card. Reserved bits shall
be set to '0'.
Table 4-23 : Basic Commands (class 0)
CMD
type argument resp abbreviation command description
INDEX
CMD16 ac [31:0] block R1 SET_BLOCKLEN In the case of a Standard Capacity SD
length Memory Card, this command sets the
block length (in bytes) for all following
block commands (read, write, lock).
Default block length is fixed to 512
Bytes. Set length is valid for memory
access commands only if partial block
read operation are allowed in CSD.
In the case of SDHC and SDXC Cards,
block length set by CMD16 command
does not affect memory read and write
commands. Always 512 Bytes fixed
block length is used. This command is
effective for LOCK_UNLOCK command.
In both cases, if block length is set larger
than 512Bytes, the card sets the
BLOCK_LEN_ERROR bit.
In DDR50 mode, data is sampled on
both edges of the clock. Therefore, block
length shall always be even.
CMD17 adtc [31:0] data R1 READ_SINGLE_ In the case of a Standard Capacity SD
address2 BLOCK Memory Card, this command, this
command reads a block of the size
selected by the SET_BLOCKLEN
command. 1
In case of SDHC and SDXC Cards,
block length is fixed 512 Bytes
regardless of the SET_BLOCKLEN
command.
87

©Copyright 2001-2017 SD Card Association
  Physical Layer Simplified Specification Version 6.00
CMD
| type  argument  | resp  | abbreviation  | command description  | | |
| --- | ----- | --- | --- | --- | --- |
INDEX
CMD18  adtc  [31:0] data  R1  READ_MULTIPLE_  Continuously transfers data blocks from
| address2  | BLOCK  | | card  to  host  | until  interrupted  | by  a  |
| --- | --- | --- | --- | --- | --- |
STOP_TRANSMISSION command.
Block length is specified the same as
READ_SINGLE_BLOCK command.
CMD19  adtc  [31:0] reserved  R1  SEND_TUNING_  64 bytes tuning pattern is sent for SDR50
| bits (all 0)  | BLOCK  | | and SDR104.  | | |
| --- | --- | --- | --- | --- | --- |
CMD20  ac  [31:28]Speed  R1b  SPEED_CLASS_CON Speed Class control command.
| Class Control  | TROL  | | [27:0] Speed Class - 4.13.2.8 | | |
| --- | ----- | --- | --- | --- | --- |
| [27:0]See | | | [27:0] UHS Speed Grade - See section | | |
| command | | | 4.13.2.8 | | |
| description | | | [27:0] Video Speed Class - See section  | | |
4.13.4.7
CMD22   reserved
CMD23  ac  [31:0] Block  R1  SET_BLOCK_COUNT  Specify  block  count  for  CMD18  and
| Count  | | | CMD25.  | | |
| --- | --- | --- | --- | --- | --- |

1) The data transferred shall not cross a physical block boundary unless READ_BLK_MISALIGN is set in the CSD.
2) SDSC Card (CCS=0) uses byte unit address and SDHC and SDXC Cards (CCS=1) use block unit address (512 Bytes
unit).
Table 4-24 : Block-Oriented Read Commands (class 2)

CMD
| type  argument  | resp  | abbreviation  | command description  | | |
| --- | ----- | --- | --- | --- | --- |
INDEX
CMD16  ac  [31:0] block  R1  SET_BLOCKLEN  See description in Table 4-24
| length  | | | | | |
| --- | --- | --- | --- | --- | --- |
CMD20  ac  [31:28]Speed  R1b  SPEED_CLASS_CON Speed Class control command.
| Class Control  | TROL  | | [27:0] Speed Class - 4.13.2.8 | | |
| --- | ----- | --- | --- | --- | --- |
| [27:0]See | | | [27:0] UHS Speed Grade - See Section | | |
| command | | | 4.13.2.8 | | |
| description | | | [27:0] Video Speed Class - See Section  | | |
4.13.4.7
CMD23  ac  [31:0] Block  R1  SET_BLOCK_COUNT  Specify  block  count  for  CMD18  and
| Count  | | | CMD25.  | | |
| --- | --- | --- | --- | --- | --- |
CMD24  adtc  [31:0] data  R1   WRITE_BLOCK  In case of SDSC Card, block length is
| address2  | | | set by the SET_BLOCKLEN command1. | | |
| --- | --- | --- | --- | --- | --- |
In case of SDHC and SDXC Cards,
block length is fixed 512 Bytes
regardless of the SET_BLOCKLEN
| | | | command. | | |
| --- | --- | --- | --- | --- | --- |
CMD25  adtc  [31:0] data  R1   WRITE_MULTIPLE_B Continuously writes blocks of data until a
| address2  | LOCK  | | STOP_TRANSMISSION follows.  | | |
| --- | ----- | --- | --- | --- | --- |
Block length is specified the same as
WRITE_BLOCK command.
CMD26  Reserved For Manufacturer
CMD27  adtc  [31:0] stuff bits  R1   PROGRAM_CSD  Programming of the progra mmable bits
of the CSD.

88

©Copyright 2001-2017 SD Card Association
  Physical Layer Simplified Specification Version 6.00
1) The data transferred shall not cross a physical block boundary unless WRITE_BLK_MISALIGN is set in the CSD. In the
case that write partial blocks is not supported, then the block length=default block length (given in CSD).
2) SDSC Card (CCS=0) uses byte unit address and SDHC and SDXC Cards (CCS=1) use block unit address (512 bytes
unit).
Table 4-25 : Block-Oriented Write Commands (class 4)

CMD
| | | type  argument  | | resp  | abbreviation  | | command description  | |
| --- | --- | --- | --- | ----- | --- | --- | --- | --- |
INDEX
CMD28  ac  [31:0] data  R1b  SET_WRITE_PROT  If the card has write protection fea-
| | | address2  | | | | tures, this command sets the write  | | |
| --- | --- | --- | --- | --- | --- | --- | --- | --- |
protection bit of the addressed group.
The properties of write protection are
coded in the card specific data
(WP_GRP_SIZE).
SDHC and SDXC Cards do not
support this command.
CMD29  ac  [31:0] data  R1b  CLR_WRITE_PROT  If  the  card  provides  write  protection
| | | address2  | | | | features, this command clears the write  | | |
| --- | --- | --- | --- | --- | --- | --- | --- | --- |
protection bit of the addressed group.
SDHC and SDXC Cards do not
support this command.
CMD30  adtc  [31:0] write  R1  SEND_WRITE_  If the card provides write protection
| | | protect data  | | | PROT  | features, this command asks the card  | | |
| --- | --- | --- | --- | --- | ----- | --- | --- | --- |
| | | address2 | | | | to send the status of the write | | |
protection bits.1
SDHC and SDXC Cards do not
support this command.
| CMD31  | Reserved  | | | | | | | |
| --- | --- | --- | --- | --- | --- | --- | --- | --- |
1) 32 write protection bits (representing 32 write protect groups starting at the specified address) followed by 16 CRC bits
are transferred in a payload format via the data line. The last (least significant) bit of the protection bits corresponds to
the first addressed group. If the addresses of the last groups are outside the valid range, then the corresponding write
protection bits shall be set to 0.
2) Data address is in byte units in a Standard Capacity SD Memory Card.
Table 4-26 : Block Oriented Write Protection Commands (class 6)

CMD
| | type  | argument  | | resp  | abbreviation  | | command description  | |
| --- | ----- | --- | --- | ----- | --- | --- | --- | --- |
INDEX
CMD32  ac  [31:0] data  R1  ERASE_WR_BLK_  Sets the address of the first write
| | | address1  | | | START  | block to be erased. | | |
| --- | --- | --- | --- | --- | --- | --- | --- | --- |
CMD33  ac  [31:0] data  R1  ERASE_WR_BLK_END  Sets the address of the last write
address1
block of the continuous range to be
erased.
| CMD38  | ac  | [31:0] Erase  | | R1b  | ERASE  | Erase Function | | |
| --- | --- | --- | --- | ---- | --- | --- | --- | --- |
| | | Function | | | | 00000001h = Discard  | | |
00000002h = FULE
Others = Erase
| CMD39  | Reserved  | | | | | | | |
| --- | --- | --- | --- | --- | --- | --- | --- | --- |
| CMD41  | Reserved  | | | | | | | |
1) SDSC Card (CCS=0) uses byte unit address and SDHC and SDXC Cards (CCS=1) use block unit address (512 bytes
unit).
2) CMD40 is moved to Table 4-28 (Class 7).
| | | | Table 4-27 : Erase Commands (class 5)  | | | | | |
| --- | --- | --- | --- | --- | --- | --- | --- | --- |

89

©Copyright 2001-2017 SD Card Association
Physical Layer Simplified Specification Version 6.00
CMD
type argument resp abbreviation command description
INDEX
CMD16 ac [31:0] block R1 SET_BLOCKLEN See description in Table 4-24
length
CMD40 adtc Defined by R1 Defined by DPS Single block read type. Available even if
DPS Spec. Spec. card is locked.
CMD42 adtc [31:0] R1 LOCK_UNLOCK Used to set/reset the password or
Reserved bits lock/unlock the card. The size of the data
(Set all 0) block is set by the SET_BLOCK_LEN
command.
Reserved bits in the argument and in Lock
Card Data Structure shall be set to 0.
CMD51 reserved
Table 4-28 : Lock Card (class 7)
CMD
type argument resp abbreviation command description
INDEX
CMD55 ac [31:16] RCA R1 APP_CMD Indicates to the card that the next
[15:0] stuff bits command is an application specific
command rather than a standard
command
CMD56 adtc [31:1] stuff bits. R1 GEN_CMD Used either to transfer a data block to
[0]: RD/WR the card or to get a data block from the
card for general purpose/application
specific commands. In case of a SDSC
Card, block length is set by the
SET_BLOCK_LEN command. In case of
SDHC and SDXC Cards, block length is
fixed to 512 bytes. The host sets
RD/WR=1 for reading data from the
card and sets to 0 for writing data to the
card.
CMD60-63 reserved for manufacturer
Table 4-29 : Application-Specific Commands (class 8)
All the application-specific commands (given in Table 4-29) are supported if Class 8 is allowed (mandatory
in SD Memory Card).
CMD
type argument resp abbreviation command description
INDEX
CMD52-54 Commands for SDIO (refer to the "SDIO Card Specification")
Table 4-30 : I/O Mode Commands (class 9)
All future reserved commands shall have a codeword length of 48 bits, as well as their responses (if there
are any).
90

©Copyright 2001-2017 SD Card Association
  Physical Layer Simplified Specification Version 6.00
The following table describes all the application-specific commands supported/reserved by the SD
Memory Card. All the following ACMDs shall be preceded with APP_CMD command (CMD55).

ACMD
| | type  argument  | resp  abbreviation  | command description  |
| --- | --- | --- | --- |
INDEX
| ACMD1-5  | Reserved  | | |
| --- | --- | --- | --- |
ACMD6  ac  [31:2] stuff bits  R1  SET_BUS_WIDTH  Defines the data bus width ('00'=1bit or
| | [1:0]bus width  | | '10'=4 bits bus) to be used for data |
| --- | --- | --- | --- |
| | | | transfer. The allowed data bus widths  |
are given in SCR register.
| ACMD7-12  | Reserved  | | |
| --- | --- | --- | --- |
ACMD13  adtc  [31:0] stuff bits  R1  SD_STATUS  Send the SD Status. The status fields
| | | | are given in Table 4-44.  |
| --- | --- | --- | --- |
| ACMD14-16  | Reserved for DPS Specification  | | |
| ACMD17 | Reserved | | |
ACMD18  1
Reserved for SD security applications
| ACMD19-21  | Reserved  | | |
| --- | --- | --- | --- |
ACMD22  adtc  [31:0] stuff bits   R1  SEND_NUM_WR_  Send the number of the written (with-
| | | BLOCKS | out errors) write blocks. Responds with  |
| --- | --- | --- | --- |
32bit+CRC data block.
If WRITE_BL_PARTIAL='0', the unit of
ACMD22 is always 512 byte.
If WRITE_BL_PARTIAL='1', the unit of
ACMD22 is a block length which was
used when the write command was
executed.
ACMD23  ac   [31:23] stuff bits  R1  SET_WR_BLK_  Set the number of write blocks to be
[22:0]Number of  ERASE_COUNT  pre-erased before writing (to be used
| | blocks  | | for faster Multiple Block WR com- |
| --- | --- | --- | --- |
2
mand). "1"=default (one wr block) .
| ACMD24  | Reserved | | |
| --- | --- | --- | --- |
| ACMD25  | Reserved for SD security applications | 1 | |
ACMD26  1
Reserved for SD security applications
| ACMD27 | Shall not use this command | | |
| --- | --- | --- | --- |
| ACMD28 | Reserved for DPS Specification | | |
| ACMD29 | Reserved | | |
| ACMD30-35  | Reserved for Security Specification  | | |
| ACMD36-37  | Reserved | | |
ACMD38  1
Reserved for SD security applications
| ACMD39-40  | Reserved  | | |
| --- | --- | --- | --- |

91

©Copyright 2001-2017 SD Card Association
  Physical Layer Simplified Specification Version 6.00
ACMD
| | type  argument  | resp  | abbreviation  | | command description  | |
| --- | --- | ----- | --- | --- | --- | --- |
INDEX
ACMD41  bcr  [31]reserved bit  R3  SD_SEND_OP_CON Sends host capacity support
[30]HCS(OCR[30])
| | | | D | information (HCS) and asks the  | | |
| --- | --- | --- | --- | --- | --- | --- |
[29]reserved for eSD  accessed card to send its operating
[28]XPC  condition register (OCR) content in the
[27:25]reserved bits
response on the CMD line. HCS is
[24]S18R
effective when card receives
[23:0] VDD Voltage
SEND_IF_COND command.
Window(OCR[23:0])
Sends request to switch to 1.8V
signaling (S18R).
Reserved bit shall be set to '0'. CCS
bit is assigned to OCR[30].
XPC controls the maximum power in
the default speed mode of SDXC
card. XPC=0 means 0.36W (100mA
at 3.6V on VDD1) (max.) but speed
class is not supported. XPC=1
means 0.54W (150mA at 3.6V on
VDD1) (max.) and speed class is
supported.
ACMD42   ac  [31:1] stuff bits  R1  SET_CLR_CARD_  Connect[1]/Disconnect[0] the 50 KOhm
| | [0]set_cd  | | DETECT  | pull-up resistor on CD/DAT3 (pin 1) of  | | |
| --- | --- | --- | --- | --- | --- | --- |
  the card.
ACMD43-49  --  --  --  --  Reserved for SD security applications 1
ACMD51  adtc  [31:0] stuff bits  R1  SEND_SCR  Reads the SD Configuration Register
(SCR).
| ACMD52-54  | Reserved for Security Specification  | | | | | |
| --- | --- | --- | --- | --- | --- | --- |
| ACMD55 | Not exist | | | Equivalent to CMD55.  | | |
Refer to Section 4.3.9.1.
| ACMD56-59  | Reserved for Security Specification  | | | | | |
| --- | --- | --- | --- | --- | --- | --- |
1) Refer to the "Part3 Security Specification" for a detailed explanation about the SD Security Features
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
