kelu124/rp569/datasheet/CH569DS1.md

CH569/CH565 Datasheet
V1.2
Overview
The CH569 and CH565 both are based on the RISC-V3A core and they support the IMAC subset of RISC-V
instruction set. On-chip 128-bit DMA is provided to meet the high bandwidth requirements for several high-speed
peripherals and to implement high-speed transmission of large amounts of data. Peripherals include USB3.0
SuperSpeed and USB2.0 HighSpeed host and device controller and transceiver PHY, Gigabit Ethernet controller,
dedicated high-speed SerDes controller and transceiver PHY, SD/EMMC interface controller,
encryption/decryption module, high-speed parallel interface and digital video port (DVP), which can be widely
used in streaming media, instant storage, super-high speed FIFO, communication expansion, security monitoring
and other application scenarios.
Features
- 4 UARTs, up to 7.5Mbps baud rate, compatible with
l Core
16C550
- Support RV32IMAC instruction set combination,
- Built-in FIFO, multiple trigger levels
hardware multiplication and division
l Serial peripheral interface (SPI)
- Fast programmable interrupt controller + fast
interrupt response - 2 SPI interfaces, support Master/Slave mode
- Static branch prediction and conflict handler - Built-in FIFO, support DMA
mechanism
l Active parallel port:
- Low-power 2-stage pipeline
8-bit data, 15-bit address bus
- Up to 120MHz system clock frequency
l General purpose I/O port
l Memory
- 49 ordinary IO ports, 8 of them support level/edge
- 448KB user application code memory CodeFlash
interrupts
- 32KB user data memory DataFlash
- Support 3.3V or 2.5V, some pins have alternate and
- 24KB system boot program memory BootLoader
mapping functions
- 8KB system non-volatile configuration information
l Others: Watchdog, SysTick, debug interface, etc.
memory InfoFlash
- 32/64/96KB configurable 128-bit SRAM (RAMX)
l USB3.0 super-speed controller and transceiver
-16KB 32-bit SRAM (RAMS)
(on-chip PHY)
l Power and low power
- Support USB3.0 Host/Device mode, OTG feature
- Support low power modes - Support control, bulk, interrupt, isochronous transfer
- Support some GPIOs, USB and Ethernet signal - The host supports USB3.0 HUB
wake-up - Support U1/U2/U3 low power state
l Timer and PWMX l High-speed USB2.0 controller and transceiver
- 3 x 26-bit timers, (on-chip PHY)
- Support timing, count, signal capture and PWM - Support USB2.0 Host/Device mode
modulation output - Support control, bulk, interrupt, isochronous transfer
- TMR1 and TMR2 support DMA - Support data receive/transmit buffer
- 4 sets of extended PWM output, adjustable duty
l Gigabit Ethernet controller (ETH)
cycle
- Compliant with IEEE 802.3 protocol specifications
l Universal asynchronous receiver transmitter
- Provide RGMII and RMII interfaces, connected to
(UART):
external PHY

- Support 10/100/1000Mbps transfer rate via PHY
l ECDC encryption module
l EMMC controller
- Support AES/SM4 algorithm, with 8 combined
- Conform to the UHS-ISDR50 mode in SD3.0 encryption/decryption modes
Specification and backward compatible - Support SRAM/EMMC/HSPI peripheral interface
- Conform to EMMC card 4.4 and 4.5.1 Specifications, data encryption and decryption
and compliant with EMMC card 5.0 Specification
l Remote SerDes controller and transceiver
- Support 1/4/8-line data communication, up to
(on-chip PHY)
96MHz communication clock
- 8b/10b encode/decode, 1.2Gbps high-speed
l CH569 high speed parallel interface (HSPI)
differential signal communication
- Configurable 8/16/32-bit data - 600Mbps transfer distance is up to 90m through a
- Built-in FIFO, support DMA, dual buffer transceiver pair of differential network line
- The fastest transfer rate is about 3.8Gbps
l Unique ID: Unique 64-bit ID
(32-bit@120MHz)
l Package: QFN68, QFN40
l CH565 digital video port (DVP)
- Configurable 8/10/12 bit data
- Support YUV, RGB and JPEG compressed data

| CH569/565 Datasheet 1  | | | | | | | | | | | | | http://wch.cn  | |
| --- | --- | --- | --- | --- | --- | --- | --- | --- | --- | --- | --- | --- | --- | --- |
Chapter 1 Pinouts and pin definitions
1.1 Pinouts
Figure 1-1 CH569 and CH565 pinouts

| | | | | | | | 1 0 9 | 8 7 6 5 4 3 | 24 14 04 93 8 | 7 6 5 | | | | |
| --- | --- | --- | --- | --- | --- | --- | ----- | --- | --- | ----- | --- | --- | --- | --- |
| | | | | | | | 5 5 4 | 4 4 4 4 4 4 | 3 | 3 3 3 | | | | |

| | | | | | | | 4 2 | 3 2 22B | OIDDV IKCTE/42DH/61AP | 9 | | | | |
| --- | --- | --- | --- | --- | --- | --- | --- | --- | --- | --- | --- | --- | --- | --- |
| | | | | | | | V D 0 B P | S B P 2 DXRE/01AB/RTD/82DH/01BP P D C I R | RSD/7AB/52DH/CXTE/7BP 6AB/0DXT/32DH/NEXTE/6BP | 0 D 4 A 3 1 D | | | | |
| | | | | | | | X D X | T C D / / C | | X R B / D X H / | | | | |
| | | | | | | | R E R E | / 1 3 D X R | | / 5 3 D R / O | | | | |
| | | | | | | | / 3 / 2 | S C X E / | | A X 3 A C M | | | | |
| | | | | | | | 1 A 1 A | S / R E 8 A | | B / T / B / E / | | | | |
| | | | | | | | B / B | 1 / 9 B / | | 2 2 1 2 _ 0 2 | | | | |
| | | | | | | | 1 I / S | D X A B 6 | | D H D H 2 R A P | | | | |
| | | | | | | | S O T R | R E / 7 2 D | | / 0 / 1 M T | | | | |
| | | | | | | | M / 1 | / 1 2 D H / | | D X D X / 0 | | | | |
| | | | | | | | / 1 K C | 1 A H / 8 B | | T E T E 2 D | | | | |
| | | | | | | | 3 D S / | B / 9BP P | | / / H / | | | | |
| | | | | | | | H / 0 3 | 9 2 | | 5 B 4 B 2 D | | | | |
| | | | | 5 2 P | A 2 1 / H T V L D | | 3 1 D | D | | P P XTE/3BP PB2/ETXD3/HD18/PWM3/BA2 | | | 34 | |
| | | | | 5 3 P | A 2 2 / H D 2 | | B P H / | H / | | PB1/EMDCK/HD17/PWM2/BA1 | | | 33 | |
| | | | | 5 4 P | A 9 / H T R E Q / | T M R0 /BWR# | 2 1 | 1 1 | | PB0/EMDIO/HD16/TMR1_/BA0 | | | 32 | |
| | | | | 5 5 | | | B P | B P | | | | | 3 1 | |
| | | | | 5 6 P | A 1 0 / T C K / H | T A C K | | C H | 5 6 9 W | PB1 4 / | M S D C K / H D 1 | 5 / M I S O 1 / B A 1 4 | 3 0 | |
| | | | | 5 7 P | A 1 1 / T I O / H | T C L K | | G P | I O / * | P B 1 | 5 / R S T # / H D | 1 4 / T M R 1 / P W M | 0 2 9 | |
| | | | | 5 8 P | A 1 2 / S C S | | | E : | E T H | | P | B 1 6 / M C M D / H D | 1 3 2 8 | |
| | | | | 5 9 P | A 1 3 / S C K | | | | | | | P A 1 7 / H D | 1 2 2 7 | |
| | | | | P | A 1 4 / M O S I | | | M : | E M M C | | | P B 1 7 / M D 0 / H D | 1 1 | |
| | | | | 6 0 P | A 1 5 / M I S O | | | H : | H S P I | | | P B 1 8 / M D 1 / H D | 1 0 2 6 | |
| | | | | 6 1 V | D D I O | | | B : | B U S 8 | | | PB19/MD2/HD9 | 25 | |
| | | | | 6 2 V | 3 3 L D O | | | G : | S E R D E S | | | PB20/MD3/HD8 | 24 | |
| | | | | 63 | | | | | | | | | 2 3 | |
| | | | | 6 4 V12CORE | | | | | | | | P B 2 1 / M D 4 / H | D 7 2 2 | |
| | | | | 6 5 V | 3 3 GX | | | | | | PA0/ | M D 5 / H D 6 / B | D 0 21  | |
| | | | | 6 6 G | X M | | | | | | PA1/MD6/HD5/BD1 | | 20 | |
| | | | | G | X P | | | | | | PA2/MD7/HD4/BD2/RXD2 | | | |
| | | | | 67 XO | | | | | | | PA3/HD3/TXD2/BD3 | | 19 | |
| | | | | 68 XI | | | | | | | | PA23/HTRDY | 18 | |

4DB/1MWP/2RMT/1DH/4AP
| | | | | | | | | | | DL | | | | |
| --- | --- | --- | --- | --- | --- | --- | --- | --- | --- | --- | --- | --- | --- | --- |
| | | | | | | | | | | VR _ 0 | | | | |
| | | | | | | | | | | H D | | | | |
| | | | | | | | | | # 1 | / 6 X R | | | | |
| | | | | | | | | | D R D | D B / 5 | | | | |
| | | | | | | | | | K L T C B / X R | / _ D B | | | | |
| | | | | | | | | EROC21V | C R A R 1 D / 7 | 0 D / 0 | | | | |
| | | | | | | | BSU33V  | AXTSS BXTSS BSU21V A B | H / H / X T D B | X T D H OIDDV | | | | |
| | | | | | | DNG | +DU -DU | X R X R | 9 1 8 1 / 8 / 7 | / 6 / 5 | | | | |
| | | | | | | | | S S | A A A A | A A | | | | |
| | | | | | | | | S S | P P P P | P P | | | | |
| | | | | | | 0 | 1 2 3 | 4 5 6 7 8 9 | 0 1 2 3 4 | 5 61 71 | | | | |
| | | | | | | | | | 1 1 1 1 1 | 1 | | | | |
| | | 1 5 0 5 | 9 4 8 4 7 4 6 4 5 4 | 4 4 3 4 24 14 04 93 8 3 7 3 | 6 3 5 3 | | | | | | | | | |
| | | | 4 2 3 2 22 | I OIDDV IKCTE/61AP | O | | | | | | | | | |
| | | V D | 0 B P S B P 2 D B P | D C R RSD/7AB/CXTE/7BP 6AB/0DXT/NEXTE/6BP 0 D | 4 A 3 C M | | | | | | | | | |
| | | X | D X T C XRE/01AB/RTD/01BP | D / / C X R | B / D X E / | | | | | | | | | |
| | | R E | R E / 1 | 3 D X R / 5 | 3 D R / 0 2 | | | | | | | | | |
| | | / 3 | / 2 S C | X R E / A | X 3 A A | | | | | | 03 92 82 | 72 62 5 4 3 | 2 1 | |
| | | 1 A | 1 A S / | E / 8 A B / | T / B / P | | | | | | | 2 2 2 | 2 2 | |
| | | B / | B 1 | 9 B 0 D | 1 D _ | | | | | | | | | |
| | | 1 I | / S D X | A B / 8 X T | X T 2 R | | | | | | | | | |
| | | S O | T R R E | / 9BP B P E / | E / M T | | | | | | 1ISOM/31BP STR/1KCS/21BP STC/1SCS/11BP | EROC21V OIDDV 3 3 9 | | |
| | | M | / 1 / 1 | 5 B | 4 B / 2 | | | | | | | D X D D D | 1 1 0 | |
| | | / 3 | K C 1 A | P | P D XTE/3BP | | | | | | | T / X R / D | D D 1 D | |
| | | 1 B | S / B / | | | | | | | | | 4 B / _ M | / D / | |
5 2 P A 2 1 P 2 1 1 1 PB2/ETXD3/PWM3/BA2 34 P 2 RMT/3BP C M 1 O 0 M
| 5 3 P A 2 2 | | | B B | | | PB1/EMDCK/PWM2/BA1 | | 33  | | | | / 6 | S I W P | |
| --- | --- | --- | --- | --- | --- | --- | --- | --- | --- | --- | --- | --- | --- | --- |
| 5 4 | | | P P | C H 5 6 5 W | | | | 32  | | | | 1 B | M / / 1 | |
| 5 5 P A 9 / T M R | 0 / BWR# | | | | PB0/EMDIO/TMR1_/BA0 | | | 3 1 | | | | P | K C R | |
5 6 P A 1 0 / T C K G P I O / * PB1 4 / M S D C K / M I S O 1 / B A 1 4 / D D 1 1 3 0 3 1 D S M T 2 0
5 7 P A 1 1 / T I O E : E T H P B 1 5 / R S T # / T M R 1 / P W M 0 / D D 1 0 2 9 3 2 P A 9 / T M R 0 M / / # P B 1 7 / M D 0 / D D 8 1 9
  5 8 P A 1 2 / S C S P B 1 6 / M C M D / D D 9 2 8 33 P A 1 3 / S C K 4 T S P B 1 8 / M D 1 / D D 7 18
P A 1 3 / S C K M : E M M C P A 1 7 V33LDO 1 B R / PB19/MD2/DD6
5 9 P A 1 4 / M O S I D : D V P P B 1 7 / M D 0 / D D 8 2 7 34 V12CORE P 51BP PB20/MD3/DD5 17
6 0 P A 1 5 / M I S O B : B U S 8 P B 1 8 / M D 1 / D D 7 2 6 3 5 V 3 3 GX PB 2 1 / M D 4 / D D 4 1 6
  6 1 V D D I O G : S E R D E S PB19/MD2/DD6 25 3 6 G X M CH565M P A 0 / M D 5 / D D3 1 5
| 6 2 | | | | | | | | 24  | 3 7 | | | | | 14  |
| --- | --- | --- | --- | --- | --- | --- | --- | --- | --- | --- | --- | --- | --- | --- |
| 63 V 3 3 L D O | | | | | | PB20/MD3/DD5 | | 2 3 | 38 G X | P | | | PA1/MD6/DD2 | 13  |
6 4 V12CORE P B 2 1 / M D 4 / D D 4 2 2 39 XO PA2/MD7/DD1/RXD2 12
  6 5 V 3 3 GX PA0/ M D 5 / B D 0 / D D 3 21 40 XI PA3/TXD2/DD0 11
| G X M | | | | | | PA1/MD6/BD1/DD2  | | | UD+ | | | | PA4/TMR2/PWM1/DVSYN | |
| --- | --- | --- | --- | --- | --- | --- | ---- | --- | --- | --- | --- | --- | --- | --- |
| 6 6 G X P | | | | | PA2/MD7/BD2/DD1/RXD2 | | | 20  | | | | | | |
| 67 XO | | | | | | PA3/TXD2/BD3/DD0 | | 19  | | | | | K _ | |
| 68 XI | | | | | | | PA23 | 18  | | | | | L C 0 D | |
| | | | | | | | | | | | | | P D X R | |
| | | | | | NYSVD/4DB/1MWP/2RMT/4AP | | | | | | | | / _ / N | |
| | | | | | | | | | | | | | 0 Y | |
| | | | | K L | _ 0 | | | | | | BSU33V | BSU21V | D X S H | |
| | | | | C P | D X | | | | | | AXTSS  | BXTSS A X B X O I | T / D / | |
| | | | | D | R | | | | | DNG | -DU | R S R S D D | 6 A 5 A | |
| | | | | # 1 / 6 | / N | | | | | | | S S V | P P | |
| | | | | D R D D B | Y S | | | | | | | | | |
| | | | | B / X R / _ | H D | | | | | 0 | 1 2 3  | 4 5 6 7 8 | 9 01 | |
| | | | | EROC21V 1 D / 7 0 D | / 5 | | | | | | | | | |
| | | | BSU33V AXTSS BXTSS BSU21V A | B X T D B X T | D B OIDDV | | | | | | | | | |
| | DNG | +DU | -DU X R | X R 9 1 8 1 / 8 / 7 / 6 | / 5 | | | | | | | | | |
| | | | S | S A A A A A | A | | | | | | | | | |
| | | | S | S P P P P P | P | | | | | | | | | |
| | 0 | 1 2 | 3 4 5 6 7 | 8 9 0 1 2 3 4 5 | 61 71 | | | | | | | | | |
| | | | | 1 1 1 1 1 1 | | | | | | | | | | |

Note 1: Pin 0# refers to the EPAD of QFN package.

| CH569/565 Datasheet 2  | | | | | | | | http://wch.cn  |
| --- | --- | --- | --- | --- | --- | --- | --- | --- |
1.2 Comparison
Table 1-1 Comparison between CH569 and CH565
Part No.
| | | | | | CH569W  | | CH565W  | CH565M  |
| --- | --- | --- | --- | --- | --- | --- | --- | --- |
Resource
| | | | CodeFlash  | | 448KB  | | 448KB  | 448KB  |
| --- | --- | --- | --- | --- | --- | --- | --- | --- |
Flash
| | | | DataFlash  | | | | 32KB  | |
| --- | --- | --- | --- | --- | --- | --- | ----- | --- |
memory
| | | | BootLoader | | | | 24KB | |
| --- | --- | --- | --- | --- | --- | --- | --- | --- |
| | SRAM (RAMX+RAMS) | | | | | 32/64/96KB + 16KB  | | |
| | | General purpose I/O | | | 49 | | 49 | 22 |
| | | General-purpose timer  | | | | 3 | 3 | 3 |
| | Timer | | Watchdog (WDT)  | | | | √ | |
| | | | SysTick | | | | √ | |
| | | PWMX+PWM | | | 4 + 3  | | 4 + 3  | 2 + 3  |
| | | | UART | | | 4 | 4 | 3 |
| | | SPI0 (master/slave) | | | | 2 | 2 | 1 |
| | Active parallel port (BUS8)  | | | | | √ | √ | × |
| | Gigabit Ethernet (ETH-GMAC)  | | | | | √ | √ | × |
| | Digital video port (DVP) | | | | | × | √ | √ |
| | | | EMMC | | | √ | √ | √ |
| | | AES/SM4 Encryption | | | | √ | √ | √ |
High speed parallel interface
| | | | | | | √ | × | × |
| --- | --- | --- | --- | --- | --- | --- | --- | --- |
(HSPI)
| | | Super-speed USB3.0  | | | | √ | √ | √ |
| --- | --- | --- | --- | --- | --- | --- | --- | --- |
| | | High-speed USB2.0 | | | | √ | √ | √ |
| | | High-speed SerDes | | | | √ | √ | √ |
| | | Debug interface | | | | √ | √ | × |

1.3 Pin definitions
1.3.1 CH569 pin definitions
Table 1-2 CH569 pin definitions
| Pin  | Pin | | Main function (after reset)/  | | | | | |
| ---- | --- | ----- | --- | ---- | --- | --- | --- | --- |
| | | Type  | | | | | Description  | |
| No.  | Name | | alternate and mapping | | | | | |
| 0 | GND | | P | GND  | | Ground (EPAD) | | |
| 1 | UD+ USB2.0 | | | DP | | USB2.0 signal line D+  | | |
| 2 | UD- USB2.0 | | | DN | | USB2.0 signal line D-  | | |
3.3V power input of USB PHY, connected to an
| 3 | V33USB  | | P | V33USB  | | | | |
| --- | --- | --- | --- | --- | --- | --- | --- | --- |
external 0.1uF capacitor
| 4 | SSTXA  | USB3.0  | | SSTXA  | | USB3.0 super-speed signal line TXA  | | |
| --- | --- | --- | --- | --- | --- | --- | --- | --- |
| 5 | SSTXB  | USB3.0  | | SSTXB  | | USB3.0 super-speed signal line TXB  | | |
1.2V power input of USB PHY, connected to an
| 6 | V12USB  | | P | V12USB  | | | | |
| --- | --- | --- | --- | --- | --- | --- | --- | --- |
external 0.1uF capacitor
| 7 | SSRXA  | USB3.0  | | SSRXA  | | USB3.0 super-speed signal line RXA  | | |
| --- | --- | --- | --- | --- | --- | --- | --- | --- |

CH569/565 Datasheet 3  http://wch.cn
| 8  SSRXB  | USB3.0  | SSRXB  | USB3.0 super-speed signal line RXB  |
| --- | --- | --- | --- |
1.2V core voltage input of the system, connected to
9  V12CORE  P  V12CORE  the other V12CORE pin, an external 0.1uF capacitor
is required
PA19: General purpose bidirectional digital I/O pin
PA19
10  PA19  I/O  HRCLK: Receive sampling clock input of high-speed
/HRCLK
parallel interface
PA18: General purpose bidirectional digital I/O pin
PA18
11  PA18  I/O  HRACT: Transmit request signal input of high-speed
/HRACT
parallel interface
PA8: General purpose bidirectional digital I/O pin
| | | PA8 | TXD1: TXD pin output of UART1 peripheral |
| --- | ---- | --- | --- |
| 12  PA8  | I/O  | | |
| | | /TXD1/BRD#  | BRD#: Read control signal output of active parallel  |
interface, active low
PA78: General purpose bidirectional digital I/O pin
PA7
| 13  PA7  | I/O  | | BD7: Data line 7 of active parallel interface  |
| --- | ---- | --- | --- |
/BD7/RXD1
RXD1: RXD pin input of UART1 peripheral
PA6: General purpose bidirectional digital I/O pin
TXD0_: TXD function pin mapping of UART0
| | | PA6  | peripheral |
| --- | --- | ---- | --- |
| 14  PA6  | I/O | | |
| | /TXD0_/BD6/HRVLD  | | BD6: Data line 6 of active parallel interface  |
HRVLD: Data transmit status pin input of high-speed
parallel interface
PA5: General purpose bidirectional digital I/O pin
HD0: High-speed parallel interface data line 0
PA5
| 15  PA5  | I/O  | | BD5: Data line 5 of active parallel interface  |
| --- | ---- | --- | --- |
/HD0/BD5/RXD0_
RXD0_: RXD function pin mapping of UART0
peripheral
3.3V or 2.5V input of I/O power, connected to an
| 16  VDDIO  | P | VDDIO  | |
| --- | --- | --- | --- |
external 0.1uF capacitor
PA4: General purpose bidirectional digital I/O pin
HD1: Data line 1 of high-speed parallel interface
| | | PA4  | TMR2: Input capture and PWM output pin of timer2  |
| --- | --- | ---- | --- |
| 17  PA4  | I/O | | |
| | /HD1/TMR2/PWM1/BD4  | | peripheral |
PWM1: PWMX peripheral channel 1 output
BD4: Data line 4 of active parallel interface
PA23: General purpose bidirectional digital I/O pin
PA23
| 18  PA23  | I/O  | | HTRDY: Detection receive status pin input of  |
| --- | ---- | --- | --- |
/HTRDY
high-speed parallel interface
PA3: General purpose bidirectional digital I/O pin
| | | PA3  | HD3: Data line 3 of high-speed parallel interface  |
| --- | --- | ---- | --- |
| 19  PA3  | I/O | | |
| | /HD3/TXD2/BD3  | | TXD2: TXD pin output of UART2 peripheral |
BD3: Data line 3 of active parallel interface
PA2: General purpose bidirectional digital I/O pin
| | | PA2  | MD7: EMMC peripheral data line 7 |
| --- | --- | ---- | --- |
| 20  PA2  | I/O | | |
| | /MD7/HD4/BD2/RXD2  | | HD4: Data line 4 of high-speed parallel interface  |
BD2: Data line 2 of active parallel interface

CH569/565 Datasheet 4 http://wch.cn
RXD2: RXD pin input of UART2 peripheral
PA1: General purpose bidirectional digital I/O pin
PA1 MD6: EMMC peripheral data line 6
21 PA1 I/O
/MD6/HD5/BD1 HD5: Data line 5 of high-speed parallel interface
BD1: Data line 1 of active parallel interface
PA0: General purpose bidirectional digital I/O pin
PA0 MD5: EMMC peripheral data line 5
22 PA0 I/O
/MD5/HD6/BD0 HD6: Data line 6 of high-speed parallel interface
BD0: Data line 0 of active parallel interface
PB21: General purpose bidirectional digital I/O pin
PB21
23 PB21 I/O MD4: EMMC peripheral data line 5
/MD4/HD7
HD7: Data line 7 of high-speed parallel interface
PB20: General purpose bidirectional digital I/O pin
PB20
24 PB20 I/O MD3: EMMC peripheral data line 3
/MD3/HD8
HD8: Data line 8 of high-speed parallel interface
PB19: General purpose bidirectional digital I/O pin
PB19
25 PB19 I/O MD2: EMMC peripheral data line 2
/MD2/HD9
HD9: Data line 9 of high-speed parallel interface
PB18: General purpose bidirectional digital I/O pin
PB18
26 PB18 I/O MD1: EMMC peripheral data line 1
/MD1/HD10
HD10: Data line 10 of high-speed parallel interface
PB17: General purpose bidirectional digital I/O pin
PB17
27 PB17 I/O MD0: EMMC peripheral data line 0
/MD0/HD11
HD11: Data line 11 of high-speed parallel interface
PA17 PA17: General purpose bidirectional digital I/O pin
28 PA17 I/O
/HD12 HD12: Data line 12 of high-speed parallel interface
PB16: General purpose bidirectional digital I/O pin
PB16
29 PB16 I/O MCMD: Command signal line of EMMC peripheral
/MCMD/HD13
HD13: Data line 13 of high-speed parallel interface
PB15: General purpose bidirectional digital I/O pin
RST#: External reset input pin, active low
PB15 HD14: Data line 14 of high-speed parallel interface
30 PB15 I/O
/RST#/HD14/TMR1/PWM0 TMR1: Input capture and PWM output pin of timer1
peripheral
PWM0: PWMX peripheral channel 0 output
PB14: General purpose bidirectional digital I/O pin
MCMD: Clock signal line output of EMMC
PB14 peripheral
31 PB14 I/O /MSDCK/HD15/MISO1 HD15: Data line 15 of high-speed parallel interface
/BA14 MISO1: Host input slave output pin (MOSI) of SPI1
peripheral
BA14: Address line 14 of active parallel interface
PB0: General purpose bidirectional digital I/O pin
PB0 EMDIO: Ethernet controller SMI interface data pin
32 PB0 I/O /EMDIO/HD16/TMR1_ HD16: Data line 16 of high-speed parallel interface
/BA0 TMR1_: Input capture and PWM output pin mapping
of timer1 peripheral

CH569/565 Datasheet 5 http://wch.cn
BA0: Address line 0 of active parallel interface
PB1: General purpose bidirectional digital I/O pin
EMDIO: Ethernet controller SMI interface clock
PB1 output pin
33 PB1 I/O
/EMDCK/HD17/PWM2/BA1 HD17: Data line 17 of high-speed parallel interface
PWM2: PWMX peripheral channel 2 output
BA1: Address line 1 of active parallel interface
PB2: General purpose bidirectional digital I/O pin
EMDIO: Ethernet controller MII interface transmit
PB2 data line 3
34 PB2 I/O
/ETXD3/HD18/PWM3/BA2 HD18: Data line 18 of high-speed parallel interface
PWM3: PWMX peripheral channel 3 output
BA2: Address line 2 of active parallel interface
PA20: General purpose bidirectional digital I/O pin
PA20
35 PA20 I/O EMCO: Ethernet controller clock output pin
/EMCO/HD19
HD19: Data line 19 of high-speed parallel interface
PB31: General purpose bidirectional digital I/O pin
ETXD2: Ethernet controller MII interface transmit
data line 2
PB3
HD20: Data line 20 of high-speed parallel interface
36 PB3 I/O /ETXD2/HD20/TMR2_
TMR2_: Input capture and PWM output pin mapping
/BA3/RXD3
of timer2 peripheral
BA3: Address line 3 of active parallel interface
RXD3: RXD pin input of UART3 peripheral
PB4: General purpose bidirectional digital I/O pin
ETXD1: Ethernet controller MII interface transmit
PB4
data line 1
37 PB4 I/O /ETXD1/HD21/TXD3
HD21: Data line 21 of high-speed parallel interface
/BA4
TXD3: TXD pin output of UART3 peripheral
BA4: Address line 4 of active parallel interface
PB5: General purpose bidirectional digital I/O pin
EMDIO: Ethernet controller MII interface transmit
PB5
data line 0
38 PB5 I/O /ETXD0/HD22/BA5
HD22: Data line 22 of high-speed parallel interface
/RXD0
BA5: Address line 5 of active parallel interface
RXD0: RXD pin input of UART0 peripheral
PB6: General purpose bidirectional digital I/O pin
ETXEN: Ethernet controller MII interface transmit
PB6 data effective pin output
39 PB6 I/O
/ETXEN/HD23/TXD0/BA6 HD23: Data line 23 of high-speed parallel interface
TXD0: TXD pin output of UART0 peripheral
BA6: Address line 6 of active parallel interface
PA16: General purpose bidirectional digital I/O pin
PA16
40 PA16 I/O HD24: Data line 24 of high-speed parallel interface
/HD24/ETCKI
ETCKI: 125M clock input pin of Ethernet controller
PB7 PB7: General purpose bidirectional digital I/O pin
41 PB7 I/O /ETXC/HD25/BA7 ETXC: Ethernet controller MII interface transmit
/DSR clock pin output

CH569/565 Datasheet 6 http://wch.cn
HD25: Data line 25 of high-speed parallel interface
BA7: Address line 7 of active parallel interface
DSR: DSR pin of UART0 peripheral MODEM signal
3.3V or 2.5V input of I/O power, connected to an
42 VDDIO P VDDIO
external 0.1uF capacitor
PB8: General purpose bidirectional digital I/O pin
HD26: Data line 26 of high-speed parallel interface
PB8 BA8: Address line 8 of active parallel interface
43 PB8 I/O
/HD26/BA8/ERXC/RI ETXC: Ethernet controller MII interface receive
clock input pin
RI: RI pin of UART0 peripheral MODEM signal
PB9: General purpose bidirectional digital I/O pin
HD27: Data line 27 of high-speed parallel interface
BA9: Address line 9 of active parallel interface
PB9
44 PB9 I/O ERXD3: Ethernet controller MII interface receive
/HD27/BA9/ERXD3/DCD
data line 3
DCD: DCD pin of UART0 peripheral MODEM
signal
45 PB22 I/O PB22 PB22: General purpose bidirectional digital I/O pin
PB10: General purpose bidirectional digital I/O pin
HD28: Data line 28 of high-speed parallel interface
PB10 DTR: DTR pin of UART0 peripheral MODEM signal
46 PB10 I/O
/HD28/DTR/BA10/ERXD2 BA10: Address line 10 of active parallel interface
ERXD2: Ethernet controller MII interface receiving
data line 2
47 PB23 I/O PB23 PB23: General purpose bidirectional digital I/O pin
PB11: General purpose bidirectional digital I/O pin
HD29: Data line 29 of high-speed parallel interface
BA11: Address line 11 of active parallel interface
PB11
ERXD1: Ethernet controller MII interface receive
48 PB11 I/O /HD29/BA11/ERXD1
data line 1
/SCS1/CTS
SCS1: Chip select signal pin (SCS) of SPI1
peripheral
CTS: CTS pin of UART0 peripheral MODEM signal
49 PB24 I/O PB24 PB24: General purpose bidirectional digital I/O pin
PB12: General purpose bidirectional digital I/O pin
HD30: Data line 30 of high-speed parallel interface
PB12 SCK1: Clock signal SCK pin of SPI1 peripheral
50 PB12 I/O /HD30/SCK1/RTS RTS: RTS pin of UART0 peripheral MODEM signa l
/BA12/ERXD0 BA12: Address line 12 of active parallel interface
ERXD0: Ethernet controller MII interface receive
data line 0
PB13: General purpose bidirectional digital I/O pin
HD31: Data line 31 of high-speed parallel interface
PB13
MISI1: Master output slave input pin (MOSI) of SPI1
51 PB13 I/O /HD31/MOSI1/BA13
peripheral
/ERXDV
BA13: Address line 13 of active parallel interface
ERXDV: Ethernet controller MII interface receive

CH569/565 Datasheet 7  http://wch.cn
data effective pin input
PA21: General purpose bidirectional digital I/O pin
PA21
| 52  PA21  | I/O  | | HTVLD: Data transmit status pin output of  |
| --- | ---- | --- | --- |
/HTVLD
high-speed parallel interface
| | | PA22  | PA22: General purpose bidirectional digital I/O pin  |
| --- | ---- | ----- | --- |
| 53  PA22  | I/O  | | |
| | | /HD2  | HD2: Data line 2 of high-speed parallel interface |
PA9: General purpose bidirectional digital I/O pin
HTREQ: Transmit request signal output of
high-speed parallel interface
PA9
54  PA9  I/O  TMR0: Input capture and PWM output pin of timer0
/HTREQ/TMR0/BWR#
peripheral
BWR#: Write control signal output of active parallel
interface, active low
PA10: General purpose bidirectional digital I/O pin
| | | PA10 | TCK: Debug function clock input pin |
| --- | ---- | --- | --- |
| 55  PA10  | I/O  | | |
| | | /TCK/HTACK  | HTACK: Receive status pin output of high-speed  |
parallel interface
PA11: General purpose bidirectional digital I/O pin
TIO: Data input and output hardware of Debug
PA11
| 56  PA11  | I/O  | | function  |
| --- | ---- | --- | --- |
/TIO/HTCLK
HTCLK: Communication clock pin output of
high-speed parallel interface
| | | PA12  | PA12: General purpose bidirectional digital I/O pin |
| --- | ---- | ----- | --- |
| 57  PA12  | I/O  | | |
| | | /SCS  | SCS: Chip select signal pin (SCS) of SPI0 peripheral  |
| | | PA13  | PA13: General purpose bidirectional digital I/O pin |
| 58  PA13  | I/O  | | |
| | | /SCK  | SCK: Clock signal SCK pin of SPI0 peripheral |
PA14: General purpose bidirectional digital I/O pin
PA14
59  PA14  I/O  MOSI: Master output slave input pin (MOSI) of SPI0
/MOSI
peripheral
PA15: General purpose bidirectional digital I/O pin
PA15
60  PA15  I/O  MISO1: Master input slave output pin (MISO) of
/MISO
SPI0 peripheral
3.3V or 2.5V input of I/O power, connected to an
| 61  VDDIO  | P | VDDIO  | |
| --- | --- | --- | --- |
external 0.1uF capacitor
3.3V or 2.5V input of internal LDO power, connected
| 62  V33LDO  | P | V33LDO  | |
| --- | --- | --- | --- |
to an external 0.1uF capacitor
1.2V core voltage output of system, connected to an
| 63 V12CORE  | P | V12CORE  | |
| --- | --- | --- | --- |
external 3.3uF capacitor
3.3V input of SerDes PHY, connected to an external
| 64  V33GX  | P | V33GX  | |
| --- | --- | --- | --- |
0.1uF capacitor
| 65  GXM  | SDP  | GXM  | SerDes differential signal line GXM  |
| --- | ---- | ---- | --- |
| 66  GXP  | SDP  | GXP  | SerDes differential signal line GXP  |
Inverted output of external high-speed crystal
| 67  XO  | O | XO  | |
| --- | --- | --- | --- |
oscillator
68  XI  I  XI  Input of external high-speed crystal oscillator

CH569/565 Datasheet 8  http://wch.cn
1.3.2 CH565 pin definitions
Table 1-3 CH565 pin definitions
Pin No.
Main Function (after
| CH565W  CH565M  | Pin  | reset)/  | |
| --- | ---- | --- | --- |
Type  Description
| | Name  | alternate and  | |
| --- | ----- | --- | --- |
mapping
| 0  0 | GND | P  GND  | Ground (EPAD) |
| --- | --- | --- | --- |
| 1  40  | UD+ USB2.0 | DP | USB2.0 signal line D+  |
| 2  1 | UD- USB2.0 | DN | USB2.0 signal line D-  |
3.3V power input of USB PHY, connected to an
| 3  2  | V33USB  | P  V33USB  | |
| ----- | --- | --- | --- |
external 0.1uF capacitor
4  3  SSTXA  USB3.0  SSTXA  USB3.0 super-speed signal line TXA
5  4  SSTXB  USB3.0  SSTXB  USB3.0 super-speed signal line TXB
1.2V power input of USB PHY, connected to an
| 6  5  | V12USB  | P  V12USB  | |
| ----- | --- | --- | --- |
external 0.1uF capacitor
7  6  SSRXA  USB3.0  SSRXA  USB3.0 super-speed signal line RXA
8  7  SSRXB  USB3.0  SSRXB  USB3.0 super-speed signal line RXB
1.2V core voltage input of the system, connected to
9  27  V12CORE  P  V12CORE  the other V12CORE pin with an external 0.1uF
capacitor
10  -  PA19  I/O  PA19  PA19: General purpose bidirectional digital I/O pin
11  -  PA18  I/O  PA18  PA18: General purpose bidirectional digital I/O pin
PA8: General purpose bidirectional digital I/O pin
PA8  TXD1: TXD pin output of UART1 peripheral
| 12  -  | PA8  I/O  | | |
| --- | --- | --- | --- |
| | | /TXD1/BRD#  | BRD#: Read control signal output of active parallel  |
interface, active low
PA78: General purpose bidirectional digital I/O pin
PA7
13  -  PA7  I/O  BD7: Data line 7 of active parallel interface
/BD7/RXD1
RXD1: RXD pin output of UART1 peripheral
PA6: General purpose bidirectional digital I/O pin
TXD0_: TXD function pin mapping of UART0
PA6
| 14  9  | PA6  I/O  | | peripheral  |
| --- | --- | --- | --- |
/TXD0_/BD6/DPCLK
BD6: Data line 6 of active parallel interface
DPCLK: Digital video port clock signal input
PA5: General purpose bidirectional digital I/O pin
BD5: Data line 5 of active parallel interface
PA5  DHSYN: Sync signal input of digital video interface
| 15  10  | PA5  I/O  | | |
| --- | --- | --- | --- |
/BD5/DHSYN/RXD0_ line
RXD0_: RXD function pin mapping of UART0
peripheral
3.3V or 2.5V input of I/O power, connected with an
| 16  8  | VDDIO  | P  VDDIO  | |
| --- | --- | --- | --- |
external 0.1uF capacitor
PA4  PA4: General purpose bidirectional digital I/O pin
17  11  PA4  I/O  /TMR2/PWM1/BD4  TMR2: Input capture and PWM output pin of timer2
| | | /DVSYN  | Peripheral  |
| --- | --- | --- | --- |

CH569/565 Datasheet 9  http://wch.cn
PWM1: PWMX peripheral channel 1 output
BD4: Data line 4 of active parallel interface
DVSYN: Sync signal input of digital video port frame
18  -  PA23  I/O  PA23  PA23: General purpose bidirectional digital I/O pin
PA3: General purpose bidirectional digital I/O pin
| | | PA3 | TXD2: TXD pin output of UART2 peripheral |
| --- | --- | --- | --- |
| 19  12  | PA3  I/O  | | |
| | | /TXD2/BD3/DD0  | BD3: Data line 3 of active parallel interface  |
DD0: Digital video port data line 0
PA2: General purpose bidirectional digital I/O pin
| | | PA2  | MD7: EMMC peripheral data line 7  |
| --- | --- | ---- | --- |
20  13  PA2  I/O  /MD7/BD2/DD1  BD2: Data line 2 of active parallel interface
| | | /RXD2  | DD1: Digital video port data line 1  |
| --- | --- | --- | --- |
RXD2: RXD pin input of UART2
PA1: General purpose bidirectional digital I/O pin
| | | PA1 | MD6: EMMC peripheral data line 6 |
| --- | --- | --- | --- |
| 21  14  | PA1  I/O  | | |
| | | /MD6/BD1/DD2  | BD1: Data line 1 of active parallel interface  |
DD2: Digital video port data line 2
PA0: General purpose bidirectional digital I/O pin
| | | PA0 | MD5: EMMC peripheral data line 5 |
| --- | --- | --- | --- |
| 22  15  | PA0  I/O  | | |
| | | /MD5/BD0/DD3  | BD0: Data line 0 of active parallel interface  |
DD3: Digital video port data line 3
PB21: General purpose bidirectional digital I/O pin
PB21
| 23  16  | PB21  I/O  | | MD4: EMMC peripheral data line 4  |
| --- | --- | --- | --- |
/MD4/DD4
DD4: Digital video port data line 4
PB20: General purpose bidirectional digital I/O pin
PB20
| 24  17  | PB20  I/O  | | MD3: EMMC peripheral data line 3  |
| --- | --- | --- | --- |
/MD3/DD5
DD5: Digital video port e data line 5
PB19: General purpose bidirectional digital I/O pin
PB19
| 25  18  | PB19  I/O  | | MD2: EMMC peripheral data line 2  |
| --- | --- | --- | --- |
/MD2/DD6
DD6: Digital video port data line 6
PB18: General purpose bidirectional digital I/O pin
PB18
| 26  19  | PB18  I/O  | | MD1: EMMC peripheral data line 1  |
| --- | --- | --- | --- |
/MD1/DD7
DD7: Digital video port data line 7
PB17: General purpose bidirectional digital I/O pin
PB17
| 27  20  | PB17  I/O  | | MD0: EMMC peripheral data line 0  |
| --- | --- | --- | --- |
/MD0/DD8
DD8: Digital video port data line 8
28  -  PA17  I/O  PA17  PA17: General purpose bidirectional digital I/O pin
PB16: General purpose bidirectional digital I/O pin
PB16
29  23  PB16  I/O  MCMD: Command signal line of EMMC peripheral
/MCMD/DD9
DD9: Digital video port data line 9
PB15: General purpose bidirectional digital I/O pin
RST# external reset input pin, active low
PB15
TMR1: Input capture and PWM output pin of timer1
| 30  21  | PB15  I/O  | /RST#/TMR1/PWM0  | |
| --- | --- | --- | --- |
peripheral
/DD10
PWM0: PWMX peripheral channel 0 output
DD10: Digital video port data line 10
31  22  PB14  I/O  PB14  PB14: General purpose bidirectional digital I/O pin

CH569/565 Datasheet 10 http://wch.cn
/MSDCK/MISO1 MCMD: Clock signal line output of EMMC peripheral
/BA14/DD11 MISO1: Master input slave output pin (MOSI) of SPI1
peripheral
BA14: Address line 14 of active parallel interface
DD10: Digital video port data line 11
PB0: General purpose bidirectional digital I/O pin
PB0 EMDIO: Ethernet controller SMI interface data pin
32 - PB0 I/O /EMDIO/TMR1_ TMR1_: Input capture and PWM output pin mapping
/BA0 of timer1 peripheral
BA0: Address line 0 of active parallel interface
PB1: General purpose bidirectional digital I/O pin
EMDIO: Ethernet controller SMI interface clock
PB1
33 - PB1 I/O output pin
/EMDCK/PWM2/BA1
PWM2: PWMX peripheral channel 2 output
BA1: Address line 1 of active parallel interface
PB2: General purpose bidirectional digital I/O pin
EMDIO: Ethernet controller MII interface transmit
PB2
34 - PB2 I/O data line 3
/ETXD3/PWM3/BA2
PWM3: PWMX peripheral channel 3 output
BA2: Address line 2 of active parallel interface
PA20 PA20: General purpose bidirectional digital I/O pin
35 - PA20 I/O
/EMCO EMCO: Ethernet controller clock output pin
PB31: General purpose bidirectional digital I/O pin
ETXD2: Ethernet controller MII interface transmit
PB3 data line 2
36 24 PB3 I/O /ETXD2/TMR2_ TMR2_: Input capture and PWM output pin mapping
/BA3/RXD3 of timer 2 peripheral
BA3: Address line 3 of active parallel interface
RXD3: RXD pin input of UART3 peripheral
PB4: General purpose bidirectional digital I/O pin
ETXD1: Ethernet controller MII interface transmit
PB4
37 25 PB4 I/O data line 1
/ETXD1/TXD3/BA4
TXD3: TXD pin output of UART3
BA4: Address line 4 of active parallel interface
PB5: General purpose bidirectional digital I/O pin
EMDIO: Ethernet controller MII interface transmit
PB5
38 - PB5 I/O data line 0
/ETXD0/BA5/RXD0
BA5: Address line 5 of active parallel interface
RXD0: RXD pin input of UART0 peripheral
PB6: General purpose bidirectional digital I/O pin
ETXEN: Ethernet controller MII interface transmit
PB6
39 - PB6 I/O data effective pin output
/ETXEN/TXD0/BA6
TXD0: TXD pin output of UART0 peripheral
BA6: Address line 6 of active parallel interface
PA16 PA16: General purpose bidirectional digital I/O pin
40 - PA16 I/O
/ETCKI ETCKI: 125M clock input pin of Ethernet controller
PB7 PB7: General purpose bidirectional digital I/O pin
41 - PB7 I/O
/ETXC/BA7/DSR ETXC: Ethernet controller MII interface transmit

CH569/565 Datasheet 11 http://wch.cn
clock pin output
BA7: Address line 7 of active parallel interface
DSR: DSR pin of UART0 peripheral MODEM signal
3.3V or 2.5V input of I/O power, connected to an
42 26 VDDIO P VDDIO
external 0.1uF capacitor
PB8: General purpose bidirectional digital I/O pin
BA8: Address line 8 of active parallel interface
PB8
43 - PB8 I/O ETXC: Ethernet controller MII interface receive clock
/BA8/ERXC/RI
input pin
RI: RI pin of UART0 peripheral MODEM signal
PB9: General purpose bidirectional digital I/O pin
BA9: Address line 9 of active parallel interface
PB9
44 - PB9 I/O ERXD3: Ethernet controller MII interface receive data
/BA9/ERXD3/DCD
line 3
DCD: DCD pin of UART0 peripheral MODEM signal
45 - PB22 I/O PB22 PB22: General purpose bidirectional digital I/O pin
PB10: General purpose bidirectional digital I/O pin
DTR: DTR pin of UART0 peripheral MODEM signal
PB10
46 - PB10 I/O BA10: Address line 10 of active parallel interface
/DTR/BA10/ERXD2
ERXD2: Ethernet controller MII interface receive data
line 2
47 - PB23 I/O PB23 PB23: General purpose bidirectional digital I/O pin
PB11: General purpose bidirectional digital I/O pin
BA11: Address line 11 of active parallel interface
PB11
ERXD1: Ethernet controller MII interface receive data
48 28 PB11 I/O /BA11/ERXD1
line 1
/SCS1/CTS
SCS1: Chip select signal pin (SCS) of SPI1 peripheral
CTS: CTS pin of UART0 peripheral MODEM signal
49 - PB24 I/O PB24 PB24: General purpose bidirectional digital I/O pin
PB12: General purpose bidirectional digital I/O pin
SCK1: Clock signal SCK pin of SPI1 peripheral
PB12
RTS: RTS pin of UART0 peripheral MODEM signal
50 29 PB12 I/O /SCK1/RTS
BA12: Address line 12 of active parallel interface
/BA12/ERXD0
ERXD0: Ethernet controller MII interface receive data
line 0
PB13: General purpose bidirectional digital I/O pin
MISI1: Master output slave input pin (MOSI) of SPI1
PB13
peripheral
51 30 PB13 I/O /MOSI1/BA13
BA13: Address line 13 of active parallel interface
/ERXDV
ERXDV: Ethernet controller MII interface receive
data effective pin input
52 - PA21 I/O PA21 PA21: General purpose bidirectional digital I/O pin
53 - PA22 I/O PA22 PA22: General purpose bidirectional digital I/O pin
PA9: General purpose bidirectional digital I/O pin
PA9 TMR0: Input capture and PWM output pin of timer0
54 31 PA9 I/O
/TMR0/BWR# peripheral
BWR#: Write control signal output of active parallel

CH569/565 Datasheet 12  http://wch.cn
interface, active low
| | | | PA10  | PA10: General purpose bidirectional digital I/O pin  |
| --- | ----- | ---- | ----- | --- |
| 55  -  | PA10  | I/O  | | |
| | | | /TCK  | TCK: Clock input pin for Debug function |
PA11: General purpose bidirectional digital I/O pin
PA11
56  -  PA11  I/O  TIO: Data input and output hardware of Debug
/TIO
function
| | | | PA12  | PA12: General purpose bidirectional digital I/O pin |
| --- | ----- | ---- | ----- | --- |
| 57  - | PA12  | I/O  | | |
| | | | /SCS  | SCS: Chip select signal pin (SCS) of SPI0 peripheral  |
| | | | PA13  | PA13: General purpose bidirectional digital I/O pin |
| 58  32  | PA13  | I/O  | | |
| | | | /SCK  | SCK: Clock signal SCK pin of SPI0 peripheral |
PA14: General purpose bidirectional digital I/O pin
PA14
59  -  PA14  I/O  MOSI: Master output slave input pin (MOSI) of SPI0
/MOSI
peripheral
PA15: General purpose bidirectional digital I/O pin
PA15
60  -  PA15  I/O  MISO1: Master input slave output pin (MISO) of SPI0
/MISO
peripheral
3.3V or 2.5V input of I/O power, connected to an
| 61 | VDDIO  | P | VDDIO  | |
| ----- | --- | --- | --- | --- |
external 0.1uF capacitor
3.3V or 2.5V input of internal LDO power, connected
| 62  33  | V33LDO  | P | V33LDO  | |
| --- | --- | --- | --- | --- |
to an external 0.1uF capacitor
1.2V core voltage output of system, connected to an
| 63  34  | V12CORE  | P | V12CORE  | |
| --- | --- | --- | --- | --- |
external 3.3uF capacitor
3.3V input of SerDes PHY, connected to an external
| 64  35  | V33GX  | P | V33GX  | |
| --- | --- | --- | --- | --- |
0.1uF capacitor
| 65  36  | GXM  | SDP  | GXM  | SerDes differential signal line GXM  |
| --- | ---- | ---- | ---- | --- |
| 66  37  | GXP  | SDP  | GXP  | SerDes differential signal line GXP  |
Inverted output of external high-speed crystal
| 67  38  | XO  | O | XO  | |
| --- | --- | --- | --- | --- |
oscillator
68  39  XI  I  XI  Input of external high-speed crystal oscillator

Note:
(1)  I: Input; O: Output; I/O: Input and output.
(2)  P: Power.
(3)  USB: USB signal.
(4)  SDP: SerDes PHY signal.

CH569/565 Datasheet 13 http://wch.cn
Chapter 2 System architecture and memory
2.1 System architecture
Figure 2-1 System architecture diagram
Figure 2-1 is the internal architecture diagram. The RISC-V core, DMA1/DMA2 arbitration controller, ROM
control module, SRAM and various peripheral modules are mounted on the 32bit system bus (AHB). The
core can access various peripherals and modules through the system bus, and receive external interrupt
signals to trigger interrupt services. The system defaults to 32K bytes of ROM code at full speed without
waiting, thus ensuring that the instruction addressing speed is consistent with the system clock frequency.
The SRAM areas accessible to users are divided into the RAMS area and the RAMX area. Among them, the
size of RAMX can be configured through the interface, and the extra area can be used for the SRAM
mapping range of ROM code.
l RAMS: 16K bytes in total, 32-bit width of access SRAM, with the addressing range from 0x20000000

CH569/565 Datasheet 14 http://wch.cn
to 0x20003FFF
l RAMX: Configurable 32K/64K/96K byte size, 128-bit wide access high-speed SRAM, with the addressing
range from 0x20020000 to 0x20037FFF
l DMA1: The access between RAMX and CPU, common peripherals and high-speed peripherals is
established. High-speed peripherals: EMMC, HSPI, ECDC, USB2.0, USB3.0, ETH, SerDes and DVP.
l DMA2: The access between RAMS and CPU and common peripherals is established. Common
peripherals include Timer1, Timer2, SPI0 and SPI1
Note 1: CH569 is not equipped with DVP peripheral module. CH565 is not equipped with HSPI module.
Other resources of them are the same.
Note 2: High-speed peripherals can only access the RAMX area. Pay attention to the DMA address range
configured by high-speed peripheral registers for application code.
2.2 Memory map
The addressing space of system bus mainly includes non-volatile memory (CODE), static memory (RAMS
and RAMX), peripherals and external bus. Refer to Figure 2-2.

CH569/565 Datasheet 15  http://wch.cn
Figure 2-2 Memory map
0x4001 0000
Reserved
0x4000 E400
DVP
0x4000 E000
Reserved
0x4000 D400
ETH
0x4000 C000
Reserved
0x4000 B400
SERDES
0x4000 B000
| | 0xFFFF FFFFF | | Reserved |
| --- | --- | --- | --- |
Reserved 0x4000 A400
| | 0xE010 0000 | | EMMC |
| --- | --- | --- | ---- |
RISC-V3A  Private 0x4000 A000
| | Peripherals | | Reserved |
| --- | --- | --- | --- |
0xE000 0000
0x4000 9400
| | Reserved | | USBHS |
| --- | --- | --- | ----- |
0x4000 9000
0x8008 0000
Reserved
BUS8 0x4000 8400
| | (32KB) | | USBSS |
| --- | --- | --- | ----- |
0x8000 0000 0x4000 8000
| | Reserved | | Reserved |
| --- | --- | --- | --- |
0x4000 7400
| | 0x4001 0000 | | ECDC |
| --- | --- | --- | ---- |
0x4000 7000
| | Peripheral | | Reserved |
| --- | --- | --- | --- |
0x4000 6400
HSPI
0x4000 0000 0x4000 6000
Reserved
0x4000 5400
| | Reserved | | PWMX |
| --- | --- | --- | ---- |
0x4000 5000
Reserved
0x2003 8000 0x4000 4800
SPI1
0x4000 4400
RAMX
SPI0
(32KB/64KB/96KB) 0x4000 4000
UART3
0x2002 0000 0x4000 3C00
UART2
Reserved 0x4000 3800
| | 0x2000 4000 | | UART1 |
| --- | --- | --- | ----- |
RAMS  0x4000 3400
UART0
(16KB) 0x4000 3000
| | 0x2000 0000 | | Reserved |
| --- | --- | --- | --- |
0x4000 2C00
| | Reserved | | TMR2 |
| --- | --- | --- | ---- |
0x4000 2800
TMR1
0x0008 0000 0x4000 2400
FLASH
TMR0
Code running 0x4000 2000
 low speed  Reserved
CodeFlash 0x4000 1400
SYS
Code running with 0 wait  0x4000 1000
(32KB/64KB/96KB)
Reserved
0x0000 0000 0x4000 0000
| | 线性地址空间 | | 外设分配 |
| --- | --- | --- | ---- |

Table 2-1 Memory mapping area address
| Address range  | | Use  | Description  |
| --- | --- | ---- | --- |
0x00000000-0x0007FFFF  On-chip non-volatile memory  Flash memory (512KB)
| 0x00080000-0x1FFFFFFF  | Reserved  | | - |
| --- | --- | --- | --- |
0x20000000-0X20003FFF  RAMS, usually used to store data  16KB general SRAM
| 0x20004000-0x2001FFFF  | Reserved | | - |
| --- | --- | --- | --- |
| | RAMX, used for DMA data access of  | 32/64/96KB configurable  | |
0x20020000-0x20037FFF
| | high-speed peripherals  | | SRAM  |
| --- | --- | --- | ----- |
| 0x20038000-0x3FFFFFFF  | Reserved | | - |
Various peripheral address
| 0x40000000-0x4000FFFF  | Various functional modules or peripherals  | | |
| --- | --- | --- | --- |
spaces
Reserved
| 0x40010000-0x7FFFFFFF  | | | - |
| --- | --- | --- | ----- |
| 0x80000000-0x80007FFF  | External bus  | | 32KB  |
Reserved
| 0x80008000-0xFFFFFFFF  | | | - |
| --- | --- | --- | --- |

| CH569/565 Datasheet 16  | | | | http://wch.cn  |
| --- | --- | --- | --- | --- |

2.2.1 On-chip non-volatile memory map
The non-volatile memory area mainly includes CodeFlash, DataFlash, BootLoader and InfoFlash. InfoFlash
is used to store the manufacturer's data. Generally, the manufacturer writes the configuration information
before the chip leaves the factory, as shown in Table 2-2.
Table 2-2 Description of non-volatile information
| Field  | Name  | | Description  | Default Value  |
| --- | ----- | --- | --- | --- |
System RAMX/ROM capacity redefine
configuration.
00: RAMX 32KB + ROM 96KB
01: RAMX 64KB + ROM 64KB
| [31:30] USER_MEM  | | 1x: RAMX 96KB + ROM 32KB  | | 10b  |
| --- | --- | --- | --- | ---- |
Note: The above ROM space supports full-speed
operation without waiting. If the size of code
exceeds the above ROM space, the code of the
excess part will run at a low speed of about 1/8.
Core LOCKUP reset system enable.
1: When the core generates LOCKUP, the system
| 29  LOCKUP_RST_EN  | | is reset;  | | 0 |
| --- | --- | --- | --- | --- |
0: When the core generates LOCKUP, the system
is not reset.
| 28  RESERVED2 | | Reserved.  | | 0 |
| --- | --- | --- | --- | --- |
| [27:12] RESERVED2  | | Reserved.  | | FFFFh  |
| [11:10] RESERVED3  | | Reserved.  | | 00b |
| [9:8]  RESERVED4 | | Reserved.  | | 10b |
External programmer read FLASH enable.
1: External programmer enabled to read FLASH
| 7  CODE_READ_EN  | | (code is open);  | | 0 |
| --- | --- | --- | --- | --- |
0: External programmer disabled to read FLASH
(code is protected).
Bootloader function enable.
| 6  BOOT_EN  | | 1: BOOT program enabled;  | | 1 |
| --- | --- | --- | --- | --- |
0: BOOT program disabled.
Debug interface enable.
1: Debug interface enabled;
0: Debug interface disabled.
| 5  DEBUG_EN  | | | | 0 |
| --- | --- | --- | --- | --- |
Note: When debug interface is enabled, external
reset must be disabled. Otherwise, the debug
function cannot be used normally.
External reset enable.
1: External reset input from PB15 enabled, and
| 4  RESET_EN  | | PB15 is used as system external reset pin;  | | 0 |
| --- | --- | --- | --- | --- |
0: External reset input from PB15 disabled, and
PB15 is used as a normal GPIO.
| [3:0]  RESERVED5  | | Reserved.  | | 0101b  |
| --- | --- | --- | --- | --- |
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
