kelu124/rp569/docs/img/pcb-render-v0.1.png

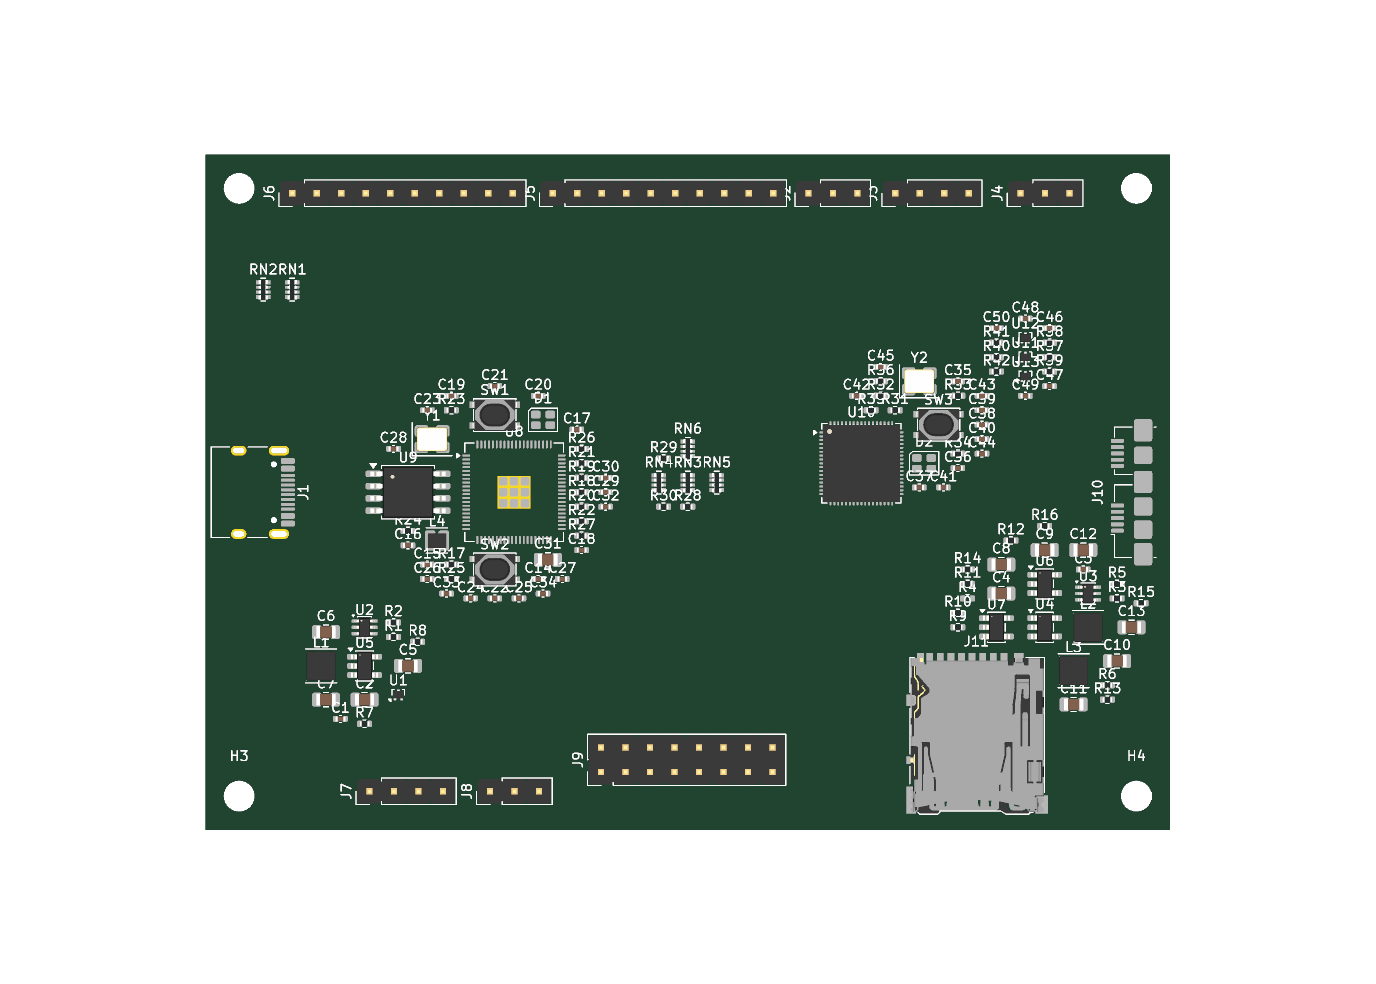
docs/img/pcb-render-v0.1.png
