kelu124/rp569/docs/img/pcb-render-v0.2-bottom.png

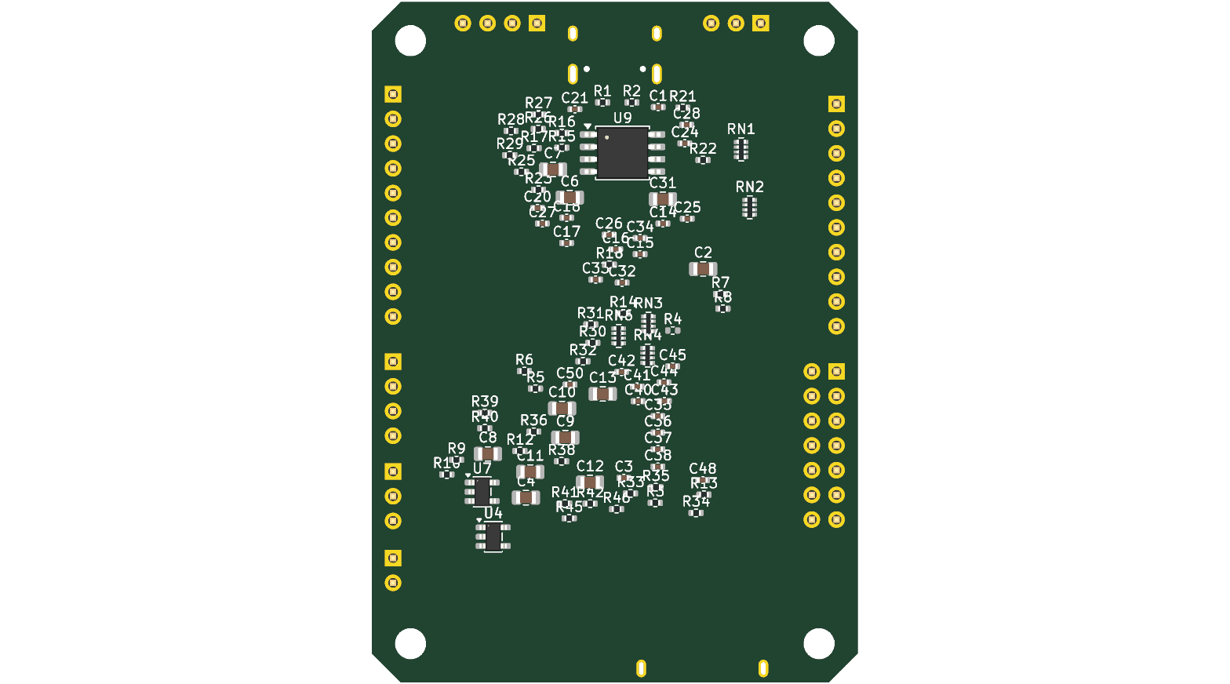
docs/img/pcb-render-v0.2-bottom.png
