kelu124/rp569/docs/img/pcb-render-v0.2-top.png

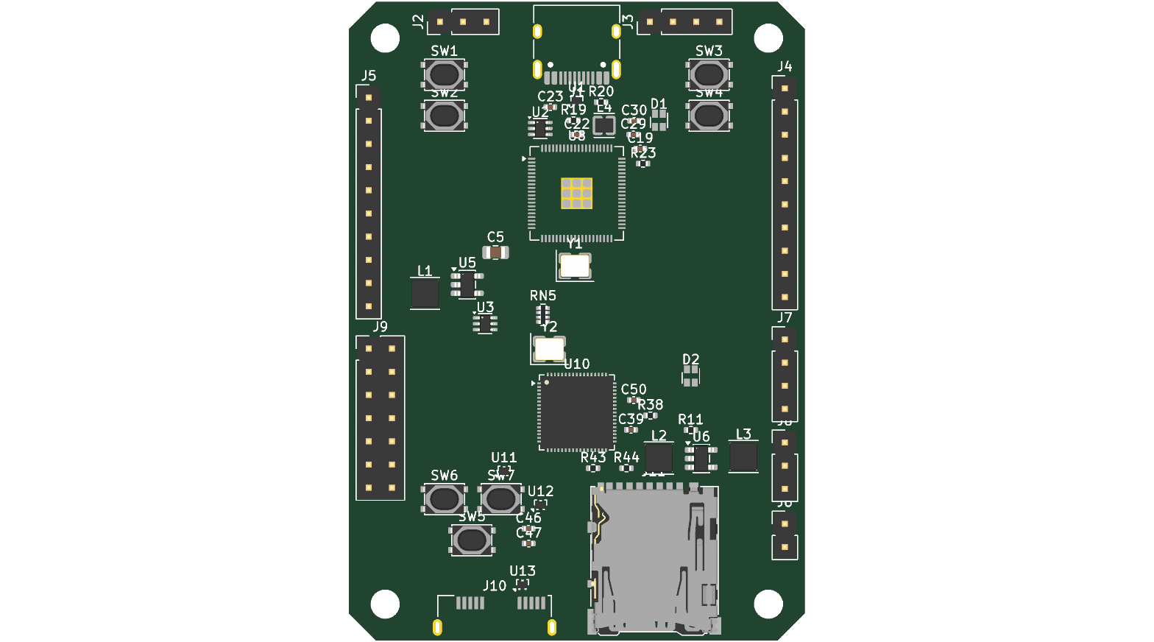
docs/img/pcb-render-v0.2-top.png
