kelu124/rp569/docs/img/pcb-render-v1.0-top.png

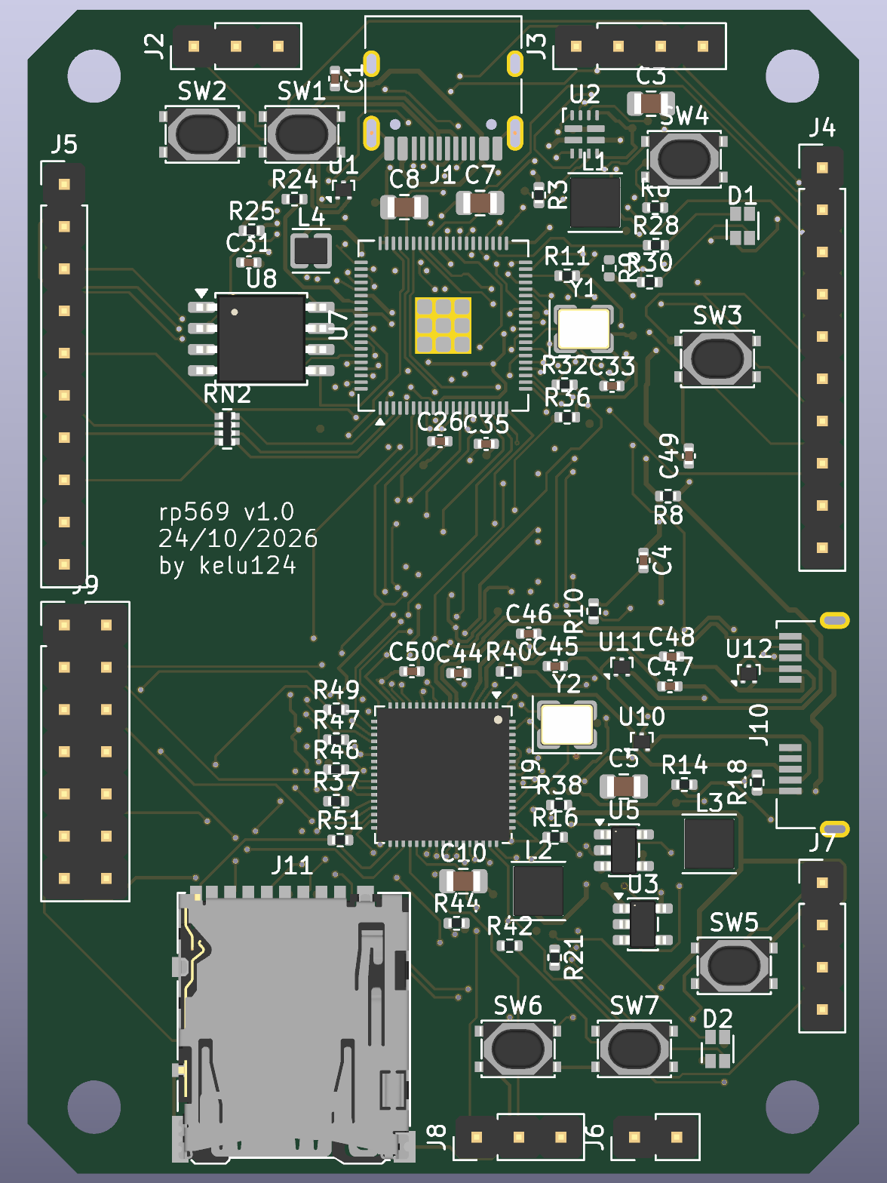
docs/img/pcb-render-v1.0-top.png
