kelu124/rp569/hardware/jlcpcb/rp569-bom.csv

Comment | Designator | Footprint | LCSC Part # | MPN | Qty | Note
USB-C (RP2350) | J1 | USB_C_Receptacle_HRO_TYPE-C-31-M-12 | C165948 | TYPE-C-31-M-12 | 1
5.1k | R1,R2 | R_0402_1005Metric | C25905 | 0402WGF5101TCE | 2
TPD2EUSB30 | U1,U10,U11,U12 | Texas_DRT-3 | C97502 | TPD2EUSB30DRTR | 4
4.7uF | C1,C29,C30,C31,C49,C51 | C_0402_1005Metric | C23733 | CL05A475MP5NRNC | 6
TPS2121 | U2 | TI_RUX0012A_VQFN-HR-12_2x2.5mm | C485916 | TPS2121RUXR | 1
23.7k | R3,R5 | R_0402_1005Metric | C226363 | AC0402FR-0723K7L | 2
4.99k | R4,R6 | R_0402_1005Metric | C25903 | 0402WGF4991TCE | 2
100k | R7,R10,R13,R15,R16,R17,R18,R20,R21,R51 | R_0402_1005Metric | C25741 | 0402WGF1003TCE | 10
10nF | C2 | C_0402_1005Metric | C15195 | CL05B103KB5NNNC | 1
10uF | C3,C5,C6,C9,C12,C32 | C_0805_2012Metric | C15850 | CL21A106KAYNNNE | 6
0R | R8 | R_0402_1005Metric | C17168 | 0402WGF0000TCE | 1
AP2171W | U3 | SOT-23-5 | C110466 | AP2171WG-7 | 1
1uF | C4 | C_0402_1005Metric | C52923 | CL05A105KA5NQNC | 1
10k | R11,R27,R33,R34,R37,R39,R40 | R_0402_1005Metric | C25744 | 0402WGF1002TCE | 7
TLV62569 | U4,U5,U6 | SOT-23-5 | C141836 | TLV62569DBVR | 3
2.2uH | L1,L2,L3 | L_Changjiang_FTC303015D | C7423318 | FTC303020D2R2MBCA | 3
453k | R12,R14 | R_0402_1005Metric | C27009 | 0402WGF4533TCE | 2
22uF | C7,C8,C10,C11,C13,C14 | C_0805_2012Metric | C45783 | CL21A226MAQNNNE | 6
47k | R19,R46,R47,R48,R49,R50 | R_0402_1005Metric | C25792 | 0402WGF4702TCE | 6
RP2350B | U7 | QFN-80-1EP_10x10mm_P0.4mm_EP3.4x3.4mm | C42415655 | RP2350B | 1
100nF | C15,C16,C17,C18,C19,C20,C21,C22,C23,C24,C25,C26,C27,C28,C35,C36,C37,C38,C39,C40,C41,C42,C43,C44,C47,C48,C50 | C_0402_1005Metric | C1525 | CL05B104KO5NNNC | 27
3.3uH | L4 | L_Cenker_CKCS201610 | C42411119 | AOTA-B201610S3R3-101-T | 1
33R | R22 | R_0402_1005Metric | C25105 | 0402WGF330JTCE | 1
12MHz | Y1 | Crystal_SMD_3225-4Pin_3.2x2.5mm | C20625731 | ABM8-272-T3 | 1
1k | R23,R26,R38 | R_0402_1005Metric | C11702 | 0402WGF1001TCE | 3
15pF | C33,C34,C45,C46 | C_0402_1005Metric | C1548 | 0402CG150J500NT | 4
27R | R24,R25 | R_0402_1005Metric | C138021 | RC0402FR-0727RL | 2
W25Q128JVS | U8 | SOIC-8_5.3x5.3mm_P1.27mm | C97521 | W25Q128JVSIQ | 1
PTS810SJG250SMTRLFS | SW1,SW2,SW3,SW4,SW5,SW6,SW7 | SW_SPST_PTS810 | C221895 | PTS810SJG250SMTRLFS | 7
2.54-1*3P | J2,J8 | PinHeader_1x03_P2.54mm_Vertical | C49257 | 2.54-1*3P | 2 | THT
RGB | D1,D2 | LED_LiteOn_LTST-C19HE1WT | C458749 | LTST-C19HE1WT | 2
330R | R28,R41 | R_0402_1005Metric | C25104 | 0402WGF3300TCE | 2
100R | R29,R30,R42,R43 | R_0402_1005Metric | C25076 | 0402WGF1000TCE | 4
PZ254V-11-04P | J3,J7 | PinHeader_1x04_P2.54mm_Vertical | C492403 | PZ254V-11-04P | 2 | THT
4.7k | R31,R32,R35,R36,R44,R45 | R_0402_1005Metric | C25900 | 0402WGF4701TCE | 6
PZ254V-11-10P | J4,J5 | PinHeader_1x10_P2.54mm_Vertical | C492409 | PZ254V-11-10P | 2 | THT
100R | RN1,RN2 | R_Array_Convex_4x0402 | C48442 | 4D02WGJ0101TCE | 2
CH569W | U9 | QFN-68-1EP_8x8mm_P0.4mm_EP5.2x5.2mm |  | CH569W | 1 | consigned (not stocked by JLCPCB)
30MHz | Y2 | Crystal_SMD_3225-4Pin_3.2x2.5mm | C70592 | X322530MOB4SI | 1
CH BOOT JP | J6 | PinHeader_1x02_P2.54mm_Vertical | C492401 | PZ254V-11-02P | 1 | THT
CH EXT | J9 | PinHeader_2x07_P2.54mm_Vertical | C492424 | PZ254V-12-14P | 1 | THT
USB3 Micro-B (CH569) | J10 | USB3_Micro-B_Amphenol_GSB343K33HR |  | GSB343K33HR | 1 | consigned (not stocked by JLCPCB)
microSD | J11 | microSD_HC_Hirose_DM3AT-SF-PEJM5 | C114218 | DM3AT-SF-PEJM5 | 1
