kelu124/rp569/project/hydrausb3/hydrausb3_hw/HydraUSB3_V1R1.FCStd

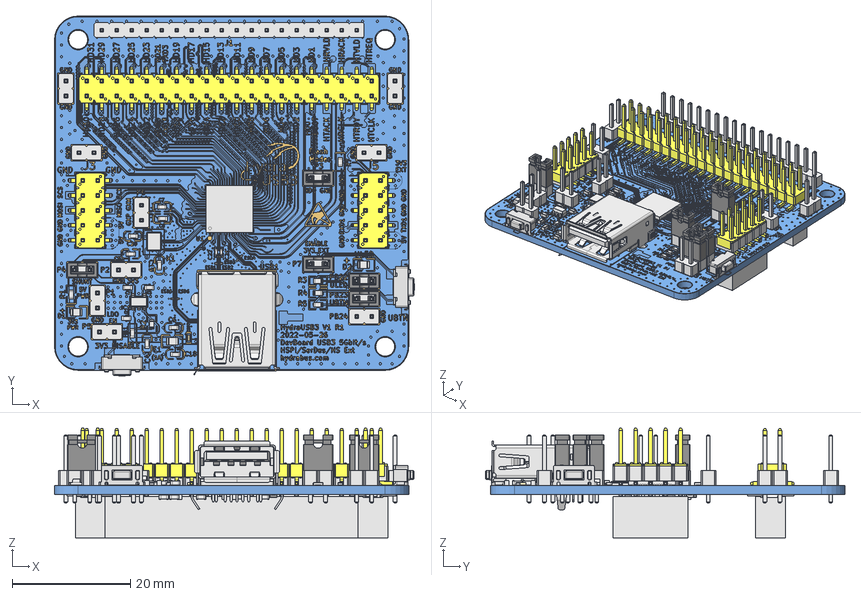
[picture p13: CAD file, 2026-10-23]
project/hydrausb3/hydrausb3_hw/HydraUSB3_V1R1.FCStd
61.0 x 61.0 x 18.6 mm
Pcb_33d0
topTracks_33d0
topZones_33d0
botTracks_33d0
botZones_33d0
Tracks_Bottom
Tracks_Top
C20_C_0603_1608Metric_56f696e6aad7 x 22
IC1_SOT_23_5_4ee02349ebbe
X1_Crystal_SMD_Abracon_ABM8G-4Pin_3.2x2.5mm_cd1c07089b73
JMP_UBTN1_Jumper 2_54mm_e4852e0d571f x 5
UBTN1_P:\\E-Switch Secure\\3D_MODELS_STP_FORMAT\\TL3330AFxxxQG.stp_333925a103b6 x 2
R1_R_0603_1608Metric_0e59cfc72ac2 x 7
G4_PinHeader_1x02_P254mm_Vertical_4ebc0886378d x 14
C22_C_0402_1005Metric_f571f1c140e1 x 2
ESD6_LXES03AAA1-154_dfe69a338eab x 6
J1_95157-140LF_4456029c62ad
U1_QFN_68_1EP_8x8mm_P04mm_EP52x52mm_6b566e35163e
D2_LED_0805_2012Metric_0c2047eae0be x 2
ESD7_LXES15AAA1-153_bc68062c1d92
J5_PinHeader_2x05_P254mm_Vertical_SMD_2d622eb2f881 x 2
J5_95157-110VMLF_2d622eb2f881[2] x 2
J7_PinHeader_1x18_P254mm_Vertical_41bb682d9cc5
USB1_USB3.0_TYPEA_MOLEX_484050004_f8fbffebc138
F1_Fuse_0805_2012Metric_0f6eadfa35c9
FB1_L_0603_1608Metric_99ea696fe2f9
J2_PinSocket_2x20_P254mm_Vertical_SMD_3c8c42ac6410
J6_PinSocket_2x05_P254mm_Vertical_SMD_db0ef3f0591b x 2
