kelu124/rp569/project/phantomdrive/ee/ovrdrive/out/r0.1/ovrdrive.step

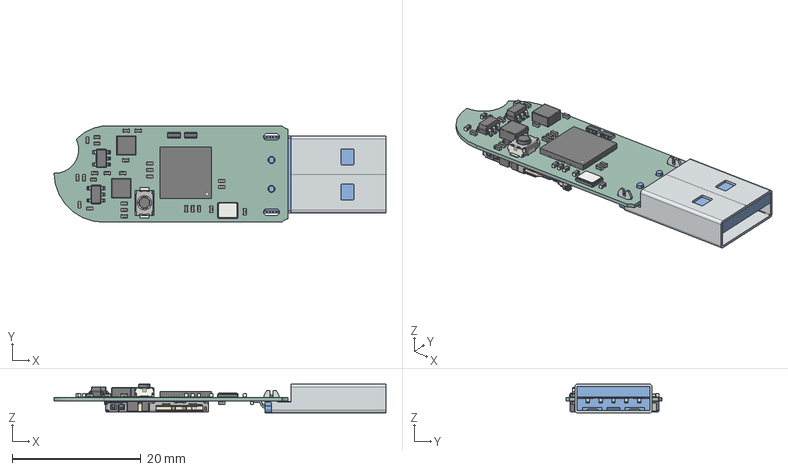
[picture p14: CAD file, 2026-10-23]
project/phantomdrive/ee/ovrdrive/out/r0.1/ovrdrive.step
51.6 x 15.0 x 4.50 mm
C_0402_1005Metric x 33
SOT-23-5 x 2
R_Array_Concave_4x0402 x 2
L_Changjiang_FTC303015D x 2
SW_Push_SPST_NO_Alps_SKRK
Crystal_SMD_3225-4Pin_3.2x2.5mm
QFN-68-1EP_8x8mm_P0.4mm_EP5.2x5.2mm
microSD_HC_Hirose_DM3AT-SF-PEJM5
692112030100_Housing
692112030100_Shielding
692112030100_Pin2
692112030100_Pin3 x 2
692112030100_Pin1 x 5
692112030100_Housing2
692112030100_Pin5
ovrdrive_PCB
