kelu124/rp569/docs/images/rp569-v1.0-assembly-bottom.png

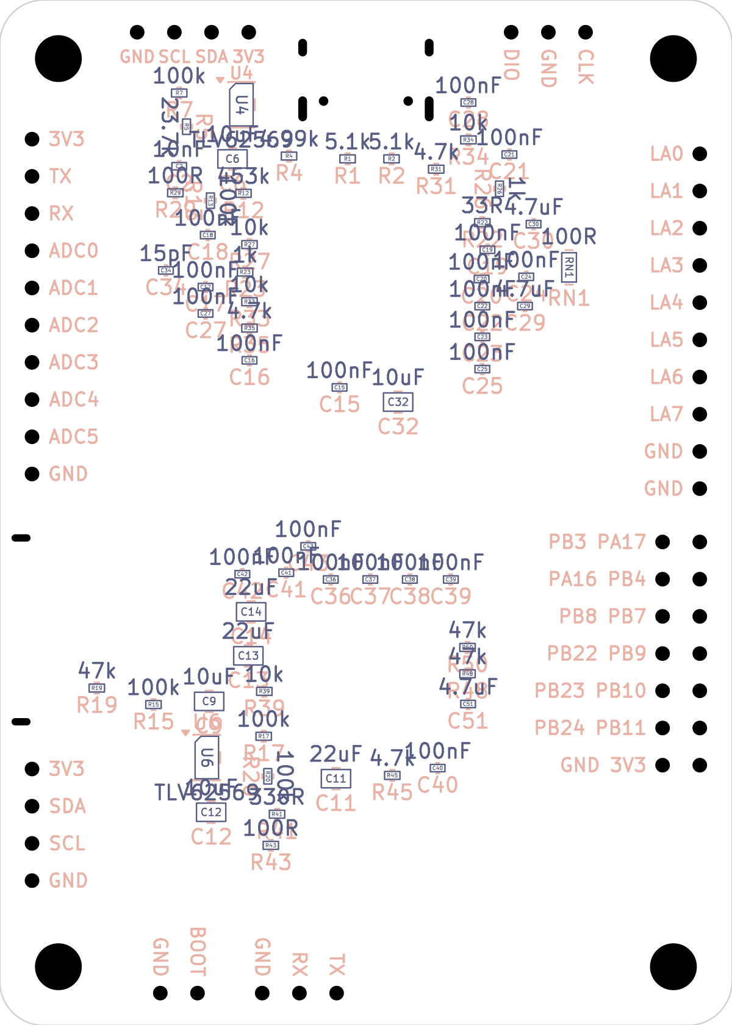
docs/images/rp569-v1.0-assembly-bottom.png
