kelu124/rp569/hardware/rp569-schematic.pdf

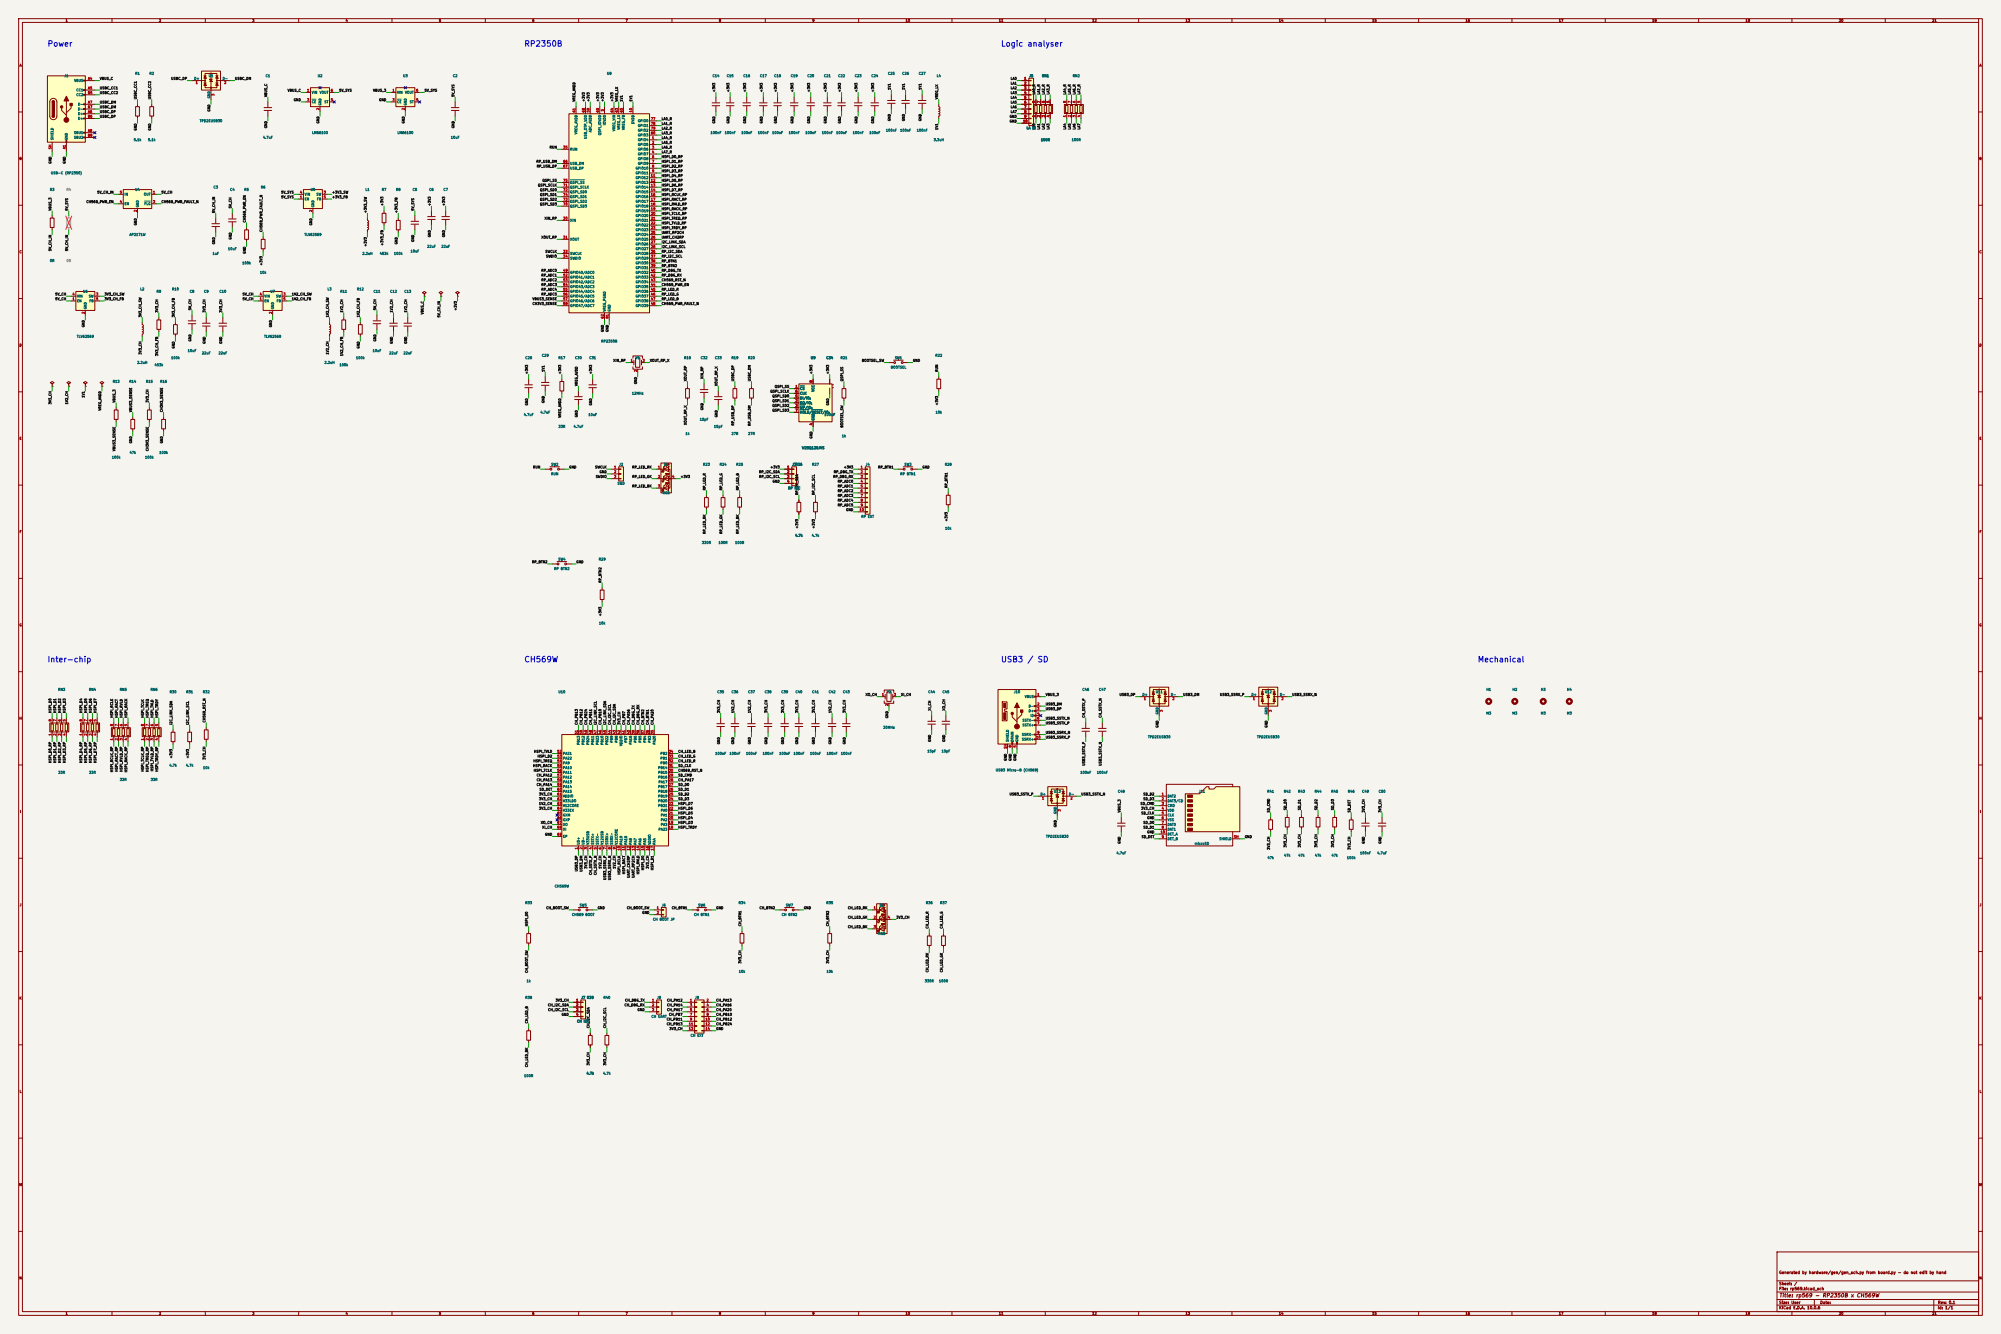
[picture p17: page 1]

Generated by hardware/gen/gen_sch.py from board.py - do not edit by hand

Size: User | Rev: 0.1
KiCad E.D.A. 10.0.6 | Id: 1/1
