kelu124/rp569/hardware/rp569.kicad_pcb

## KiCad design hardware/rp569.kicad_pcb (2026-10-24)

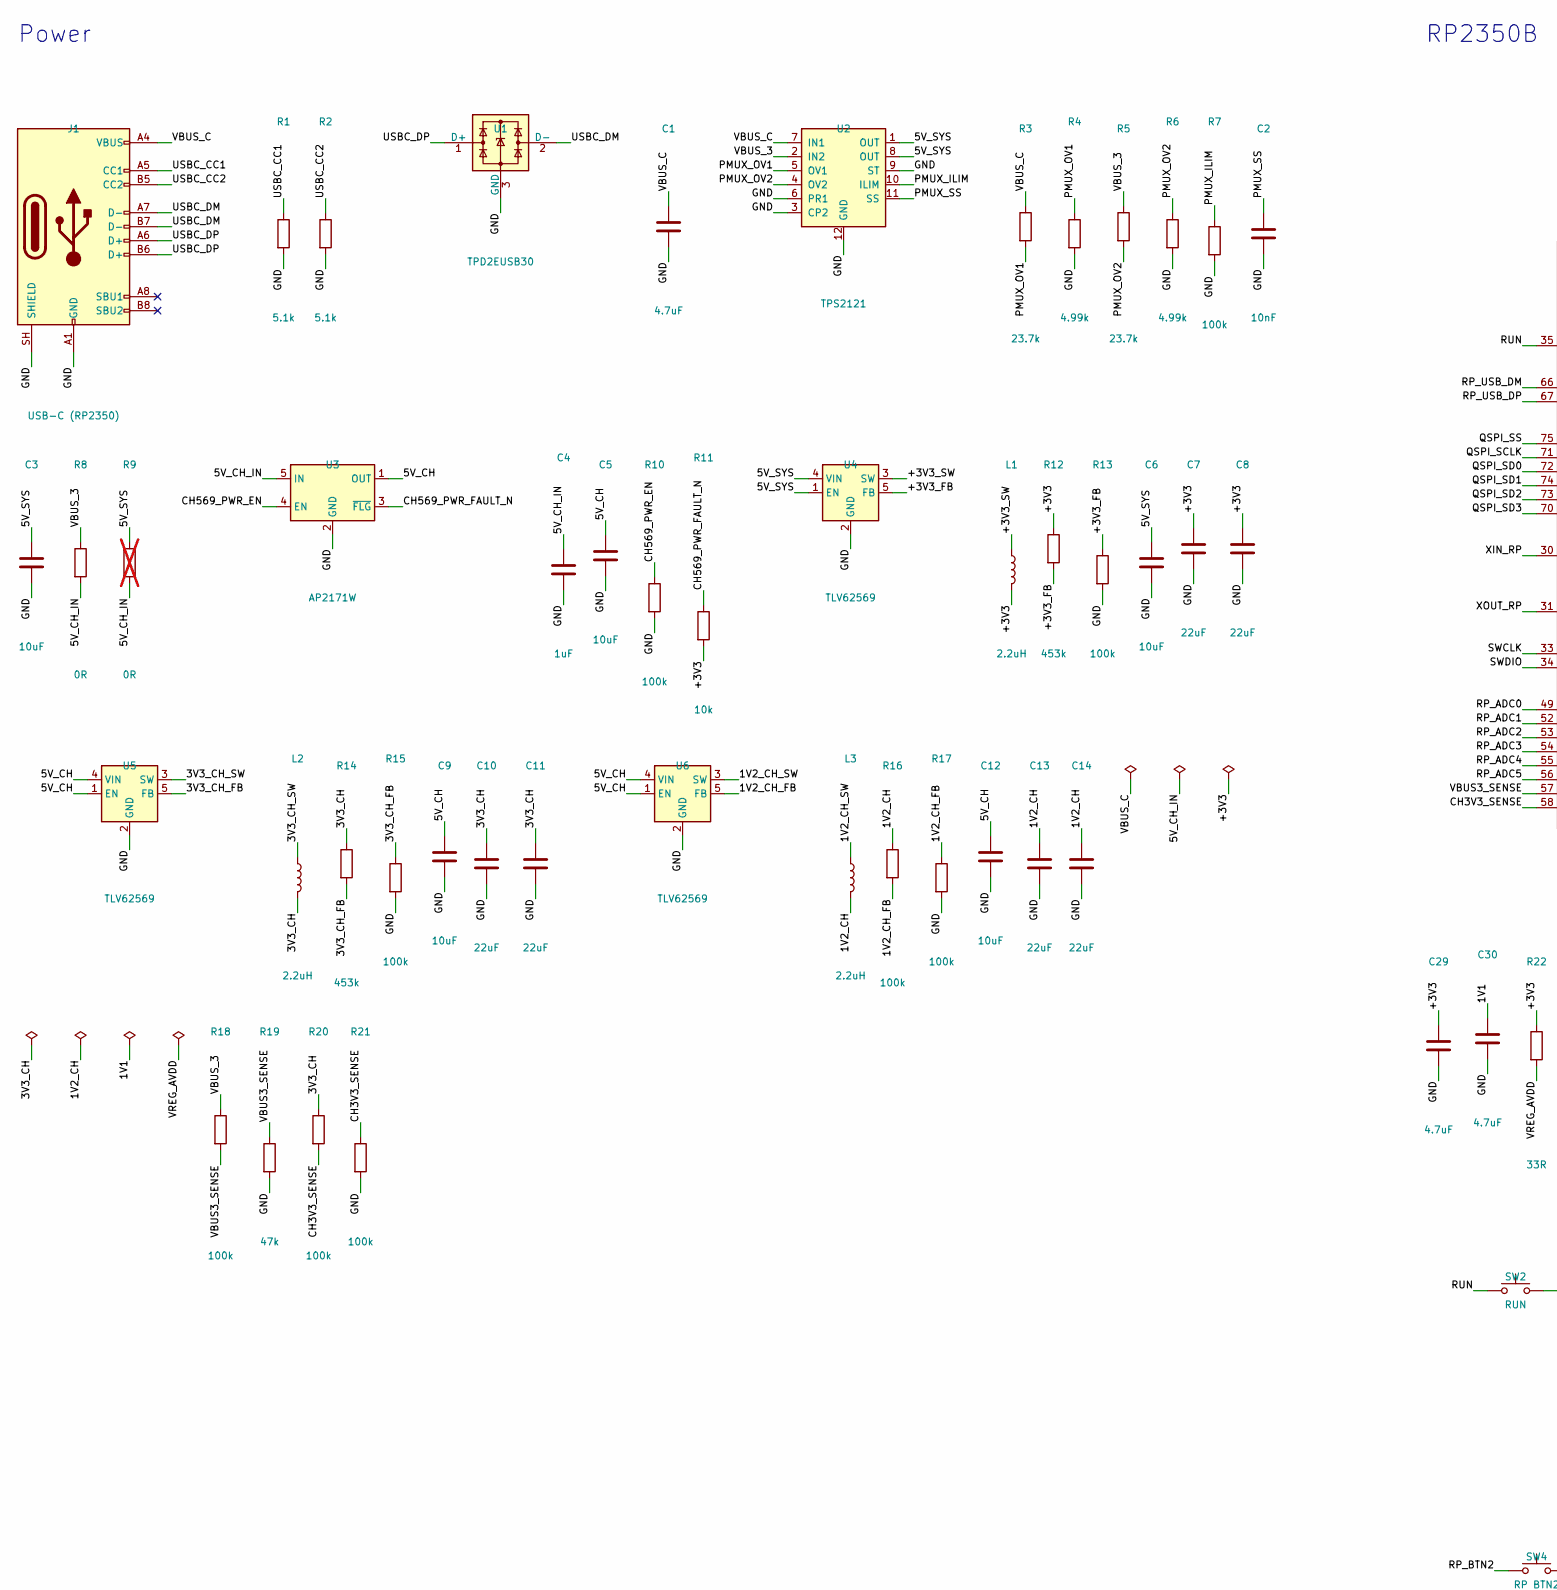
[picture p18: schematic rp569.kicad_sch, rp569 - RP2350B x CH569W, part in row 1, column 1]

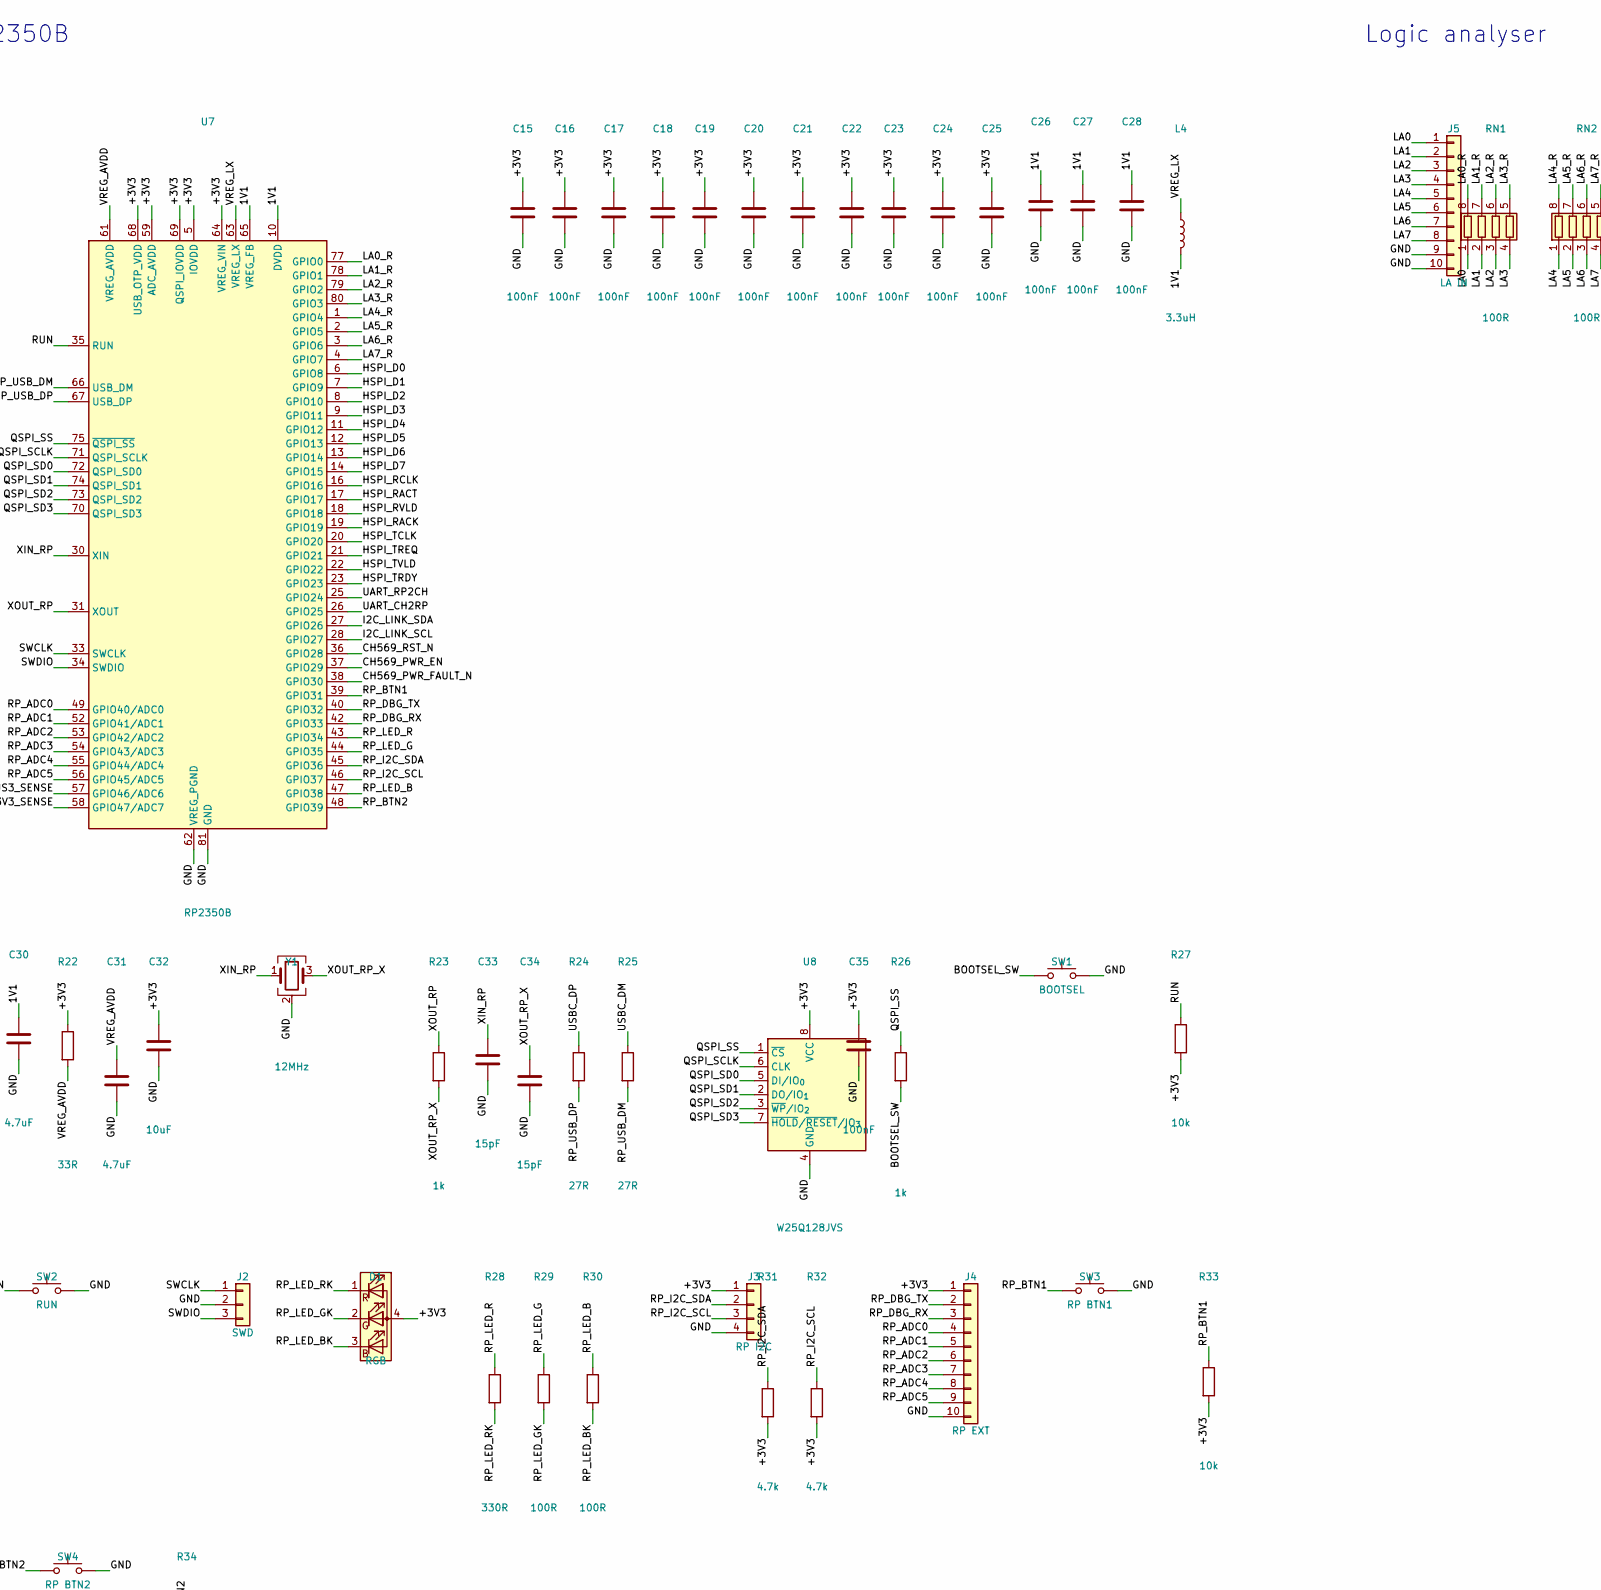
[picture p19: schematic rp569.kicad_sch, rp569 - RP2350B x CH569W, part in row 1, column 2]

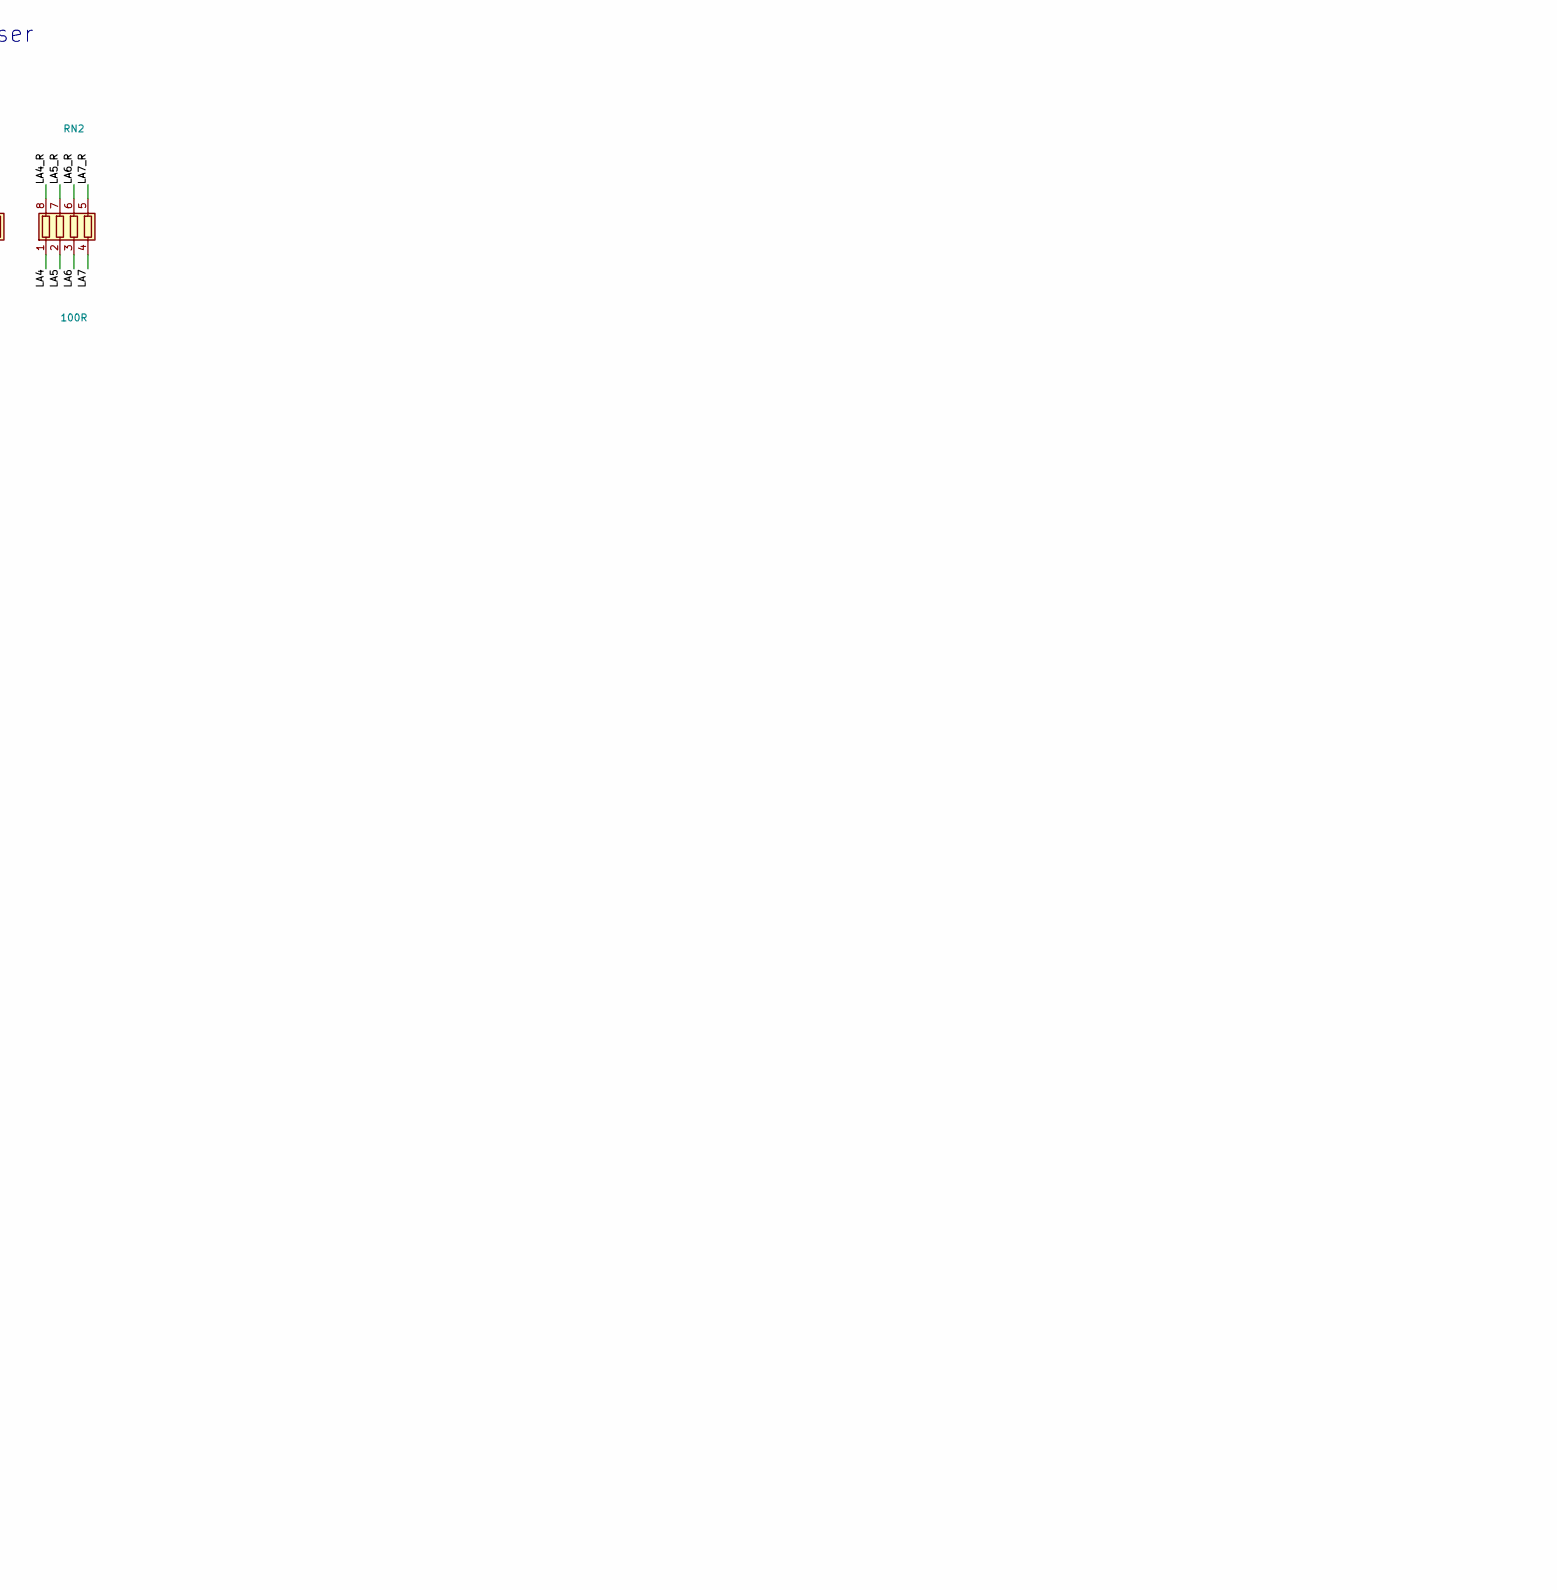
[picture p20: schematic rp569.kicad_sch, rp569 - RP2350B x CH569W, part in row 1, column 3]

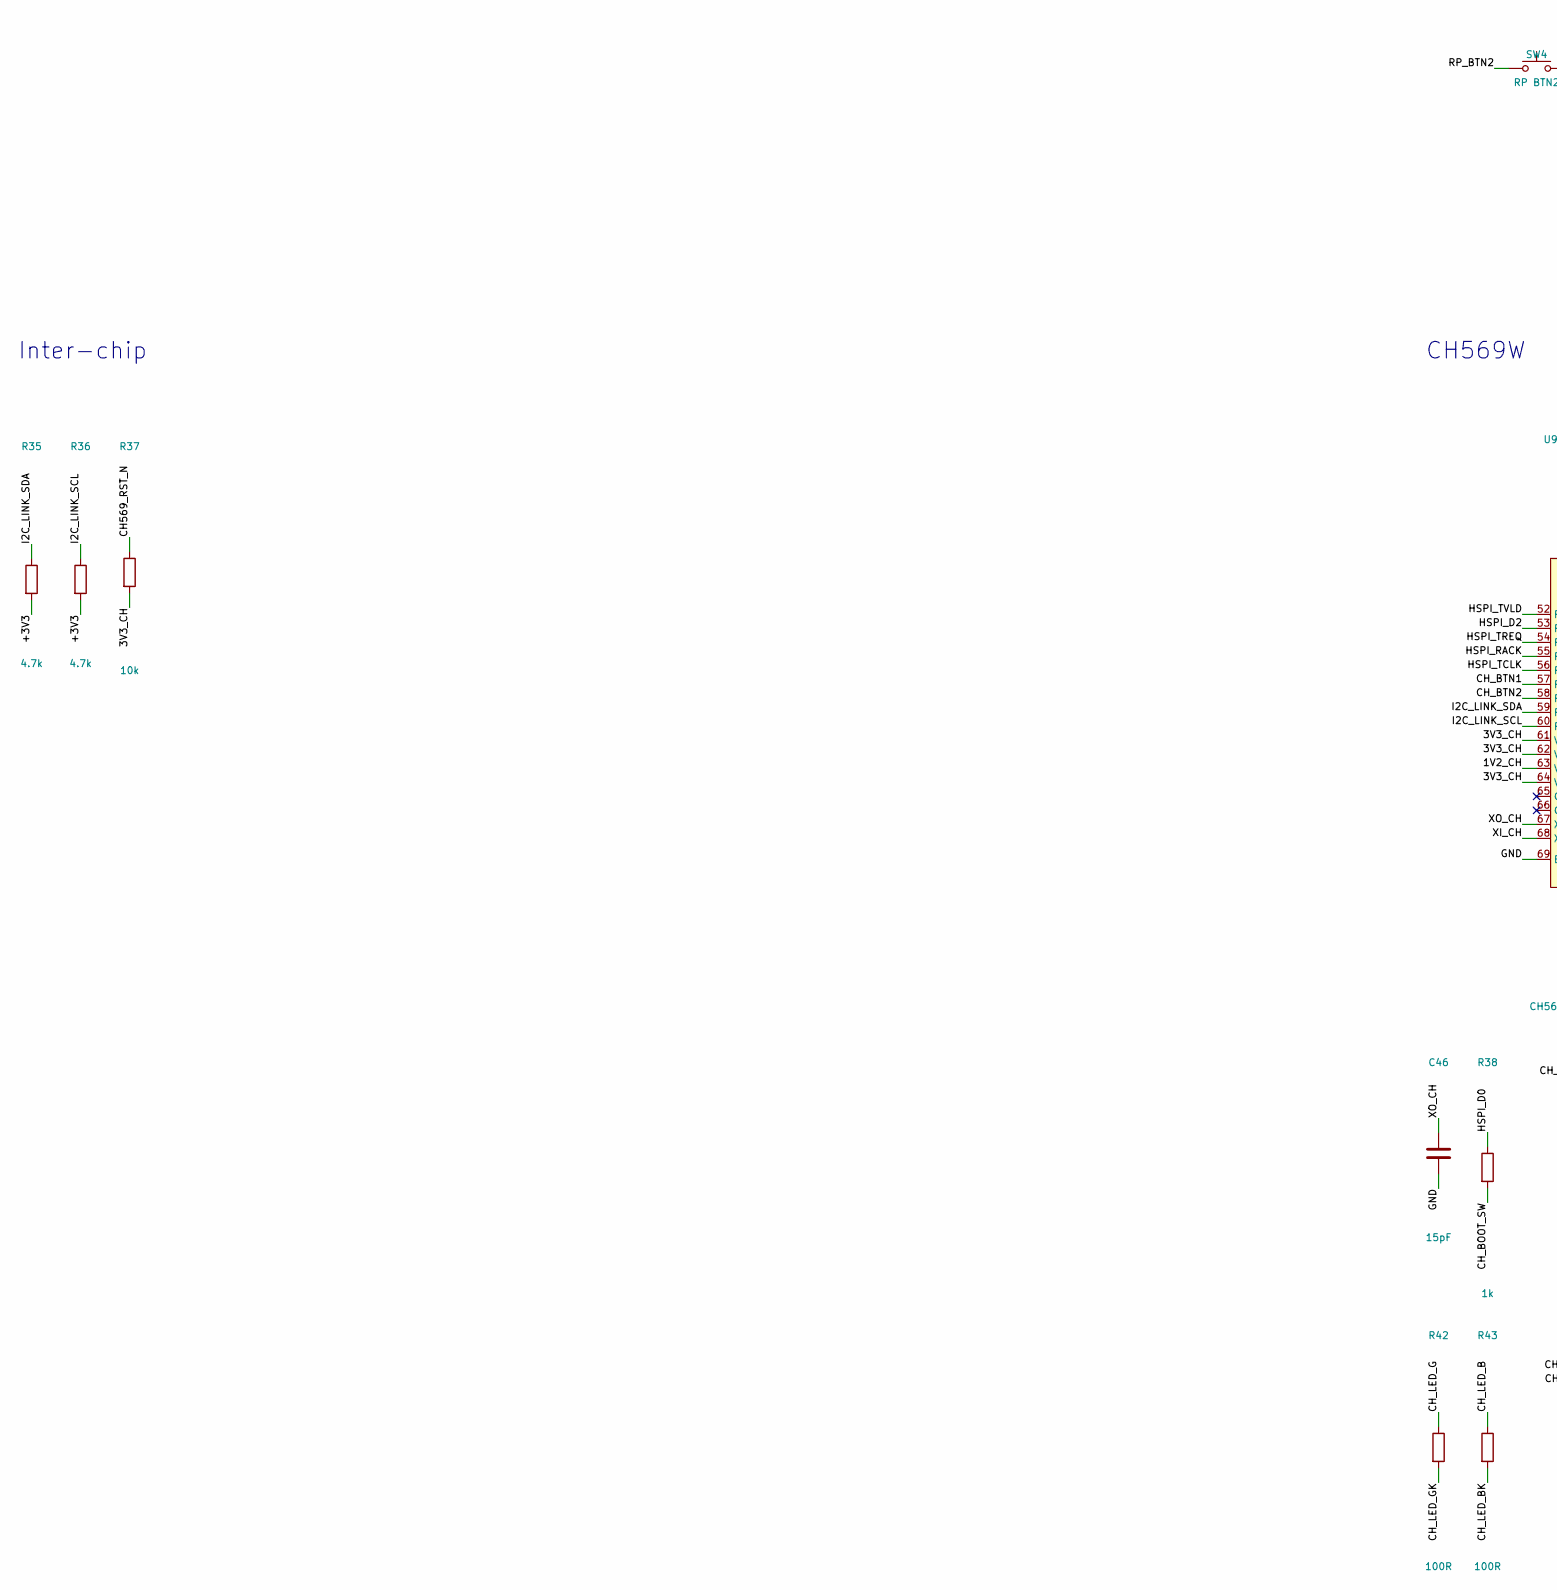
[picture p21: schematic rp569.kicad_sch, rp569 - RP2350B x CH569W, part in row 2, column 1]

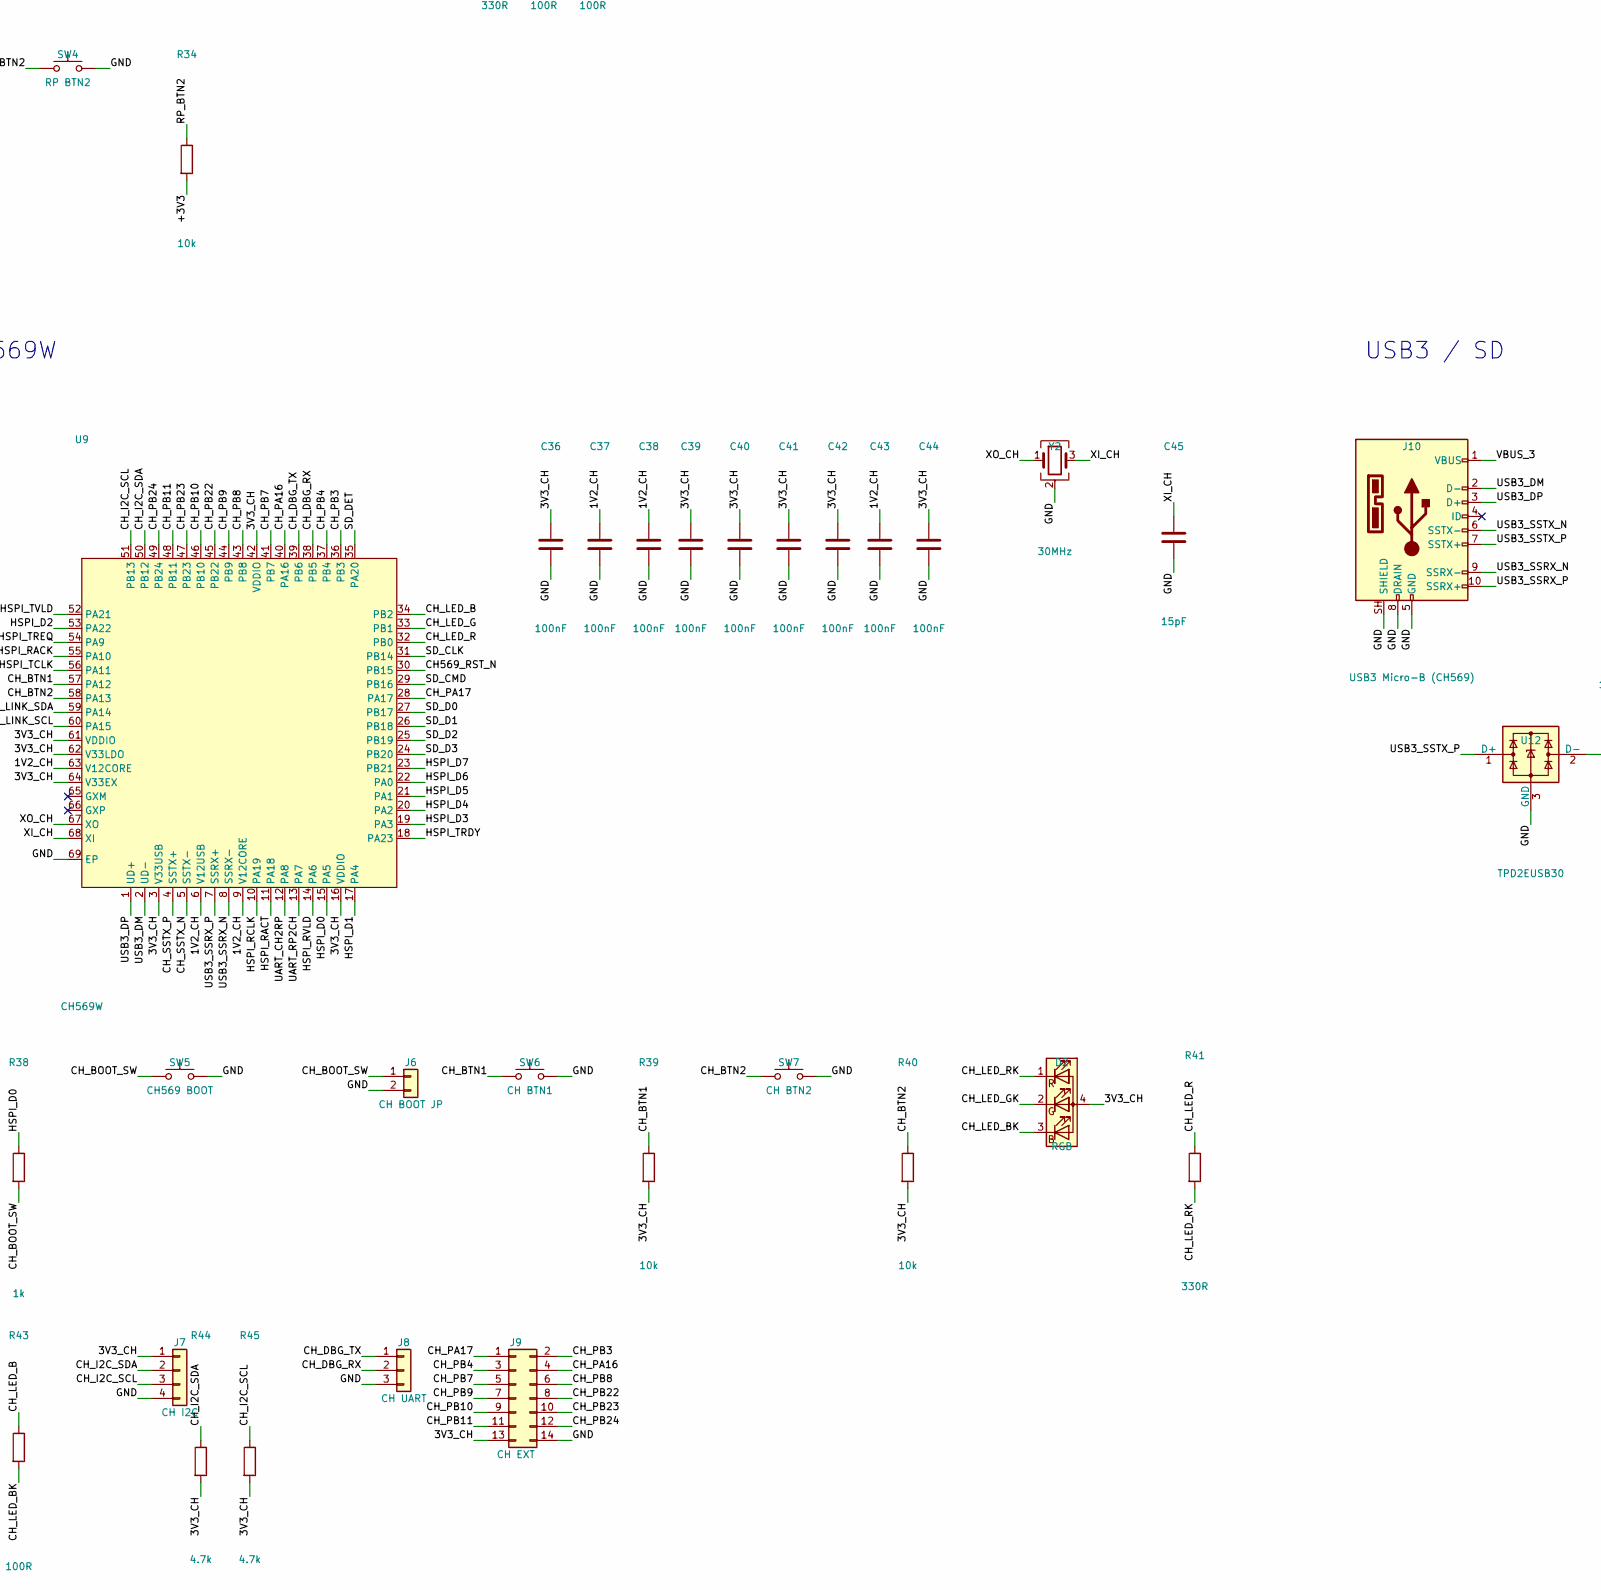
[picture p22: schematic rp569.kicad_sch, rp569 - RP2350B x CH569W, part in row 2, column 2]

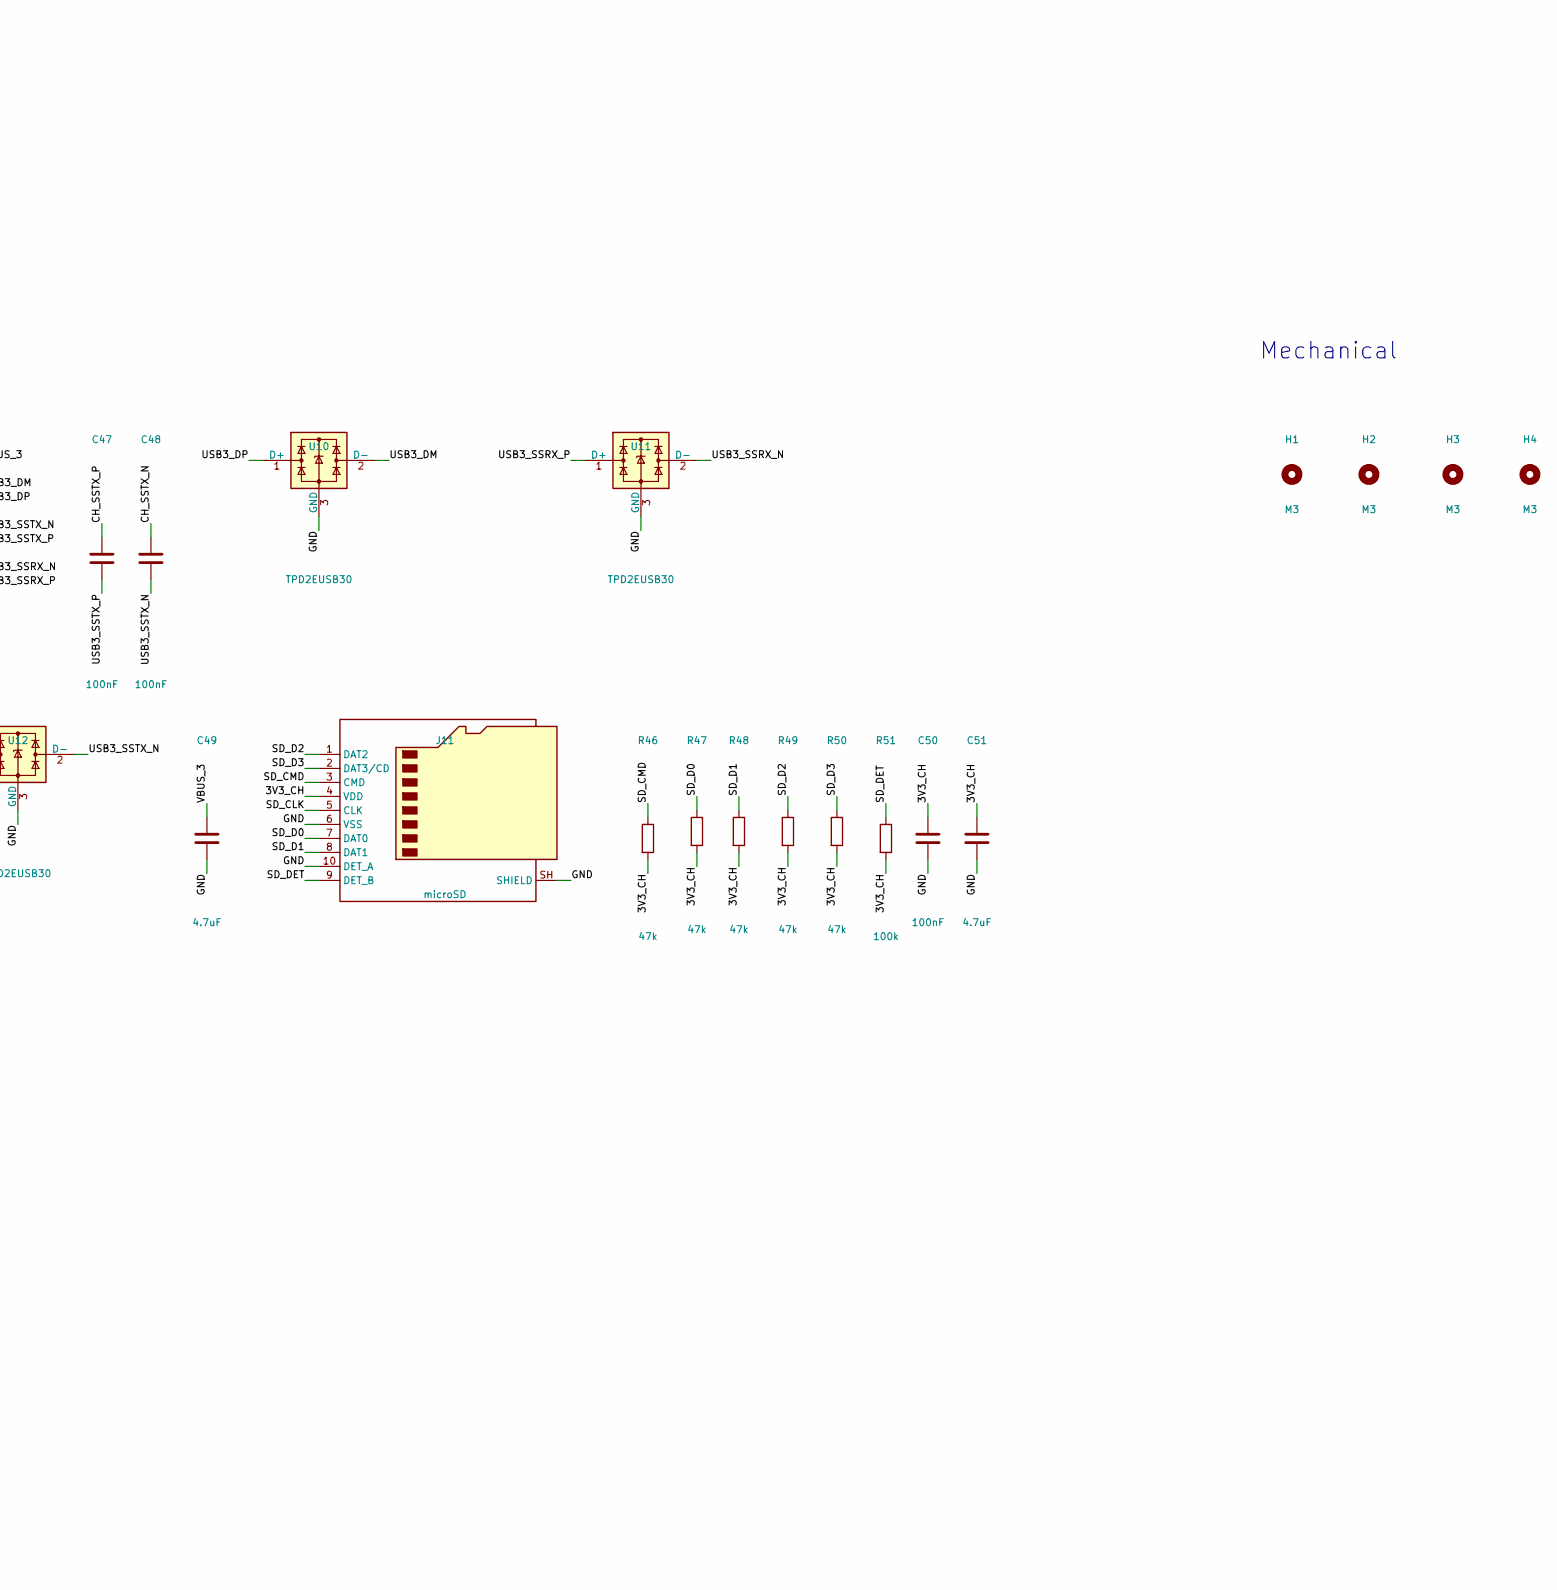
[picture p23: schematic rp569.kicad_sch, rp569 - RP2350B x CH569W, part in row 2, column 3]

Parts:
C1, C29, C30, C31, C49, C51: 4.7uF; C_0402_1005Metric; MPN CL05A475MP5NRNC; LCSC C23733
C2: 10nF; C_0402_1005Metric; MPN CL05B103KB5NNNC; LCSC C15195
C3, C5, C6, C9, C12, C32: 10uF; C_0805_2012Metric; MPN CL21A106KAYNNNE; LCSC C15850
C4: 1uF; C_0402_1005Metric; MPN CL05A105KA5NQNC; LCSC C52923
C7, C8, C10, C11, C13, C14: 22uF; C_0805_2012Metric; MPN CL21A226MAQNNNE; LCSC C45783
C15, C16, C17, C18, C19, C20, C21, C22, C23, C24, C25, C26, C27, C28, C35, C36, C37, C38, C39, C40, C41, C42, C43, C44, C47, C48, C50: 100nF; C_0402_1005Metric; MPN CL05B104KO5NNNC; LCSC C1525
C33, C34, C45, C46: 15pF; C_0402_1005Metric; MPN 0402CG150J500NT; LCSC C1548
D1, D2: RGB; LED_LiteOn_LTST-C19HE1WT; MPN LTST-C19HE1WT; LCSC C458749
H1, H2, H3, H4: M3; MountingHole_3.2mm_M3
J1: USB-C (RP2350); USB_C_Receptacle_HRO_TYPE-C-31-M-12; MPN TYPE-C-31-M-12; LCSC C165948
J2: SWD; PinHeader_1x03_P2.54mm_Vertical; MPN 2.54-1*3P; LCSC C49257
J3: RP I2C; PinHeader_1x04_P2.54mm_Vertical; MPN PZ254V-11-04P; LCSC C492403
J4: RP EXT; PinHeader_1x10_P2.54mm_Vertical; MPN PZ254V-11-10P; LCSC C492409
J5: LA IN; PinHeader_1x10_P2.54mm_Vertical; MPN PZ254V-11-10P; LCSC C492409
J6: CH BOOT JP; PinHeader_1x02_P2.54mm_Vertical; MPN PZ254V-11-02P; LCSC C492401
J7: CH I2C; PinHeader_1x04_P2.54mm_Vertical; MPN PZ254V-11-04P; LCSC C492403
J8: CH UART; PinHeader_1x03_P2.54mm_Vertical; MPN 2.54-1*3P; LCSC C49257
J9: CH EXT; PinHeader_2x07_P2.54mm_Vertical; MPN PZ254V-12-14P; LCSC C492424
J10: USB3 Micro-B (CH569); USB3_Micro-B_Amphenol_GSB343K33HR; MPN GSB343K33HR
J11: microSD; microSD_HC_Hirose_DM3AT-SF-PEJM5; MPN DM3AT-SF-PEJM5; LCSC C114218
L1, L2, L3: 2.2uH; L_Changjiang_FTC303015D; MPN FTC303020D2R2MBCA; LCSC C7423318
L4: 3.3uH; L_Cenker_CKCS201610; MPN AOTA-B201610S3R3-101-T; LCSC C42411119
R1, R2: 5.1k; R_0402_1005Metric; MPN 0402WGF5101TCE; LCSC C25905
R3, R5: 23.7k; R_0402_1005Metric; MPN AC0402FR-0723K7L; LCSC C226363
R4, R6: 4.99k; R_0402_1005Metric; MPN 0402WGF4991TCE; LCSC C25903
R7, R10, R13, R15, R16, R17, R18, R20, R21, R51: 100k; R_0402_1005Metric; MPN 0402WGF1003TCE; LCSC C25741
R8: 0R; R_0402_1005Metric; MPN 0402WGF0000TCE; LCSC C17168
R9: 0R; R_0402_1005Metric; MPN 0402WGF0000TCE; LCSC C17168; not fitted
R11, R27, R33, R34, R37, R39, R40: 10k; R_0402_1005Metric; MPN 0402WGF1002TCE; LCSC C25744
R12, R14: 453k; R_0402_1005Metric; MPN 0402WGF4533TCE; LCSC C27009
R19, R46, R47, R48, R49, R50: 47k; R_0402_1005Metric; MPN 0402WGF4702TCE; LCSC C25792
R22: 33R; R_0402_1005Metric; MPN 0402WGF330JTCE; LCSC C25105
R23, R26, R38: 1k; R_0402_1005Metric; MPN 0402WGF1001TCE; LCSC C11702
R24, R25: 27R; R_0402_1005Metric; MPN RC0402FR-0727RL; LCSC C138021
R28, R41: 330R; R_0402_1005Metric; MPN 0402WGF3300TCE; LCSC C25104
R29, R30, R42, R43: 100R; R_0402_1005Metric; MPN 0402WGF1000TCE; LCSC C25076
R31, R32, R35, R36, R44, R45: 4.7k; R_0402_1005Metric; MPN 0402WGF4701TCE; LCSC C25900
RN1, RN2: 100R; R_Array_Convex_4x0402; MPN 4D02WGJ0101TCE; LCSC C48442
SW1: BOOTSEL; SW_SPST_PTS810; MPN PTS810SJG250SMTRLFS; LCSC C221895
SW2: RUN; SW_SPST_PTS810; MPN PTS810SJG250SMTRLFS; LCSC C221895
SW3: RP BTN1; SW_SPST_PTS810; MPN PTS810SJG250SMTRLFS; LCSC C221895
SW4: RP BTN2; SW_SPST_PTS810; MPN PTS810SJG250SMTRLFS; LCSC C221895
SW5: CH569 BOOT; SW_SPST_PTS810; MPN PTS810SJG250SMTRLFS; LCSC C221895
SW6: CH BTN1; SW_SPST_PTS810; MPN PTS810SJG250SMTRLFS; LCSC C221895
SW7: CH BTN2; SW_SPST_PTS810; MPN PTS810SJG250SMTRLFS; LCSC C221895
U1, U10, U11, U12: TPD2EUSB30; Texas_DRT-3; MPN TPD2EUSB30DRTR; LCSC C97502
U2: TPS2121; TI_RUX0012A_VQFN-HR-12_2x2.5mm; MPN TPS2121RUXR; LCSC C485916
U3: AP2171W; SOT-23-5; MPN AP2171WG-7; LCSC C110466
U4, U5, U6: TLV62569; SOT-23-5; MPN TLV62569DBVR; LCSC C141836
U7: RP2350B; QFN-80-1EP_10x10mm_P0.4mm_EP3.4x3.4mm; MPN RP2350B; LCSC C42415655
U8: W25Q128JVS; SOIC-8_5.3x5.3mm_P1.27mm; MPN W25Q128JVSIQ; LCSC C97521
U9: CH569W; QFN-68-1EP_8x8mm_P0.4mm_EP5.2x5.2mm; MPN CH569W
Y1: 12MHz; Crystal_SMD_3225-4Pin_3.2x2.5mm; MPN ABM8-272-T3; LCSC C20625731
Y2: 30MHz; Crystal_SMD_3225-4Pin_3.2x2.5mm; MPN X322530MOB4SI; LCSC C70592

Connections:
/1V1: C26.1, C27.1, C28.1, C30.1, L4.2, U7.10 (DVDD), U7.32 (DVDD), U7.51 (DVDD), U7.65 (VREG_FB)
/1V2_CH: C13.1, C14.1, C37.1, C38.1, C43.1, L3.2, R16.1, U9.6 (V12USB), U9.9 (V12CORE), U9.63 (V12CORE)
/1V2_CH_FB: R16.2, R17.1, U6.5 (FB)
/1V2_CH_SW: L3.1, U6.3 (SW)
/3V3_CH: C10.1, C11.1, C36.1, C39.1, C40.1, C41.1, C42.1, C44.1, C50.1, C51.1, D2.4 (A), J7.1, J9.13, J11.4 (VDD), L2.2, R14.1, R20.1, R37.2, R39.2, R40.2, R44.2, R45.2, R46.2, R47.2, R48.2, R49.2, R50.2, R51.2, U9.3 (V33USB), U9.16 (VDDIO), U9.42 (VDDIO), U9.61 (VDDIO), U9.62 (V33LDO), U9.64 (V33EX)
/3V3_CH_FB: R14.2, R15.1, U5.5 (FB)
/3V3_CH_SW: L2.1, U5.3 (SW)
/5V_CH: C5.1, C9.1, C12.1, U3.1 (OUT), U5.1 (EN), U5.4 (VIN), U6.1 (EN), U6.4 (VIN)
/5V_CH_IN: C4.1, R8.2, R9.2, U3.5 (IN)
/5V_SYS: C3.1, C6.1, R9.1, U2.1 (OUT), U2.8 (OUT), U4.1 (EN), U4.4 (VIN)
/+3V3: C7.1, C8.1, C15.1, C16.1, C17.1, C18.1, C19.1, C20.1, C21.1, C22.1, C23.1, C24.1, C25.1, C29.1, C32.1, C35.1, D1.4 (A), J3.1, J4.1, L1.2, R11.2, R12.1, R22.1, R27.2, R31.2, R32.2, R33.2, R34.2, R35.2, R36.2, U7.5 (IOVDD), U7.15 (IOVDD), U7.24 (IOVDD), U7.29 (IOVDD), U7.41 (IOVDD), U7.50 (IOVDD), U7.59 (ADC_AVDD), U7.60 (IOVDD), U7.64 (VREG_VIN), U7.68 (USB_OTP_VDD), U7.69 (QSPI_IOVDD), U7.76 (IOVDD), U8.8 (VCC)
/+3V3_FB: R12.2, R13.1, U4.5 (FB)
/+3V3_SW: L1.1, U4.3 (SW)
/BOOTSEL_SW: R26.2, SW1.1
/CH3V3_SENSE: R20.2, R21.1, U7.58 (GPIO47/ADC7)
/CH569_PWR_EN: R10.1, U3.4 (EN), U7.37 (GPIO29)
/CH569_PWR_FAULT_N: R11.1, U3.3 (~FLG), U7.38 (GPIO30)
/CH569_RST_N: R37.1, U7.36 (GPIO28), U9.30 (PB15)
/CH_BOOT_SW: J6.1, R38.2, SW5.1
/CH_BTN1: R39.1, SW6.1, U9.57 (PA12)
/CH_BTN2: R40.1, SW7.1, U9.58 (PA13)
/CH_DBG_RX: J8.2, U9.38 (PB5)
/CH_DBG_TX: J8.1, U9.39 (PB6)
/CH_I2C_SCL: J7.3, R45.1, U9.51 (PB13)
/CH_I2C_SDA: J7.2, R44.1, U9.50 (PB12)
/CH_LED_B: R43.1, U9.34 (PB2)
/CH_LED_BK: D2.3 (BK), R43.2
/CH_LED_G: R42.1, U9.33 (PB1)
/CH_LED_GK: D2.2 (GK), R42.2
/CH_LED_R: R41.1, U9.32 (PB0)
/CH_LED_RK: D2.1 (RK), R41.2
/CH_PA16: J9.4, U9.40 (PA16)
/CH_PA17: J9.1, U9.28 (PA17)
/CH_PB3: J9.2, U9.36 (PB3)
/CH_PB4: J9.3, U9.37 (PB4)
/CH_PB7: J9.5, U9.41 (PB7)
/CH_PB8: J9.6, U9.43 (PB8)
/CH_PB9: J9.7, U9.44 (PB9)
/CH_PB10: J9.9, U9.46 (PB10)
/CH_PB11: J9.11, U9.48 (PB11)
/CH_PB22: J9.8, U9.45 (PB22)
/CH_PB23: J9.10, U9.47 (PB23)
/CH_PB24: J9.12, U9.49 (PB24)
/CH_SSTX_N: C48.1, U9.5 (SSTX-)
/CH_SSTX_P: C47.1, U9.4 (SSTX+)
/GND: C1.2, C2.2, C3.2, C4.2, C5.2, C6.2, C7.2, C8.2, C9.2, C10.2, C11.2, C12.2, C13.2, C14.2, C15.2, C16.2, C17.2, C18.2, C19.2, C20.2, C21.2, C22.2, C23.2, C24.2, C25.2, C26.2, C27.2, C28.2, C29.2, C30.2, C31.2, C32.2, C33.2, C34.2, C35.2, C36.2, C37.2, C38.2, C39.2, C40.2, C41.2, C42.2, C43.2, C44.2, C45.2, C46.2, C49.2, C50.2, C51.2, J1.A1 (GND), J1.A12 (GND), J1.B1 (GND), J1.B12 (GND), J1.SH (SHIELD), J2.2, J3.4, J4.10, J5.9, J5.10, J6.2, J7.4, J8.3, J9.14, J10.5 (GND), J10.8 (DRAIN), J10.SH (SHIELD), J11.6 (VSS), J11.10 (DET_A), J11.SH (SHIELD), R1.2, R2.2, R4.2, R6.2, R7.2, R10.2, R13.2, R15.2, R17.2, R19.2, R21.2, SW1.2, SW2.2, SW3.2, SW4.2, SW5.2, SW6.2, SW7.2, U1.3 (GND), U2.3 (CP2), U2.6 (PR1), U2.9 (ST), U2.12 (GND), U3.2 (GND), U4.2 (GND), U5.2 (GND), U6.2 (GND), U7.62 (VREG_PGND), U7.81 (GND), U8.4 (GND), U9.69 (EP), U10.3 (GND), U11.3 (GND), U12.3 (GND), Y1.2 (G), Y1.4 (G), Y2.2 (G), Y2.4 (G)
/HSPI_D0: R38.1, U7.6 (GPIO8), U9.15 (PA5)
/HSPI_D1: U7.7 (GPIO9), U9.17 (PA4)
/HSPI_D2: U7.8 (GPIO10), U9.53 (PA22)
/HSPI_D3: U7.9 (GPIO11), U9.19 (PA3)
/HSPI_D4: U7.11 (GPIO12), U9.20 (PA2)
/HSPI_D5: U7.12 (GPIO13), U9.21 (PA1)
/HSPI_D6: U7.13 (GPIO14), U9.22 (PA0)
/HSPI_D7: U7.14 (GPIO15), U9.23 (PB21)
/HSPI_RACK: U7.19 (GPIO19), U9.55 (PA10)
/HSPI_RACT: U7.17 (GPIO17), U9.11 (PA18)
/HSPI_RCLK: U7.16 (GPIO16), U9.10 (PA19)
/HSPI_RVLD: U7.18 (GPIO18), U9.14 (PA6)
/HSPI_TCLK: U7.20 (GPIO20), U9.56 (PA11)
/HSPI_TRDY: U7.23 (GPIO23), U9.18 (PA23)
/HSPI_TREQ: U7.21 (GPIO21), U9.54 (PA9)
/HSPI_TVLD: U7.22 (GPIO22), U9.52 (PA21)
/I2C_LINK_SCL: R36.1, U7.28 (GPIO27), U9.60 (PA15)
/I2C_LINK_SDA: R35.1, U7.27 (GPIO26), U9.59 (PA14)
/LA0: J5.1, RN1.1 (R1.1)
/LA0_R: RN1.8 (R1.2), U7.77 (GPIO0)
/LA1: J5.2, RN1.2 (R2.1)
/LA1_R: RN1.7 (R2.2), U7.78 (GPIO1)
/LA2: J5.3, RN1.3 (R3.1)
/LA2_R: RN1.6 (R3.2), U7.79 (GPIO2)
/LA3: J5.4, RN1.4 (R4.1)
/LA3_R: RN1.5 (R4.2), U7.80 (GPIO3)
/LA4: J5.5, RN2.1 (R1.1)
/LA4_R: RN2.8 (R1.2), U7.1 (GPIO4)
/LA5: J5.6, RN2.2 (R2.1)
/LA5_R: RN2.7 (R2.2), U7.2 (GPIO5)
/LA6: J5.7, RN2.3 (R3.1)
/LA6_R: RN2.6 (R3.2), U7.3 (GPIO6)
/LA7: J5.8, RN2.4 (R4.1)
/LA7_R: RN2.5 (R4.2), U7.4 (GPIO7)
/PMUX_ILIM: R7.1, U2.10 (ILIM)
/PMUX_OV1: R3.2, R4.1, U2.5 (OV1)
/PMUX_OV2: R5.2, R6.1, U2.4 (OV2)
/PMUX_SS: C2.1, U2.11 (SS)
/QSPI_SCLK: U7.71 (QSPI_SCLK), U8.6 (CLK)
/QSPI_SD0: U7.72 (QSPI_SD0), U8.5 (DI/IO_{0})
/QSPI_SD1: U7.74 (QSPI_SD1), U8.2 (DO/IO_{1})
/QSPI_SD2: U7.73 (QSPI_SD2), U8.3 (~WP/IO_{2})
/QSPI_SD3: U7.70 (QSPI_SD3), U8.7 (~HOLD/~RESET/IO_{3})
/QSPI_SS: R26.1, U7.75 (~QSPI_SS), U8.1 (~CS)
/RP_ADC0: J4.4, U7.49 (GPIO40/ADC0)
/RP_ADC1: J4.5, U7.52 (GPIO41/ADC1)
/RP_ADC2: J4.6, U7.53 (GPIO42/ADC2)
/RP_ADC3: J4.7, U7.54 (GPIO43/ADC3)
/RP_ADC4: J4.8, U7.55 (GPIO44/ADC4)
/RP_ADC5: J4.9, U7.56 (GPIO45/ADC5)
/RP_BTN1: R33.1, SW3.1, U7.39 (GPIO31)
/RP_BTN2: R34.1, SW4.1, U7.48 (GPIO39)
/RP_DBG_RX: J4.3, U7.42 (GPIO33)
/RP_DBG_TX: J4.2, U7.40 (GPIO32)
/RP_I2C_SCL: J3.3, R32.1, U7.46 (GPIO37)
/RP_I2C_SDA: J3.2, R31.1, U7.45 (GPIO36)
/RP_LED_B: R30.1, U7.47 (GPIO38)
/RP_LED_BK: D1.3 (BK), R30.2
/RP_LED_G: R29.1, U7.44 (GPIO35)
/RP_LED_GK: D1.2 (GK), R29.2
/RP_LED_R: R28.1, U7.43 (GPIO34)
/RP_LED_RK: D1.1 (RK), R28.2
/RP_USB_DM: R25.2, U7.66 (USB_DM)
/RP_USB_DP: R24.2, U7.67 (USB_DP)
/RUN: R27.1, SW2.1, U7.35 (RUN)
/SD_CLK: J11.5 (CLK), U9.31 (PB14)
/SD_CMD: J11.3 (CMD), R46.1, U9.29 (PB16)
/SD_D0: J11.7 (DAT0), R47.1, U9.27 (PB17)
/SD_D1: J11.8 (DAT1), R48.1, U9.26 (PB18)
/SD_D2: J11.1 (DAT2), R49.1, U9.25 (PB19)
/SD_D3: J11.2 (DAT3/CD), R50.1, U9.24 (PB20)
/SD_DET: J11.9 (DET_B), R51.1, U9.35 (PA20)
/SWCLK: J2.1, U7.33 (SWCLK)
/SWDIO: J2.3, U7.34 (SWDIO)
/UART_CH2RP: U7.26 (GPIO25), U9.12 (PA8)
/UART_RP2CH: U7.25 (GPIO24), U9.13 (PA7)
/USB3_DM: J10.2 (D-), U9.2 (UD-), U10.2 (D-)
/USB3_DP: J10.3 (D+), U9.1 (UD+), U10.1 (D+)
/USB3_SSRX_N: J10.9 (SSRX-), U9.8 (SSRX-), U11.2 (D-)
/USB3_SSRX_P: J10.10 (SSRX+), U9.7 (SSRX+), U11.1 (D+)
/USB3_SSTX_N: C48.2, J10.6 (SSTX-), U12.2 (D-)
/USB3_SSTX_P: C47.2, J10.7 (SSTX+), U12.1 (D+)
/USBC_CC1: J1.A5 (CC1), R1.1
/USBC_CC2: J1.B5 (CC2), R2.1
/USBC_DM: J1.A7 (D-), J1.B7 (D-), R25.1, U1.2 (D-)
/USBC_DP: J1.A6 (D+), J1.B6 (D+), R24.1, U1.1 (D+)
/VBUS3_SENSE: R18.2, R19.1, U7.57 (GPIO46/ADC6)
/VBUS_3: C49.1, J10.1 (VBUS), R5.1, R8.1, R18.1, U2.2 (IN2)
/VBUS_C: C1.1, J1.A4 (VBUS), J1.A9 (VBUS), J1.B4 (VBUS), J1.B9 (VBUS), R3.1, U2.7 (IN1)
/VREG_AVDD: C31.1, R22.2, U7.61 (VREG_AVDD)
/VREG_LX: L4.1, U7.63 (VREG_LX)
/XIN_RP: C33.1, U7.30 (XIN), Y1.1
/XI_CH: C45.1, U9.68 (XI), Y2.3
/XOUT_RP: R23.1, U7.31 (XOUT)
/XOUT_RP_X: C34.1, R23.2, Y1.3
/XO_CH: C46.1, U9.67 (XO), Y2.1

Notes on the sheet:
Power
RP2350B
Logic analyser
Inter-chip
CH569W
USB3 / SD
Mechanical

Board: 4 copper layers, 146 parts (62 on the bottom side), 142 nets, no tracks yet.
