kelu124/rp569/python/rp569/_version.py

# rp569 host library version (semantic: major.minor.patch).
# major / minor: changed by the user only. patch: bumped by the pre-commit hook (.githooks/pre-commit)
# on every commit that changes python/.
__version__ = "0.1.0"
