kelu124/rp569/hardware/gen/gen_pro.py

"""Write hardware/rp569.kicad_pro with net classes for JLCPCB JLC04161H-7628 (see docs/layout.md, D-016)."""
import json
import os

HW = os.path.dirname(os.path.dirname(os.path.abspath(__file__)))


def nc(name, track, clearance=0.15, dp_width=None, dp_gap=None, prio=0):
    d = {'name': name, 'track_width': track, 'clearance': clearance, 'via_diameter': 0.5, 'via_drill': 0.3,
         'microvia_diameter': 0.3, 'microvia_drill': 0.1, 'bus_width': 12, 'wire_width': 6, 'line_style': 0,
         'pcb_color': 'rgba(0, 0, 0, 0.000)', 'schematic_color': 'rgba(0, 0, 0, 0.000)', 'priority': prio,
         'tuning_profile': ''}
    if dp_width:
        d.update(diff_pair_width=dp_width, diff_pair_gap=dp_gap, diff_pair_via_gap=0.25)
    return d


classes = [
    nc('Default', 0.15, clearance=0.1, prio=2147483647),
    # 90 ohm differential on F.Cu over In1 GND, JLC04161H-7628 (prepreg 0.2104 mm, er 4.4): IPC-2141A estimate
    # 0.24/0.13 mm -> ~91 ohm. Confirm with JLCPCB's impedance calculator before ordering.
    nc('USB3_90R', 0.24, clearance=0.13, dp_width=0.24, dp_gap=0.13, prio=0),
    nc('USB2_90R', 0.24, clearance=0.13, dp_width=0.24, dp_gap=0.13, prio=1),
    # 0.1 mm clearance (D-019): the 0.4 mm-pitch QFN escapes do not fit at 0.15 mm; HSPI runs are 2-3 cm, power is 5 V
    nc('HSPI', 0.15, clearance=0.1, prio=2),
    nc('Power', 0.3, clearance=0.1, prio=3),     # VBUS / 5 V / switch nodes: up to ~1.2 A, no fine-pitch pins
    # logic rails: Freerouting cannot neck a 0.3 mm track down into the 0.2 mm QFN pins (most of the unrouted
    # connections of the first runs were rail pins on U7/U9); 0.2 mm outer copper carries well over 0.5 A
    nc('Rail', 0.2, clearance=0.1, prio=4),
]
patterns = [
    ('USB3_90R', '/USB3_SS*'), ('USB3_90R', '/CH_SSTX_*'),
    ('USB2_90R', '/USB3_D?'), ('USB2_90R', '/USBC_D?'), ('USB2_90R', '/RP_USB_D?'),
    ('HSPI', '/HSPI_*'),
    ('Power', '/VBUS_*'), ('Power', '/5V_*'), ('Power', '/+3V3_SW'), ('Power', '/3V3_CH_SW'),
    ('Power', '/1V2_CH_SW'), ('Power', '/VREG_LX'),
    ('Rail', '/+3V3'), ('Rail', '/3V3_CH'), ('Rail', '/1V2_CH'), ('Rail', '/1V1'), ('Rail', '/GND'),
]
path = os.path.join(HW, 'rp569.kicad_pro')
# merge into the full project file KiCad writes (a minimal file gets rewritten with defaults by kicad-cli)
pro = json.load(open(path)) if os.path.exists(path) else {'meta': {'filename': 'rp569.kicad_pro', 'version': 3}}
ns = pro.setdefault('net_settings', {})
default = next((c for c in ns.get('classes', []) if c['name'] == 'Default'), {})
ns['classes'] = [{**default, **c} if c['name'] == 'Default' else {**{k: v for k, v in default.items() if k != 'name'}, **c}
                 for c in classes]
ns['netclass_patterns'] = [{'netclass': c, 'pattern': p} for c, p in patterns]
with open(path, 'w') as f:
    json.dump(pro, f, indent=2)
