kelu124/rp569/(commit log)

2026-10-23 Project scaffolding, README, logs and HydraUSB3 references
    - README: project overview, planned features, repo layout
    - CLAUDE.md: objectives (incl. RGB LEDs, breakout I2C), layout, working rules
    - .claude/: todo, done, commit log, design decisions, project-logs skill
    - project/hydrausb3: snapshots of hydrausb3 hw/fw, wch-ch56x-lib/bsp/isp
2026-10-23 Add datasheets, phantomdrive reference, logic analyser requirement
    - datasheet/: RP2350 datasheet + HW guide, CH569DS1, QingKe V3, SD spec (PDF + Markdown)
    - project/phantomdrive: CH569W USB3 + SD KiCad reference (MIT)
    - README/CLAUDE.md: 8-channel logic analyser on RP2350B
    - decisions D-003: 16-bit HSPI conflicts with eMMC/SD pins on CH569
2026-10-23 Add pin map v0.1 and CH569 hardware notes
    - docs/pinmap.md: RP2350B <-> CH569 pin assignment (8-bit HSPI, LA inputs,
    UART, I2C, RGB LEDs, breakouts), checked against the datasheet PDFs
    - docs/ch569-hardware-notes.md: power, clock, boot/reset, USB3, SD from
    CH569DS1 and the phantomdrive netlist
    - decisions D-004 (power-cycle + PA5 boot), D-005 (RGB), D-006 (CH569 power)
2026-10-23 Add power architecture: ideal-diode OR and switched CH569 supply
    - docs/power.md: VBUS_C/VBUS_3 ORed by LM66100 ideal diodes for the
    RP2350 side; CH569 fed from its USB3 VBUS via a TPS2553 load switch
    controlled by the RP2350 (EN, FAULT#, rail sense on ADC)
    - pinmap: GPIO35 EN, GPIO39 FAULT#, GPIO46/47 VBUS3/3V3_CH sense
    - decisions D-007, README/CLAUDE.md requirements
2026-10-23 KiCad v0.1: generated schematic and placed 4-layer PCB
    - hardware/gen/board.py: full netlist (144 symbols) from docs/pinmap.md
    and docs/power.md; gen_sch/gen_pcb/gen_pro generate the KiCad project,
    build.sh runs ERC + DRC with schematic parity
    - schematic: ERC 1 expected error (ideal-diode OR on 5V_SYS)
    - PCB: 100x70 mm, 4 layers, GND planes In1/In2, automatic placement,
    0 electrical DRC errors, 0 parity issues, not routed yet
    - docs/layout.md, decisions D-008 (USB3 Micro-B), D-009 (AP2171W), D-010
2026-10-23 PCB v0.2: 50x70 mm two-sided board, user buttons, CH569 boot jumper
    - Board 50x70 mm with 3 mm chamfered corners; RP2350/USB-C in the top half,
    CH569/USB3/microSD in the bottom half, all on the top side; small
    passives and the flash on the bottom (D-011).
    - 2 user buttons per chip (RP GPIO30/31, CH569 PB3/PB4) with pull-ups.
    - 2-pin jumper on the CH569 boot strap (PA5 to GND) for blank-chip flashing.
    - RGB LEDs placed next to their chip.
    - RP debug UART moved onto RP EXT; CH EXT now 2x07 (D-012).
    - Placer: fixed the '/' net prefix so parts now target their real pads.
2026-10-23 Add specification.md with requirements and design decisions
    - specification.md: requirements R-01..R-17 with status, and decisions
    D-001..D-013 (moved from .claude/decisions.md, which is removed).
    - D-004 rewritten: netlist-checked sequence for the RP2350 to force the
    CH569 USB bootloader exactly like the BOOT button (GPIO8 -> PA5 low,
    power-cycle via GPIO35).
    - D-013 opened: USB3 Micro-B with through-hole shell legs (R-16).
    - CLAUDE.md, project-logs skill, README, todo/done point to the spec.
2026-10-23 USB3 Micro-B with through-hole shell legs (Amphenol GSB343K33HR)
    - Footprint generated from the Amphenol drawing (rev C) by gen/mk_fp.py
    into hardware/lib/rp569.pretty, registered in hardware/fp-lib-table.
    - board.py uses it for the CH569 USB3 connector; shell legs on GND.
    - Spec: R-16 met, D-013 accepted. Datasheet folder indexed.
2026-10-23 JLCPCB BOM and placement files with LCSC part numbers
    - LCSC/MPN for every part (board.py LCSC_BY_VALUE), checked against the
    jlcparts snapshot of the JLCPCB catalogue (stock, basic/extended).
    - gen_bom.py writes hardware/jlcpcb/rp569-bom.csv and rp569-cpl.csv.
    - RGB LED -> LiteOn LTST-C19HE1WT (common anode, pinout checked against its
    datasheet), green/blue resistors 100R; 2.2uH -> FTC303020D2R2MBCA (stock).
    - CH569W, LM66100 x2 and GSB343K33HR are not stocked: consign (docs/bom.md).
    - Spec: R-18, D-014.
    Claude-Session: https://claude.ai/code/session_01P2mww5GvbqsTGfABEm1SLa
2026-10-24 TPS2121 power mux, v0.3 placement, pin reassignment, autorouting setups
    - TPS2121 replaces the two LM66100s (symbol and RUX0012A footprint from the datasheet, D-015)
    - v0.3 placement from pin sides, passives turned toward their nets, buttons/LEDs at the edges (D-017, D-018)
    - HSPI series resistors dropped; RP2350 and CH569 pins reassigned by chip side (D-018, docs/pinmap.md v0.2)
    - Net classes: Rail 0.2 mm, HSPI/Power 0.1 mm clearance (D-019)
    - Routing options: gen/route.py (Freerouting, patched 2.1.0 so -mp works, GND fan-out vias) and
    gen/route_krt.sh (KiCadRoutingTools chain); the board in git stays unrouted
    - Project skills kicad-board (with the 3-minute router watch rule) and jlcpcb-p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
2026-10-24 Autorouted board with KiCadRoutingTools: 21 links left
    hardware/autoroute/rp569-krt.kicad_pcb: route_krt.sh chain (GND pour, QFN fanout, USB pairs, route) plus a
    second route pass, D-019 net classes. 21 of 405 connections left, 0 electrical DRC violations against the
    project rules, 3 of 6 USB pairs coupled. Starting point for hand finishing; the generated board stays unrouted.
    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
2026-10-24 D-020 placement: corridor between the chips cleared, autorouted board at 16 links
    - TPS2121 fixed next to the USB-C VBUS pins; its dividers, ILIM and SS parts follow its PMUX pins
    - Sense dividers placed at the rail they measure (USB3 connector, 3V3_CH inductor)
    - Pull-ups placed at the pin of the chip on their rail instead of mid-way along the line
    - route_krt.sh runs the second route pass itself
    - hardware/autoroute/rp569-krt.kicad_pcb: 16 of 405 links left, 0 electrical DRC violations
    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
2026-10-24 v1.0: board fully routed (KRT autoroute + hand finishing)
    hardware/autoroute/rp569-krt.kicad_pcb: 0 unconnected, 0 DRC errors against the project rules. Last links
    routed by hand, some on In1.Cu (D-021, the GND fill stays one piece). Dangling copper removed; "rp569 v1.0"
    silkscreen. Open before ordering: USB pairs as coupled pairs, silkscreen cleanup.
    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
2026-10-24 v1.0 production files: routed board next to the schematic, JLCPCB gerbers/BOM/CPL
    - hardware/rp569-routed.kicad_pcb (+ .kicad_pro): the routed v1.0 board, moved from hardware/autoroute/
    - gen/gen_fab.py: DRC gate (0 unconnected, 0 errors), gerbers + Excellon with JLCPCB's KiCad settings,
    hardware/jlcpcb/rp569-gerbers.zip, then BOM/CPL; gen_bom.py takes the CPL from the routed board
    - v1.0 renders; specification D-022 and R-18 met; README, CLAUDE.md, docs/layout.md, docs/bom.md updated
    - Skills kicad-board and jlcpcb-parts: routed board, fab step, upload checklist
    Claude-Session: https://claude.ai/code/session_01P2mww5GvbqsTGfABEm1SLa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
2026-10-24 Session handoff: helper scripts, handoff note, Hackaday drafts
    - .claude/handoff.md: current state, next steps, tools and working agreements (linked from CLAUDE.md)
    - kicad-board skill: drc_check.py, board_metrics.py, remove_dangling.py and the hand-editing check loop
    - docs/hadposts/: two Hackaday project-log drafts (the board; the routing story) and an index
    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
2026-10-24 Board renders in docs/images
    - hardware/gen/gen_renders.py: 3D renders (top, bottom, angled views) and per-layer / assembly plots as SVG and
    PNG from the routed board
    - docs/images/: v1.0 images with an index; handoff, skill and logs updated
    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
2026-10-24 GitHub Pages documentation site from docs/
    - docs/_config.yml (Cayman theme) and docs/index.md as the home page
    - New pages: architecture.md (block diagram, links, boot control, power, clocks), production.md (JLCPCB ordering)
    - power.md updated to the v1.0 design (GPIO29/30, TLV62569 +3V3, DNP 0 Ohm warning, no HSPI series resistors)
    - README, CLAUDE.md and handoff point to the site
    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
2026-10-24 Header pin labels on the bottom silkscreen
    hardware/gen/add_header_labels.py puts mirrored B.SilkS labels beside every
    2.54 mm header pin of the routed board (group header_labels, idempotent) and
    moves/shrinks the U4 reference to make room. DRC unchanged: 0 unconnected,
    0 errors, 119 warnings. JLCPCB gerbers and docs/images renders regenerated.
    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
2026-10-24 Rounded board corners, RPDFU/BOOT button labels
    The 3 mm chamfers become 3 mm-radius arcs through the same tangent points
    (gen/round_corners.py on the routed board, gen_pcb.py for new boards). SW1
    (BOOTSEL) is labelled RPDFU and SW5 (CH569 boot) BOOT on the top silkscreen.
    DRC unchanged: 0 unconnected, 0 errors, 119 warnings. JLCPCB files and
    docs/images renders regenerated (D-023).
    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
2026-10-24 Session wrap-up: handoff state, kicad-board skill gotchas
    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
2026-10-24 README and docs show the current renders from docs/images
    The README, layout.md and Hackaday drafts embedded the old v1.0 renders in
    docs/img/ (before rounded corners and silkscreen labels). They now use the
    regenerated docs/images/rp569-v1.0-{top,bottom}.png; the stale copies are gone.
    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
2026-10-24 First firmware for the RP2350B and the CH569
    firmware/rp2350: Pico SDK 2.2 with an rp569 board header; USB serial command
    line to switch the RGB LED (set R|G|B 0|1), reboot into DFU (dfu), and drive
    the CH569 (ch on|off|cycle|boot|reset|status|send), plus adc and btn.
    firmware/ch569: fork of CH569_Composite; USB3 serial port bridged to the
    RP2350 link (UART1 PA7/PA8) with every received byte echoed back, debug log on
    UART0 PB5/PB6, SD card as a drive, status on the RGB LED.
    Both build cleanly (build.sh in each folder); not run on hardware yet. D-024,
    D-004 pin numbers updated, skill firmware, host link_test.py.
    Claude-Session: https://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
2026-10-24 Python host library, firmware versions and chip UIDs, pre-commit hooks
    python/rp569 finds each serial port by role (VID/PID, product string, USB
    interface number, serial number = chip UID) and refuses a port of the other
    chip; one @command method per firmware command (RP2350, CH569Console), plus
    CH569Link and python -m rp569 ports|versions. Unit tests with a fake firmware.
    Both firmwares compile version.yaml (major.minor.patch) and the git hash in;
    'version' prints them with the chip unique ID. RP2350 commands are one table;
    the CH569 debug port is now a console (help/version/status) and reports its
    factory UID as the USB serial number.
    .githooks/pre-commit: tools/check_commands.py refuses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
2026-11-02 Vias off passive pads, GND plane restored, JLCPCB files regenerated
    Routed board: vias moved off passive pads (42 -> 3 left), last 0.1 mm microvia
    removed, In1 GND zone put back after it vanished in 9b067cd, bottom-left plane
    pieces stitched; 0 unconnected, 0 DRC errors. Gerbers/BOM/CPL from gen_fab.py.
    New kicad-board skill scripts: via_check.py (sizes, vias in pads, plane pieces)
    and restore_gnd_zone.py. Logs, handoff and todo updated.
    Claude-Session: https://claude.ai/code/session_017e576EG84mVvYWv4vAwxtQ
2026-11-02 Last vias off passive pads, silkscreen text, fab files and renders
    Routed board: R9/C28/R48 vias moved off their pads, Y1 and CH569 pad 34
    cleared, silkscreen text added; 0 unconnected, 0 DRC errors, 115 cosmetic
    warnings. JLCPCB gerbers/BOM/CPL and docs/images renders regenerated.
    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
